alxgmpr/sierra-to-usb/full-adapter/cad/README.md

# Current capture checkpoint — not for fabrication

Open `full-adapter.kicad_pro`. The root hierarchy currently contains the DDR
signal and power pages, processor core power and ground, the CPU regulator,
the nine PMIC LDO outputs, all five PMIC bucks, both supply switches and unused audio,
processor PMU/PLL, IO and USB/combo-PHY supplies, and unused PHY terminations.
The integrated PCB and remaining functional pages
are still being implemented.

U1 is the exact RK3568B2; U2/U3 are H5TQ4G63EFR-RDC, each 4 Gb x16, giving
1 GiB on one 32-bit rank. Both processor DDR supply domains and both DRAM
supplies use 1.5 V. The initial 780 MHz clock target still requires DDR loader
configuration and physical training tests. The RD speed grade is 1866 MT/s,
not the 2133 MT/s sometimes attached to distributor listings.

`../tools/check_ddr.py` exports a fresh KiCad XML netlist and checks every DQ,
DQS, DM, shared command/address and clock connection against the reviewed
manufacturer maps. It separately checks fixed physical-ball anchors, reference
and calibration circuits, all DRAM supplies, all decoupling, and exact part
fields. All 732 processor/memory symbol pins are unique and match the reviewed
names and footprint coordinates.

The core power sheet connects 30 CPU/LOGIC/GPU/NPU supply balls, 21 bypass
capacitors, and all 208 VSS/AVSS ground balls. `../tools/check_core_power.py`
checks their fresh exported nets against fixed package anchors and the source
ground-pin list. Ball M15 is a passive remote sense tap on VDD_CPU_COM, not an
additional external power feed. TVSS at AB24 remains a temperature reference
input; the later processor-clock capture connects it to ground per the tablet reference.

U4 is RK860-0 with L300 SPM5030T-R35M. The CPU page includes four 22 uF input
capacitors, four 22 uF local output capacitors, a 51 kohm / 100 nF hardware
enable delay, a 100 kohm VSEL pull-down and the reference 100 ohm / 1 uF remote
sense network. `check_cpu_regulator.py` checks all 20 balls, native stack
expansion, switching-node isolation, feedback, defaults and exact passives.
The VDD_CPU power flag represents the verified U4 → L300 → CPU supply path;
KiCad does not propagate a power-output type through the passive inductor.

U5 is the exact RK809-5. Its three LDO groups have twelve local 1 uF bypass
capacitors and the startup voltages/sequencing from datasheet Table 4-4.
LDO6 now supplies the CPU regulator enable resistor. LDO5/6 are limited to
200 mA with less than 0.4 V headroom, as specified on datasheet pages 22–23.
`check_pmic_ldo.py` verifies all physical input/output pins and capacitor nets.

BUCK3 now supplies VCC_DDR through L420, with two local input and three local
output capacitors. Its 87.6k / 100k, 0.1% hardware divider selects 1.5008 V
before firmware runs. `check_pmic_ddr.py` verifies switching-node isolation,
the separate FB3 divider, VBUCK3 sense and resistor tolerance arithmetic.
The VCC_DDR flag represents this physical buck/inductor path.

BUCK1/2/4 now supply LOGIC/GPU/NPU. NT430–NT432 are copper net ties to be placed
at the processor supply pads, with dedicated feedback nets and local 100 ohm
resistors following the reference topology. They are excluded from the assembly
BOM. Each buck has two 22 uF input capacitors and three 22 uF plus 100 nF at
its output. The corresponding physical sense routing is still unfinished.

BUCK5 provides VCC1V8_SYS, separate from the 3.3 V inputs/output switches.
SWOUT1 provides VCC3V3_S0; SWOUT2 provides VCC3V3_SD. Their peripheral loads
and complete current/drop budgets remain outstanding. The control page now
terminates unused audio pins exactly as specified, retaining both internal
1.8 V bypass capacitors and a 3.3 V speaker-supply input bypass.

All 69 U5 pins are now present. The control unit has 1.8 V I2C pull-ups,
22 ohm series resistors, separate 3.3 V interrupt/reset pull-ups, mandatory
reset bypass, grounded unused fuel-gauge inputs, and a 32.768 kHz crystal.
The VDC divider/RC is a cold-start timing provision; reliable brownout recovery
still requires integration with the selected upstream supply's power-good/reset
behavior. The processor control page now connects reset, interrupt, sleep and
I2C0 to their physical U1 pins. It adds a 10k pull-up for the 1.8 V storage
voltage strap, the card-detect/JTAG pull-up, the reference zero-ohm TSHUT/reset
link, and a local 100 nF reset capacitor at U1. UART2 has 1.8 V RX/TX and ground
probe pads TP560–TP562, represented as board copper and excluded from assembly BOM;
its external level conversion and connector remain unfinished.

All processor power-input balls are now captured. The PMU/PLL sheet adds
twelve capacitors at seven supply balls; the IO/ADC/OTP page adds twelve at
eleven balls. PMUIO1 uses fixed 3.3 V; PMUIO2 uses 1.8 V with the existing PMIC
I2C pull-ups. VCCIO2 uses 1.8 V with a physical HIGH boot strap.
VCCIO3 uses the independently programmable SD-IO LDO, separate from SD card
3.3 V power. VCCIO1/4/5/6/7 use the switched 3.3 V system rail.

The PHY supply page adds fourteen capacitors and two Murata BLM18PG121SN1D
filters. The 0.9/1.8 V USB2 analog supplies are filtered; the shared USB3/PCIe2
combo-PHY supplies use their reference bypass network. The unused-domain page
grounds fourteen display/camera/PCIe3 supply balls and explicitly disconnects
63 signal balls. These supplies are additional intentional ground connections,
not additional VSS/AVSS pins. Their controller/PHY nodes must be disabled in DTS.

`processor-supply-budget.json` records the documented analog-domain peak sums
and 0.76425 W nominal LDO dissipation before IO loads and other PMIC losses.
This is a partial budget, not thermal closure or a basis for selecting PoE class.

The current ERC result has sixteen **unresolved integration findings**, with no
ERC exclusions: unplaced U1 units, input pins and bidirectional pins;
three undriven rails (GND, VCC5V_SYS and
VCC3V3_SYS), two modem USB2 endpoints and eight Ethernet MDI endpoints.
The upstream supplies, other processor units and MDI magnetics are not yet captured.
These are open work, not manufacturing exceptions.

The schematic PDF was rendered and visually iterated to fix rotated passive
fields, supply-reference overlap, power-label collisions and page-boundary
placement. The checked working render is `../build/processor-control-review.pdf`; it is
not a released schematic or fabrication deliverable.

## Library review

The Hynix map was checked against all 96 cells of manufacturer Rev. 1.2,
September 2016, page 6, with the overbars reviewed visually. Page 33 verifies
7.5 x 13 mm, 0.8 mm pitch and the top/bottom view orientation. The vendored
KiCad footprint's 0.36 mm lands are an engineering choice; the package drawing
does not specify a manufacturer land pattern. Source hashes are retained in
`../research/memory-pins.json`.

The official KiCad Library Tools checker at revision
`475bd27b9a521418c3732ff2ee5efea98525d2c7` reports these project-library exceptions:

- S4.5: 48 absent Hynix grid positions and 148 absent Rockchip grid positions.
  They are physically unpopulated, independently verified against manufacturer
  ball maps and footprint pads. They must not become symbol pins.
- S6.2: Manufacturer, MPN and LCSC are intentional assembly metadata on both ICs.
- The VCC_DDR and four core power symbols are renamed native KiCad 10.99 VDD symbols. The
  checker expects the older hidden/name-bearing power-pin convention and flags
  its native blank visible pin and reference convention (S4.1/S6.1/S7.1).
  KiCad's fresh exported netlist confirms the resulting global VCC_DDR net.

No actual component pin is hidden except the five NC balls on each Hynix
package. All populated balls remain explicit; alternate command functions use
KiCad alternates. Unused processor interfaces remain visible in separate units.

The former unplaced 41-pin supply unit was split into four readable units without
renumbering existing signal, core or ground units. The complete 636-ball source
map remains intact. The new ferrite footprint vendors the native 0603 body,
courtyard and STEP model, using Murata's 0.65 × 0.7 mm rectangular reflow lands
with 0.7 mm gap on 35 um outer copper. Remaining KLC F6.3/F9.3 notices are the
manufacturer's rectangular pads and the intentional project-relative model path.

## Reproduction

Run from the repository root with `full-adapter/.venv/bin/python`:

1. `full-adapter/research/extract_memory_pins.py`
2. `full-adapter/tools/build_core_symbols.py`
3. `full-adapter/tools/build_ddr_schematic.py`
4. `full-adapter/tools/check_ddr.py full-adapter full-adapter/research/ddr-validation.json`
5. `full-adapter/tools/check_core_power.py`
6. `full-adapter/tools/check_cpu_regulator.py`
7. `full-adapter/tools/check_pmic_library.py`
8. `full-adapter/tools/check_pmic_ldo.py`
9. `full-adapter/tools/check_pmic_ddr.py`
10. `full-adapter/tools/check_pmic_core.py`
11. `full-adapter/tools/check_pmic_aux.py`
12. `full-adapter/tools/check_pmic_control.py`
13. `full-adapter/tools/check_processor_pmu.py`
14. `full-adapter/tools/check_processor_io_power.py`
15. `full-adapter/tools/check_processor_phy_power.py`
16. `full-adapter/research/processor-supply-budget.py`
17. `full-adapter/tools/check_processor_control.py`

The pre-commit checks validate the staged snapshot and reject unregistered CAD.
Their DDR checkpoint success does not authorize fabrication or imply that the
full board is electrically complete or routed.

## Storage capture checkpoint

The hierarchy now has 17 child sheets plus the root. emmc-signals and
emmc-power capture all 153 U6 balls, the eight data bits, CMD/CLK/DS/reset,
12 bypass capacitors, ten 10 kΩ pull-ups and isolated service pads.
`full-adapter/.venv/bin/python full-adapter/tools/check_emmc.py` checks the
exported netlist and physical ball/pad mapping. Fresh ERC retains the six
previous integration findings; the full system remains incomplete.
The two pages and root were visually reviewed in build/emmc-review.pdf.
The root now uses an A2 four-column index, with room for additional functional
pages clear of the title block. Its SVG/PDF render was inspected in
`build/root-expansion.pdf`; existing child circuits are unchanged.

## Console capture

`console.kicad_sch` adds U7 TXU0202DCUR and J620 B4B-PH-SM4-TB(LF)(SN).
J620 is 1=GND, 2=board TX, 3=board RX, 4=adapter 3.3V input. Use a PHR-4
mating housing and a 3.3V TTL USB-UART adapter with TX/RX crossed. Pin4 supplies
only the translator's external domain; it does not supply the board. Ground
is shared, so this is power-off isolation, not galvanic isolation.

Four 10k pull-ups keep UART idle high on either side without crossing power
domains. Two 1k series resistors limit DC contention at the connector. Start
at 1.5Mbaud with a short cable and <=50pF total line loading; verify timing
with the actual adapter. `check_console.py` checks all eight translator pins,
both footprint pad maps, connector direction, pull-ups and rail separation.
Fresh ERC retains six integration findings. `build/console-review.pdf` page11
was visually reviewed after correcting field overlap and the lower box boundary.

U7 uses TI DCU0008A's .85x.3mm lands with3.1mm row spacing. The native JST
pattern matches the manufacturer's top-entry drawing. Its local STEP is a
solid nominal header envelope, not a detailed manufacturer model; reserve
mating cable clearance. KLC exceptions are intentional assembly fields and
project-relative STEP paths. Sources and point-in-time stock are recorded in
`research/console-qualification.json`. System PCB, protection review and
physical console validation remain unfinished.

Recovery USB capture is on `recovery-usb` and `recovery-detect`.
It includes a dedicated USB-C service port, power-off-specified data switch,
USB data ESD and a separate VBUS translator. Recovery electrical qualification
and the full PCB remain unfinished.

Physical RECOVERY, RESET and POWER buttons are captured on `buttons`;
manufacturer switch lands, nominal3D geometry and connectivity were reviewed.

## Ethernet controller capture

The current hierarchy has29pages including root. `ethernet-3v3-power` and
`ethernet-core-power` contain U12/U13 TPS6281320QWRWYRQ1 forced-PWM regulators.
`ethernet-local-power`, `ethernet-clock-config` and `ethernet-pcie` capture every
U11 RTL8125BG-CG pin and six U1 PCIe2 data/reference-clock balls. The original
IC symbols are unchanged; VCC3V3_ETH_PLL is an added power symbol.

Fifteen local capacitors bypass the named U11 pins. FB670 supplies only pin15;
pin43 is on 3.3V and pins40/49 are grounded. Y670 is X322525MOB4SI C9006 with
20pF C0G loads and an initial zero-ohm CKXTAL2 damping resistor. GPI, LED1,
LANWAKE and CLKREQ have explicit Ethernet-domain pull-ups. There is no external
EEPROM/flash; EEDI/EESEL select 3-wire 93C46 and EEDO is held low. Provision a
stable unique local MAC before network-UP; see the qualification file for
silicon-default and boot-image verification that remains necessary.

The PCIe lane has one 100nF capacitor per transmit leg, with physical endpoints
checked independently. PERST now has a TPS3808G33 release circuit and host
control isolation; fast-fault timing remains unfinished. Eight MDI labels are explicit open endpoints
for the qualified 2.5G/PoE magnetics; they are not ERC waivers.

`check_ethernet_controller.py` runs in both staged checkpoint hooks alongside
the library and regulator checks. It checks nets, exact new parts, crystal and
bead lands, and capacitor derating estimates. The reviewed 27-page working PDF
is `../build/ethernet-controller-review.pdf` (new pages8/15/27, root1). The crystal
and bead copper/model review uses `../build/ethernet-passives-*`; these small
inspection boards are not the integrated PCB. Footprint KLC exceptions are
the manufacturer's rectangular bead lands and intentional local/shared/scaled
generic models, documented in `../research/ethernet-controller-qualification.json`.

`ethernet-control` and `ethernet-reset` add U1VCCIO5/M1, U14FXMA2102 bidirectional
control isolation, U15TI open-drain host-reset buffering and U16TPS3808G33
startup qualification. Both regulator PG outputs share the host reset-condition
bus. R703100k selects180–420ms delay, R70410k pulls PERST up while R67947k remains
to ground. See `../research/ethernet-control-qualification.json` for actual bounds
and open fast-fault, clock/ASPM, partial-power and boot-image checks.

`check_ethernet_control.py` runs in the staged hooks. It checks19IC pins, three M1
balls, all control nets, independent supply membership and manufacturer lands.
The29-page `../build/ethernet-control-review.pdf` supersedes the previous review;
new pages22/29 and modified PG/control endpoint pages were visually inspected.
The small ignored footprint inspection board has no system circuitry or routing.
