alxgmpr/sierra-to-usb/hardware/review/2026-10-07/footprint-audit/schematic-to-pcb.txt

Info: Processing symbol 'C2021:Capacitor_SMD:C_0603_1608Metric_Pad1.08x0.95mm_HandSolder'.
Info: Processing symbol 'C202:Capacitor_SMD:C_0603_1608Metric_Pad1.08x0.95mm_HandSolder'.
Info: Processing symbol 'C203:Capacitor_SMD:C_1206_3216Metric_Pad1.33x1.80mm_HandSolder'.
Info: Processing symbol 'C204:Capacitor_SMD:C_0603_1608Metric_Pad1.08x0.95mm_HandSolder'.
Info: Processing symbol 'C205:Capacitor_SMD:C_0603_1608Metric_Pad1.08x0.95mm_HandSolder'.
Info: Processing symbol 'C401:Capacitor_SMD:C_1206_3216Metric_Pad1.33x1.80mm_HandSolder'.
Info: Processing symbol 'C402:Capacitor_SMD:C_1210_3225Metric_Pad1.33x2.70mm_HandSolder'.
Info: Processing symbol 'C403:Capacitor_SMD:C_1210_3225Metric_Pad1.33x2.70mm_HandSolder'.
Info: Processing symbol 'C501:Capacitor_SMD:C_1210_3225Metric_Pad1.33x2.70mm_HandSolder'.
Info: Processing symbol 'C502:Capacitor_SMD:C_1210_3225Metric_Pad1.33x2.70mm_HandSolder'.
Info: Processing symbol 'C503:Capacitor_SMD:C_1210_3225Metric_Pad1.33x2.70mm_HandSolder'.
Info: Processing symbol 'C504:Capacitor_SMD:C_1210_3225Metric_Pad1.33x2.70mm_HandSolder'.
Info: Processing symbol 'C505:Capacitor_SMD:C_1210_3225Metric_Pad1.33x2.70mm_HandSolder'.
Info: Processing symbol 'C506:Capacitor_SMD:C_1210_3225Metric_Pad1.33x2.70mm_HandSolder'.
Info: Processing symbol 'C507:Capacitor_SMD:C_1210_3225Metric_Pad1.33x2.70mm_HandSolder'.
Info: Processing symbol 'C508:Capacitor_SMD:C_1210_3225Metric_Pad1.33x2.70mm_HandSolder'.
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
Info: Processing symbol 'D1716:LED_SMD:LED_0603_1608Metric_Pad1.05x0.95mm_HandSolder'.
Info: Processing symbol 'D1717:Diode_SMD:D_SOD-123'.
Info: Processing symbol 'D1718:Appliance:Diodes_PowerDI-5_3Pin_Derived'.
Info: Processing symbol 'D1719:Diode_SMD:D_SOD-123'.
Info: Processing symbol 'D1721:Package_TO_SOT_SMD:SOT-23_Handsoldering'.
Info: Processing symbol 'D1851:Package_SON:USON-10_2.5x1.0mm_P0.5mm'.
Info: Processing symbol 'D1852:Package_SON:USON-10_2.5x1.0mm_P0.5mm'.
Info: Processing symbol 'D2001:Package_SON:USON-10_2.5x1.0mm_P0.5mm'.
Info: Processing symbol 'FB801:Inductor_SMD:L_0603_1608Metric_Pad1.05x0.95mm_HandSolder'.
Info: Processing symbol 'FB802:Inductor_SMD:L_0603_1608Metric_Pad1.05x0.95mm_HandSolder'.
Info: Processing symbol 'FB1301:Inductor_SMD:L_0603_1608Metric_Pad1.05x0.95mm_HandSolder'.
Info: Processing symbol 'FB1302:Inductor_SMD:L_0603_1608Metric_Pad1.05x0.95mm_HandSolder'.
Info: Processing symbol 'FB1303:Inductor_SMD:L_0805_2012Metric_Pad1.05x1.20mm_HandSolder'.
Info: Processing symbol 'FB1304:Inductor_SMD:L_0805_2012Metric_Pad1.05x1.20mm_HandSolder'.
Info: Processing symbol 'FB1401:Inductor_SMD:L_0603_1608Metric_Pad1.05x0.95mm_HandSolder'.
Info: Processing symbol 'FB1402:Inductor_SMD:L_0603_1608Metric_Pad1.05x0.95mm_HandSolder'.
Info: Processing symbol 'FB1403:Inductor_SMD:L_0603_1608Metric_Pad1.05x0.95mm_HandSolder'.
Info: Processing symbol 'FB1404:Inductor_SMD:L_0603_1608Metric_Pad1.05x0.95mm_HandSolder'.
Info: Processing symbol 'J101:Recovery:Wuerth_61300211121_1x02_P2.54mm_Vertical'.
Info: Processing symbol 'J102:Recovery:Wuerth_61301011121_1x10_P2.54mm_Vertical'.
Info: Processing symbol 'J201:Recovery:Wuerth_61300611121_1x06_P2.54mm_Vertical'.
Info: Processing symbol 'J202:Recovery:Wuerth_61300211121_1x02_P2.54mm_Vertical'.
Info: Processing symbol 'J1201:Connector_USB:USB_Micro-B_Amphenol_10103594-0001LF_Horizontal'.
Info: Processing symbol 'J1202:Connector_PinHeader_2.54mm:PinHeader_1x03_P2.54mm_Vertical'.
Info: Processing symbol 'J1701:Appliance:Sierra_RJE491881401_1x08-1MP_P1.02mm'.
Info: Processing symbol 'J1711:PoE:TI_TERM_BLK_ED555-2DS'.
Info: Processing symbol 'J1712:PoE:TI_Molex_87898-0204'.
Info: Processing symbol 'J2001:Appliance:Sierra_MDT420B01411_2x38-1MP_P0.5mm'.
Info: Processing symbol 'J2002:Appliance:SIM-SMD_1042240820'.
Info: Processing symbol 'L401:Inductor_SMD:L_Coilcraft_LPS4018'.
Info: Processing symbol 'L501:Inductor_SMD:L_Coilcraft_XxL4020'.
Info: Processing symbol 'L502:Inductor_SMD:L_Coilcraft_XxL4020'.
Info: Processing symbol 'L504:Inductor_SMD:L_Coilcraft_XxL4020'.
Info: Processing symbol 'L505:Inductor_SMD:L_Coilcraft_XxL4020'.
Info: Processing symbol 'L601:Inductor_SMD:L_Coilcraft_XxL4030'.
Info: Processing symbol 'L701:Inductor_SMD:L_Coilcraft_XAL7070-XXX'.
Info: Processing symbol 'L901:Inductor_SMD:L_Coilcraft_XxL4020'.
Info: Processing symbol 'L902:Inductor_SMD:L_Coilcraft_XxL4020'.
Info: Processing symbol 'L1001:Inductor_SMD:L_Coilcraft_XxL4020'.
Info: Processing symbol 'L1501:Inductor_SMD:L_Coilcraft_XxL4020'.
Info: Processing symbol 'L1701:Inductor_SMD:L_0603_1608Metric_Pad1.05x0.95mm_HandSolder'.
Info: Processing symbol 'L1702:PoE:TI_WE-SL5'.
Info: Processing symbol 'L1703:Inductor_SMD:L_0603_1608Metric_Pad1.05x0.95mm_HandSolder'.
Info: Processing symbol 'L1707:Inductor_SMD:L_Coilcraft_XxL4020'.
Info: Processing symbol 'L1708:Inductor_SMD:L_Coilcraft_XAL5030-XXX'.
Info: Processing symbol 'L1901:Inductor_SMD:L_Coilcraft_XAL7070-XXX'.
Info: Processing symbol 'Q301:Package_TO_SOT_SMD:SOT-23_Handsoldering'.
Info: Processing symbol 'Q302:Package_TO_SOT_SMD:SOT-23_Handsoldering'.
Info: Processing symbol 'Q303:Package_TO_SOT_SMD:SOT-23_Handsoldering'.
Info: Processing symbol 'Q501:Package_TO_SOT_SMD:SOT-23_Handsoldering'.
Info: Processing symbol 'Q801:Package_TO_SOT_SMD:SOT-23_Handsoldering'.
Info: Processing symbol 'Q802:Package_TO_SOT_SMD:SOT-23_Handsoldering'.
Info: Processing symbol 'Q1201:Package_TO_SOT_SMD:SOT-23_Handsoldering'.
Info: Processing symbol 'Q1601:Package_TO_SOT_SMD:SOT-23_Handsoldering'.
Info: Processing symbol 'Q1701:Package_TO_SOT_SMD:SuperSOT-3'.
Info: Processing symbol 'Q1702:Package_TO_SOT_SMD:SuperSOT-3'.
Info: Processing symbol 'Q1703:Package_TO_SOT_SMD:SuperSOT-3'.
Info: Processing symbol 'Q1704:Package_TO_SOT_SMD:SuperSOT-3'.
Info: Processing symbol 'Q1705:PoE:TI_TRANS_Fairchild_PQFN08A'.
Info: Processing symbol 'Q1707:Package_TO_SOT_SMD:SOT-23_Handsoldering'.
Info: Processing symbol 'Q1901:Package_TO_SOT_SMD:SOT-23_Handsoldering'.
Info: Processing symbol 'Q2001:Package_TO_SOT_SMD:SOT-23_Handsoldering'.
Info: Processing symbol 'R201:Resistor_SMD:R_0603_1608Metric_Pad0.98x0.95mm_HandSolder'.
Info: Processing symbol 'R202:Resistor_SMD:R_0603_1608Metric_Pad0.98x0.95mm_HandSolder'.
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
Info: Processing symbol 'R2024:Resistor_SMD:R_0603_1608Metric_Pad0.98x0.95mm_HandSolder'.
Info: Processing symbol 'SW201:Button_Switch_SMD:SW_SPST_TL3342'.
Info: Processing symbol 'SW801:Button_Switch_SMD:SW_SPST_TL3342'.
Info: Processing symbol 'SW802:Button_Switch_SMD:SW_SPST_TL3342'.
Info: Processing symbol 'T1701:Appliance:Sierra_HX4110NL_2x12_P1.27mm'.
Info: Processing symbol 'T1702:PoE:TI_Wurth_EFD25_4476'.
Info: Processing symbol 'TP1101:TestPoint:TestPoint_Pad_D1.0mm'.
Info: Processing symbol 'TP1102:TestPoint:TestPoint_Pad_D1.0mm'.
Info: Processing symbol 'TP1103:TestPoint:TestPoint_Pad_D1.0mm'.
Info: Processing symbol 'TP1719:PoE:TI_Keystone_5019'.
Info: Processing symbol 'TP1720:PoE:TI_Keystone_5019'.
Info: Processing symbol 'TP1721:PoE:TI_Keystone_5019'.
Info: Processing symbol 'TP1722:PoE:TI_Keystone_5019'.
Info: Processing symbol 'TP1723:PoE:TI_Keystone_5019'.
Info: Processing symbol 'TP1724:PoE:TI_Keystone_5019'.
Info: Processing symbol 'TP1725:PoE:TI_Keystone_5019'.
Info: Processing symbol 'TP1726:PoE:TI_Keystone_5019'.
Info: Processing symbol 'TP1727:PoE:TI_Keystone_5019'.
Info: Processing symbol 'U201:Package_QFP:LQFP-48_7x7mm_P0.5mm'.
Info: Processing symbol 'U202:Package_TO_SOT_SMD:SOT-23-5_HandSoldering'.
Info: Processing symbol 'U401:Package_SON:WSON-10-1EP_2x3mm_P0.5mm_EP0.84x2.4mm_ThermalVias'.
Info: Processing symbol 'U501:Package_DFN_QFN:ArtInChip_QFN-68-1EP_7x7mm_P0.35mm_EP5.49x5.49mm_ThermalVias'.
Info: Processing symbol 'U601:Package_TO_SOT_SMD:TSOT-23-8_HandSoldering'.
Info: Processing symbol 'U602:Package_TO_SOT_SMD:SOT-23-5_HandSoldering'.
Info: Processing symbol 'U701:Appliance:Texas_RPA0010A_TPS56837'.
Info: Processing symbol 'U801:Appliance:Sierra_RK3566_BGA565'.
Info: Processing symbol 'U901:Appliance:Sierra_Micron_ZW_TFBGA200'.
Info: Processing symbol 'U902:Package_TO_SOT_SMD:SOT-23-5_HandSoldering'.
Info: Processing symbol 'U1001:Appliance:WLCSP-20_L2.0-W1.6-R5-C4-P0.40-TL'.
Info: Processing symbol 'U1101:Package_BGA:LFBGA-153_11.5x13mm_Layout14x14_P0.5mm'.
Info: Processing symbol 'U1201:Package_TO_SOT_SMD:SOT-353_SC-70-5'.
Info: Processing symbol 'U1202:Package_TO_SOT_SMD:SOT-353_SC-70-5'.
Info: Processing symbol 'U1203:Package_TO_SOT_SMD:SOT-353_SC-70-5'.
Info: Processing symbol 'U1301:Appliance:TQFN-48_L6.0-W6.0-P0.40-BL-EP4.5'.
Info: Processing symbol 'U1302:Package_SO:SOIC-8_3.9x4.9mm_P1.27mm'.
Info: Processing symbol 'U1501:Package_TO_SOT_SMD:SOT-353_SC-70-5'.
Info: Processing symbol 'U1502:Package_SON:Texas_DSG0008A_WSON-8-1EP_2x2mm_P0.5mm_EP0.9x1.6mm'.
Info: Processing symbol 'U1503:Package_TO_SOT_SMD:SOT-23-5_HandSoldering'.
Info: Processing symbol 'U1504:Package_TO_SOT_SMD:SOT-23-6_Handsoldering'.
Info: Processing symbol 'U1505:Package_TO_SOT_SMD:SOT-23-6_Handsoldering'.
Info: Processing symbol 'U1601:Package_TO_SOT_SMD:SOT-353_SC-70-5'.
Info: Processing symbol 'U1602:Package_TO_SOT_SMD:SOT-353_SC-70-5'.
Info: Processing symbol 'U1603:Package_TO_SOT_SMD:SOT-353_SC-70-5'.
Info: Processing symbol 'U1604:Package_DFN_QFN:DHVQFN-20-1EP_2.5x4.5mm_P0.5mm_EP1x3mm'.
Info: Processing symbol 'U1701:Package_DFN_QFN:Texas_RGW0020A_VQFN-20-1EP_5x5mm_P0.65mm_EP3.15x3.15mm'.
Info: Processing symbol 'U1702:Package_SON:WSON-12-1EP_3x2mm_P0.5mm_EP1x2.65'.
Info: Processing symbol 'U1703:PoE:TI_N04C'.
Info: Processing symbol 'U1704:Package_TO_SOT_SMD:SOT-23_Handsoldering'.
Info: Processing symbol 'U1801:Appliance:SOP-4_L4.4-W2.8-P1.27-LS7.0-BR'.
Info: Processing symbol 'U1802:Appliance:SOP-4_L4.4-W2.8-P1.27-LS7.0-BR'.
Info: Processing symbol 'U1803:Appliance:SOP-4_L4.4-W2.8-P1.27-LS7.0-BR'.
Info: Processing symbol 'U1901:Appliance:VQFN-14_L3.5-W3.5-P0.50-TL-EP_TPS54622RHLT'.
Info: Processing symbol 'U1902:Appliance:VQFN-10_L2.0-W2.0-P0.45-TL'.
Info: Processing symbol 'U1903:Package_TO_SOT_SMD:SOT-23-6_Handsoldering'.
Info: Processing symbol 'U1904:Package_TO_SOT_SMD:SOT-353_SC-70-5'.
Info: Processing symbol 'U2001:Package_DFN_QFN:DHVQFN-20-1EP_2.5x4.5mm_P0.5mm_EP1x3mm'.
Info: Processing symbol 'U2002:Appliance:UQFN-10_L2.0-W1.5-P0.50-BL'.
Info: Processing symbol 'U2003:Package_TO_SOT_SMD:SOT-353_SC-70-5'.
Info: Processing symbol 'Y1101:Oscillator:Oscillator_SMD_SiT_PQFN-4Pin_3.2x2.5mm'.
Info: Processing symbol 'Y1301:Crystal:Crystal_SMD_TXC_7M-4Pin_3.2x2.5mm_HandSoldering'.

Info: Total warnings: 0, errors: 0.
