alxgmpr/sierra-to-usb/docs/erc-waivers.md

> Historical evidence from superseded designs. See the [current full adapter](../full-adapter/README.md). Circuit status and artifact paths below refer to the historical checkpoint, not the replacement.

# ERC Waivers

Tracks intentionally-accepted ERC warnings (with justification), sheet by sheet,
as the hierarchy is populated. Task 3 baseline was 0 errors / 0 warnings on an
empty scaffold. Task 4 (power_input, after the EVM-093 transcription fix pass)
is the first sheet with real content; `$KCLI sch erc sierra-to-usb.kicad_sch`
now reports **0 errors / 259 warnings**, all four categories below, all on this
sheet.

Task 5 (power_rails: buck + LDOs + INA226 telemetry + ADC dividers) adds 87
more warnings, all in the same three pre-existing categories (no new
category) — `$KCLI sch erc sierra-to-usb.kicad_sch` now reports
**0 errors / 346 warnings**. Two ERC *errors* surfaced during development and
were fixed by design changes (not waived): `pin_to_pin` "Power output and
Power output are connected" (a redundant `PWR_FLAG` was placed on `+1V8` and
`+3V3_MCU`, both of which already have a legitimate driver — U5/U17's `VOUT`
pins are `power_out` type on the stock AP2112K base symbol; removed the
redundant flags) and `power_pin_not_driven` on `U17.VIN` (the diode-OR node
`N_OR17` had no driver at all — added a `PWR_FLAG` there, the same fix
pattern as the pre-existing `+12V_BUCK`/`+3V3`/`+3V3_MOD` flags). A third,
`pin_not_driven` on `U13.SCL` (I2C bus not yet mastered by anything, since
the mcu sheet is a future task), was resolved the same way: a `PWR_FLAG` on
`I2C_SCL` satisfies ERC's "Input pin not driven by any Output pins" check
(a `PWR_FLAG` pin is `power_out` type, which the check accepts as a driver
for a plain signal net, not only for power nets) without fabricating a
phantom I2C master.

| Date | Warning | Justification |
| ---- | --- | --- |
| 2026-07-14 | `isolated_pin_label` ×5 — global labels `POE_VA+`, `POE_VA-`, `POE_VB+`, `POE_VB-` (BR1/BR2 AC inputs) and `+3V3` (R4 pull-up) each connect to only one pin | The four PoE center-tap labels are this sheet's *export* of the PoE pairs — the matching consumer (J4 magjack on `sheets/ethernet.kicad_sch`) is wired in Task 10; until then a single-pin global label is correct. `+3V3` is referenced here only as CH224K PG's pull-up rail; it is *deliberately* a plain global label (not a power symbol, no PWR_FLAG) because the rail is produced on the power_rails sheet (later task) and the Task-4 review (MINOR 9) forbids this sheet asserting it driven. Both warnings clear when the producing/consuming sheets land. |
| 2026-07-14 | `footprint_link_issues` ×95 — every placed symbol's `Footprint` field points at a library not yet present in `fp-lib-table` | Footprint/library binding is explicitly a Task 14 activity per the plan. The `Footprint` string on each symbol records the *intended* package (per EVM-093 BOM / datasheets) so Task 14 has the real target; only the fp-lib-table registration is deferred. Count rose from 50 to 95 with the EVM-093 fix pass (sync-rect stage, snubbers, full compensation network, input filter added). |
| 2026-07-14 | `lib_symbol_mismatch` ×1 — `TCMT1107` cached copy in this sheet's `lib_symbols` differs from the stock `Isolator` library on disk | The stock symbol uses KiCad's `extends` inheritance (`TCMT1107`→`TCMT1100`); the generator flattens it into a standalone cache entry so the schematic is self-contained. Electrically identical (same pin numbers/positions/types), differs only structurally — cosmetic. (The Task-4 `SMAJ13A`/`SMAJ58A` flattening waivers are gone: the fix pass replaced them with project-library unidirectional TVS symbols with explicit pin-1-cathode polarity, per review MINOR 8.) |
| 2026-07-14 | `endpoint_off_grid` ×158 — pin/label/power-symbol endpoints not on KiCad's default edit grid | This sheet is script-authored: every label/power-symbol anchor sits at the *exact* absolute coordinate of the pin it connects to, rather than snapped to the editor's visual grid. Electrically correct (verified via `check_nets.py` and a full generator-intent-vs-exported-netlist diff of all 317 pin assignments) but cosmetically off-grid; a GUI re-snap pass would silence this without changing connectivity and is not required for the ERC error gate. |
| 2026-07-14 | (Task 5, power_rails) `endpoint_off_grid` ×59 | Same cause as the power_input row above — this sheet uses the identical script-authored, label-at-exact-pin-coordinate generator idiom (see task-5-report.md). |
| 2026-07-14 | (Task 5, power_rails) `footprint_link_issues` ×26 — every placed symbol's `Footprint` field points at a library not yet present in `fp-lib-table` | Same as the power_input row above: footprint/library binding is Task 14. `Footprint` strings record the intended package per `docs/sourcing.md` (MSOP-10 for INA226AIDGSR, TSOT-23-6 for TPS565201DDCR, SOT-23-5 for both AP2112K LDOs) so Task 14 has the real target. |
| 2026-07-14 | (Task 5, power_rails) `lib_symbol_mismatch` ×2 — `AP2112K-1.8` and `AP2112K-3.3` cached copies differ from the stock `Regulator_Linear` library on disk | Same cause and same resolution as the Task-4 `TCMT1107` row above: both stock symbols use KiCad's `extends` inheritance (`AP2112K-1.8`/`AP2112K-3.3` → `AP2204K-1.5`); the generator flattens each into a standalone cache entry (own Reference/Value/Footprint/Datasheet/Description properties, but the base symbol's graphics and pins) so the schematic is self-contained. Electrically identical (same pin numbers/positions/types — VIN(1)/GND(2)/EN(3)/NC(4)/VOUT(5)), differs only structurally — cosmetic. |

Task 6 (m2: M.2 socket, vendor-safe VCC policy, strap plane) adds 118 more
warnings, all in the same four pre-existing categories (no new category) —
`$KCLI sch erc sierra-to-usb.kicad_sch` now reports **0 errors / 464
warnings**. Breakdown: `endpoint_off_grid` 217→299 (+82), `footprint_link_issues`
121→139 (+18), `isolated_pin_label` 5→23 (+18), `lib_symbol_mismatch` 3→3
(+0 — the flattened `2N7002` did not trigger a new mismatch, unlike Task 5's
`AP2112K` flattening, because kicad-cli's own `extends`-resolution of the
stock `2N7002` happens to produce the identical structure my flattener does).

Seven ERC *errors* surfaced during development and were fixed by design
changes (not waived): `pin_not_driven` on 7 CN1 pins whose stock-symbol pin
*type* is literally "input" (`PCIE_MTX_N/P`, `SS_MOD_RX_N/P`,
`UIM1_RST/CLK/VDD`) with no other schematic component providing an
Output-type pin on those nets — the real driver for all of these is the
pluggable module itself (invisible to ERC's connectivity model, since a
connector symbol has no "the module drives this" pin). Fixed the same way as
Task 5's `I2C_SCL` forward-reference: a `PWR_FLAG` colocated with a matching
`global_label`. **Root cause of an intermediate false "still broken" state,
recorded for future reference:** the fix did not work the first time it was
applied — ERC kept reporting both `pin_not_driven` *and* a new
`label_dangling` on the same 7 nets — because the generator embedded
`power:GND` in this sheet's own `lib_symbols` cache but forgot to do the same
for `power:PWR_FLAG`, silently falling back to the *system* library table's
copy for pin geometry. That fallback copy apparently isn't recognized as
"touching" a coincident label by kicad-cli's ERC the way an embedded-cache
copy is (empirically confirmed: adding the missing cache entry, with no other
change, took both error types to zero). Every symbol used on a sheet needs
its own `lib_symbols` cache entry, not just the ones whose *pins* the
generator programmatically decorates — this project's established idiom
(Tasks 4/5) already did this correctly for `power:GND`; Task 6 initially
missed it for `power:PWR_FLAG` specifically.

| Date | Warning | Justification |
| ---- | --- | --- |
| 2026-07-14 | (Task 6, m2) `isolated_pin_label` ×11 — global labels `PCIE_MRX_P/N`, `UIM1_DET`, `UIM1_IO`, `PCIE_REFCLK_P/N`, `UIM2_DET/IO/CLK/RST/VDD` each connect to only one pin on this sheet | **Row edited by Task 8 per its own housekeeping instruction** (was ×15 as edited by Task 7, listed `USB2_MOD_DP/DM` too — both now removed from this row, count reduced 15→13, since Task 8's `sheets/usb2_debug.kicad_sch` supplies the second touch point: `U8`'s common `D+`/`D-` pins (bidirectional, TS3USB221 pins 8/7) land on `USB2_MOD_DP`/`USB2_MOD_DM`, the same nets `CN1.7`/`CN1.9` already produce here). `WWAN_LED_N`/`LED_RET` were also still listed in this row's text despite being resolved by the Task 6 review fix pass (that section documented the resolution but, per the "no existing text silently rewritten" convention, left this row's enumeration stale at the time) — dropped now too, count 15→13→11 net of both corrections. Remaining 11 are still-open documented forward references: the matching consumer/producer lands on a future sheet (mcu/Task 9, ethernet/Task 10, sim/Task 11) per the plan's own sheet-dependency order. Clears once each producing/consuming sheet lands, same pattern as Task 4/5/7's forward-reference waivers. |
| 2026-07-14 | (Task 6, m2) `footprint_link_issues` ×18 — `CN1` (`Connector_M.2`), `JP1-3` (`Jumper`), `TP1-9` (`TestPoint`), `D19` (`LED_SMD`), bulk caps (`CP_Elec_6.3x7.7`) point at libraries not yet in `fp-lib-table` | Same as the Task 4/5 rows above: footprint/library binding is Task 14. `Footprint` strings record the intended package (`Connector_M.2:M.2_Key-B-SMD` for CN1 per the LOTES APCI0105-P001A datasheet, `docs/sourcing.md` row 20) so Task 14 has the real target. |
| 2026-07-14 | (Task 6, m2) `endpoint_off_grid` ×82 | Same cause as the Task 4/5 rows above — this sheet uses the identical script-authored, label-at-exact-pin-coordinate generator idiom. |

## Task 6 review Fix pass (2026-07-14)

Fixing the 5 findings from the Task 6 (m2) review (VBUS_SENSE P-FET force-path
rebuild, R59/R60 1% tolerance, WWAN LED rewired through the module's status
pin, C44-C57 footprint prefixes, task-6-report.md refdes table correction)
changes `$KCLI sch erc sierra-to-usb.kicad_sch` from **0 errors / 464
warnings** to **0 errors / 452 warnings** (`endpoint_off_grid` 299→302,
`footprint_link_issues` 139→125, `isolated_pin_label` 23→22,
`lib_symbol_mismatch` 3→3 — no new category). Net delta: 16 warnings resolved,
4 new, both fully accounted for below.

**Resolved (16):**
- `footprint_link_issues` ×14 — C44-C57's `Footprint` fields were bare
  names with no library prefix (`CP_Elec_6.3x7.7`, `C_0805_2012Metric`,
  `C_0402_1005Metric` — not even a valid `Library:Footprint` lib_id, unlike
  the rest of this sheet's parts). Fix 4 added the `Capacitor_SMD:` prefix
  to all 14, verified against the real `.kicad_mod` files in KiCad 10's
  stock `Capacitor_SMD.pretty`. `Capacitor_SMD` is a standard footprint
  library already present in this machine's global `fp-lib-table` (unlike
  `Connector_M.2`/`Jumper`/`TestPoint`/`LED_SMD`, which is why CN1/JP1-3/
  TP1-9/D19 still show `footprint_link_issues` below — same as the
  pre-existing Task 6 row, that part is genuinely Task 14 work), so this
  resolves cleanly rather than needing a waiver.
- `isolated_pin_label` ×2 — `WWAN_LED_N` and `LED_RET`. Fix 3 gives
  `WWAN_LED_N` a second same-sheet touch point (D19's cathode, alongside
  the pre-existing CN1.10), so it's no longer isolated on this sheet.
  `LED_RET` is deleted outright (D19's cathode no longer references it) —
  removed, not a forward reference anymore, so the old Task 6 waiver row's
  mention of `LED_RET` is superseded by this section for that one label
  (the row itself is left unedited per the "no existing assertion/waiver
  text is silently rewritten" convention — this section is the correction).

**New (4) — same categories/root causes as the existing Task 6 waiver rows
above, not a new waiver category:**
- `endpoint_off_grid` ×3 — `#PWR91` (new GND on Q5's source), `Q32` pin 1
  (gate), `R68` pin 1. Same cause as the existing Task 6 `endpoint_off_grid`
  row: this sheet places labels/power symbols at the exact absolute pin
  coordinate of the component they connect to rather than snapping to the
  editor grid. Verified electrically correct via `uv run
  tools/check_nets.py` (all Fix 1 pin-function assertions pass) and the
  `kicad-cli sch export netlist` pin-to-net dump.
- `isolated_pin_label` ×1 — global label `LED_PWR` (R67's new supply-side
  pin) connects to only one pin on this sheet. This is a deliberate,
  documented forward reference: Task 9 (mcu) drives `LED_PWR` from `+3V3`
  through the WWAN kill switch, per Fix 3. Same pattern as the pre-existing
  Task 6 forward-reference waivers (`WWAN_LED_N` originally, `VBUS_DATA`,
  etc.) — clears once Task 9 lands.

No new `footprint_link_issues` or `lib_symbol_mismatch` from the new parts:
`Q32` (`sierra-to-usb:DMG3415U`, footprint `Package_TO_SOT_SMD:SOT-23`) and
`R68` (`Device:R_Small`, footprint `Resistor_SMD:R_0603_1608Metric`) both
reuse footprint libraries already used elsewhere on this sheet (Q1-Q5,
R59-R67) that resolve via the global `fp-lib-table` without a project-local
entry. The new `sierra-to-usb:DMG3415U` project-library symbol's cached copy
in `sheets/m2.kicad_sch`'s `lib_symbols` was built to be structurally
identical to the `lib/sierra-to-usb.kicad_sym` master (same property
node shapes, no stray `pin_names` override) specifically to avoid adding a
5th `lib_symbol_mismatch` entry — confirmed 3→3, unchanged.

| Date | Warning | Justification |
| ---- | --- | --- |
| 2026-07-14 | (Fix pass) `endpoint_off_grid` ×3 — `#PWR91` Pin 1, `Q32` Pin 1 `[G]`, `R68` Pin 1 | Same script-authored, label/symbol-at-exact-pin-coordinate idiom as every other `endpoint_off_grid` row on this sheet. Connectivity verified via `check_nets.py` and a `kicad-cli sch export netlist` pin dump, not just ERC. |
| 2026-07-14 | (Fix pass) `isolated_pin_label` ×1 — global label `LED_PWR` (R67 pin 2) connects to only one pin on this sheet | Documented forward reference: Task 9 (mcu) drives `LED_PWR` from `+3V3` through the WWAN kill switch (Fix 3). Same pattern as this sheet's other Task 6 forward-reference waivers; clears when Task 9 lands. |

## Task 7 (usb3_data: J1 + HD3SS3220 mux + AC caps + ESD)

`$KCLI sch erc sierra-to-usb.kicad_sch` goes from Task-6-fix-pass's **0
errors / 452 warnings** to **0 errors / 490 warnings** (+38). Breakdown:
`endpoint_off_grid` 302→337 (+35), `footprint_link_issues` 125→127 (+2),
`isolated_pin_label` 22→19 (−3, see the edited Task 6 row above),
`lib_symbol_mismatch` 3→5 (+2), and one **new category**: `pin_to_pin` (+2).
Two ERC *errors* surfaced during development and were fixed by design (not
waived) — see below.

**Errors found and fixed (not waived):**
1. `label_dangling` ×2 on `U1` (HD3SS3220 mux) pins `VDD5`/`EN` (net
   `VBUS_DATA`) and `VOUT` (net `+3V3_MUX`) — root cause: the sheet's
   `lib_symbols` cache embedded `Regulator_Linear:AP2112K-3.3` via a plain
   rename of the stock symbol text, but the stock `AP2112K-3.3` symbol is
   itself `(extends "AP2204K-1.5")` — renaming without flattening left an
   empty shell with no pins in the cache, so kicad-cli silently fell back to
   resolving the base symbol elsewhere, and that fallback pin geometry
   didn't register as "touching" the coincident global label/local label —
   the **exact same failure mode** already root-caused in the Task 6 section
   above for `power:PWR_FLAG` (there: a missing cache entry causing a
   system-library fallback; here: an unflattened `extends` cache entry
   causing the same kind of fallback). Fixed by flattening `AP2112K-3.3`
   the same way Task 5 already documented doing for `AP2112K-1.8`/`-3.3` on
   `power_rails.kicad_sch` (merge the `AP2204K-1.5` base's graphics/pin
   sub-units, renamed, with `AP2112K-3.3`'s own top-level properties) —
   confirmed by re-running ERC (both errors cleared, no other change).
2. `power_pin_not_driven` ×1 on `U1.VDD5` (`power_in` type, net
   `VBUS_DATA`) — `J1`'s VBUS pins are typed `passive` (matching the stock
   `USB_C_Receptacle_USB2.0_16P` convention used by `J2`), which doesn't
   satisfy ERC's driver requirement for a `power_in` pin the way it does for
   a plain `input` pin. Fixed the same way as this project's pre-existing
   `+12V_BUCK`/`+3V3`/`+3V3_MOD`/`I2C_SCL` forward-reference `PWR_FLAG`s
   (Tasks 4/5/6): added a `power:PWR_FLAG` colocated with `D24`'s cathode
   pin (already on `VBUS_DATA`), asserting "this net is genuinely driven
   from off-board (through J1), trust me" — confirmed by re-running ERC.

| Date | Warning | Justification |
| ---- | --- | --- |
| 2026-07-14 | (Task 7) `footprint_link_issues` ×2 — `D24` (`sierra-to-usb:SMAJ5.0A`, `Diode_SMB:D_SMB`) and `U1` (`sierra-to-usb:HD3SS3220`, `Package_DFN_QFN:HD3SS3220_RNH0030A`) | `D24` matches the pre-existing `SMAJ13A`/`SMAJ58A` pattern exactly (`Diode_SMB` isn't a registered library on this machine — same as `D6`/`D7`). `U1`'s WQFN-30 (RNH) package has no matching stock footprint file; `Package_DFN_QFN` itself is registered but `HD3SS3220_RNH0030A` doesn't exist in it. Both record the intended package per `docs/sourcing.md` (LCSC C165155, WQFN-30-EP 2.5×4.5) for Task 14 to bind. Everything else new on this sheet (J1 → `Connector_USB:USB_C_Receptacle_HRO_TYPE-C-31-M-17`, D20-D23 → `Package_SON:USON-10_2.5x1.0mm_P0.5mm`, U4 → `Package_TO_SOT_SMD:SOT-23-5`, new R/C → `Resistor_SMD:R_0603_1608Metric`/`Capacitor_SMD:C_0603_1608Metric`) resolved cleanly against libraries already registered on this machine — no waiver needed for those. |
| 2026-07-14 | (Task 7) `lib_symbol_mismatch` ×2 — `TPD4E05U06DQA` (`D23`) and a second `AP2112K-3.3` instance (`U4`) cached copies differ from the stock `Power_Protection`/`Regulator_Linear` libraries on disk | Same cause and resolution as every other row in this category: both stock symbols use `extends` (`TPD4E05U06DQA`→`TPD4EUSB30`, `AP2112K-3.3`→`AP2204K-1.5`); the generator flattens each into a standalone cache entry (own properties, base symbol's graphics/pins) so the schematic is self-contained. Electrically identical, differs only structurally — cosmetic. |
| 2026-07-14 | (Task 7) `endpoint_off_grid` ×35 | Same script-authored, label/symbol-at-exact-pin-coordinate idiom as every other row in this category. Connectivity verified via `uv run tools/check_nets.py` (all pass) and a `kicad-cli sch export netlist --format kicadxml` pin-to-net dump (SS-pair mapping table in `task-7-report.md`), not just ERC. |
| 2026-07-14 | (Task 7) `pin_to_pin` ×2 (**new category**) — "Pins of type Bidirectional and Power output are connected": `U1` pins `RXP`/`RXN` (net `SS_MOD_RX_P`/`SS_MOD_RX_N`) tied to `#FLG19`, a `power:PWR_FLAG` on `sheets/m2.kicad_sch` | This `PWR_FLAG` was added in Task 6 specifically because `CN1.29`/`CN1.31` are `input`-typed pins with no visible driver *on the m2 sheet alone* (the module itself is invisible to ERC's connectivity model). Task 7 now supplies a real `bidirectional`-type driver on the same global net (`U1.RXP`/`RXN`, `D22`'s flow-through ESD pins) — the flag is now redundant (same situation Task 5 resolved by *removing* the equivalent redundant `+1V8`/`+3V3_MCU` flags), but removing it means editing `sheets/m2.kicad_sch`, which is outside this task's declared file scope (`sheets/usb3_data.kicad_sch` + `tools/netchecks.txt` only, per the brief). Flagged as a carry-forward cleanup for whichever task next touches `m2.kicad_sch`, not fixed here. Not an error — informational pin-type-mix warning only. |

## Task 8 (usb2_debug: TS3USB221 USB2 mux + J3 debug port)

`$KCLI sch erc sierra-to-usb.kicad_sch` goes from Task-7's **0 errors / 490
warnings** to **0 errors / 512 warnings** (+22). Breakdown: `endpoint_off_grid`
337→359 (+22, this sheet's script-authored label-at-exact-pin-coordinate
idiom, same as every other sheet), `footprint_link_issues` 127→127 (+0 —
`U8`→`Package_SON:Texas_S-PVSON-N10`, `D25`→`Package_SON:USON-10_2.5x1.0mm_P0.5mm`,
`J3`→ empty `Footprint` field matching `J2`'s own stock-symbol convention,
`R72-75`/`C63-64`→`Resistor_SMD`/`Capacitor_SMD`, `TP10`→`TestPoint:TestPoint_Pad_D1.5mm`
all resolve against libraries already registered on this machine, same
`Package_SON`/`Resistor_SMD`/`Capacitor_SMD` set Task 7 used plus `TestPoint`
which m2's TP1-9 already proved resolves cleanly too), `isolated_pin_label`
19→18 (net −1: see below), `lib_symbol_mismatch` 5→6 (+1 — `D25`'s
`TPD4E05U06DQA` cached copy, same `extends`-flattening cosmetic cause as
every other row in this category; reused Task 7's own already-flattened
`D23` cache block verbatim), `pin_to_pin` 2→2 (+0, unrelated carry-forward
from Task 7, untouched).

**`isolated_pin_label` accounting (net −1, verified against a direct ERC
JSON dump, not just the warning count):**
- **Resolved (−3):** `VBUS_DBG` (closes a documentation gap — see below),
  `USB2_MOD_DP`, `USB2_MOD_DM` (m2's row, edited above — `U8`'s common
  `D+`/`D-` pins are a real second touch).
- **New forward references (+2):** `USB2_MCU_DP`, `USB2_MCU_DM` — `U8`'s
  port-B pins (2D+/2D-), consumed by the mcu sheet (Task 9, RP2040's own
  USB2 PHY). Single touch on this sheet only, same documented-forward-
  reference pattern as every other row in this file.
- `MUX_USB2_SEL` and `USB_DBG_DP`/`USB_DBG_DM` are **not** isolated at all —
  each has ≥3 real pins entirely within this sheet (`MUX_USB2_SEL`:
  `U8.S`/`R72.1`/`TP10.1`; `USB_DBG_DP`/`DM`: `D25`+`J3`'s two non-coincident
  D+/D- pin instances each) — no waiver needed for those.

**`VBUS_DBG` — closing an undocumented gap, not removing a numbered row.**
The task context flagged "a stale `VBUS_DBG` waiver row" to remove once J3's
VBUS wiring resolves it. Audited this file plus `task-5-report.md`
end-to-end: `VBUS_DBG` was a real, live `isolated_pin_label` warning since
Task 5 (confirmed via ERC JSON — the live warning's `uuid` matches the
`global_label "VBUS_DBG"` object on `sheets/power_rails.kicad_sch` at
D17's anode exactly), but **no row in this file ever itemized it** — Task
5's own waiver section covered only `endpoint_off_grid`/
`footprint_link_issues`/`lib_symbol_mismatch` for that sheet and never
called out `isolated_pin_label` (the net table in `task-5-report.md` did
note `VBUS_DBG | not yet driven (usb2_debug sheet, future) | D17 anode`,
but that's a report note, not a waiver-table row). This task's J3 VBUS
wiring (4 coincident `VBUS` pins → `D25`'s... no, `J3`'s own `VBUS_DBG`
global label, giving the net 5 total pins: `D17.2` + `J3` A4/A9/B4/B9)
resolves the warning outright — closing the documentation gap here instead
of editing a nonexistent row.

| Date | Warning | Justification |
| ---- | --- | --- |
| 2026-07-14 | (Task 8) `endpoint_off_grid` ×22 | Same script-authored, label/symbol-at-exact-pin-coordinate idiom as every other row in this category. Connectivity verified via `uv run tools/check_nets.py` (all pass) and a direct `kicad-cli sch export netlist --format kicadxml` pin-to-net dump of all 8 USB2 nets plus `MUX_USB2_SEL`/`VBUS_DBG` (table in `task-8-report.md`). |
| 2026-07-14 | (Task 8) `lib_symbol_mismatch` ×1 — `D25`'s `TPD4E05U06DQA` cached copy differs from the stock `Power_Protection` library on disk | Same cause and resolution as the Task 7 `D23` row above (and every other row in this category): the stock symbol uses `extends` (`TPD4E05U06DQA`→`TPD4EUSB30`); flattened into a standalone cache entry. Electrically identical, differs only structurally — cosmetic. |
| 2026-07-14 | (Task 8) `isolated_pin_label` ×2 — global labels `USB2_MCU_DP`/`USB2_MCU_DM` (`U8` pins 3/4, TS3USB221 port B) each connect to only one pin on this sheet | Documented forward reference: Task 9 (mcu sheet) wires the RP2040's own USB2 PHY onto these nets. Same pattern as every other forward-reference row in this file; clears when Task 9 lands. |

## Task 9 (mcu: RP2040 control plane, W25Q128 QSPI flash, 12MHz crystal,
RUN/BOOTSEL, USB debug PHY, SWD, I2C bus + 2x TMP112 + Qwiic, LED-kill
high-side gate + SK6805-EC15 RGB, POE_STATUS divider, fan driver, DIP-4 +
spare header)

`$KCLI sch erc sierra-to-usb.kicad_sch` goes from Task-8's **0 errors / 512
warnings** to **0 errors / 600 warnings** (+88). Breakdown: `endpoint_off_grid`
359→440 (+81, this sheet's script-authored label-at-exact-pin-coordinate
idiom, same as every other sheet), `footprint_link_issues` 127→131 (+4:
`SW2`→`Button_Switch_THT:SW_SPDT_PCM12`, `SW1`→`Button_Switch_THT:SW_DIP_x04`,
`U28`→`LED_SMD:LED_SK6805-EC15_1.5x1.5mm` (custom part, no stock footprint
exists), `J5`→`Connector_JST:JST_SH_SM04B-SRSS-TB_1x04-1MP_P1.00mm` — none
of these four footprint libraries are registered in this machine's
`fp-lib-table`; footprint/library binding is Task 14, same as every other
row in this category), `isolated_pin_label` 18→18 (net 0, see breakdown
below), `lib_symbol_mismatch` 6→6 (+0 — both this sheet's `extends`-based
flattens, `Memory_Flash:W25Q128JVS`←`W25Q32JVSS` and
`Sensor_Temperature:TMP112xxDRL`←`TMP102xxDRL`, happened to produce output
byte-identical to kicad-cli's own `extends`-resolution, the same lucky case
Task 6 documented for `2N7002`), `pin_to_pin` 2→4 (+2, see below), and one
**new category**: `multiple_net_names` (+1, expected/benign — see below).

**Two ERC *errors* surfaced during development and were fixed by design (not
waived), both root-caused to this project's established "missing/mismatched
`lib_symbols` cache entry" bug class (first documented in the Task 6 section
above for `power:PWR_FLAG`, and again in Task 7 for `AP2112K-3.3`):**
1. `label_dangling` ×2 on the new project-authored `sierra-to-usb:SK6805-EC15`
   symbol's `DIN`/`VDD`-adjacent global labels (`RGB_DI`, `LED_PWR`) — the
   generator's `register_verbatim()` helper harvested this part's block
   straight from `lib/sierra-to-usb.kicad_sym` (the *master* symbol library,
   which always stores bare symbol names) without renaming it to the
   fully-qualified `sierra-to-usb:SK6805-EC15` the instance's `lib_id`
   expects, unlike the *other* verbatim-harvested parts on this sheet
   (`2N7002`, `DMG3415U`, `power:GND`, `power:PWR_FLAG`), which were all
   harvested from a *sibling sheet's own cache* (`sheets/m2.kicad_sch` /
   `sheets/usb2_debug.kicad_sch`) and were therefore already correctly
   qualified. Fixed by making `register_verbatim()` always call the same
   `rename_top()` helper `register_stock()` uses (idempotent for the
   already-qualified cases) — confirmed by re-running ERC.
2. `power_pin_not_driven` ×1 on `U28.VDD` (`power_in` type, net `LED_PWR`) —
   `Q33`'s drain is a `passive`-typed FET pin (the `sierra-to-usb:DMG3415U`
   symbol convention, same as every other DMG3415U/2N7002 use in this
   project), which doesn't satisfy ERC's driver requirement for a
   `power_in` pin the way an `output`/`power_out` pin does. Fixed the same
   way as every other genuinely-driven-but-FET-sourced net in this project
   (Tasks 4/5/6/7's `+12V_BUCK`/`+3V3`/`+3V3_MOD`/`I2C_SCL`/`VBUS_DATA`
   rows): added a `power:PWR_FLAG` colocated with `Q33`'s drain pin.

**A third issue was found and fixed during development, not an ERC
violation but a `kicad-cli sch export netlist` "schematic has annotation
errors" warning (the task's own "no annotation warnings" gate) that
appeared *intermittently* (non-deterministically, roughly half of runs)
whenever this sheet had ≥3 script-placed `power:GND`/`power:PWR_FLAG`
symbols:** root cause was the generator's power-symbol reference-string
scheme, `f"#PWR{uuid4_hex[:8]}"` (an 8-character *hex* suffix, so it can
contain letters `a`-`f`). Every pre-existing `#PWR`/`#FLG` reference
project-wide (checked directly: `grep -rhoE '#PWR[0-9]+'` across all
sheets) is a **pure-decimal** suffix, e.g. `#PWR52643990` — apparently
KiCad's annotation-consistency checker expects power-symbol pseudo-refs to
parse as plain integers, and a hex suffix containing a letter silently
corrupts its internal per-sheet reference-allocation bookkeeping once
enough such refs exist on one sheet (empirically: 2 instances never
tripped it, 3+ did, 100% reproducible once ≥3 letter-bearing refs were
present, but genuinely non-deterministic run-to-run for exactly 1-2 —
consistent with a hash-bucket/threshold effect rather than a parse
failure). Fixed by rendering the same 8 hex nibbles as a decimal integer
(`int(hexstr, 16)`) instead of leaving them as hex text — confirmed by
regenerating the whole sheet fresh (new random UUIDs each time) and
re-running `kicad-cli sch export netlist` three times in a row with zero
warnings, then repeating that regenerate+test cycle twice more.

**`isolated_pin_label` accounting (net 0, but real composition changed —
verified directly against the ERC JSON dump's actual `isolated_pin_label`
item list, not just the total count):**
- **Resolved (−3):** `USB2_MCU_DP`, `USB2_MCU_DM` (Task 8's forward
  references — `U24` GPIO2/GPIO3, the RP2040's own native PIO-USB pins, are
  the real second touch) and `LED_PWR` (Task 6's forward reference —
  `Q33`'s drain and `U28`'s VDD are both real second/third touches now).
  `POE_STS_RAW` is **not** in this list either before or after this task
  (it was never isolated to begin with: `R38.2`/`U23.4` on
  `sheets/power_input.kicad_sch` are the coincident point the new global
  label lands on, and `R85.1` on this sheet is a further touch) — see the
  `multiple_net_names` row below for that mechanism.
- **New forward references (+3):** `SIM_SEL`, `RTL_RST_N`, `UIM2_DET_CTL`
  — the exact three the task brief names explicitly as expected forward
  references, cleared when Tasks 10/11 land.
- Net: −3 + 3 = 0, so the total didn't move, but three *specific* labels
  cleared and three different ones took their place.

**`pin_to_pin` (+2) — two more instances of the same informational
"redundant forward-reference `PWR_FLAG`" pattern Task 7 already carried
forward for `usb3_data`'s `U1` RXP/RXN vs `#FLG18`/`#FLG19`:** `U24`
GPIO1 (net `I2C_SCL`) vs `#FLG015` (`sheets/power_rails.kicad_sch`, added
Task 5 specifically because "I2C bus not yet mastered by anything, since
the mcu sheet is a future task" — no longer true) and `U24` GPIO10 (net
`MUX_USB2_SEL`) vs `#FLG024` (`sheets/usb2_debug.kicad_sch`, Task 8's
forward-reference flag for the same reason). Both flags are now redundant
— this sheet supplies a real `bidirectional`-type RP2040 GPIO driver on
each net — but removing them means editing `power_rails.kicad_sch` /
`usb2_debug.kicad_sch`, outside this task's declared file scope. Flagged
as a carry-forward cleanup for whichever task next touches those two
files, not fixed here (identical handling to Task 7's own carry-forward).

**`multiple_net_names` ×1 (**new category**, informational, not an
error) — `POE_STS_RAW` (this task's one-line addition to
`sheets/power_input.kicad_sch`) and the pre-existing local label
`N_BTSTAT` are both attached to the same point (`R38` pin 2 / `U23` pin 4,
the D16/R38/opto-collector junction); kicad-cli reports `POE_STS_RAW` wins
in the netlist.** This is the *intended* mechanism (amendment 2:
"attach a global label `POE_STS_RAW` to the phototransistor-side node") —
a global label deliberately coincident with an existing local label is
this project's standard way to "export" an already-named local net under a
new global name (same technique, without the warning, as every other
sheet's global-label-at-a-pin idiom; the warning only fires here because
there happens to already be a *local* label with different text at the
exact same point). Not waived as a defect — documented as expected.

| Date | Warning | Justification |
| ---- | --- | --- |
| 2026-07-15 | (Task 9) `endpoint_off_grid` ×81 | Same script-authored, label/symbol-at-exact-pin-coordinate idiom as every other row in this category. Connectivity verified via `uv run tools/check_nets.py` (all pass, including the full GPIO map) and a direct `kicad-cli sch export netlist --format kicadxml` pin-to-net dump (tables in `task-9-report.md`). |
| 2026-07-15 | (Task 9) `footprint_link_issues` ×4 — `SW1`/`SW2` (`Button_Switch_THT:*`), `U28` (`LED_SMD:LED_SK6805-EC15_1.5x1.5mm`, custom part with no stock footprint), `J5` (`Connector_JST:*`) | Same as every other row in this category: footprint/library binding is Task 14. `Footprint` strings record the intended package for Task 14 to bind. |
| 2026-07-15 | (Task 9) `isolated_pin_label` ×3 — global labels `SIM_SEL`, `RTL_RST_N`, `UIM2_DET_CTL` (each a single touch on the whole project: the RP2040 GPIO that produces it) | The exact three forward references the task brief itself names as expected until Tasks 10/11 ("isolated forward refs SIM_SEL/UIM2_DET_CTL/RTL_RST_N expected until Tasks 10/11"). `POE_STS_RAW` is NOT in this row — verified directly against the ERC JSON, it never appears in the `isolated_pin_label` item list (it has 3 real pins: the pre-existing `N_BTSTAT` coincident point on `sheets/power_input.kicad_sch` plus this sheet's `R85.1`). Clears once the matching sheet (Task 10 for `RTL_RST_N`, Task 11 for `SIM_SEL`/`UIM2_DET_CTL`) supplies a second touch. |
| 2026-07-15 | (Task 9) `pin_to_pin` ×2 — `U24.GPIO1`/`I2C_SCL` vs `#FLG015` (`power_rails.kicad_sch`) and `U24.GPIO10`/`MUX_USB2_SEL` vs `#FLG024` (`usb2_debug.kicad_sch`), both now-redundant forward-reference `PWR_FLAG`s | Same pattern as Task 7's carried-forward `usb3_data` row: this sheet now supplies a real driver on each net, but removing the redundant flags means editing two files outside this task's declared scope (`sheets/mcu.kicad_sch` + `tools/netchecks.txt`). Flagged as a carry-forward cleanup for whichever task next touches `power_rails.kicad_sch`/`usb2_debug.kicad_sch`. |
| 2026-07-15 | (Task 9) `multiple_net_names` ×1 — `POE_STS_RAW`/`N_BTSTAT` coincident on `sheets/power_input.kicad_sch` | Intended mechanism (amendment 2's global-label-export technique), not a defect — see the accounting section above. |

## Review Fix pass (mcu.kicad_sch, 2026-07-15)

Five fixes applied to `sheets/mcu.kicad_sch` per the review brief (crystal
series-R pin swap, rail-to-rail LED-kill rebuild, RGB series R, decoupling
shortfall, minors) — full per-fix detail in `task-9-report.md`'s "Fix pass"
section. `$KCLI sch erc sierra-to-usb.kicad_sch` baseline before this pass:
**0 errors / 600 warnings** (Task 9's final state above). After the pass:
**0 errors / 611 warnings** — a clean +11, entirely in the pre-existing
`endpoint_off_grid` category (440 → 451); every other category is
byte-for-byte unchanged (`footprint_link_issues` 131, `isolated_pin_label`
18, `lib_symbol_mismatch` 6, `multiple_net_names` 1, `pin_to_pin` 4). No new
category, no error introduced.

| Date | Warning | Justification |
| ---- | --- | --- |
| 2026-07-15 | (Fix pass) `endpoint_off_grid` +11 — new/re-labelled pins and labels from Fix 1 (crystal net rename), Fix 2 (Q35 2N7002 + repurposed R82/R84 + new labels), Fix 3 (R92 + RGB_DIN split), Fix 4 (C78-C82 decoupling caps) | Same script-authored, label/symbol-at-exact-pin-coordinate idiom as every other row in this category project-wide — these coordinates are computed pin-exact (`abs = symbol_at + local_pin_offset`, local-Y negated), not grid-snapped, matching this project's established convention. Connectivity verified via `uv run tools/check_nets.py` (all pass, new + all pre-existing lines, none weakened) and direct `kicad-cli sch export netlist --format kicadxml` pin-to-net dumps for every touched net (tables in `task-9-report.md`'s Fix pass section). A new `same_local_global_label` category (LED_EN_CTL/RGB_DI/RGB_DIN/+3V3_MCU local labels colliding with pre-existing global labels of the same name) surfaced transiently during development and was resolved by construction — converting the 5 offending `label`s to `global_label`s (matching the existing scope of those net names elsewhere on the sheet) rather than waived — confirmed back to 0 instances in the final ERC run above. |

## Task 10 (ethernet: RTL8125BG-CG + Bel 2250504-1 magjack)

`$KCLI sch erc sierra-to-usb.kicad_sch` goes from the mcu review-fix-pass's
**0 errors / 611 warnings** to **0 errors / 674 warnings** (+63 net).
Breakdown: `endpoint_off_grid` 451→522 (+71, same script-authored
label/symbol-at-exact-pin-coordinate idiom as every other sheet),
`footprint_link_issues` 131→131 (+0 — verified by diffing the actual ERC
JSON item list, not just the count: zero items added or removed. Every new
footprint — `Package_DFN_QFN:QFN-48-1EP_6x6mm_P0.4mm_EP4.3x4.3mm` (U9),
`Package_SO:SOIC-8_3.9x4.9mm_P1.27mm` (U11), `Package_TO_SOT_SMD:SOT-23-5`
(U12, Q36-38), `Resistor_SMD`/`Capacitor_SMD` (new R/C), `TestPoint` (TP11),
empty string (J8, matching J2/J3's own stock-symbol convention) — resolves
against libraries already registered on this machine; footprint/library
binding itself is still Task 14), `isolated_pin_label` 18→9 (**net −9**,
see accounting below), `lib_symbol_mismatch` 6→6 (+0 — the 4 new
project-authored symbols are fully self-authored, not `extends`-flattened
from a stock symbol, so they don't trigger this category), `pin_to_pin`
4→4 (+0, unrelated pre-existing carry-forwards, untouched), `multiple_net_names`
1→2 (+1, see below). No new category.

**Two ERC *errors* + one silent design bug surfaced during development and
were fixed (not waived):**
1. Two structural authoring bugs (not ERC findings — `kicad-cli sch erc`
   simply refused to load the file, "Failed to load schematic", no detail)
   root-caused by bisection: (a) the generator's `LibSymbol` helper
   qualified sub-unit symbol names (`sierra-to-usb:RTL8125BG_0_1`) the same
   way as the top-level symbol name, when KiCad requires sub-units to use
   the *bare* name (`RTL8125BG_0_1`) regardless of the top-level symbol's
   qualification — fixed in the generator, confirmed by loading each of the
   4 new symbols individually before and after. (b) `place_gnd()`'s
   coordinate math added a `+2.54` offset on top of an already-offset
   caller-computed coordinate (stock `power:GND`'s own pin is at local
   `(0,0,270)`, i.e. zero offset from the symbol's own placement — unlike
   `R_Small`/`C_Small` whose pins sit ±2.54 from placement) — this
   double-offset left 14 `power:GND` symbols floating away from their
   intended coincidence point, giving `pin_not_connected` errors.
2. A silent (no ERC symptom until traced) coordinate collision: the EESK/
   LED1 pull-up resistor (R96 at the time) was placed at the same point
   (200, 62.54) already used for the EEPROM_SEL-to-GND tie, bridging the
   entire +3V3 plane to the entire GND plane project-wide through the
   sheet's local-label network (confirmed via a direct XML/text coordinate
   audit — the `+3V3` net's pin dump included `U9` pins 40/49 (`GND`) and
   `J8` pin `SH` before the fix). Surfaced as `pin_to_pin`
   (`same_local_global_label` on `POE_VA-`) and `multiple_net_names`
   (`+3V3`/`GND`) ERC *errors* at an intermediate stage; fixed by moving
   R96/R97 to a non-colliding coordinate. A collision-detector was added to
   the generator script itself (checks every emitted label/GND-symbol
   coordinate for accidental same-point different-rail-name collisions)
   and left in place for any future regeneration.
3. `lib_symbol_issues` (`"Symbol 'X' not found in symbol library
   'sierra-to-usb'"`) ×4, transient — the 4 new symbols were only in this
   sheet's own embedded `lib_symbols` cache, not yet in
   `lib/sierra-to-usb.kicad_sym` (the registered project library file).
   Fixed by appending all 4 (bare/unqualified names, matching that file's
   own established convention) — confirmed 0 instances after.
4. `same_local_global_label` on `LED1` ×1, transient — the EESK/LED1
   pull-up's net() call used a local `label` while every other `LED1`
   touch used a `global_label`. Fixed by making all `LED1` touches
   consistent (`global_label`) — confirmed 0 instances after.

**`isolated_pin_label` accounting (net −9, verified against a direct ERC
JSON item-list diff before/after, not just the count):**
- **Resolved (9):** `POE_VA+`, `POE_VA-`, `POE_VB+`, `POE_VB-` (the exact
  four BR1/BR2 forward references power_input.kicad_sch has carried since
  Task 4 — `J8`'s VC12/VC36/VC45/VC78 pins are the real second touch),
  `PCIE_MRX_P`, `PCIE_MRX_N` (m2's Task-6 forward reference — `U9`'s
  HSOP/HSON reach these nets through the new 220nF caps C83/C84),
  `PCIE_REFCLK_P`, `PCIE_REFCLK_N` (m2's Task-6 forward reference — `U9`
  REFCLK_P/N pins), `RTL_RST_N` (mcu's Task-9 forward reference — `U9`
  ISOLATEB pin).
- **New forward references: none.** This sheet introduces no cross-sheet
  net that isn't immediately given a second touch by this same task.
- Remaining 9 (`UIM1_DET`, `UIM1_IO`, `UIM2_DET`, `UIM2_IO`, `UIM2_CLK`,
  `UIM2_RST`, `UIM2_VDD`, `SIM_SEL`, `UIM2_DET_CTL`) are all untouched
  SIM/UIM forward references, explicitly Task 11 territory — none of them
  are this task's responsibility per the brief's declared interface.

**`multiple_net_names` (+1) — informational, not a defect, same mechanism
already established at Task 9 for `POE_STS_RAW`/`N_BTSTAT`:** `U9`'s
`EEPROM_SEL` pin (net `N_EEPROM_SEL`) is deliberately made coincident with
a `GND` point (selects 93C46 3-wire mode per the datasheet: "93C46: Power
On Latch Value Low Voltage") — `GND` wins as the canonical netlist name.
`tools/netchecks.txt`'s `U9.pinfn:EEPROM_SEL = GND` check (not
`N_EEPROM_SEL`) reflects this directly.

| Date | Warning | Justification |
| ---- | --- | --- |
| 2026-07-15 | (Task 10) `endpoint_off_grid` ×71 | Same script-authored, label/symbol-at-exact-pin-coordinate idiom as every other row in this category project-wide. Connectivity verified via `uv run tools/check_nets.py` (all pass, 36 new assertions + every pre-existing line, none weakened) and a direct `kicad-cli sch export netlist --format kicadxml` pin-to-net dump for every net this task touches (tables in `task-10-report.md`). |
| 2026-07-15 | (Task 10) `multiple_net_names` ×1 — `N_EEPROM_SEL`/`GND` coincident at `U9` pin 32 *(row text cleaned by the Task 10 fix pass: the original row carried a mid-sentence self-correction artifact — "`+3V3`/... no —" — left over from drafting; the substance is unchanged)* | Intended mechanism (same coincident-label-as-tie-off technique Task 9 established for `POE_STS_RAW`/`N_BTSTAT`), not a defect — selects 93C46 3-wire EEPROM mode per the RTL8125BG-CG datasheet's own strap table. |

## Task 10 fix pass (ethernet review rework, 2026-07-15)

`$KCLI sch erc sierra-to-usb.kicad_sch` goes from Task 10's
**0 errors / 674 warnings** to **0 errors / 707 warnings** (+33 net).
Breakdown: `endpoint_off_grid` 522→552 (+30 — same script-authored
label-at-exact-pin-coordinate idiom; net of −~20 removed with the external
Bob-Smith network/TP11/LDO and +~50 added with the two buck converters,
LED, bead, and new pull-up/-down/divider resistors), `lib_symbol_mismatch`
6→9 (**+3, new waiver row below** — Q36-38 `Transistor_FET:BSS138`),
`footprint_link_issues` 131→131 (+0 — verified zero items on the Ethernet
sheet in the ERC JSON: every new footprint, incl. `SOT-583-8`,
`LED_SMD:LED_0603_1608Metric`, `Inductor_SMD:L_1210_3225Metric`/`L_0603`,
`C_0805`, resolves against registered libraries; TP11's TestPoint footprint
left with it), `isolated_pin_label` 9→9 (+0 — same 9 SIM/UIM Task-11
forward references; `RTL_RST_N` stays resolved and gains its Fix-3e 10k
pull-down as a third touch), `multiple_net_names` 2→2 (+0 — the
`N_EEPROM_SEL`/`GND` strap tie is kept; the Task-10 `N_J8_SHIELD`-hard-to-
GND coincidence is *gone* — shield is now RC-tied (1M‖1nF) like J1/J2/J3 —
but that coincidence never produced a warning row of its own),
`pin_to_pin` 4→4 (+0, untouched pre-existing carry-forwards). No new
category.

**One ERC *error* surfaced during the fix pass and was fixed (not
waived):** `power_pin_not_driven` on `U9` pin 15 (`AVDD33_PLL`) — the new
ferrite bead (FB1, passive pins) isolates the PLL supply island from
`+3V3_ETH`, so the island needs its own `PWR_FLAG` (same idiom as every
L-C-filtered rail in KiCad). Flag added at the bead output; confirmed 0
errors after.

| Date | Warning | Justification |
| ---- | --- | --- |
| 2026-07-15 | (Task 10 fix pass) `lib_symbol_mismatch` ×3 — `Q36`/`Q37`/`Q38` `Transistor_FET:BSS138` | The embedded BSS138 block is a field-updated clone of the project's harvested stock `Transistor_FET:2N7002` block (same G1/S2/D3 SOT-23 pinout and body; Value/Datasheet/Description updated to the LRC LBSS138LT1G sourcing facts) rather than a verbatim copy of the system-library BSS138, so ERC flags the difference against the system lib. Same benign category as the pre-existing TCMT1107/AP2112K/TPD4E05U06DQA rows (6 of them) — connectivity and pinfunction names (`G`/`S`/`D`) verified by `tools/check_nets.py` (`Q36.pinfn:S = PERST_N`, `Q36.pinfn:G = +1V8`, etc., all pass). |
| 2026-07-15 | (Task 10 fix pass) `endpoint_off_grid` +30 net | Same waived idiom and verification as the Task 10 row above: `uv run tools/check_nets.py` all-pass (45 new fix-pass assertions incl. the eight MDI polarity pin-number locks + eight pinfn locks; zero pre-existing lines weakened) plus full netlist membership diff in `task-10-report.md` "Fix pass". |

---

## Task 11 — sim (dual SIM + eSIM slot-2 override mux)

**0 errors / 707 warnings** to **0 errors / 756 warnings** (+49 net).
Breakdown: `endpoint_off_grid` 552→603 (+51 — same script-authored
label-at-exact-pin-coordinate idiom as every other sheet), `footprint_link_issues`
131→134 (+3 — SIM1/SIM2 [`sierra-to-usb:NanoSIM_JXTCONN_CSIM-H137-7P`] and U30
[`sierra-to-usb:VFDFPN8_MFF2`] reference footprints in a `sierra-to-usb`
footprint library that isn't registered in `fp-lib-table` — genuine "footprint
TBD" flag, matching this project's established Task-14-footprint-lock
deferral for other hand-solder custom parts, not a wiring defect; D27/D28/U29
use real stock footprints (`SOT-23-6`, `TSSOP-24_4.4x7.8mm_P0.65mm`) and
don't trigger this), `lib_symbol_mismatch` 9→9 (+0, untouched pre-existing),
`isolated_pin_label` 9→**0** (**−9, RESOLVED by construction, not waived** —
these were exactly the `UIM1_VDD/RST/CLK/IO/DET`, `UIM2_VDD/RST/CLK/IO/DET`,
`SIM_SEL`, `UIM2_DET_CTL` forward-reference global labels on `m2.kicad_sch`/
`mcu.kicad_sch` with no matching endpoint while `sim.kicad_sch` was an empty
placeholder — Task 10's waiver row for those sheets explicitly called these
"the 9 SIM/UIM Task-11 forward references"; wiring the sim sheet gives every
one of them a real endpoint, closing the loop), `multiple_net_names` 2→2
(+0, untouched pre-existing), `pin_to_pin` 4→8 (+4 — two are pre-existing
`m2.kicad_sch` `PWR_FLAG`s (`#FLG20`/`#FLG21`, already sitting on the
`UIM1_RST`/`UIM1_CLK` forward-reference labels since before this task) that
only *now* show as "Bidirectional connected to Power output" because SIM1's
real device pins are finally on those nets; the other two are this task's
own new `PWR_FLAG`s on `UIM2S_VDD` (near D28) and `UIM2E_VDD` (near U30) —
same benign "PWR_FLAG formally conflicts with a bidirectional device pin on
its own genuinely-driven net" category as every other `pin_to_pin`/
`power_pin_not_driven` row in this document, e.g. the Ethernet `AVDD33_PLL`
row above and the mcu-sheet `LED_PWR` row).

**Two ERC *errors* surfaced during authoring and were fixed (not waived):**
`power_pin_not_driven` on `D28` pin 5 (`VCC`/`UIM2S_VDD`) and `U30` pin 8
(`VCC`/`UIM2E_VDD`) — both nets are driven only by "Bidirectional"-typed pins
(TS3A27518E mux channels) and passive component pins from ERC's point of
view, not a genuine `power_out` pin, exactly the same class TI's TS3USB221/
HD3SS3220 SS nets and the Ethernet `AVDD33_PLL` island hit earlier in this
project. Fixed the same way: one `PWR_FLAG` added on each net (at D28.VCC
and U30.VCC respectively). Confirmed 0 errors after — see the `pin_to_pin`
row above for the resulting (expected, benign) side-effect warnings.

A transient `lib_symbol_issues` ×6 (`SIM1`/`SIM2`/`D27`/`D28`/`U29`/`U30` —
"Symbol not found in symbol library 'sierra-to-usb'") appeared before the
four new custom parts (`TS3A27518E`, `TPD4S009`, `ST4SIM-200M`,
`JXTCONN_CSIM-H137-7P`) were added to `lib/sierra-to-usb.kicad_sym` (the
project's master custom-symbol library, matching where `DMG3415U`,
`WE750313355`, `USB_C_Receptacle_USB3.2_24P`, etc. already live) — resolved
by construction once added, confirmed back to 0 instances in the final ERC
run above, not carried as a waiver row.

| Date | Warning | Justification |
| ---- | --- | --- |
| 2026-07-15 | (Task 11) `endpoint_off_grid` +51 | Same script-authored, label/symbol-at-exact-pin-coordinate idiom as every other row in this category project-wide. Connectivity verified via `uv run tools/check_nets.py` (all pass, 6 Step-1 + 46 supplementary assertions, tables in `task-11-report.md`) and a direct `kicad-cli sch export netlist --format kicadxml` pin-to-net dump for every UIM1_*/UIM2_*/UIM2S_*/UIM2E_*/SIM_SEL/UIM2_DET_CTL net. |
| 2026-07-15 | (Task 11) `footprint_link_issues` +3 — SIM1, SIM2, U30 | Custom hand-solder parts (nano-SIM push-push socket, MFF2 eSIM) with no stock KiCad footprint and no footprint authored yet — `sierra-to-usb:NanoSIM_JXTCONN_CSIM-H137-7P` / `sierra-to-usb:VFDFPN8_MFF2` are placeholder footprint refs, real footprint authoring deferred to Task 14 (matches this project's established footprint-lock timing for every other custom/hand-solder part, e.g. the M.2 socket, USB-C receptacles). |
| 2026-07-15 | (Task 11) `pin_to_pin` +4 — SIM1↔`#FLG20`/`#FLG21` (pre-existing m2 flags), U29↔new D28/U30 `PWR_FLAG`s | Same benign "`PWR_FLAG` (Power output) formally conflicts with a Bidirectional device pin on the same genuinely-driven net" category as every other `power_pin_not_driven`-fix row in this document. Connectivity (not the flag) verified via `uv run tools/check_nets.py`. |

## Task 11 fix pass — sim DET pull-up removal + ch6 hygiene (2026-07-15)

**0 errors / 756 warnings** to **0 errors / 758 warnings** (+2 net). R114/R115/R118
(the 100k DET-to-`+3V3` pull-ups on `UIM1_DET`/`UIM2S_DET`/`UIM2E_DET`) were
deleted per the Sierra PTS: CN1 pins 40/66 are two-state (grounded=absent,
floating/module-internal-pull-up=present) on a likely-1.8V-domain pin, and a
3.3V pull-up was an undocumented third voltage state, not a legitimate
"present" presentation. Breakdown: `endpoint_off_grid` 603→602 (**−1** — three
resistors' worth of pin/label coincidence points removed, one net fewer
off-grid label than component pins removed since `UIM2E_DET`'s two coincident
points collapse to one), `footprint_link_issues` 134→134 (+0, untouched),
`lib_symbol_mismatch` 9→9 (+0, untouched), `multiple_net_names` 2→2 (+0,
untouched), `isolated_pin_label` 0→**1** (**+1, expected, not a regression**
— `UIM2E_DET` is now genuinely a single-pin net (`U29` NO5 only, no
board-side pull-up), exactly the disclosed "floats = present when eSIM
selected" design; this is the one case in this document where the category
is the *intended* electrical state, not a forward-reference artifact —
locked in `tools/netchecks.txt` as `NET UIM2E_DET PINS>=1` rather than
waived away), `pin_to_pin` 8→**10** (**+2** — the two new `power:GND` ties on
`U29` NC6/NO6 (ch6 hygiene, Fix 2 below) each register as "Bidirectional
connected to Power output", same benign category as every other
`pin_to_pin` row in this document).

**Fix 1 (DET pull-up removal):** confirmed by direct `kicad-cli sch export
netlist --format kicadxml` pin-to-net dump: `UIM1_DET` = {`C119.1`,
`CN1.66`, `D27.D2-`, `SIM1.CD2`} (R114 gone), `UIM2S_DET` = {`C124.1`,
`D28.D2-`, `SIM2.CD2`, `U29.NC5`} (R115 gone), `UIM2E_DET` = {`U29.NO5`}
only (R118 gone), `UIM2_DET` = {`CN1.40`, `Q39.D`, `U29.COM5`} unchanged —
Q39's force-absent override still sits on the module-facing (post-mux) side
exactly as before. `tools/netchecks.txt`'s `NET UIM2E_DET PINS>=2` line is
now `NET UIM2E_DET PINS>=1` (the only netcheck line that depended on a
deleted resistor); `UIM1_DET`/`UIM2S_DET`'s existing `PINS>=3` locks still
hold on the post-deletion 4- and 3-pin nets respectively, unweakened.

**Fix 2 (ch6 hygiene):** `U29`'s unused channel 6 (NC6 pin22, NO6 pin16) —
previously bare `no_connect` flags — now ties to `GND` via two new
`power:GND` symbols. COM6 (pin12) stays NC-flagged: no local copy of the
TS3A27518E datasheet's unused-channel note was available to check during
this pass, so the conservative default (ground the switch throws, leave the
common open) was used and is disclosed here rather than assumed silently.

## Task 12 — rf (5x MHF4 -> SMA breakouts, 2026-07-15)

**0 errors / 758 warnings** to **0 errors / 788 warnings** (+30, no new
category). Ten stock `Connector:Conn_Coaxial` instances placed (J9-J18: 5x
MHF4 receptacle + 5x SMA edge jack, pin1=signal net-to-net per pair,
pin2=shield to `GND`). Breakdown: `endpoint_off_grid` 602→622 (**+20** — this
sheet uses the same script-authored, label/power-symbol-at-exact-pin-
coordinate idiom as every other sheet; 4 off-grid endpoints per net row (2
signal labels + 2 GND symbols) x 5 rows), `footprint_link_issues` 134→144
(**+10** — one per placed `J9`-`J18` symbol; `Footprint` field records the
intended package string per docs/sourcing.md (`MHF4_TE_CONMHF4-SMD-G-T` /
`SMA_EdgeMount_BWSMA-KE-Z001`) since no exact-MPN stock footprint exists —
Task 14 sources/authors the real footprints, same deferral pattern as every
earlier sheet), `lib_symbol_mismatch` 9→9 (+0 — `Connector:Conn_Coaxial` is
a plain standalone stock symbol, no `extends` inheritance to flatten, so it
introduces no new mismatch; `power:GND` is likewise copied verbatim),
`isolated_pin_label` 1→1 (+0, untouched), `multiple_net_names` 2→2 (+0,
untouched), `pin_to_pin` 10→10 (+0, untouched).

**Errors found and fixed during development (not waived):** an initial
build placed each shield-pin (`Ext`, pin 2) `power:GND` tie using a naive
"symbol position + pin's raw local (x,y)" formula, mirroring the formula
already proven correct elsewhere in this project for `Device:C_Small`'s
pins. That produced 20 `pin_not_connected` ERC *errors* (all `J9`-`J18` pin
2 plus their intended `GND` ties) — confirmed via `kicad-cli sch export
netlist` showing `unconnected-(J*-Ext-Pad2)` nets instead of merged `GND`
membership. Root-caused with an isolated two-symbol test schematic
(`Connector:Conn_Coaxial` + `power:GND` only, both sign conventions tried):
`Connector:Conn_Coaxial`'s pin 2 (library-declared `(at 0 -5.08 90)`) needs
its **y negated** to reach the real connection point (`symbol_y + 5.08`, not
`symbol_y - 5.08`) — the opposite sign convention from `Device:C_Small`'s
pins, which take their local y directly. The two stock symbols do not share
a consistent library-Y sign convention; the safe practice going forward is
to verify new symbol/pin combinations with an isolated connectivity test
before trusting a transcribed offset, not to assume one part's convention
generalizes to another. Fixed by negating pin 2's y-offset; re-verified via
full netlist re-export (all 10 shield pins land on `GND`) and `kicad-cli sch
erc` (0 errors). Same class of silent-connectivity risk task-11-report.md's
"Bug found during development" section and this document's existing
`endpoint_off_grid` rows both describe, caught here before commit rather
than after.

## Task 13 Fix pass (F1/F2/F3, 2026-07-15)

**0 errors / 788 warnings** to **0 errors / 800 warnings** (+12, no new
category). Six new placed parts (`Q40`/`R122` on m2; `D29`/`R120`/`D30`/`R121`
on power_input) plus a `power:GND` tie for `D29`; `R40`/`R41` values changed
only (no new pins); six `label`→`global_label` promotions on ethernet
(`N_PERST_3V3`/`N_CLKREQ_3V3` x3 each, needed so mcu's retargeted GP18/GP19
can reach them cross-sheet); three mcu `global_label` renames (text only,
same coordinates). Breakdown: `endpoint_off_grid` 622→629 (**+7** — same
script-authored, label/symbol-at-exact-pin-coordinate idiom as every other
row in this category; new coincidence points for Q40/R122's 5 pins plus
D29/R120/D30/R121's 4 net-label points, verified electrically correct via
direct `kicad-cli sch export netlist` pin-to-net dump, not just ERC, table
in task-13-report.md Fix pass), `footprint_link_issues` 144→148 (**+4** —
one per new placed symbol without a resolved footprint yet: `Q40`
(`Package_TO_SOT_SMD:SOT-23`, matches Q36-38's existing waived footprint
string exactly), `D29`/`D30` (`LED_0603`, matches D16's existing waived
footprint string), `R120`/`R121`/`R122` use `R_0603`/
`Resistor_SMD:R_0603_1608Metric` which are already-registered stock
footprints — so only 4 of the 6 new parts land in this category; same Task
14 deferral as every earlier row), `lib_symbol_mismatch` 9→10 (**+1** — the
`Transistor_FET:BSS138` copy newly embedded in m2's `lib_symbols` (for
`Q40`) is a byte-for-byte copy of the one already embedded and waived on the
ethernet sheet (Task 10, `Q36`-`38`); same stock-vs-cached structural diff,
same resolution), `isolated_pin_label` 1→1 (+0, untouched — `UIM2E_DET`
unaffected), `multiple_net_names` 2→2 (+0, untouched), `pin_to_pin` 10→10
(+0, untouched).

**F1 (power_rails):** `R40`/`R41` values only (`1.00M`/`100k` →
`36.5k`/`9.31k`); topology, pin count, and net membership on `BUCK_EN`
unchanged, so this fix contributes zero ERC delta on its own.

**F2 (mcu/ethernet/m2):** confirmed via direct `kicad-cli sch export
netlist --format kicadxml` pin-to-net dump: `N_PERST_3V3` = {`Q36.3`,
`R93.1`, `U24.29`(`GPIO18`), `U9.36`(`PERSTB`)}, `N_CLKREQ_3V3` = {`Q37.3`,
`R94.1`, `U24.30`(`GPIO19`), `U9.48`(`CLKREQB`)}, `WAKE_3V3` = {`Q40.3`,
`R122.1`, `U24.28`(`GPIO17`)} — all three RP2040 GPIOs now land in the
3.3V domain alongside the signals they're reading. `PERST_N`/`CLKREQ_N`/
`WAKE_N` (1.8V side) unchanged: `CN1`/`R6x`/`TPx`/`Q3x`.S membership intact.

**F3 (power_input):** confirmed via the same netlist dump: `D29.2`(`A`) =
`N_D29_A` = `R120.2`, `R120.1` = `LED_PWR`, `D29.1`(`K`) = `GND`;
`D30.2`(`A`) = `N_D30_A` = `R121.2`, `R121.1` = `LED_PWR`, `D30.1`(`K`) =
`CH224K_PG` (now shared with `R4.2`'s existing 10k pull-up to `+3V3` — no
conflict, see task-13-report.md Fix pass for the current-budget check).
`LED_PWR` net grew from 4 to 6 members (`+2`, both new `R120.1`/`R121.1`
taps), still comfortably above the `NET LED_PWR PINS>=4` lock in
`tools/netchecks.txt`.

Zero `pin_not_connected` ERC errors and zero unannotated references
project-wide after this pass (`kicad-cli sch export netlist` ran clean with
no "annotation errors" warning on the final iteration — an earlier iteration
of this fix pass hit that exact warning from a `#PWR` reference collision
introduced while adding `D29`'s ground tie, root-caused and fixed by
picking a refdes not already in use anywhere in the flat hierarchy, not just
on the local sheet; see task-13-report.md Fix pass for the full story).

## Task 14 — footprint_link_issues collapse (footprint + fp-lib-table binding)

Every `footprint_link_issues` row logged above (Tasks 4–13, ~148 accumulated
instances across all 9 sheets per the last full ERC run) was an intentional,
disclosed deferral: symbols carried their *intended* footprint string early
so downstream tasks had the real target, but no `fp-lib-table` existed yet
to resolve them. Task 14 closes all of them in one pass:

1. Added `fp-lib-table` (project root) registering a new project footprint
   library `sierra-to-usb` → `lib/sierra-to-usb.pretty/`, mirroring the
   existing `sym-lib-table` pattern for the project symbol library.
2. Authored 15 real custom footprints in `lib/sierra-to-usb.pretty/` for
   parts with no stock KiCad equivalent (full citations/pad tables in
   `task-14-report.md`): `Bel_2250504-1` (magjack), `MHF4_TE_CONMHF4-SMD-G-T`,
   `SMA_EdgeMount_BWSMA-KE-Z001`, `NanoSIM_JXTCONN_CSIM-H137-7P`,
   `VFDFPN8_MFF2` (eSIM), `M.2_Key-B-SMD_Socket_LOTES_APCI0105-P001A`,
   `D_MBS-4` (bridge rectifier), `L_Wurth_WE-HCI_74435571500`/
   `_744325550` (PoE flyback inductors L1/L2), `TPS23730_RMTR`, `FDMC2523P`,
   `DIP-4_SMD_GullWing_FOD817`, `LED_SK6805-EC15_1.5x1.5mm`,
   `Transformer_SMT_WE750313355`, and `USB_C_Receptacle_HRO_TYPE-C-31-M-04`
   (see CRITICAL finding below — J1's MPN itself was corrected, not just
   its footprint).
3. Rewrote every bare/stale `Footprint` string (115 old-style no-library-prefix
   names + 3 empty + several wrong-library-prefix bugs found along the way,
   e.g. `Diode_SMB:D_SMB`→`Diode_SMD:D_SMB`, `Button_Switch_THT:SW_SPDT_PCM12`
   →`Button_Switch_SMD:SW_SPDT_PCM12`, `PG-TDSON-8`→`TDSON-8-1`) to real,
   filesystem-verified `Library:Name` strings across all 363 BOM symbols.

Result: `kicad-cli sch erc` → **0 errors**, `footprint_link_issues` **148→0**
(fully collapsed, confirmed by re-running ERC after the fix pass — see
`task-14-report.md` for the full before/after breakdown). Remaining warning
categories (`endpoint_off_grid` 629, `pin_to_pin` 10, `lib_symbol_mismatch`
10, `multiple_net_names` 2, `isolated_pin_label` 1) are all pre-existing,
untouched by this task, and already carry their own waiver rows above.

**CRITICAL finding, fixed (MPN-level, not just footprint-level):** while
binding J1's footprint, the stock `Connector_USB:USB_C_Receptacle_HRO_
TYPE-C-31-M-17.kicad_mod` file that Task 7 assumed was J1's exact match
(name-matched the MPN) turned out to expose only **6 real pads**
(`A5/A9/A12/B5/B9/B12`, i.e. CC1/CC2/VBUS/GND) plus shield.
`check_footprints.py` caught this via its pad-count-vs-pin-count assertion.
Investigating further (fetching HRO's own manufacturer datasheet, not just
trusting the KiCad footprint filename) found the mismatch is **not a
footprint-binding bug — the MPN itself is wrong**: HRO TYPE-C-31-M-17
(LCSC C283540) is titled "DETECTOR SWITCHS" in its own datasheet and is
genuinely a 6-pin CC/VBUS/GND-only receptacle with no D+/D-, no SBU, and no
SuperSpeed pairs — it physically cannot carry the USB3 data J1 is wired
for, and never matched the 24-pin `USB_C_Receptacle_USB3.2_24P` symbol.
**Re-pinned J1 to HRO TYPE-C-31-M-04 (LCSC C129018)**, the genuine
24-pin/full-featured part in the same HRO family, whose datasheet pin table
matches the project symbol pin-for-pin. Schematic Value/MPN/LCSC/Datasheet
properties updated; footprint authored as `sierra-to-usb:
USB_C_Receptacle_HRO_TYPE-C-31-M-04` (pad pitch/width from M-04's own
datasheet; row separation/pad length/shield geometry approximated from
generic USB-C 24-pin SMD convention — flagged for confirmation against a
real drawing/physical part before fab). See `task-14-report.md` for the
full pad table and `docs/sourcing.md`'s §2 J1 row for the sourcing-side
correction. Flagged here per the Global Constraints disclosure rule: this
was a real, silent-until-now MPN-selection defect from Task 7, not
introduced by Task 14 — caught only because this task's pin-count
verification forced a genuine datasheet check instead of trusting a
name-matched stock footprint filename.

**2026-07-15 GUI-resave note:** KiCad GUI resave normalized coordinates; ERC warning total now 595 (was 652). Category re-count deferred to next waiver-touching task.
