alxgmpr/sierra-to-usb/handoff/m2-sierra-handoff/HANDOFF-em9293-2026-07-14.md

> Historical evidence from superseded designs. See the [current full adapter](../../full-adapter/README.md). Circuit status and artifact paths below refer to the historical checkpoint, not the replacement.

# EM9293 M.2 Carrier — Session Handoff (2026-07-14)

Background + current state for continuing the **Sierra/Semtech EM9293 5G M.2 carrier board** in a fresh session. Read this first, then the source-of-truth docs listed in §8.

---

## 1. What this project is

A custom **M.2 Key-B carrier board** that runs a **Sierra Wireless EM9293** 5G modem in **forced-USB SuperSpeed** mode, for bench bring-up and throughput testing against the user's existing RM551E setup. Designed originally in **EasyEDA Pro** for **JLCPCB PCBA** (all LCSC parts). **As of 2026-07-14 the project is being migrated to KiCad 10** (schematic already imported; see §7).

The user is not selling this board — "we can go overkill" on robustness.

## 2. Goal & hard constraints

- **Forced-USB bring-up of the EM9293** (it defaults to PCIe). Per the *EM92XX Product Technical Specification Rev 1, Doc# 41114313* (Table 3-1, §3.2–3.10):
  - **Pin 6** `Full_Card_Power_Off_N` pulled **high** (R9 100k → +3V3).
  - **Pin 20** `PCIE_DIS` → **1.8 V**.
  - **Pin 22** `VBUS_SENSE` driven **high** (from the data-port VBUS via R12 33 Ω) — required for USB activation.
- **USB 3.x SuperSpeed** data path to a host PC (board is a **UFP/device** toward the PC).
- **Dual SIM** (UIM1 external 1.8/3 V + UIM2 1.8 V-only).
- All parts **LCSC / JLC-orderable**.

## 3. Architecture (from the 07-14 netlist)

| Ref | Part | Role |
|---|---|---|
| CN1 | M.2 Key-B socket | the EM9293 module |
| USB1 | USB-C receptacle | **data** port (SS + CC + USB2 + VBUS_DATA) |
| USB2 | USB-C receptacle | **power/PD** port (VBUS_PD + CC only) |
| U1 | **HD3SS3220** | Type-C CC logic **+** 2:1 SS orientation mux (standalone UFP: presents Rd, detects orientation, steers mux) |
| U2 | **CH224K** | USB-PD sink on the power port |
| U3 | **TPS565201** | sync buck, VBUS_PD → main rail |
| U4 | LDO | makes the mux's local 3V3 (`$1N75`) from VBUS_DATA (mux alive whenever data cable present) |
| U5 | **AP2112K** | LDO(s) for +1V8 / +3V3 |
| SIM1/SIM2 | dual nano-SIM | UIM1 + UIM2 |
| D1/D4 | TPD4EUSB30 | connector-side SS ESD (flow-through) |
| D6 | TPD4EUSB30 | module-side SS ESD |
| D2 | TPD4E05U06 | CC + USB2 D± ESD (data port) |
| D3/D5 | SMAJ TVS | VBUS_DATA / VBUS_PD clamps |
| C14/C15 | AC caps | USB3 RX coupling — **currently on the WRONG pair, see §5** |
| R15/R16 | 0 Ω 0402 | USB2 D+/D- A↔B crossover jumpers — **currently inert, see §5** |

Two separate USB-C ports by design: **data** (USB1 → HD3SS3220 → module) and **power/PD** (USB2 → CH224K → buck). VBUS_DATA is used only for mux power + the module's VBUS_SENSE; VBUS_PD is the real power input.

## 4. Current status

- **Schematic:** essentially complete (67 components), heavily reviewed and datasheet-verified across prior sessions.
- **PCB layout:** in progress in EasyEDA as of 07-14 — but it's currently **2-layer**, which is the biggest problem (see §5).
- **Migration:** schematic imported into KiCad 10 (`~/Downloads/m2-sierra/`). PCB not yet imported. Chosen approach: **"import as-is, fix while routing."**
- Intended repo home for the KiCad project: `hardware/em9293-carrier/` (created, `.gitignore` in place, project not yet copied in).

## 5. Verified issues to fix (prioritized) — from the 07-14 netlist/DXF review

**🔴 1. AC-coupling caps on the WRONG SuperSpeed pair (electrical bug).**
`C14/C15` sit between the mux RX (U1.6/7) and **M.2 pins 35/37** = the **module-TX / host-RX** link (`USB3_RX` net). The **module-RX / host-TX** link (mux U1.9/10 → **M.2 29/31**, `USB3_TX` net) has **no caps**. Per EM92xx PTS §3.3.1 ("series caps on the host side for the module's RX; none on the module's TX"), it's backwards.
→ **Fix:** move C14/C15 onto the `USB3_TX` pair (M.2 29/31); remove them from `USB3_RX` (let 35/37 run straight through the ESD — the module caps its own TX). **Re-confirm which M.2 pins the PTS calls the module's RX before committing** — the whole fix hinges on that (cross-checked to M.2 Key-B standard: 29/31 = module Rx, 35/37 = module Tx).

**🔴 2. Board is 2-layer — no controlled 90 Ω on the SS pairs.** DXF shows only Top/Bottom copper, bottom is not a solid plane, ~0.20 mm traces. USB3 needs a continuous ground reference.
→ **Fix:** go **4-layer** (Sig / GND / PWR / Sig). The original spec (see specs doc) already called for 4-layer; the layout regressed to 2. This is the #1 thing for reliable 5 Gb/s.

**🟠 3. No impedance / length rules.** `netClass`, `equalLengthNetGroup`, and every net's `TrackPhysics` are empty. Diff pairs are associated (P/N) but have no 90 Ω target, width/gap, or skew match.
→ **Fix:** set a 90 Ω differential net class on the SS pairs **and** the USB2 pair only; CC/everything else stays default.

**🟠 4. USB2 crossover jumpers R15/R16 are inert.** Both pads of R15 are on `USB2_DP`, both of R16 on `USB2_DM`, and A6+B6 are already tied — so the router treats them as redundant shorts and won't force the D± bridge.
→ **Fix:** split nets (A6→`DP_A`, B6→`DP_B`, R15 bridges them; same for R16 on D−), **or** delete R15/R16 and do the crossover with a symmetric via. (See the D+/D− crossover reference in this bundle.)

**🟡 5. PD-port CC has no ESD.** `USB2_CC1/CC2` go straight to the CH224K with no ESD array (the data port has D2). Add a small CC ESD for parity.

**🟡 6. Confirm the 65-pin no-net group is intentional NC** (M.2 reserved pins, SBU A8/B8, SIM CD, mux/CH224K NC pins). Add **No-Connect flags** for clean ERC; verify none are signals that should be routed (esp. mux U1.11/22–27, CH224K U2.2–5).

**🟡 7. Board outline reads 200×100 mm** in the DXF — almost certainly the sheet frame, not the board. Confirm real dimensions.

## 6. What's CONFIRMED CORRECT (don't "re-fix")

- **All connector-side SS pair polarity** (SSTX1/2, SSRX1/2 map per USB-C standard).
- **M.2 SS polarity + TX/RX crossover**: host TX → module RX (pins 29/31); module TX → host RX (pins 35/37). Directions and ± all correct.
- **Polarity preserved** through the mux and the AC caps (no P/N flips).
- **ESD flow-through** on every SS pair (D1/D4 connector-side, D6 module-side; connector-side SS ESD was added to protect the mux's 2.5 V-abs-max SS pins).
- **USB2 D+/D- kept correct polarity** to the module (NOT swapped — USB2 is polarity-sensitive; only SS pairs may be inverted, and they self-correct at link training).
- **CC1/CC2 need no controlled impedance** (single-ended, low-speed: DC + ~300 kHz BMC PD). Route loose; keep off the buck SW node; don't add >~600 pF.

## 7. KiCad migration state

- **KiCad 10.0.4** installed. `kicad-cli` at `/Applications/KiCad/KiCad.app/Contents/MacOS/kicad-cli`.
- A schematic import was done earlier (`~/Downloads/m2-sierra/`) but has since been **deleted** — just re-import from the `.epro` (§9). The import brings the schematic + symbols; it produced **no `.kicad_pcb`**, so plan to re-lay-out the PCB fresh as 4-layer (cleaner than importing the 2-layer board anyway).
- Plan: land the project at `hardware/em9293-carrier/` in the repo (git-tracked, so an agent can read/edit `.kicad_sch` / `.kicad_pcb` S-expressions directly).
- **Why KiCad:** plain-text files → an agent can directly edit nets, set net classes/rules, scaffold placement, and check BOM/CPL via `kicad-cli` — none of which was possible with EasyEDA's web tool.

## 8. Source-of-truth docs (in this bundle)

- `netlist-em9293-carrier.md` — master pin→net-label reference for every connector/IC.
- `specs/2026-07-10-em9293-carrier-design.md` — design spec (cites the EM92XX PTS; calls for 4-layer; has the BOM).
- `audit-2026-07-10-schematic.md` — full audit history (criticals resolved, layout-prep diff-pair polarity plan).
- `plans/2026-07-10-em9293-carrier.md` — implementation plan (task checklist).
- `em9293-bringup.md` — project memory (forced-USB facts; EM9293 won't run in the Quectel 5G2PHY).
- `usbc-dpdm-crossover.html` — diagrammed reference for the USB2 D+/D- A↔B crossover (issue #4).

## 9. Export files (in this bundle)

- `ProPrj_Sierra Wireless M2 Carrier_2026-07-14.epro` — **latest & complete** EasyEDA Pro project (schematic + PCB + libraries all inside this one zip; open in EasyEDA Pro, or re-import to KiCad 10 via *File → Import Non-KiCad Project → EasyEDA (JLCEDA) Pro*). This is the authoritative design file.
- `SCH_Schematic1_2026-07-12.pdf` — readable schematic (07-12; slightly behind the .epro).

> The standalone intermediate exports (`Netlist_PCB1_2026-07-14.enet`, `DXF_PCB1_2026-07-14.dxf`, the schematic `.enet`, the BOM `.csv`) and the earlier `~/Downloads/m2-sierra/` KiCad import were **deleted** and are **not** in this bundle — all are regenerable from the `.epro`. The §5 review findings were captured from the 07-14 netlist before deletion and are recorded above.

## 10. Immediate next steps for the new session

1. Decide **4-layer** (strongly recommended) — if yes, plan a fresh PCB layout rather than importing the 2-layer board.
2. Copy the KiCad project into `hardware/em9293-carrier/` and commit.
3. Apply schematic fixes in `.kicad_sch`: **AC-cap move (#1)** and **R15/R16 crossover split (#4)**.
4. Set up the **90 Ω diff net class (#3)** on SS pairs + USB2 pair.
5. Add **PD-port CC ESD (#5)** and **No-Connect flags (#6)**.
6. Then placement/routing, JLC BOM+CPL via `kicad-cli`.

## 11. Key parts reference

Module **EM9293** · CC+mux **HD3SS3220RNHT** · PD **CH224K** · buck **TPS565201** · LDOs **AP2112K-3.3 / AP2112K-1.8** · inductor **SWPA6045S2R2MT (LCSC C2926400)** · SS ESD **TPD4EUSB30** · CC/USB2 ESD **TPD4E05U06** · SIM ESD **TPD2E009** (candidate upgrade **TPD4S009**) · TVS **SMAJ13A** (VBUS_PD) / **SMAJ5.0A** (VBUS_DATA) · crossover jumpers **0 Ω 0402**.
