alxgmpr/sierra-to-usb/compact/carrier/power-review.md

# Direct-buck power review — conditional prototype design

The captured replacement uses TPS259470L input protection, a 10 mΩ four-terminal VPG shunt, INA190A1 current sensing, a REF3312/TLV333 analog current override, and LTC3310S regulating a nominal 3.33 V rail. Four T530D227M006ATE005 polymer capacitors and local ceramics shunt the live output. There is no two-stage supercapacitor charger in this architecture. The historical LTC3128/TPS62816 candidate remains rejected.

## Low-line capability
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
