alxgmpr/sierra-to-usb/compact/reference/3m-891-p2.png

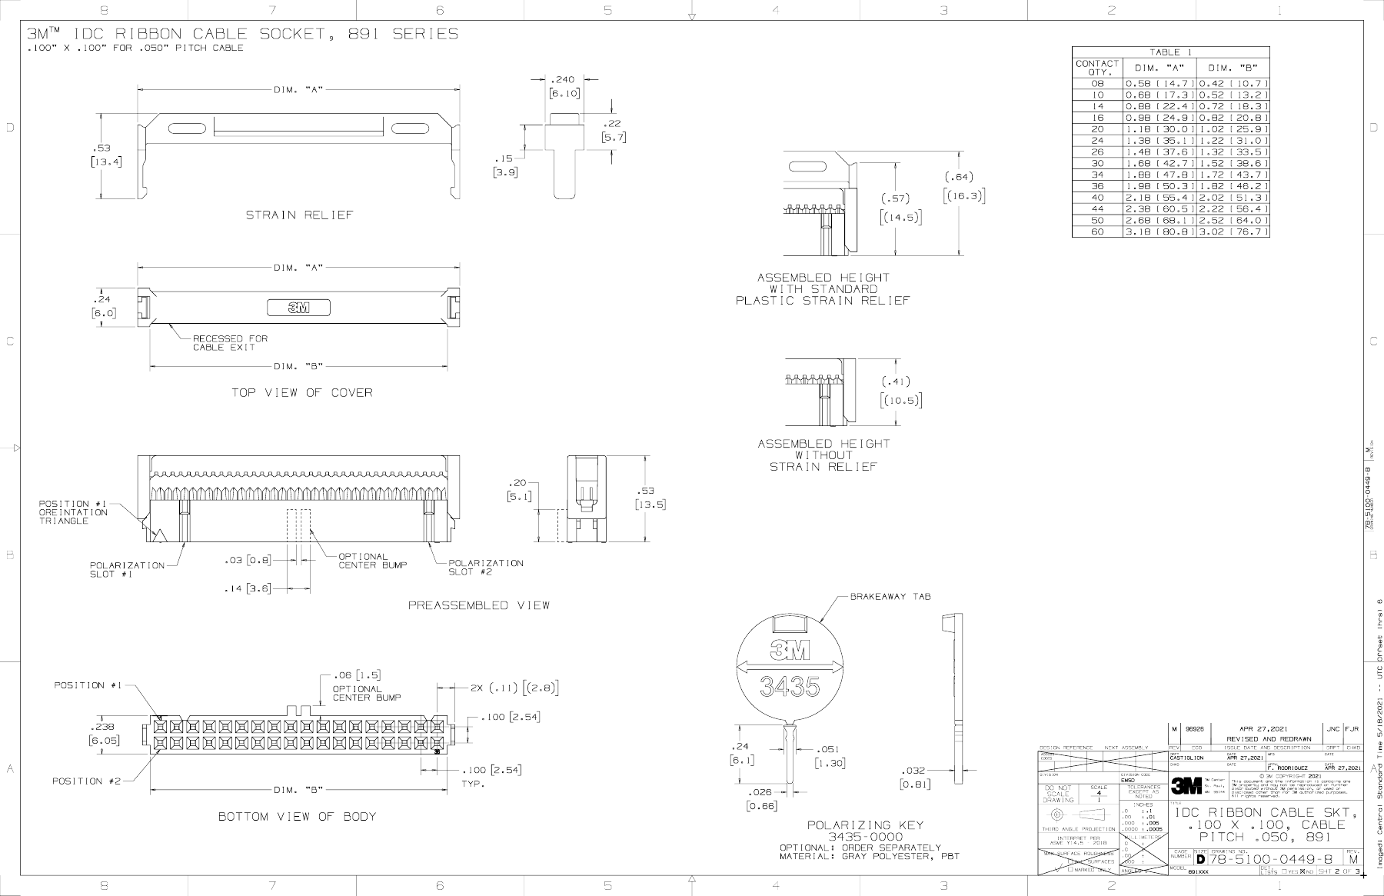
compact/reference/3m-891-p2.png
