alxgmpr/sierra-to-usb/compact/reference/ipex-1.png

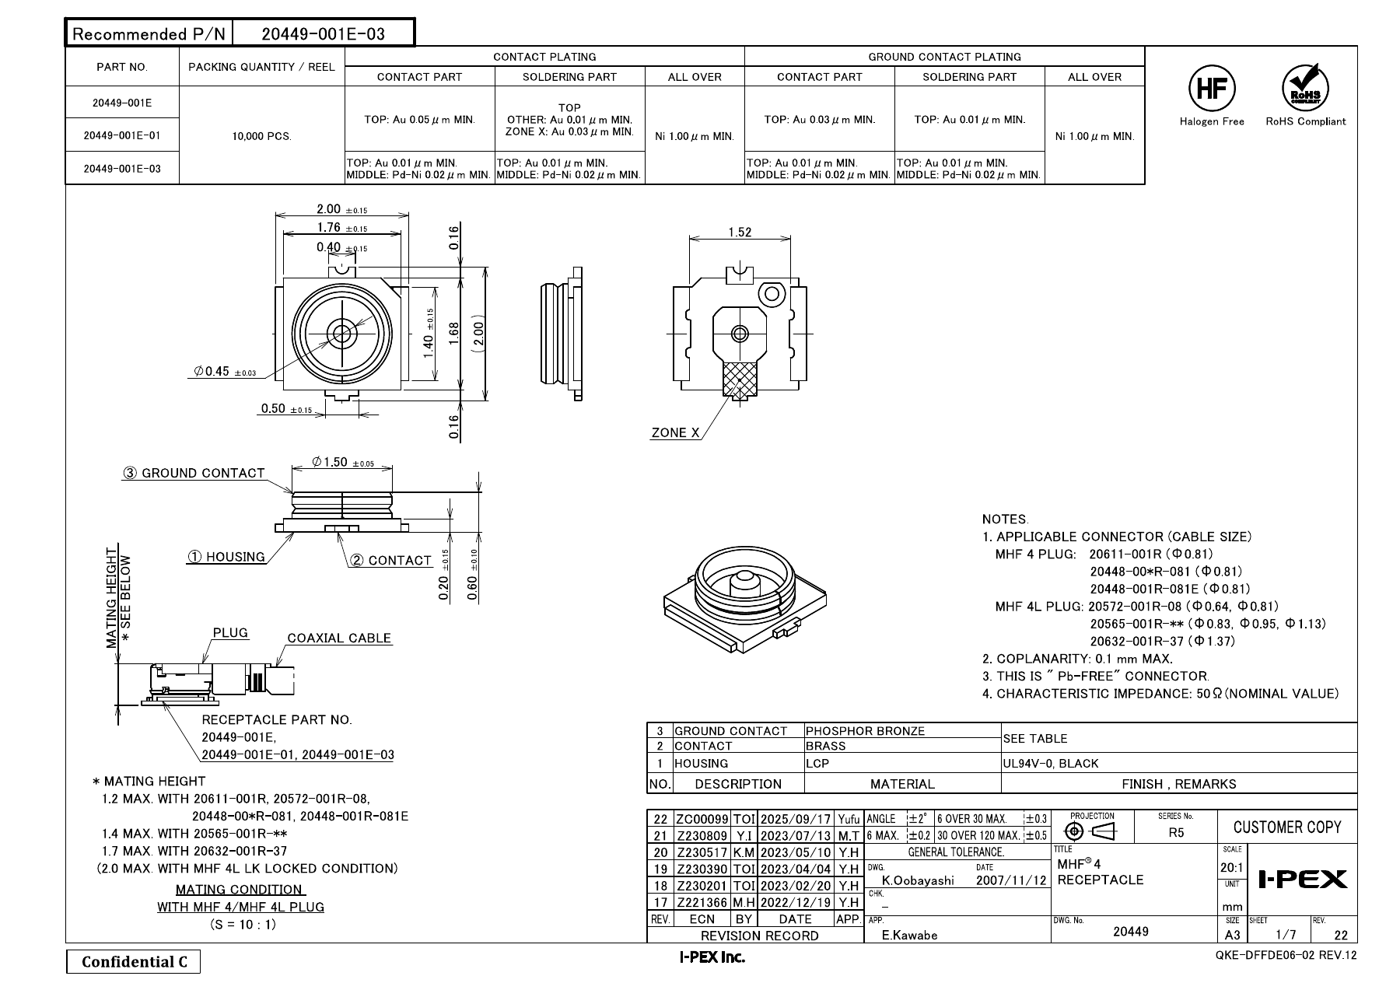
compact/reference/ipex-1.png
