alxgmpr/sierra-to-usb/compact/reference/ipex-3.png

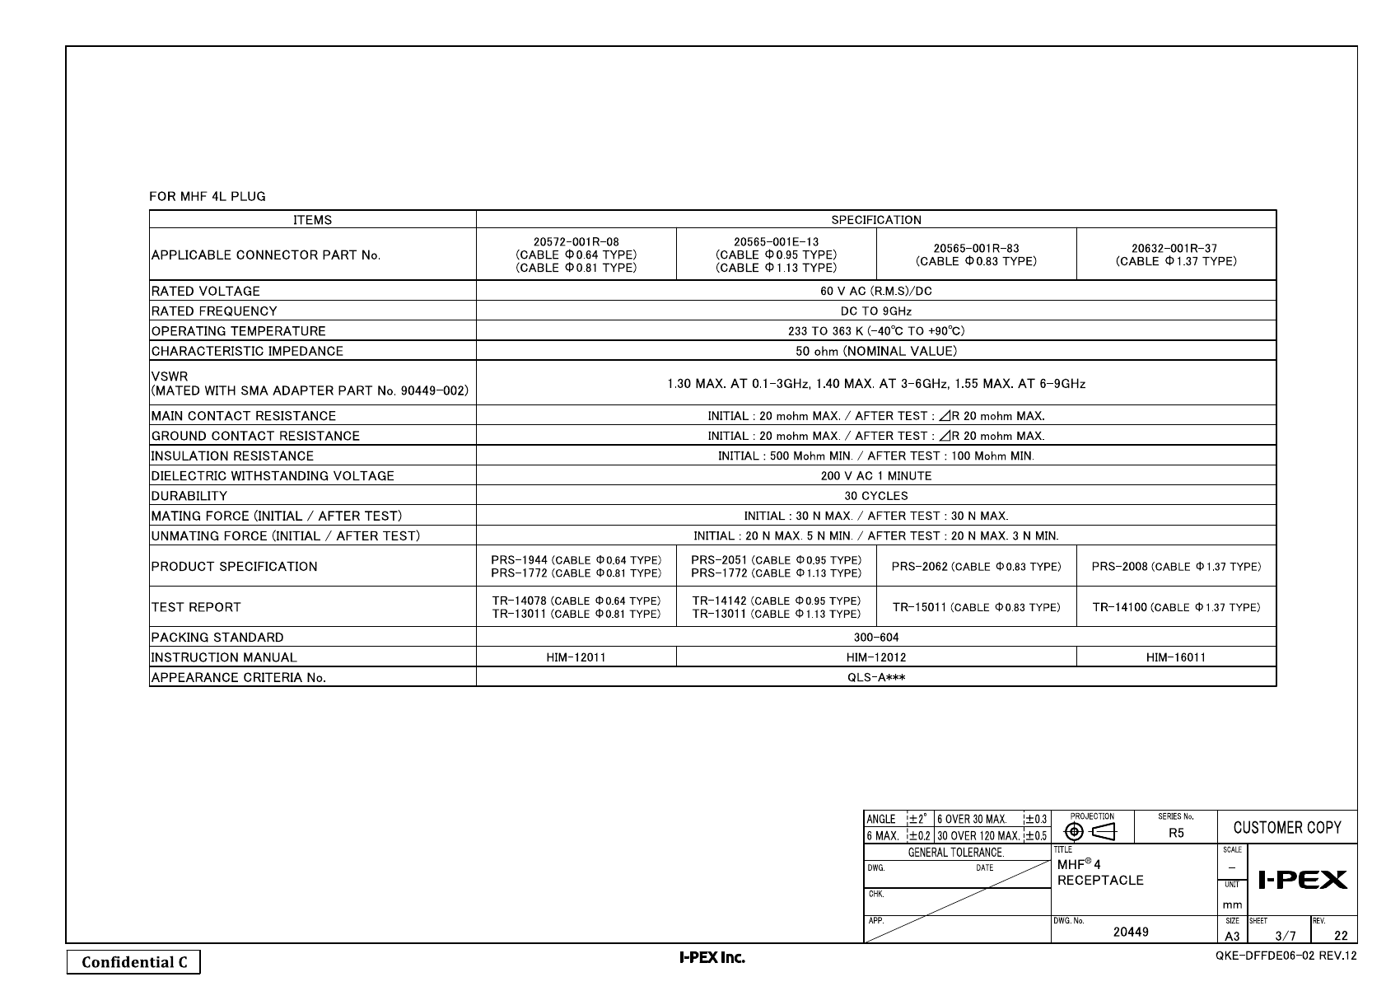
compact/reference/ipex-3.png
