alxgmpr/sierra-to-usb/compact/reference/ipex-5.png

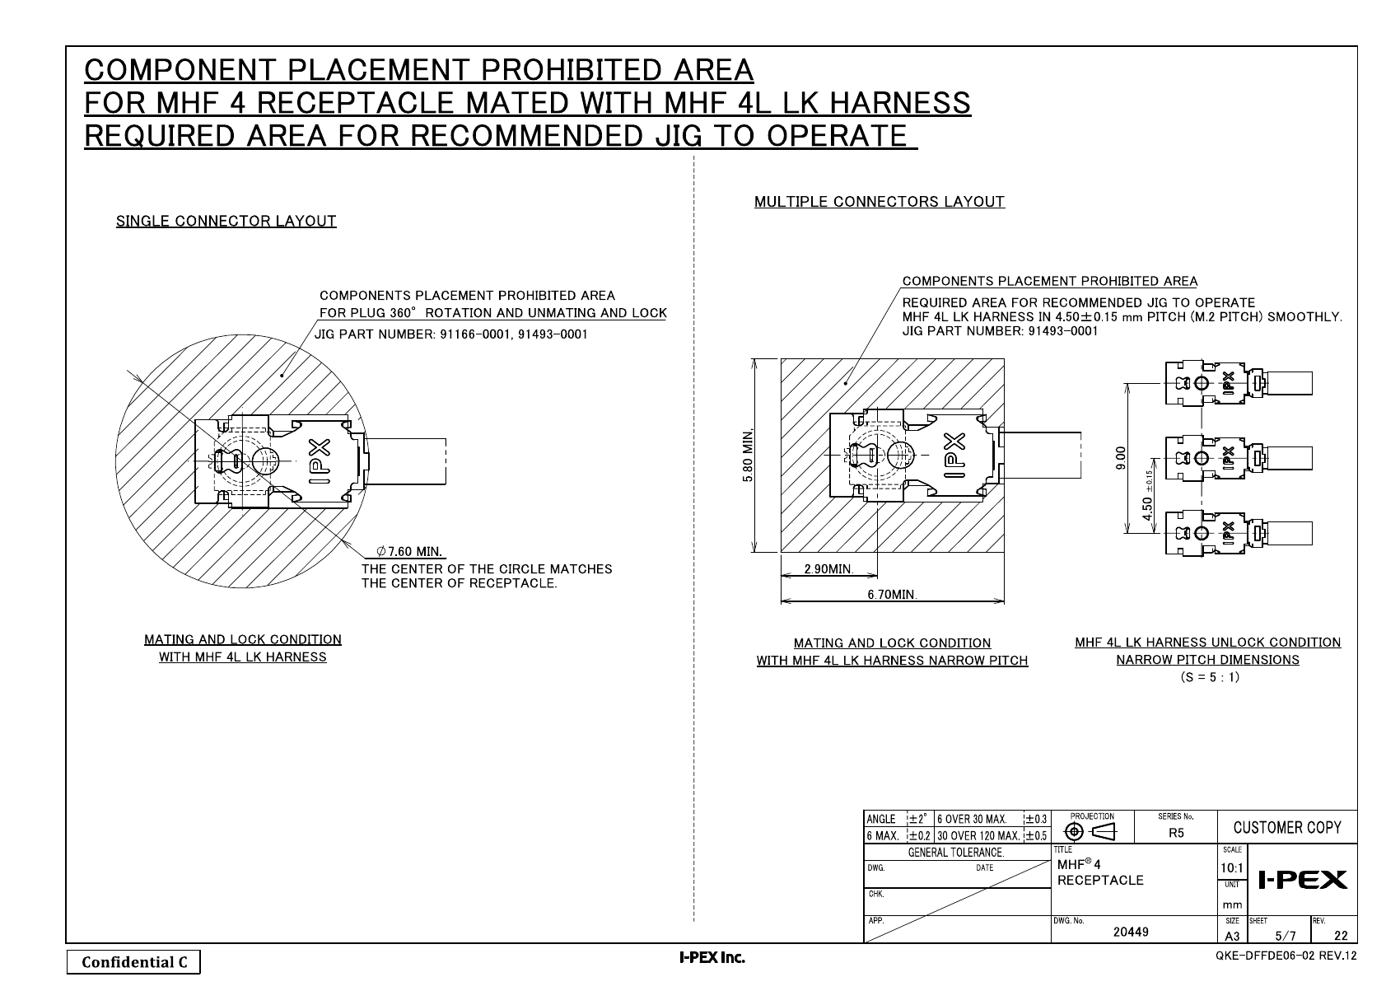
compact/reference/ipex-5.png
