alxgmpr/sierra-to-usb/compact/reference/ipex-land-detail.png

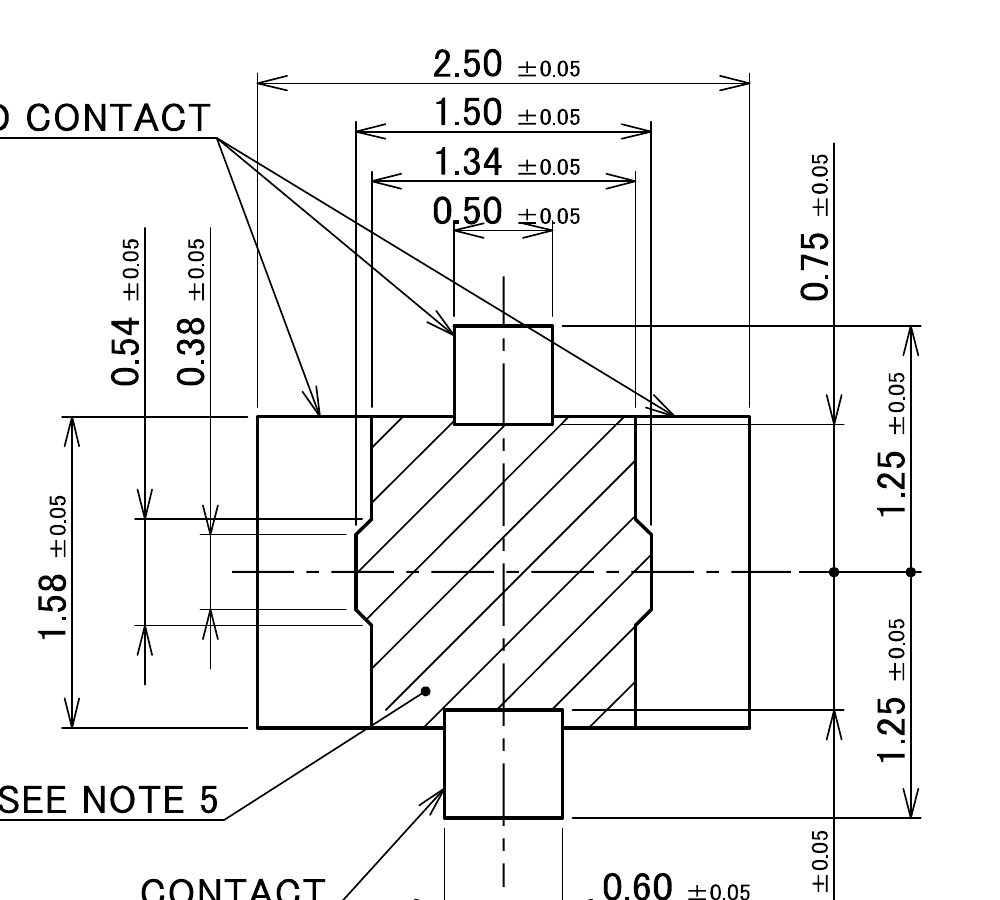
compact/reference/ipex-land-detail.png
