alxgmpr/sierra-to-usb/compact/reference/kemet-land.png

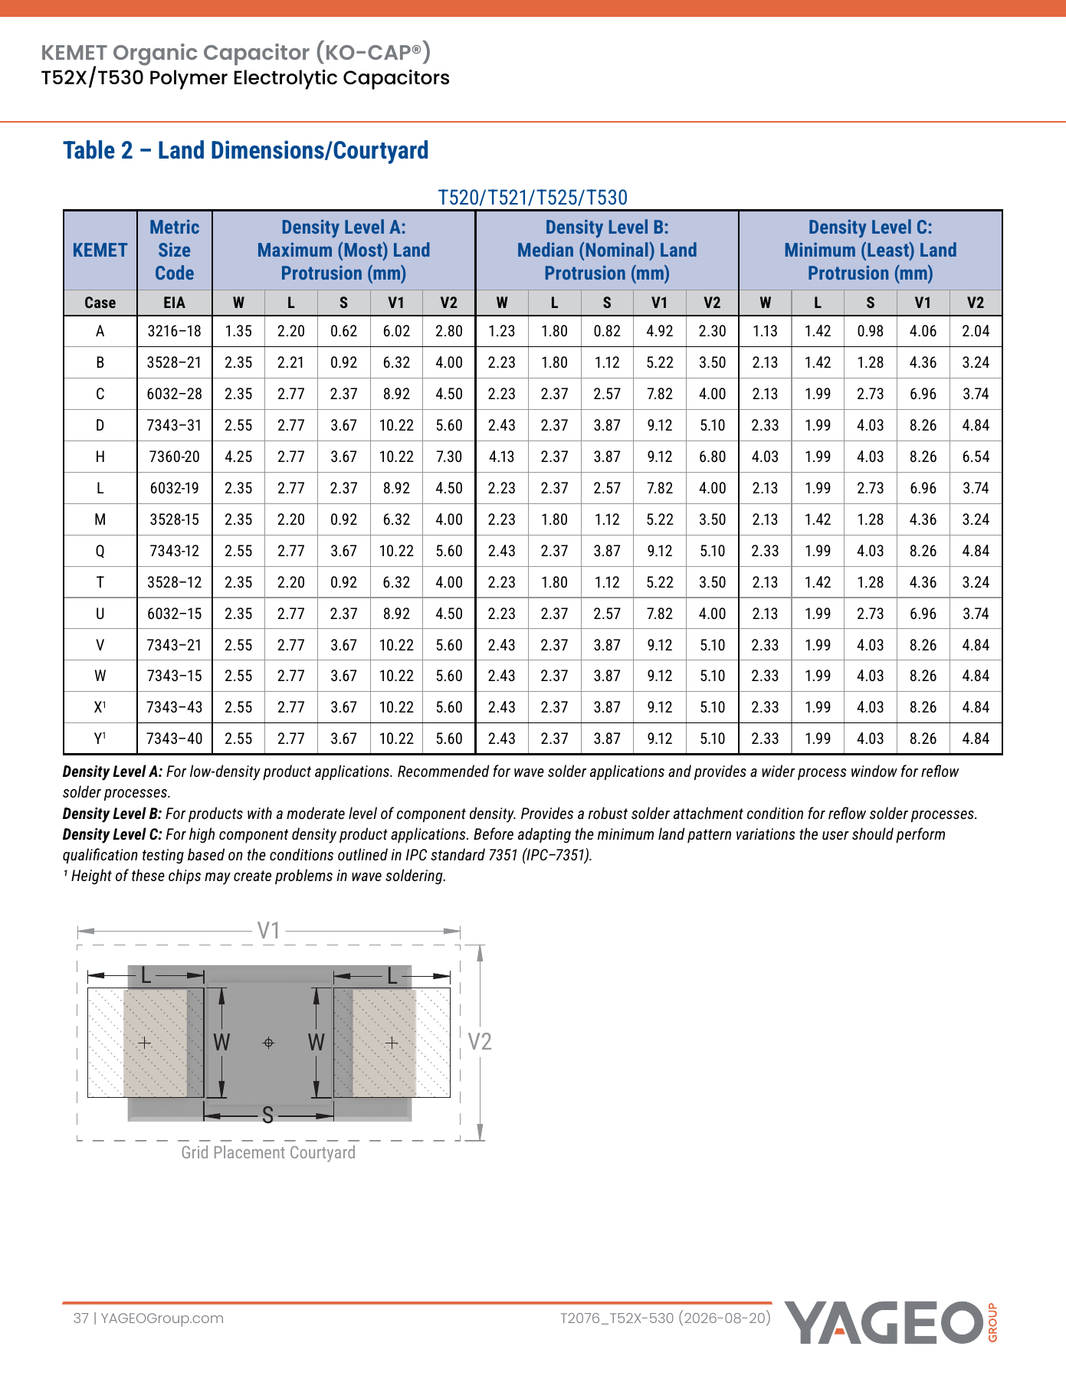
compact/reference/kemet-land.png
