alxgmpr/sierra-to-usb/compact/reference/lotes-1.png

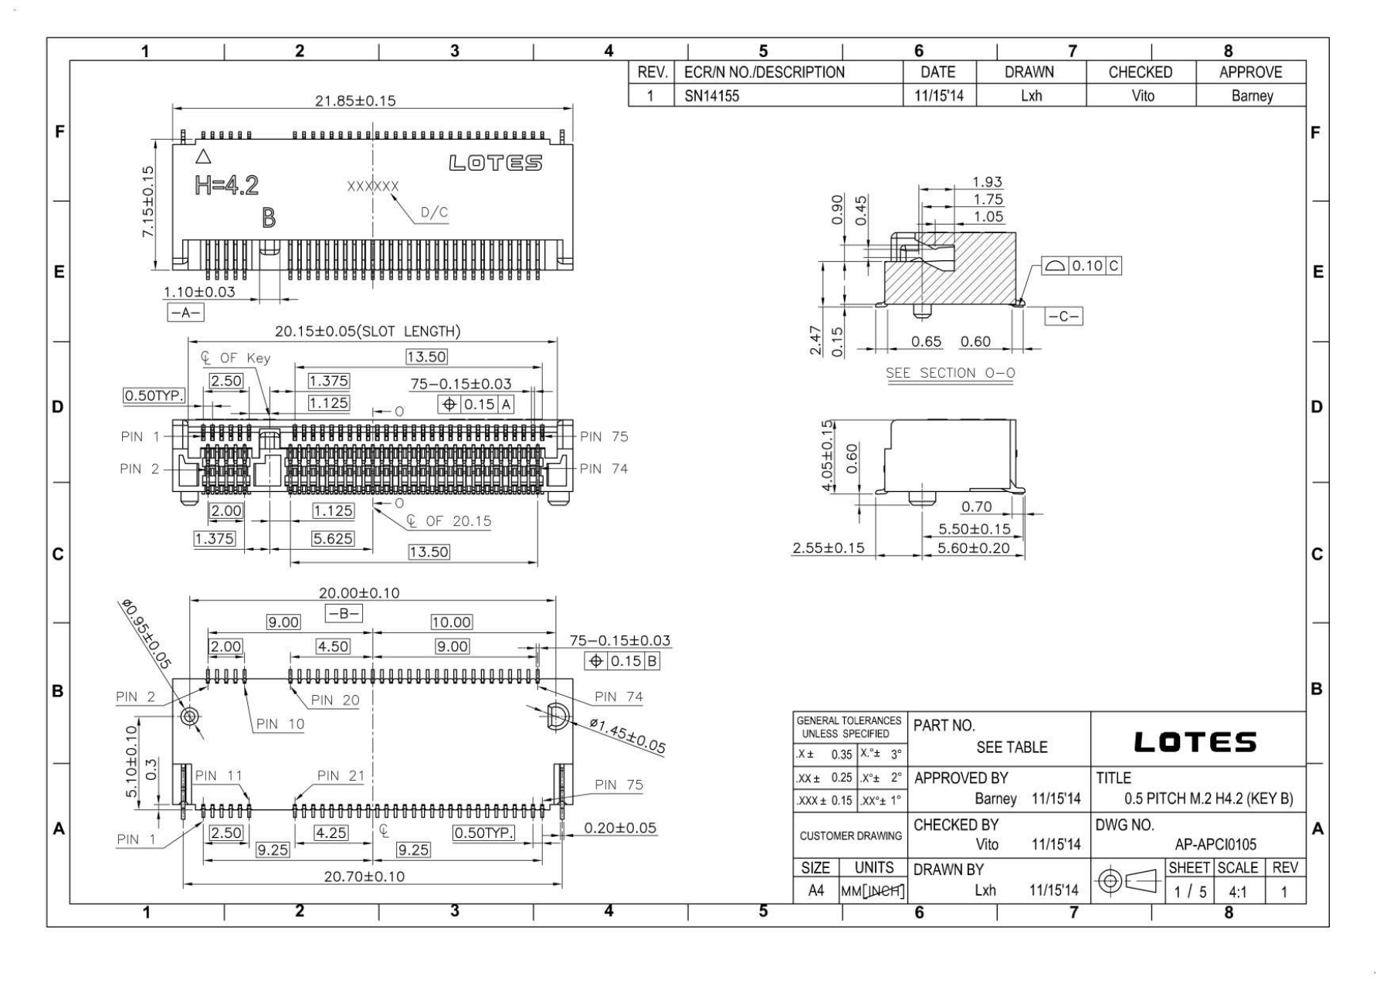
compact/reference/lotes-1.png
