alxgmpr/sierra-to-usb/compact/reference/lotes-3.png

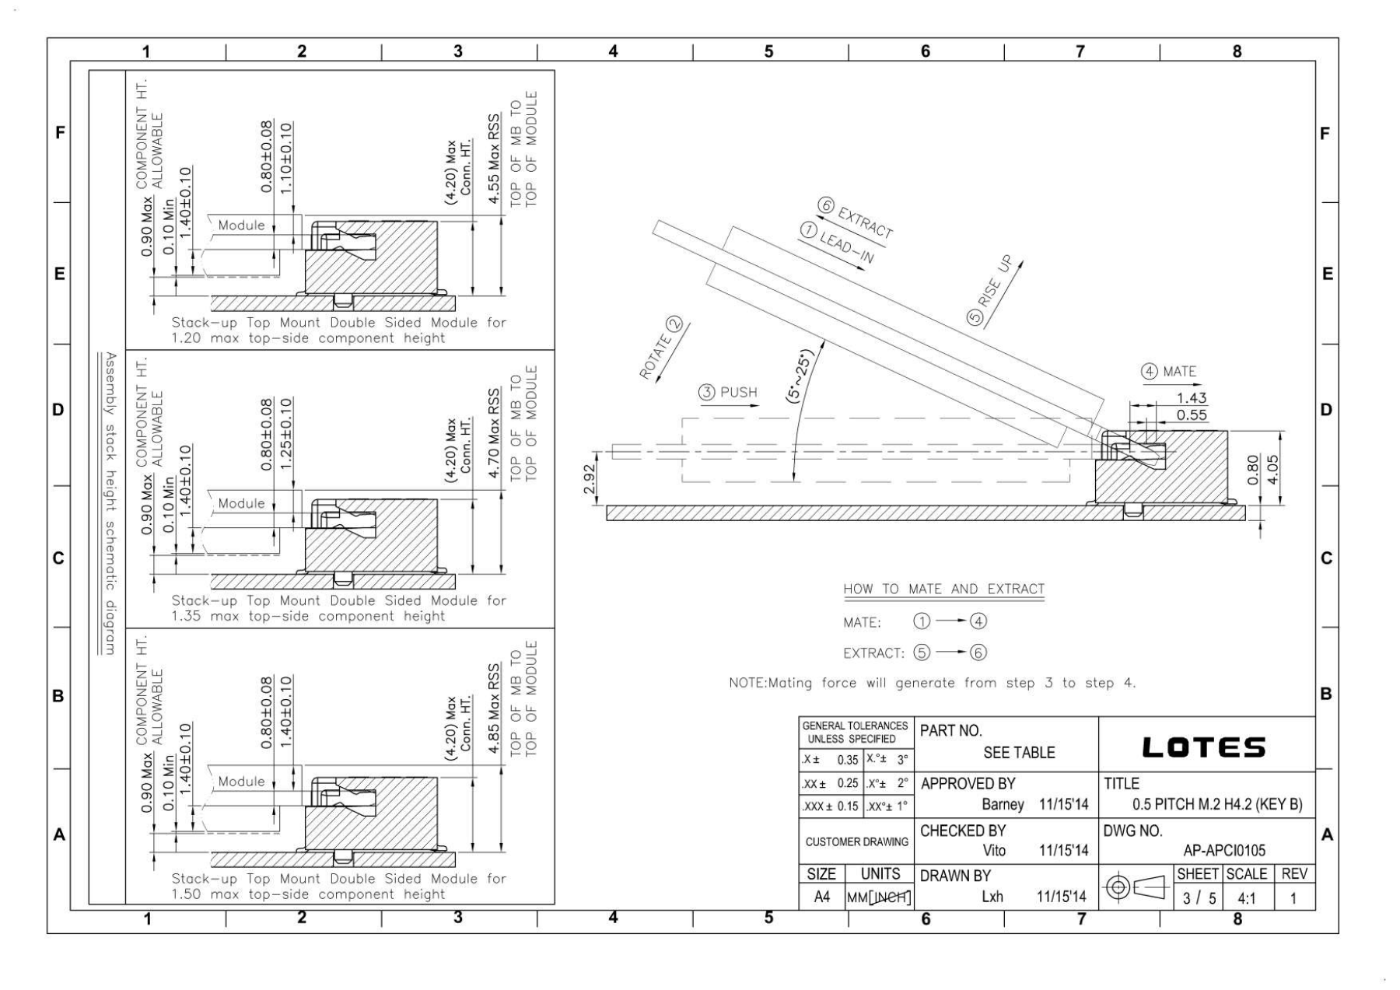
compact/reference/lotes-3.png
