alxgmpr/sierra-to-usb/compact/reference/lotes-4.png

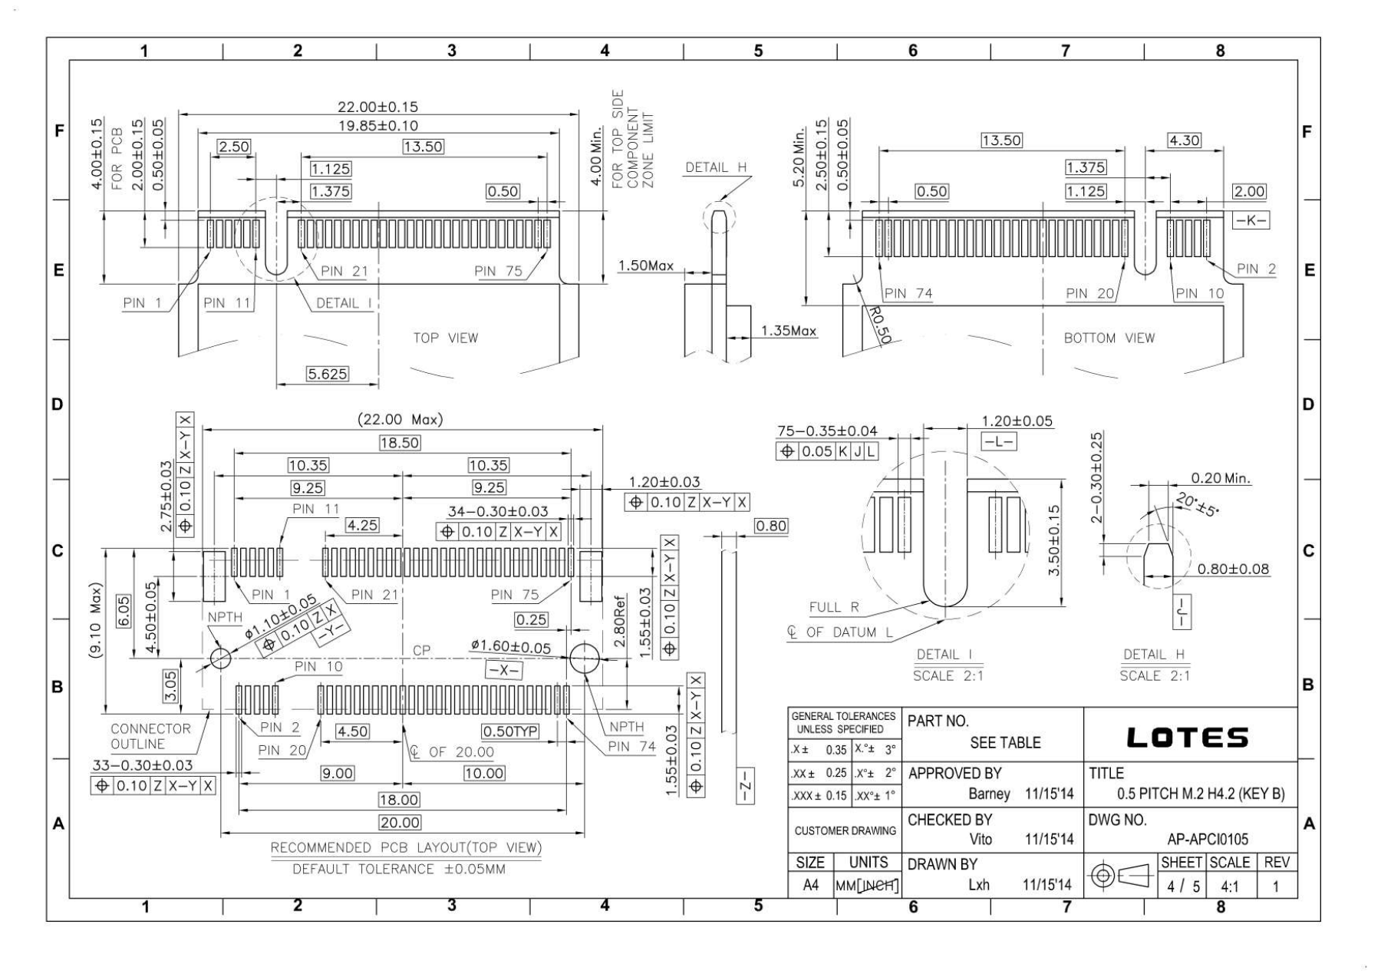
compact/reference/lotes-4.png
