alxgmpr/sierra-to-usb/compact/reference/mdt420-p1.png

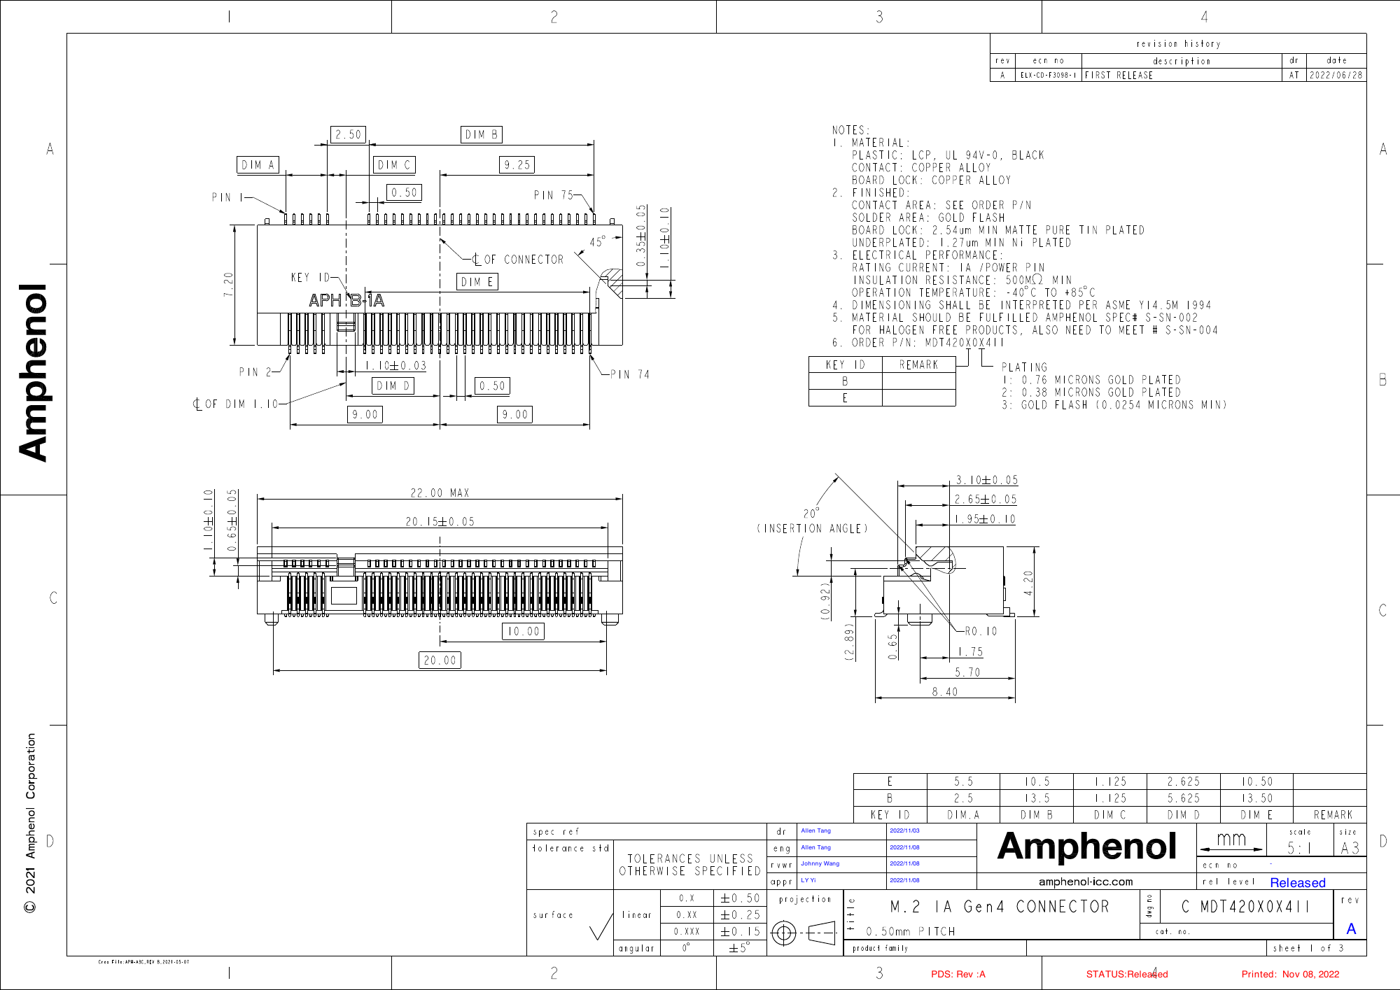
compact/reference/mdt420-p1.png
