alxgmpr/sierra-to-usb/compact/reference/mdt420-section-detail.png

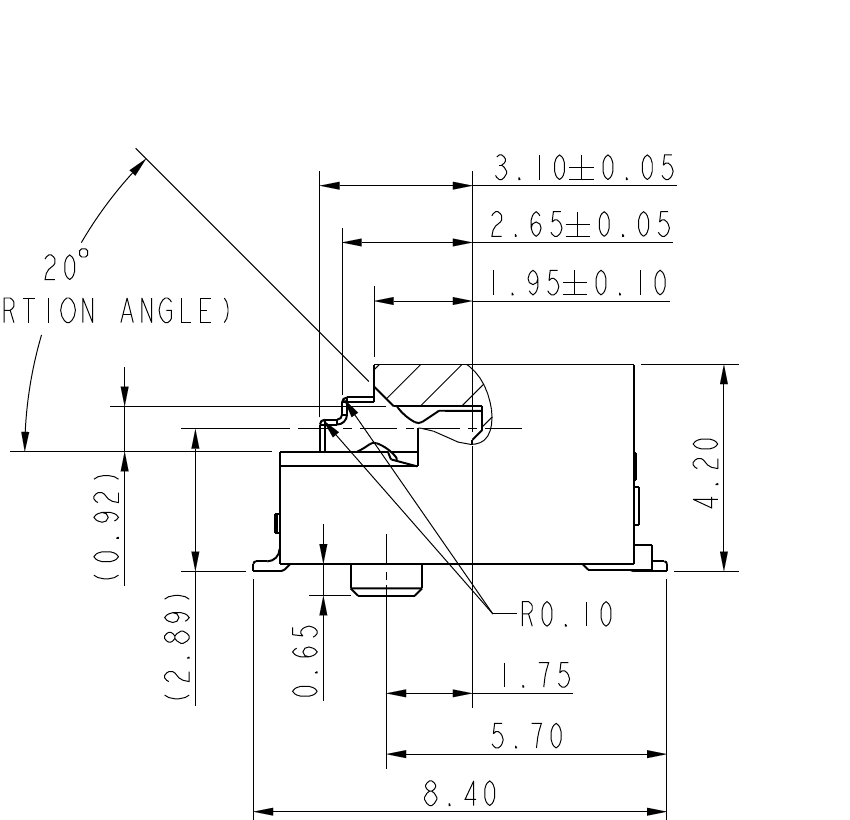
compact/reference/mdt420-section-detail.png
