alxgmpr/sierra-to-usb/compact/reference/mdt-3.png

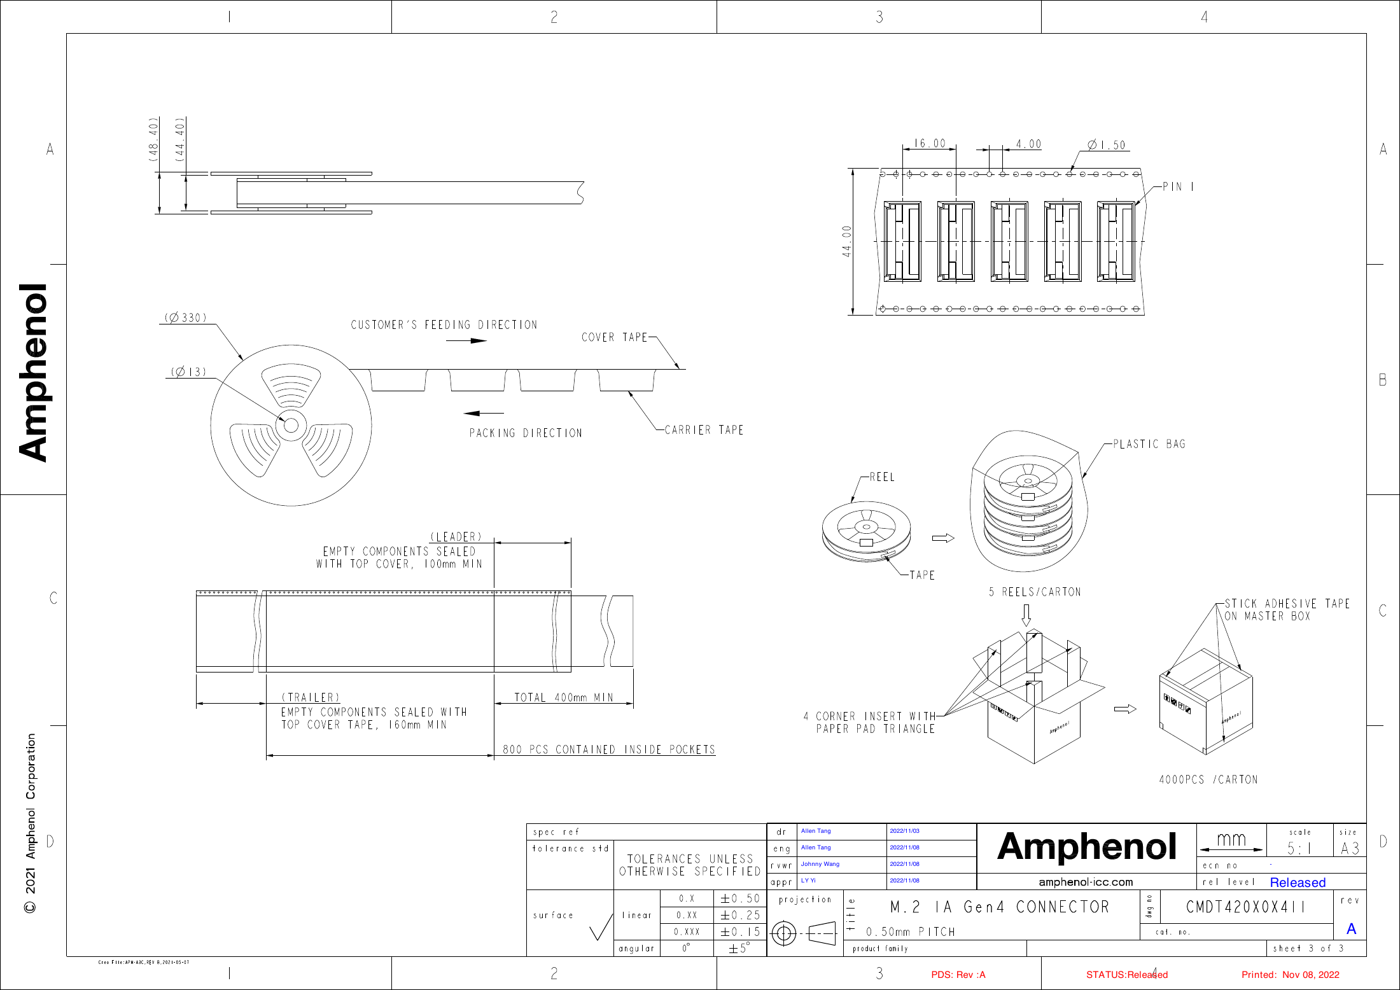
compact/reference/mdt-3.png
