alxgmpr/sierra-to-usb/compact/reference/mdt-land-detail.png

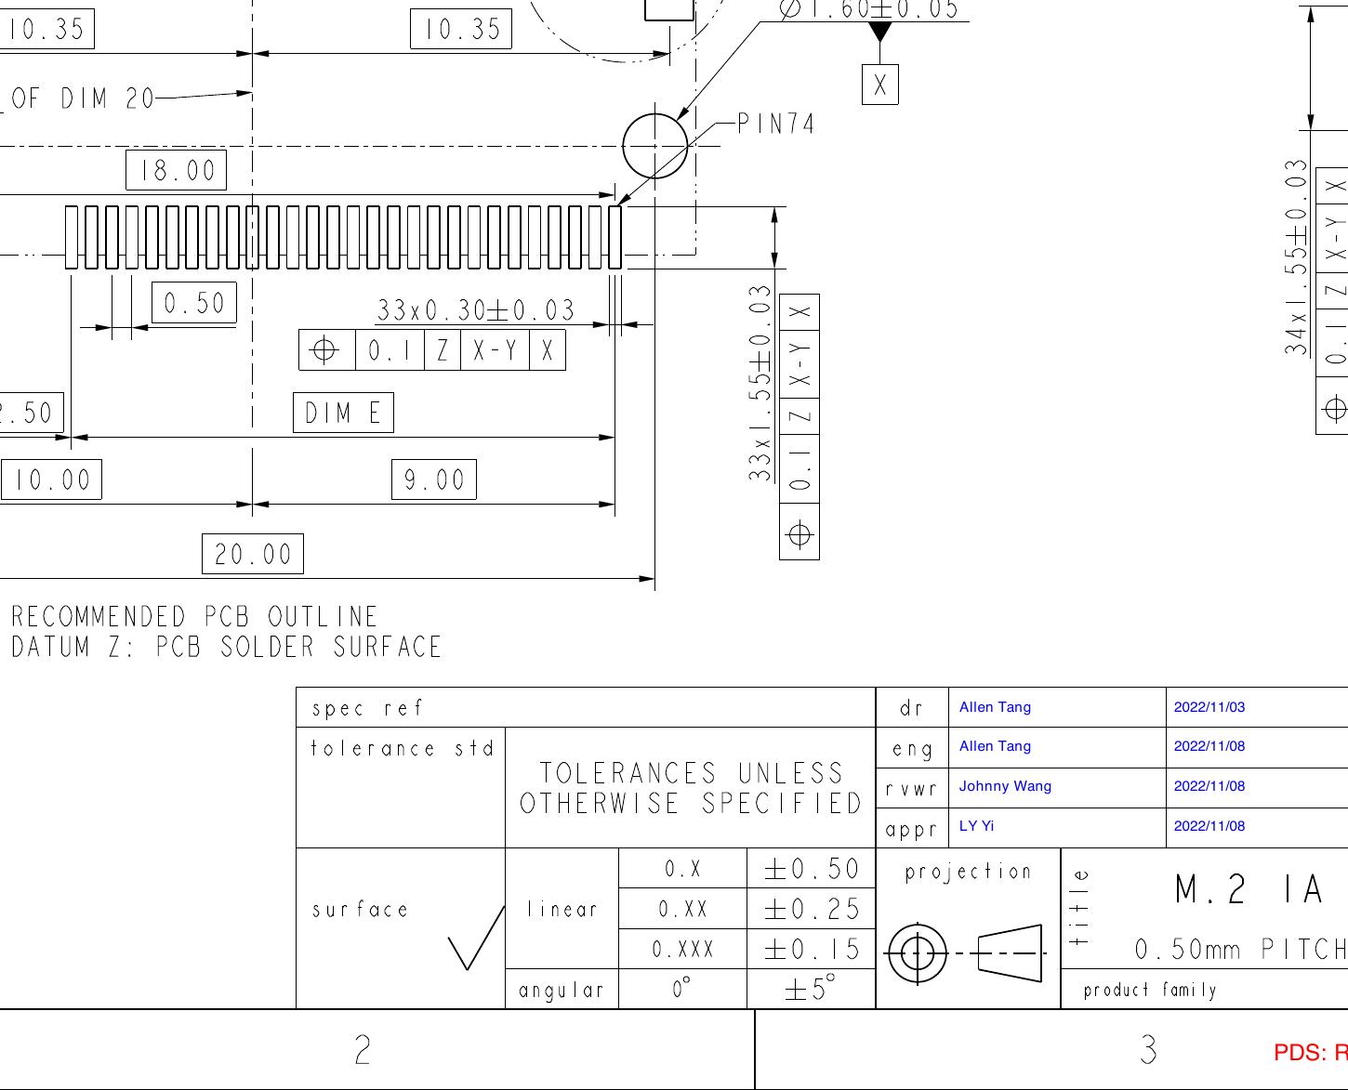
compact/reference/mdt-land-detail.png
