alxgmpr/sierra-to-usb/compact/reference/rm520-outline.png

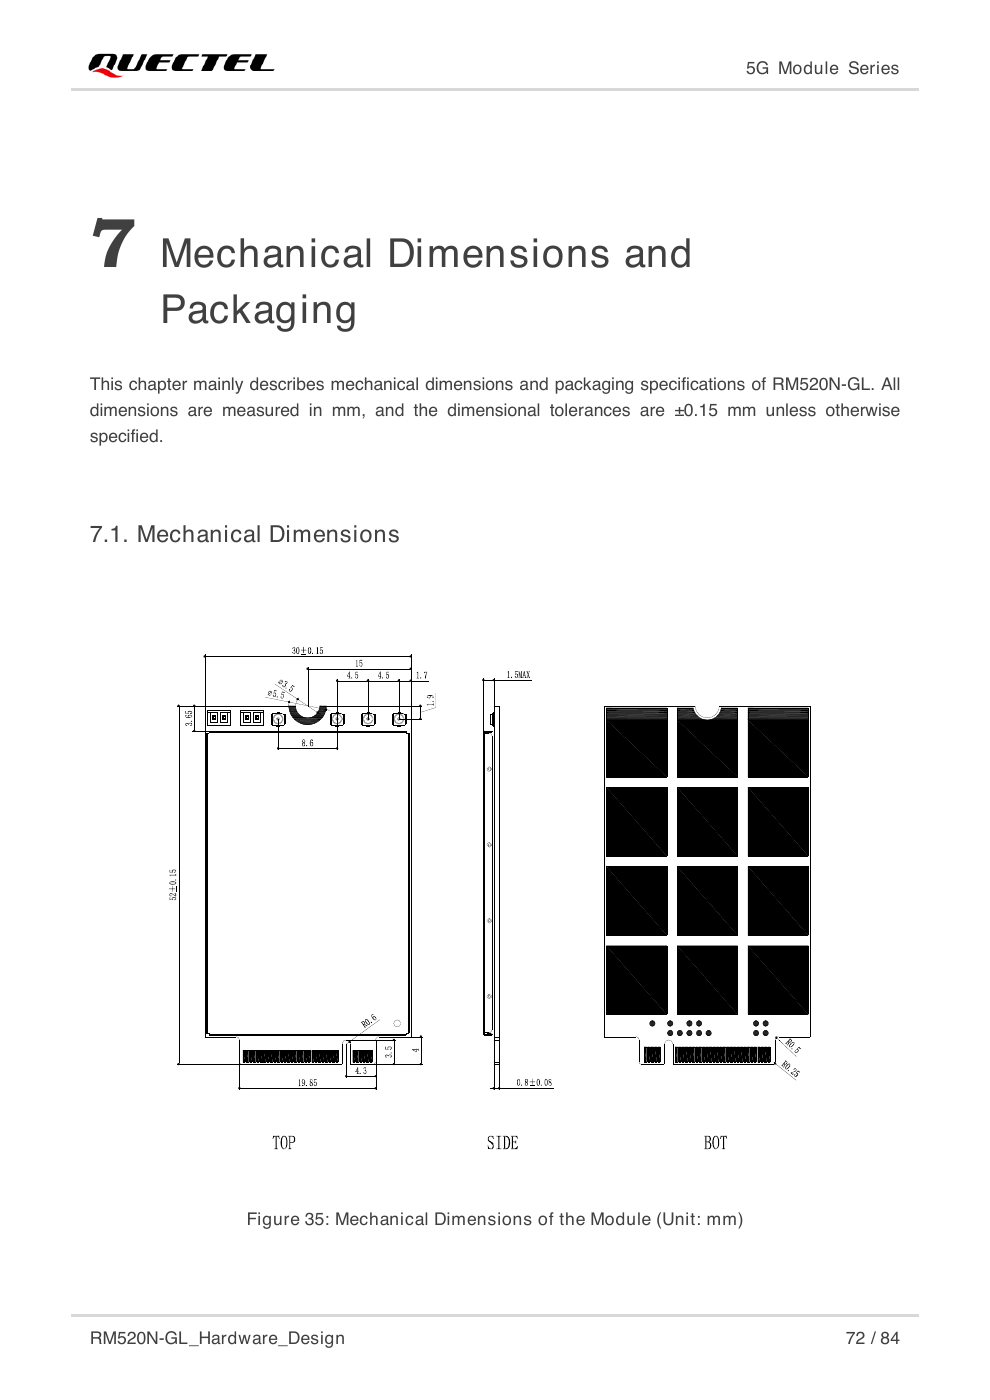
compact/reference/rm520-outline.png
