alxgmpr/sierra-to-usb/compact/reference/wurth-spacer.png

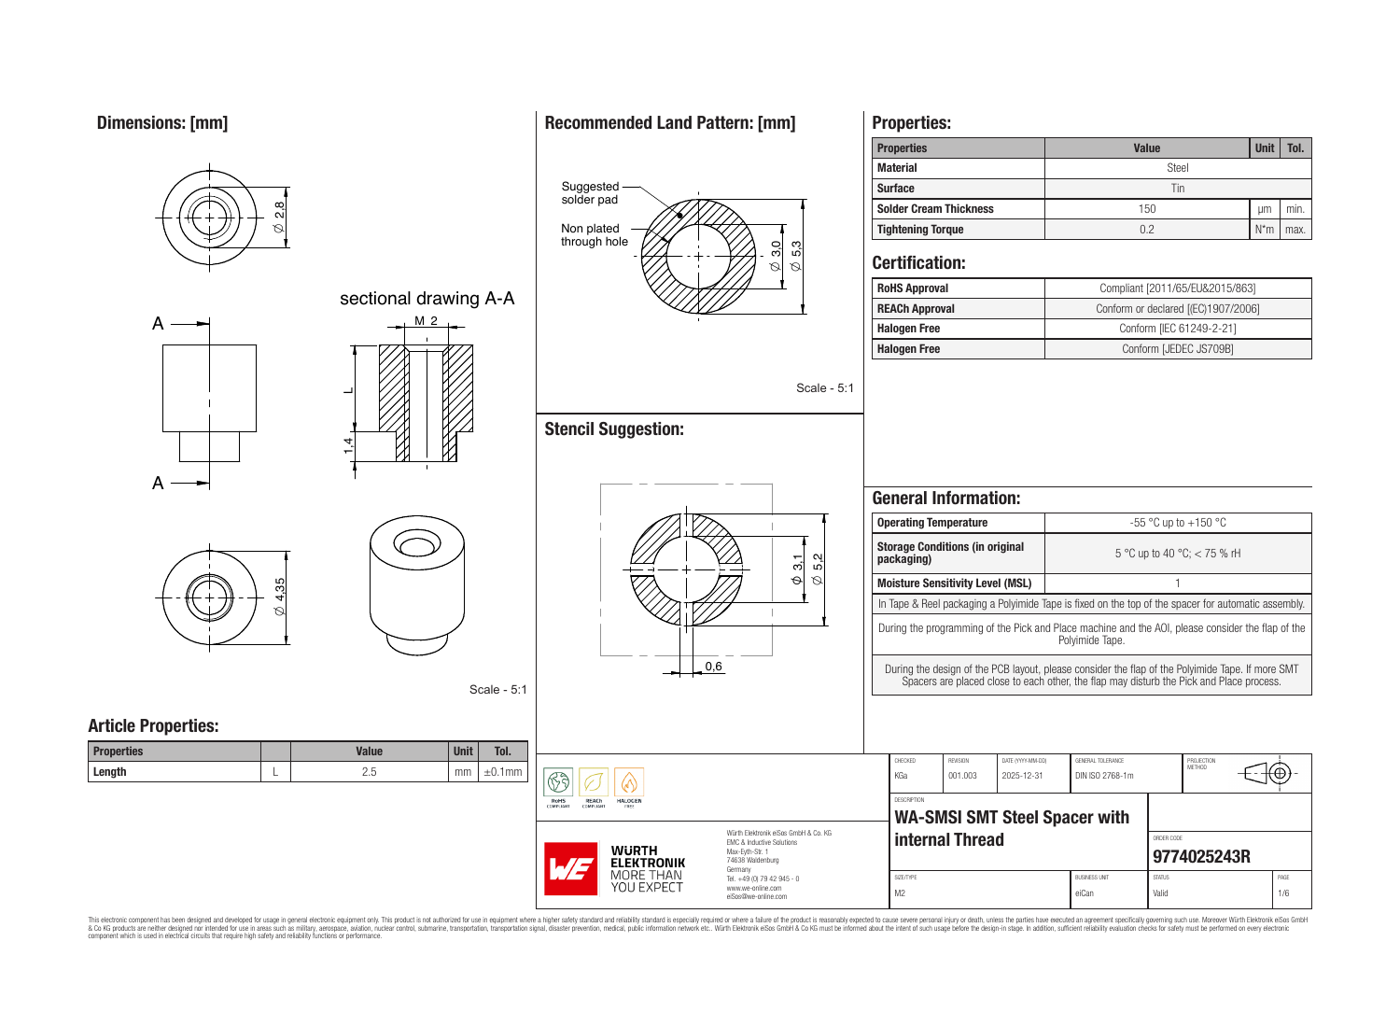
compact/reference/wurth-spacer.png
