alxgmpr/sierra-to-usb/compact/reference/xknano-drawing.png

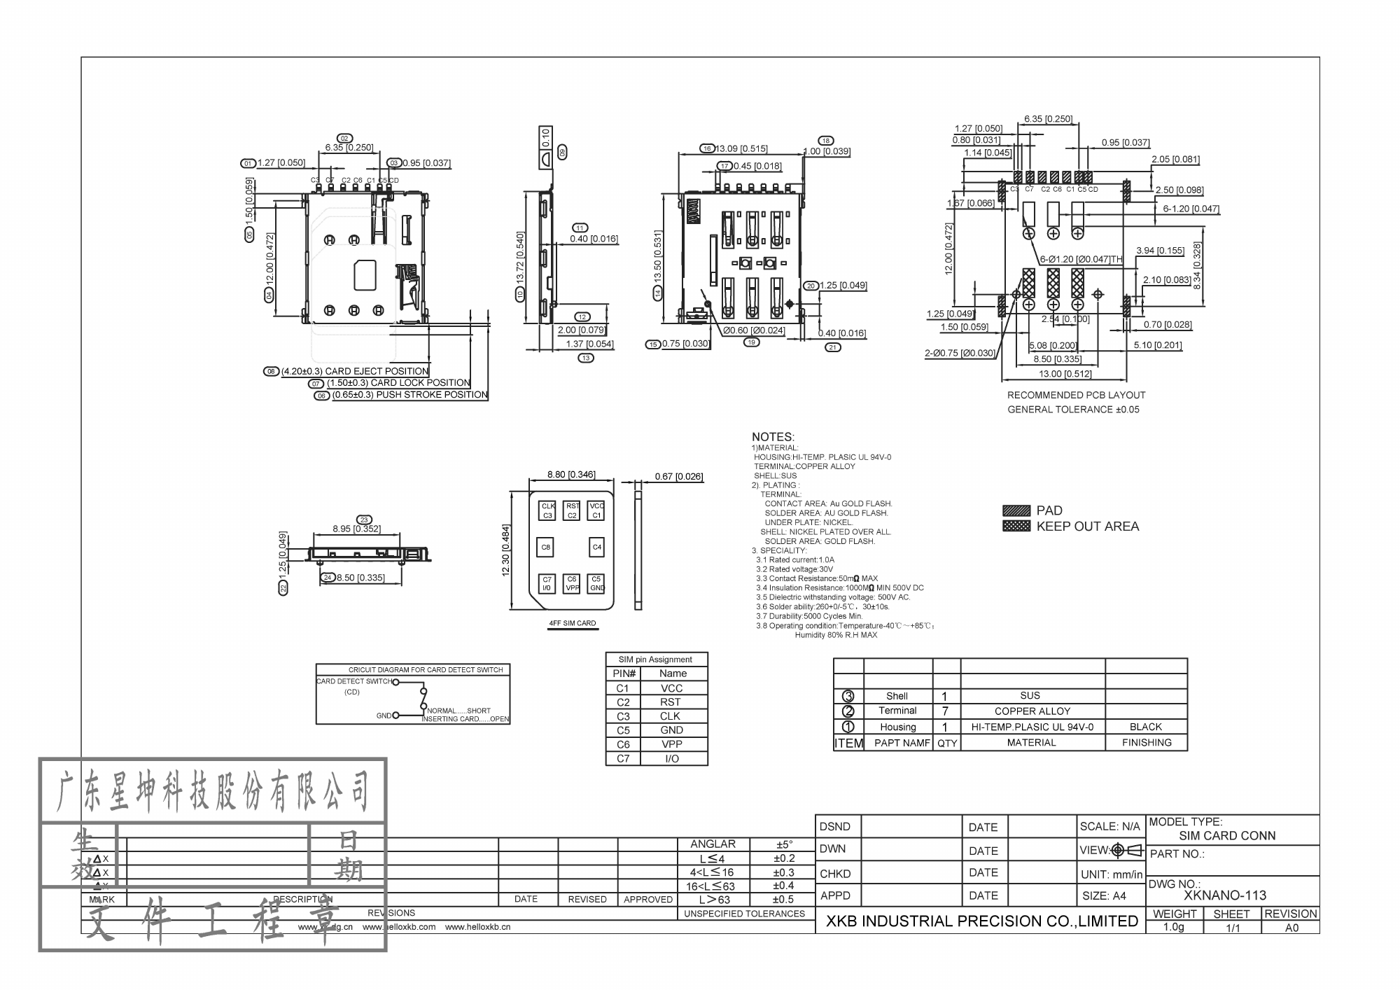
compact/reference/xknano-drawing.png
