alxgmpr/sierra-to-usb/compact/review/sierra-pin-footnote.png

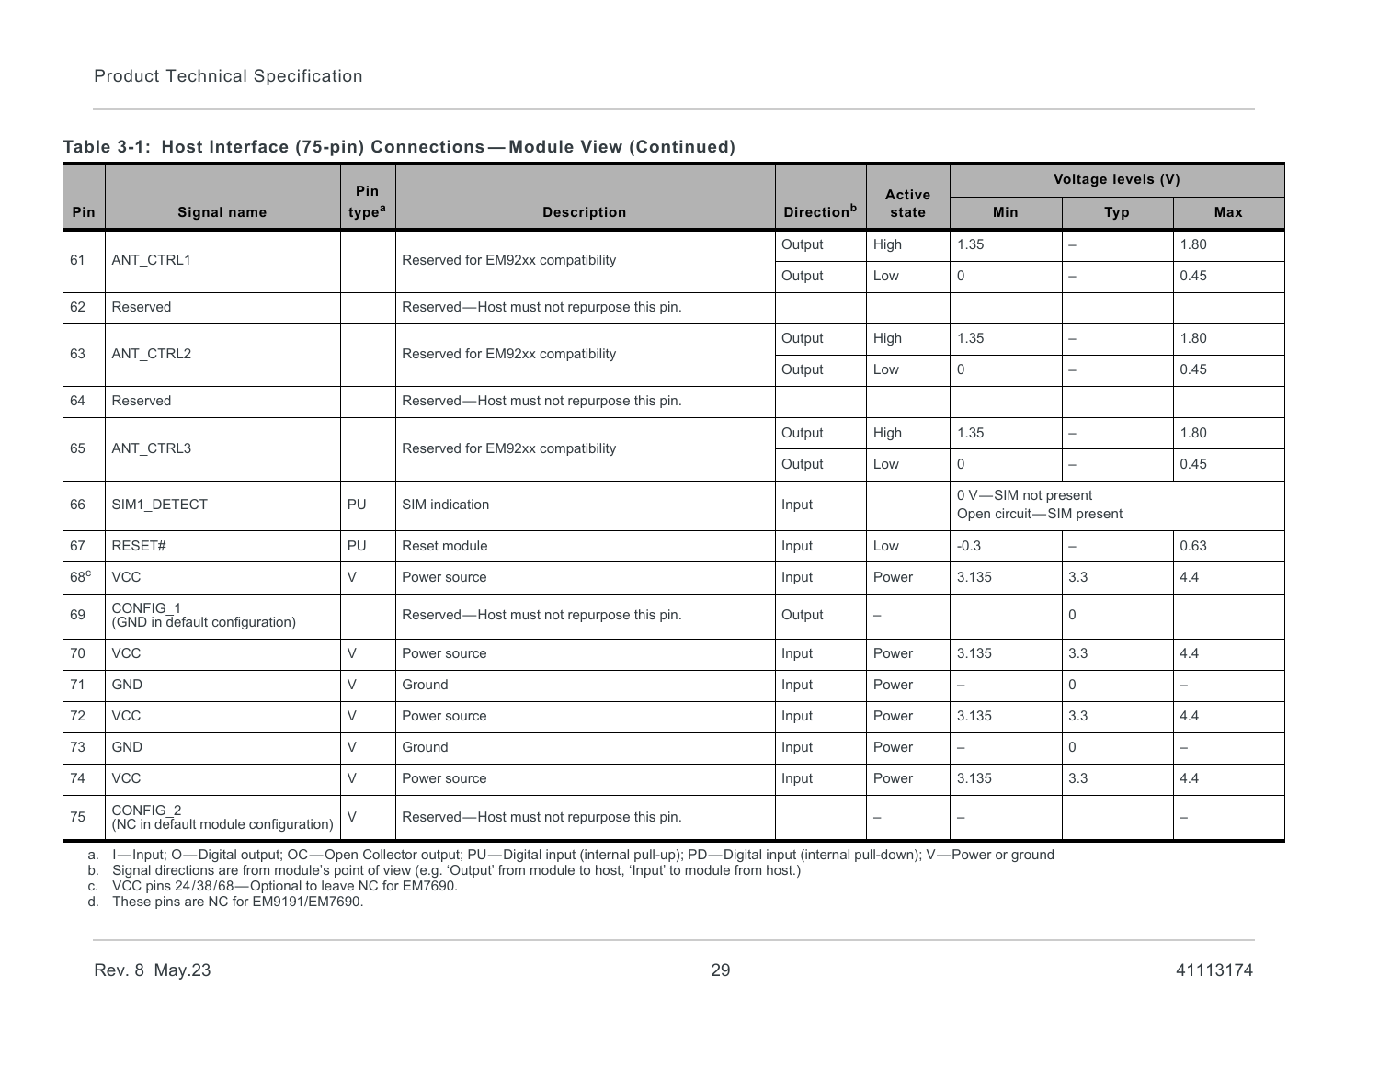
compact/review/sierra-pin-footnote.png
