alxgmpr/sierra-to-usb/docs/pinout-control-differences.png

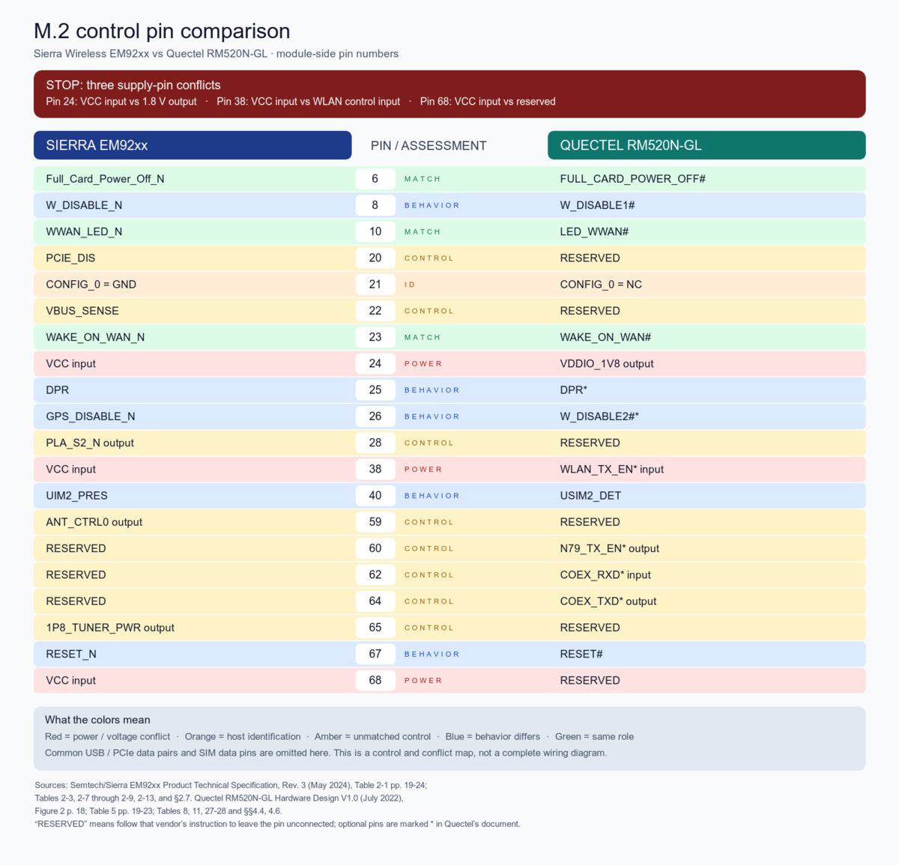
docs/pinout-control-differences.png
