alxgmpr/sierra-to-usb/hardware/reference/xgl4030-dimensions.gif

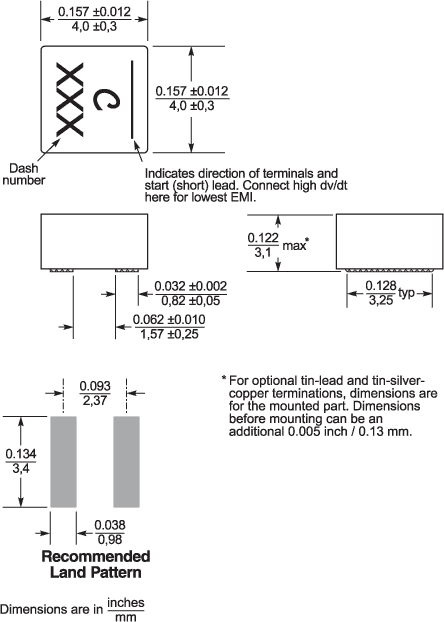
hardware/reference/xgl4030-dimensions.gif
