alxgmpr/sierra-to-usb/hardware/review/2026-10-21/model-envelope-review.png

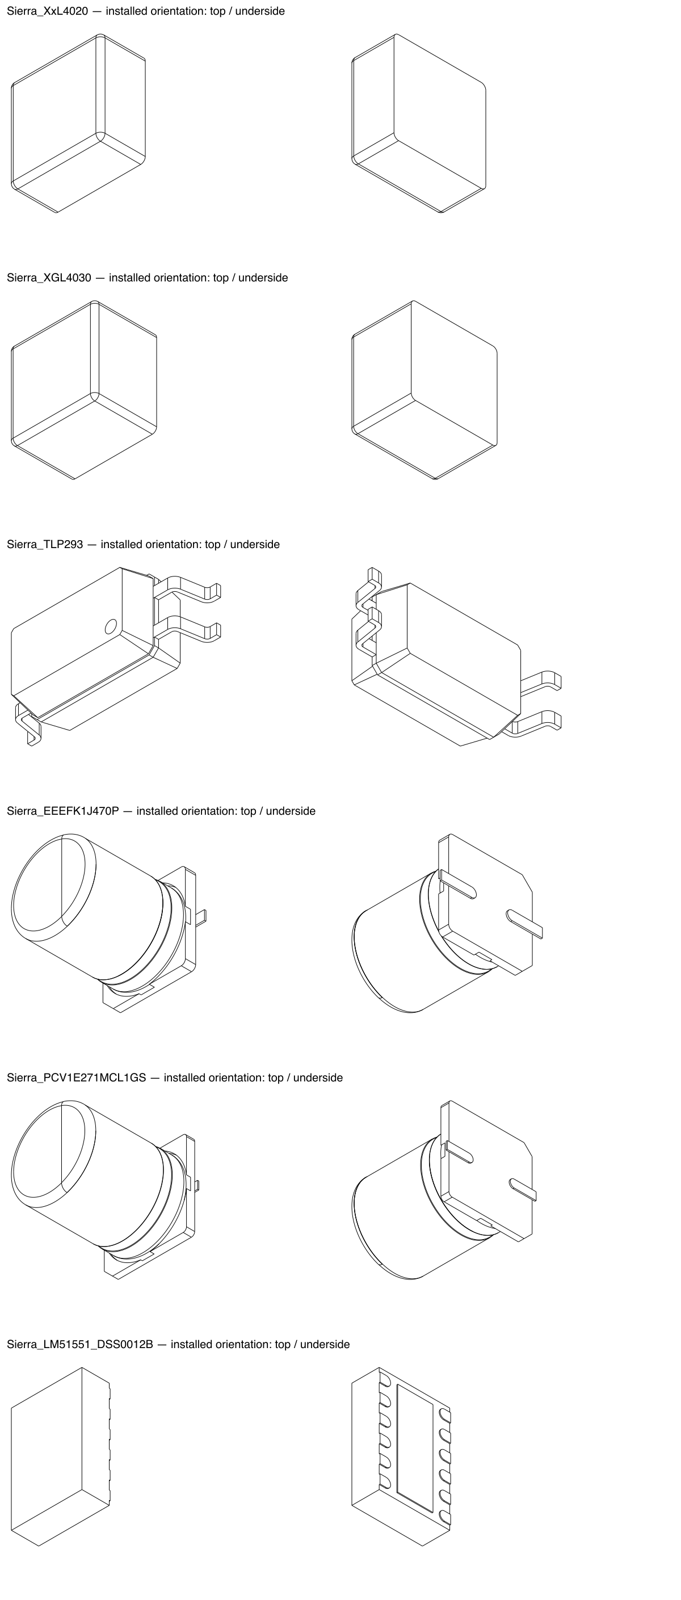
hardware/review/2026-10-21/model-envelope-review.png
