alxgmpr/sierra-to-usb/hardware/review/2026-10-21/Sierra_Micron_ZW_TFBGA200-model.png

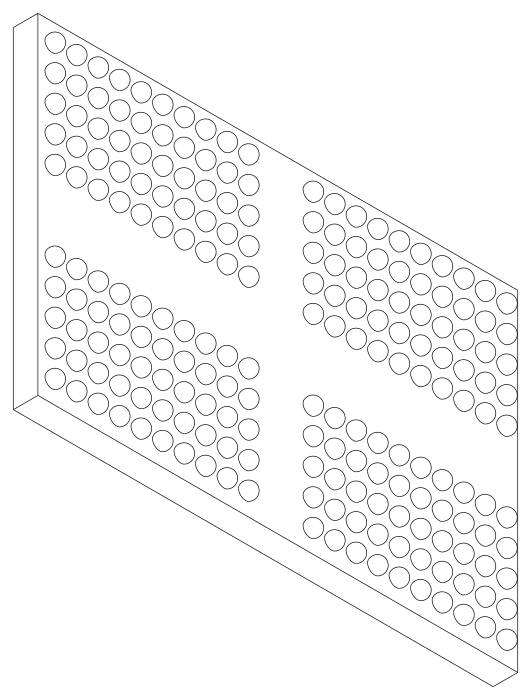
hardware/review/2026-10-21/Sierra_Micron_ZW_TFBGA200-model.png
