alxgmpr/sierra-to-usb/hardware/review/2026-10-21/Sierra_RK3566_BGA565-model.png

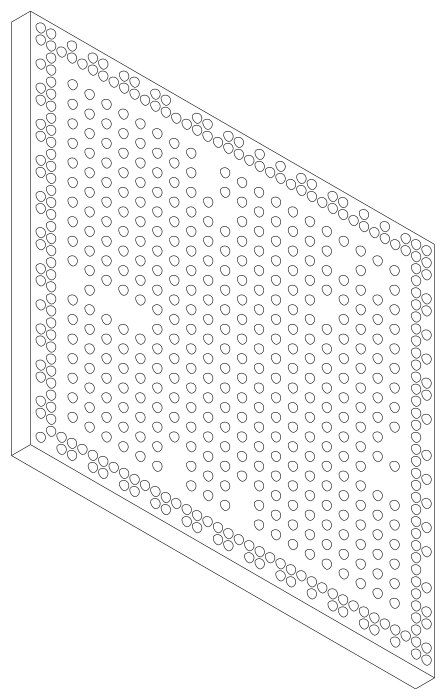
hardware/review/2026-10-21/Sierra_RK3566_BGA565-model.png
