alxgmpr/sierra-to-usb/hardware/review/2026-10-21/TPS56837-paste-only.png

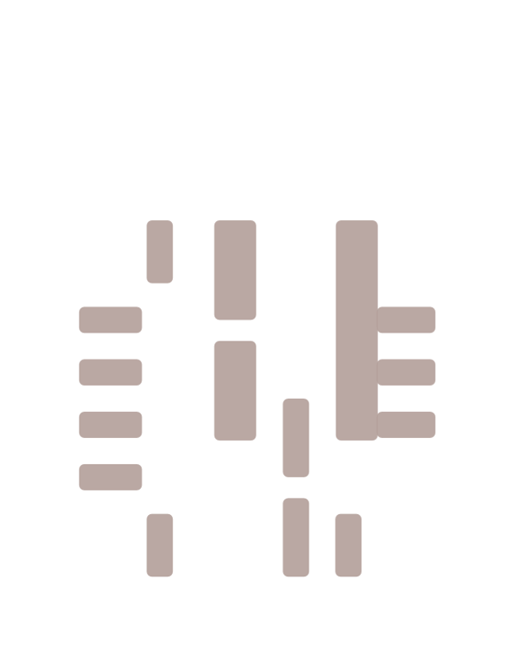
hardware/review/2026-10-21/TPS56837-paste-only.png
