alxgmpr/sierra-to-usb/docs/sourcing.md

> Historical evidence from superseded designs. See the [current full adapter](../full-adapter/README.md). Circuit status and artifact paths below refer to the historical checkpoint, not the replacement.

# Sourcing — pinned gate parts (Task 1)

**Date checked:** 2026-07-14. All stock/price figures are snapshots (LCSC live pages / jlcsearch API mirror / DigiKey product pages fetched that day) — **re-verify at order time**, especially anything flagged low-stock. LCSC "C" numbers below were read from real LCSC listings, not inferred. Price class: `$` <0.50, `$$` 0.50–2, `$$$` 2–10 per unit at qty 1.

**Gate result: NOT blocked.** A 2.5G+PoE magjack is obtainable (Bel 2250504-1, live stock seen at DigiKey — §2 row 1), so the STOP condition in the plan does not trigger.

## 1. JLC-assembled parts (MUST be LCSC)

| Part / function | MPN | Package | Distributor | LCSC # | Price class | Stock note (2026-07-14) |
|---|---|---|---|---|---|---|
| MCU | Raspberry Pi RP2040 | LQFN-56 (7×7) | LCSC | C2040 | $$ ($0.99@1 / $0.76@100) | 12,622 — confirmed live page. Don't confuse with RP2040-Zero *module* (C5350143). |
| QSPI flash | Winbond W25Q128JVSIQ | SOIC-8 208mil | LCSC | C97521 | $$$ ($2.64@1) | 23,976. Flagged as JLC **Basic** part via jlcsearch — reconfirm basic/extended in JLCPCB library at order. Cheaper extended listing C113767 (~$1.18, ~5.1k stock). |
| 2.5GbE NIC | Realtek RTL8125BG-CG | **QFN-48-EP (6×6)** | LCSC | C3013605 | $$$ ($4.44@1 / $2.93@100) | 4,662 (re-verified 2026-07-15: 4,764, $4.4384@1). Confirm KiCad footprint against QFN-48. **Variant decision (2026-07-15 ethernet fix pass): RTL8125BGS-CG (internal 0.95 V SWR, true single-3.3 V part) is NOT obtainable** — zero LCSC listings (jlcsearch + LCSC search), zero DigiKey/authorized-distributor stock (oemstrade aggregate: only gray-market brokers list it). BG variant kept; its required external 0.95 V core rail comes from a TLV62569DBVR buck (row in §2), EN driven by POW_EXT_SWR pin 6 per the Realtek reference V122 page-4 external-core-power module. |
| USB3 SS mux | TI HD3SS3220RNHR | WQFN-30-EP (2.5×4.5) | LCSC | C165155 | $$ ($1.89@1) | 2,387 — moderate stock, recheck at order. |
| USB2 2:1 mux | TI TS3USB221DRCR | VSON-10-EP (3×3) | LCSC | C324071 | $$ ($0.75@1) | 3,622. Alternates on LCSC: TS3USB221ARSER UQFN-10 1.5×2 (C128396, 5,855, $0.26); TS3USB221RSER (C130085, 2,117); TS3USB221ERSER (C129313, 3,292). **Pick DRC (VSON-10) for JLC assembly; RSE 1.5×2 UQFN is tiny but also fine for JLC.** |
| SIM 6-ch 2:1 mux | TI TS3A27518EPWR | **TSSOP-24** (not TSSOP-16 — brief's assumption corrected) | LCSC | C443721 | $$ ($0.90@1) | 6,272. QFN option: TS3A27518ERTWR WQFN-24-EP 4×4 (C2651937, 1,509, ~$0.71). TSSOP-24 → HAND-solder per plan Task 14 rule; QFN → JLC. |
| MFF2 eUICC eSIM | ST4SIM-200M | MFF2 (DFN-8) | **NOT ON LCSC** | — | — | **No LCSC listing exists for ST4SIM-200M** (confirmed by multiple searches). MFF2 alternatives found on LCSC are both **out of stock**: Hologram SIM-ST-MFF2 (C22416518), Truphone SIM-S-IO3-MFF2-2 (C5122390, DFN-8 5×6). ⚠️ **Action:** source ST4SIM-200M via Mouser/DigiKey/ST and hand-solder it (MFF2 = 8-pad DFN, iron-solderable), or use JLC parts consignment. Reclassify this line from JLC-assembled → HAND. Stock unverified — check at order time. |
| MHF4 SMT receptacle ×5 | TE CONMHF4-SMD-G-T | SMD MHF4 jack | LCSC | C18221168 | $$ ($0.89@1) | 1,580 (live page; API mirror disagreed — page taken as authoritative). Only true-MHF4 listing on LCSC. Fallback if it dries up: Hirose U.FL-R-SMT-1(80) (C88374, 293k stock, ~$0.10) — **only** if antenna jumpers are re-specced to U.FL; U.FL ≠ MHF4 mechanically. |
| Qwiic JST-SH-4 | JST BM04B-SRSS-TB(LF)(SN) | SMT top-entry, 1 mm | LCSC | C160390 | $ ($0.21@1) | 23,522. Standard Qwiic/STEMMA-QT connector. |
| M.2 Key-B socket | LOTES APCI0105-P001A | SMD 0.5 mm, M.2 B-key, **67P** | LCSC | C841658 | $$ ($0.70@1) | **127 in stock — thin; recheck/buy early.** Note: every real B-key socket is sold as **67-pin** (75 edge-pad spec minus 8 pads at the B notch) — the plan's "75-pin" wording describes the module edge, not the socket. **4.2 mm mating height not stated in LCSC parametrics — pull the LOTES datasheet before footprint commit.** Backups: UMAX 91302-42-067R2B (C879639, 269), Foxconn AS0BC21-S30BB-7H (C2761344, 60). |
| M.2 standoff + screw | Sinhoo SMTSO2530CTJ | SMT M2.5, 3 mm H | LCSC | C2915631 | $ ($0.0775@5) | 5,260. Generic SMT standoff, not M.2-specific — verify height matches socket stack (H4.2 socket → 4.2 mm nominal card height; 3 mm standoff suits single-sided-bottom cards — check module thickness). |

## 2. Hand-soldered parts (any distributor; LCSC preferred)

| Part / function | MPN | Package | Distributor | LCSC # | Price class | Stock note (2026-07-14) |
|---|---|---|---|---|---|---|
| **2.5G+PoE magjack (GATE)** | **Bel 2250504-1** | RJ45 ICM, 2.5GBASE-T, 100 W 4-pair PoE (≥802.3bt) | **DigiKey** | — | $$$ ($9.88@1) | **57 in stock — live number seen on DigiKey page.** Bel press release confirms single-port 2.5GBASE-T/100 W part. Family siblings 0826-1X1T-HS-F / -KH-F / 2250506-1 were 0-stock. Second source: LINK-PP **LPJTP95282-8CNL** (2.5G, PoE++/bt, tab-up) ~$4.98 on LINK-PP's own store (l-p.com, "15.2K sold") — not found on LCSC or an independent distributor; stock unverified — check at order time. |
| **PoE flyback/forward transformer (GATE)** | **Würth 750313355** (WE-PoE++, SMT, 1500 Vrms) | SMT_XFRMR_29MM08_23MM1 | **DigiKey** | — | $$$ ($7.19@1, $5.23@1.1k) | **1,074 in stock, Active — fetched live from DigiKey.** This is T2 of TI's TPS23730EVM-093 (12 V / 5 A). TI BOM lists alternate: **Linkcom LDT8627-50R**. See Decision (a) for topology note. |
| PD sink controller | WCH CH224K | **ESSOP-10** (not SOP-8 — verify footprint) | LCSC | C970725 | $ ($0.49@1) | 14,053 — live page. |
| 12 V→3.3 V buck | TI TPS565201DDCR | TSOT-23-6 | LCSC | C327676 | $ ($0.13@1) | 8,893. |
| LDO 3.3 V ×2 | Diodes AP2112K-3.3TRG1 | SOT-25 | LCSC | C51118 | $ ($0.13@1) | 41,270. |
| LDO 1.8 V | Diodes AP2112K-1.8TRG1 | SOT-25 | LCSC | C176944 | $ ($0.15@1) | 12,170. |
| Current monitor ×2 | TI INA226AIDGSR | VSSOP-10, DGS package (**no exposed pad** — TI datasheet SBOS547B Fig.4-1/Table 4-1 lists exactly 10 functional pins, JEDEC MO-187 variation BA outline; Task 14's `HVSSOP-10-1EP` binding was wrong — that footprint belongs to a *different*, EP-bearing HVSSOP-10 family (e.g. bq24090) and its spurious pad 11 orphaned on PCB import; corrected at the Task-15 import-mismatch fix to `Package_SO:MSOP-10_3x3mm_P0.5mm`, the real no-EP JEDEC MO-187 10-pin footprint) | LCSC | C49851 | $$ ($0.60@1) | 42,750. |
| Temp sensor ×2 | TI TMP112AIDRLR | SOT-563 | LCSC | C28927 | $ ($0.23@1) | 26,572. |
| RGB LED | OPSCO SK6805-EC15 | 1.5×1.5 SMD-4P | LCSC | C2890035 | $ ($0.09@1) | 80,300 — live page. ⚠️ Datasheet Vdd min is 3.7 V; 3.3 V operation is standard practice (Adafruit ships this chip as 3.3–5 V) but technically below datasheet floor — noted for design docs. |
| USB3 ESD ×3 | TI TPD4EUSB30DQAR | DFN-2510-10 | LCSC | C558427 | $ ($0.05@1) | 11,595. |
| USB2/LV ESD | TI TPD4E05U06DQAR | USON-10 (1×2.5) | LCSC | C138714 | $ ($0.06@1) | 107,192. |
| CC/SIM ESD ×2 | TI TPD4S009DBVR | SOT-23-6 | LCSC | C88032 | $ ($0.08@1) | 4,687. |
| TVS 13 V | SMAJ13A | DO-214AC (SMA) | LCSC | C19077533 | $ ($0.0415@1) | 43,157 (JLC-preferred listing). |
| TVS 58 V | SMAJ58A | DO-214AC (SMA) | LCSC | C19077554 | $ ($0.0556@1) | 11,842 (JLC-preferred listing). |
| TVS 5 V (D24, VBUS_DATA) | STMicroelectronics SMAJ5.0A-TR | DO-214AC (SMA) | LCSC | C98802 | $ | Live LCSC search, Task 7 (not previously pinned — added for J1's VBUS_DATA rail; the task brief's reference to "it's in sourcing as SMAJ5.0A" was ahead of the doc, this row closes that gap). Standoff 5 V, 400 W, matches the SMAJ13A/SMAJ58A unidirectional-TVS symbol pattern (`sierra-to-usb:SMAJ5.0A`, pin 1 = cathode/protected rail). |
| PoE bridge ×2 | MB10S | MBS SMD | LCSC | C2488 | $ ($0.02) | 230,909 — JLC basic, lowest-risk. |
| N-FET ×~8 | 2N7002 | SOT-23 | LCSC | C8545 | $ ($0.01) | 1.84 M — JLC basic. Ethernet level shifters Q36–38 moved OFF this line to BSS138 (next row) at the 2026-07-15 fix pass — 2N7002's Vgs(th) max 2.5 V is not honestly enhanced from a 1.8 V gate rail. Remaining 2N7002 uses (other sheets) unaffected. |
| N-FET low-Vth ×3 (Q36–38, ethernet PERST/CLKREQ/LANWAKE level shift) | LRC **LBSS138LT1G** (BSS138) | SOT-23 | LCSC | C8490 | $ ($0.0227@1) | 98,000 (live 2026-07-15). Vgs(th) 0.5–1.5 V confirmed from the LCSC-hosted LRC datasheet — enhanced from the +1V8 gate rail where 2N7002 (max 2.5 V) is not. Generic clone listings (e.g. C112239 "Shikues", 183k) exist cheaper; LRC pinned as a named-manufacturer second source of the onsemi original. |
| 0.95 V core buck (U12, ethernet — replaces Task 10's AP2112K-1.0 LDO scope-addition, closing its "not stock-checked" flag) | TI **TLV62569DBVR** | SOT-23-5 | LCSC | C141836 | $ ($0.088@1) | 106,900 (live 2026-07-15). 2 A / 1.5 MHz sync buck, 2.5–5.5 V in, internal 900 µs soft start (within the 0.5–5 ms requirement), DCS-Control (seamless PSM — "well-behaved" light-load per the fix brief; the Realtek forced-PWM edict applies to the 3.3 V rail, not the core rail, and the reference's own core-buck example SY8003E is likewise not FCCM). FB 59k/100k → 0.954 V (= the reference's own R31/R32 ratio for 0.95 V), L = 2.2 µH. |
| +3V3_ETH buck (U15, ethernet — dedicated rail, Fix 4) | TI **TPS62933FDRLR** | SOT-583-8 | LCSC | C5219272 | $$ ($1.11@1) | 923–1,235 observed (live 2026-07-15) — **thin-ish, recheck at order**. 3.8–30 V in, 3 A, **FCCM forced-PWM at all loads**, RT=GND → 1.2 MHz (min 1.0 MHz per EC table) — the only live-verified part meeting Realtek's "3.3V from switching regulator must be PWM mode and Freq>=1Mhz" (main-rail TPS565201 is ~580 kHz Eco — non-compliant for the NIC). Honestly rejected from live datasheets: TPS54308 (350 kHz FCCM), SY8120B1/SY8120I/SY8201 (500 kHz), TPS562231 (850 kHz Eco), TPS562242 (1.4 MHz but Eco pulse-skip), LMR33620A/B (400 kHz / auto-PFM, thin stock), MT2494 (no LCSC listing), SCT2330 (400 kHz PSM), RT6253B (forced PWM but 580 kHz). SS 10 nF, BST 100 nF, FB 31.6k/10k → 3.328 V, L 2.2 µH, EN 100k/20k UVLO divider (EN abs max 6 V). |
| Ferrite bead (FB1, AVDD33_PLL pin 15) | Murata **BLM18PG330SN1D** (33 Ω @100 MHz) | 0603 | LCSC | C88984 | $ ($0.0158@1) | 93,600 (live 2026-07-15). Matches the reference's "Bead 33ohm@100MHz" L6 for AVDD33_PLL exactly. |
| P-FET (VBUS_SENSE force path, Task 6 fix pass) | Diodes Inc **DMG3415U-7** | SOT-23 | LCSC | C96616 | $ ($0.12@5) | **1,345–1,450 in stock (LCSC product page, live).** 20 V/4 A, RDS(on) 42.5 mΩ @ 4.5 V, AEC-Q101. Confirmed manufacturer = Diodes Incorporated on the LCSC listing (not a clone re-mark). Added to replace the Q5 source-follower VBUS_SENSE force path (Fix 1): Q5 (existing 2N7002) becomes a low-side inverter, Q32/DMG3415U-7 is the new high-side P-FET. No stock KiCad symbol for this MPN — added as `sierra-to-usb:DMG3415U` in `lib/sierra-to-usb.kicad_sym` (Q_PMOS_GSD pinout: pin1=G/pin2=S/pin3=D, matching the SOT-23 package standard). Cheaper unsuffixed listing C7202986 ($0.034@1, 8,514 stock) also exists on LCSC under bare "DMG3415U" — not used here since the "-7" tape-and-reel suffix is Diodes Inc's standard ordering code and its exact manufacturer match was independently confirmed on the LCSC page; re-verify C7202986's manufacturer before substituting. |
| ~~USB-C receptacle ×2~~ | ~~HRO (Korean Hroparts) TYPE-C-31-M-12~~ | ~~16-pin mid-mount, hybrid SMD/TH tabs~~ | ~~LCSC~~ | ~~C165948~~ | ~~$ ($0.17@1)~~ | **STRUCK Task 14c**: J2 (PD)/J3 (debug) consolidated onto the same TYPE-C-31-M-04 part as J1 — see row below. The 16-pin M-12 part is no longer used anywhere in this design (was only ever a stock-KiCad-footprint-name coincidence, same class of mistake Task 14 already found and fixed for J1's original M-17 pin). |
| USB-C receptacle ×3 (J1 data, J2 PD, J3 debug) | HRO (Korean Hroparts) **TYPE-C-31-M-04** (corrected at Task 14 — see note; consolidated onto J2/J3 at Task 14c) | 24-pin, full-featured (both SS rows + CC/D±/SBU) | LCSC | **C129018** | $ | **Task 14 CORRECTION** (J1 only, then): Task 7 pinned `TYPE-C-31-M-17` (LCSC C283540) on the assumption its filename-matching stock KiCad footprint (`Connector_USB:USB_C_Receptacle_HRO_TYPE-C-31-M-17.kicad_mod`) meant it was the right physical part. Fetching HRO's own manufacturer datasheet at Task 14 footprint-lock found `TYPE-C-31-M-17` is titled "DETECTOR SWITCHS" and is in fact a **6-pin CC/VBUS/GND-only** receptacle (no D+/D-, no SBU, no SuperSpeed pairs) — it cannot carry USB3 SuperSpeed signals at all, and never matched the 24-pin `USB_C_Receptacle_USB3.2_24P` symbol it was wired to. Re-pinned to **TYPE-C-31-M-04** (LCSC C129018, 3,764 in stock at Task-14 check, "USB3.1(TYPE/C) female receptacle" per its own HRO datasheet), whose pin table matches the project's J1 symbol pin-for-pin, name-for-name. Footprint authored as `sierra-to-usb:USB_C_Receptacle_HRO_TYPE-C-31-M-04` (~~approximated from generic convention~~ **RESOLVED Task 14b:** footprint replaced with JLC/EasyEDA-verified geometry (C129018 pull, hybrid SMD + THT B-row), pad-for-pad reviewer-confirmed). Symbol unchanged: `sierra-to-usb:USB_C_Receptacle_USB3.2_24P` in `lib/sierra-to-usb.kicad_sym` (standard USB-C 24-pin pinout — see task-7-report.md for the pin table, task-14-report.md for this correction). **Task 14c (user decision, "same USB-C everywhere"):** J2 and J3 re-picked from the 16-pin M-12 onto this same M-04 part/footprint/symbol so all three USB-C receptacles on the board are one BOM line — qty went from (2× M-12 + 1× M-04) to 3× M-04. Net-by-function preserved exactly on the swap: VBUS/GND/CC1/CC2 landed on their pre-existing nets (all 4 VBUS and all 4 GND pads per connector, since the 16P and 24P HRO parts share identical USB-C-spec pin numbering for every pin the 16P part has — no renumbering actually occurred for those pins); J3's D+/D- landed on their existing USB_DBG_DP/DM nets; J2's D+/D- stayed NC (J2 is PD-only, never had D± wired); SS pairs + SBU on both J2 and J3 are new pins (the 16P part never exposed them) and are NC-flagged, matching J1's own SBU-NC precedent. Full before/after netlist tuple diff (task-14c-report.md): zero membership changes anywhere in the design; the only new tuples are 16 brand-new NC pins (8 SS per connector × 2 connectors) that didn't physically exist on the old part. Board footprints for J2/J3 are now stale pending a KiCad GUI "Update PCB from Schematic" pass — see docs/footprint-verification.md note; the .kicad_pcb was deliberately left untouched by this text-only schematic edit. |
| Nano-SIM push-push ×2 | JXTCONN CSIM-H137-7P | SMD push-push, 1.37 mm H | LCSC | C42420236 | $ ($0.25) | **605 at Task-1 check / 1,490 at Task-14b recheck — fine for qty 2, recheck at order.** Backup: CSIM-113-7P (C42420249, 675). |
| SMA edge jack ×5 | BWSMA-KE-Z001 | TH board-edge SMA | LCSC | C496549 | $ ($0.36@1) | 94,740. |
| DIP-4 switch | DSWB04LHGET | THT 2.54 mm | LCSC | C99418 | $ ($0.17) | 43,189. |
| Slide switch | SK12D07VG4 (THT) / MSK12C02 (SMT) | 8.7×4.4 / 8×2.8 | LCSC | C393937 / C431540 | $ ($0.0249@1) | 49,718 / 98,963. |
| 470 µF 6.3 V polymer ×2 | Panasonic 6TPE470MI | 7343 SP-Cap | LCSC | C402828 | $$ ($1.45@1) | 8,795 — live page; 18 mΩ ESR confirmed. |
| 2.2 µH ≥5.6 A inductor | Sunlord **SWPA8040S2R2MT** (or NT) | 8×8×4 shielded | LCSC | C36415 (MT) / C504645 (NT) | $ ($0.09) | MT 959 / NT 22 in stock. **Datasheet-verified: Isat 7.10 A max-rating / Irms 5.15 A max-rating (5.60 A typ)** — clears the ≥5.6 A Isat requirement with margin (the 6045 size the plan warns about is indeed undersized). Order MT variant; low-ish stock, buy early. |
| Ideal-diode OR ctrl ×2 | TI **LM5050MKX-1/NOPB** | TSOT-23-6 | DigiKey | — | $$$ ($2.21@1) | **16,526 in stock (DigiKey, live).** Note: the plain LM5050MK-1/NOPB SKU showed 0 stock/16-wk lead — order the MKX (tape/reel cut) SKU. |
| OR-path N-FET ×2 | Infineon **IRLR7843TRPBF** (alternates: VBsemi NTD20N03L27-VB C878885 — only 1 pc at LCSC; Diodes DMC3032LSD — 53 mΩ, fails ≤20 mΩ) | DPAK (TO-252) | DigiKey | — | $$$ ($2.04@1) | **16,728 in stock (DigiKey, live), Active.** 30 V, 3.3 mΩ max @ 10 V, ≫3 A — clears ≤20 mΩ with margin. Rejected: genuine onsemi NTD20N03L27 is 27 mΩ max @ 5 V per datasheet (the "7 mΩ" figure is clone marketing); STD30NF03LT and Vishay SUD50N03 are obsolete at DigiKey. |
| PoE PD+DC/DC controller | TI **TPS23730RMTR** | VQFN-45 (7×5) | DigiKey | — | $$$ ($4.95@1) | **3,569 in stock (DigiKey, live).** See Decision (a). (Rejected alt TPS2373-4RGWR also real: 1,729 in stock, $3.40.) |

## 3. Decisions

### (a) PoE controller: **TPS23730** (TPS23730RMTR) — chosen over TPS2373-4 + separate PWM controller

Driven by transformer availability, exactly as the plan requires: the TI-specified 12 V transformer for the TPS23730's own EVM (TPS23730EVM-093, 12 V / 5 A) is Würth **750313355**, a live catalog part with **1,074 units in stock at DigiKey** at check time, and TI's EVM BOM even names a drop-in alternate (Linkcom LDT8627-50R) — so the integrated-controller route has a proven, purchasable magnetics path with a published schematic/BOM to copy at Class-appropriate power. The TPS2373-4 route would need the *same class* of 54 V→12 V isolated transformer plus an additional PWM controller IC and its support parts, i.e. it only adds BOM lines without easing the one genuinely scarce component; it would only win if no TPS23730-matched transformer were stocked, which is not the case. **Topology note for Task 4:** the stocked 12 V TI designs (EVM-093, PMP23253, PMP23365) are **active-clamp forward with opto feedback** (EVM BOM includes TCMT1107 + TL431), not the "no-opto flyback" the spec §4 sketches; TI's true no-opto 12 V flyback (PMP22477, 12 V/3.8 A) uses a transformer that is *not* a catalog part (matching TI E2E "trouble sourcing" threads). Recommendation carried to schematic capture: follow **EVM-093 verbatim** (add the opto + TL431 — 3 cheap parts) rather than chase a custom flyback transformer; this is a deviation from the spec's "no-opto" wording and is flagged per Global Constraints rather than improvised silently.

### (b) Ideal-diode OR: **2× LM5050-1 (LM5050MKX-1/NOPB) + 2× discrete N-FET** — chosen over SM74611-class

LM5050-1 is a purpose-built high-side ideal-diode OR-ing controller: two of them (one per 12 V source, PD and PoE) each driving a cheap 30 V low-Rds N-FET give true diode-emulation OR-ing at 12 V/3 A with millivolt-class drop, and the controller is deeply stocked (16,526 at DigiKey) in a hand-solderable TSOT-23-6, with commodity DPAK/SO-8 FETs that have dozens of substitutes. The alternatives lose on the facts found: **SM74611** is actually a TI (not Diodes Inc) single-channel *photovoltaic bypass* smart diode in TO-263 — it would still take two devices, costs more (~$5.95 each), and its solar-bypass duty profile isn't intended for continuous supply OR-ing; **LM66200** (true dual, integrated FETs) tops out at 5.5 V — rules itself out at 12 V; **TPS2120/TPS2121** power muxes cover 22 V/4.5 A in one chip but are seamless *switchover muxes* rather than diode-ORs and ship in DSBGA (YFP) — not hand-solderable, violating the assembly split; **LTC4227** (genuine dual ideal-diode controller, one package + 2 FETs) is the closest single-IC competitor but live stock was not confirmed during research. If a one-package solution is later preferred, re-check LTC4227 stock; the default remains 2× LM5050-1 + 2× FET.

## 4. Carry-forward flags (consumed by Tasks 2/6/7/11/14)

1. **eSIM (U12):** ST4SIM-200M is not on LCSC → moves from JLC-assembled to hand-soldered (MFF2 pads are iron-friendly) or JLC consignment; source from Mouser/DigiKey/ST, stock unverified.
2. **M.2 socket:** real B-key sockets are 67-pin (spec's "75-pin" counts module edge pads); LOTES C841658 stock is thin (127). ~~Footprint locked as documented approximation~~ **Footprint replaced Task 14b with the LCSC/EasyEDA C841658 JLC-verified land pattern** (see §5 row 6 and docs/footprint-verification.md) — the geometry gate is closed; only the stock-level watch remains.
3. **TS3A27518E** is TSSOP-24 or WQFN-24 — plan's TSSOP-16 note is wrong; choose QFN→JLC or TSSOP→hand at Task 14.
4. **CH224K is ESSOP-10**, not SOP-8 — footprint check at Task 14.
5. ~~**USB-C J1 (data)** needs a 24-pin (full USB3) receptacle — the pinned TYPE-C-31-M-12 is 16-pin and only suits J2/J3.~~ **RESOLVED Task 7, CORRECTED Task 14**: Task 7's pin (HRO TYPE-C-31-M-17, LCSC C283540) turned out to be a 6-pin CC/VBUS/GND-only part, not 24-pin — re-pinned to HRO TYPE-C-31-M-04, LCSC C129018 (§2 table above).
6. **SK6805-EC15 at 3.3 V** is below its 3.7 V datasheet floor (works in practice; note in design docs).
7. Low-stock watch list: Bel magjack (57), Würth 750313355 (1,074), MHF4 (1,580), M.2 socket (127), nano-SIM (605), SWPA8040S2R2MT (959), HD3SS3220 (2,387) — order early or re-verify at BOM lock.
8. LINK-PP LPJTP95282-8CNL (magjack second source) needs verification through an independent distributor before relying on it.

## 5. BOM notes (order-time gates — Task 6 review Fix pass)

1. **R59/R60 (M.2 VBUS_SENSE divider, 33k/18k) MUST be ordered as 1% tolerance parts, not the project's default 5%.** At 4.75 V low-line with 5% parts on both legs, the worst-case divider output falls to ~1.57 V — below the Quectel-EU/Sierra VIH floor of 1.6 V on CN1.22, i.e. a 5% BOM substitution can silently reopen the exact VIH-margin defect Fix 1/Fix 2 close. The schematic's `Value` field for both parts now reads `"33k 1%"` / `"18k 1%"` specifically so this shows up on the BOM export and can't be quietly swapped to a cheaper 5% reel at order time. When sourcing, pin an explicit 1%-tolerance LCSC/DigiKey listing for both values (0603, standard E96 33.0k / 18.0k) before BOM lock — no MPN pinned yet, flagging for Task 14.
2. **R61 changed from 1k to 330R** (VBUS_SENSE force-path rebuild, Fix 1) — standard 5% 0603 is fine here, this is not a tolerance-sensitive leg (it just sets the forced-node current into the sense pin's input impedance, not a ratio).
3. ~~**VERIFY CSIM-H137-7P (nano-SIM socket) CD switch polarity (normally-closed assumed) against manufacturer drawing before layout lock — detect sense inverts if NO.**~~ **RESOLVED Task 14c:** SIM sockets re-picked to XKB XKNANO-113 (LCSC C381071) with full EasyEDA CAD; its CD switch is documented normally-closed, matching the sim-sheet assumption — gate closed with citation (see task-14c notes / footprint-verification.md).
4. ~~**Bel 2250504-1 magjack footprint (`Bel_2250504-1.kicad_mod`, J8) — APPROXIMATION**~~ **RESOLVED Task 14b:** footprint rebuilt by vector-extracting the SUGGESTED PCB FOOTPRINT view of TRP/Bel drawing C=2250504 Rev1 (8 printed dimensions cross-checked exactly). The old best-fit Y-offsets were indeed wrong: VC pins were 2.5mm off in X and the peg row 3.78mm off in Y, and the pin 1–6 row was mis-gapped. See docs/footprint-verification.md.
5. ~~**TE CONMHF4-SMD-G-T footprint (`MHF4_TE_CONMHF4-SMD-G-T.kicad_mod`, J9/J11/J13/J15/J17) — APPROXIMATION**~~ **RESOLVED Task 14b:** replaced with the LCSC/EasyEDA C18221168 JLC-verified land pattern (old approximation agreed within 0.08mm; the derived top-tab width was confirmed correct).
6. ~~**LOTES APCI0105-P001A M.2 socket footprint (`M.2_Key-B-SMD_Socket_LOTES_APCI0105-P001A.kicad_mod`, CN1) — APPROXIMATION**~~ **RESOLVED Task 14b:** replaced with the LCSC/EasyEDA C841658 JLC-verified land pattern. The approximation was materially wrong (both rows on one side 0.8mm apart with overlapping mask instead of ±3.77mm front/back rows; 0.25×1.1 pads vs real 0.30×1.55; X-mirrored order; mechanical tabs/pegs missing) — this was the solder-mask defect user-reported at layout start. See docs/footprint-verification.md.
7. ~~**Würth 750313355 PoE transformer footprint (`Transformer_SMT_WE750313355.kicad_mod`, T1) — APPROXIMATION**~~ **RESOLVED Task 14b:** rebuilt from Würth's own datasheet Recommended Land Pattern (3.05×1.27 pads, 3.00mm pitch, 26.52mm column spacing, pins 1–6 left / 12–7 right). The approximation had the pins on the wrong edges at 5.06mm pitch / 19.0mm span and would not have fit the part.
