alxgmpr/sierra-to-usb/hardware/reference/ram-local-bypass-plan.csv

reference | rail | value | source_reference | source_sheet
C905 | VCC_1V8 | 10uF | C3848 | 7
C906 | VCC_1V8 | 100nF | C3849 | 7
C907 | VCC_1V8 | 100nF | C3850 | 7
C908 | VCC_1V8 | 100nF | C3851 | 7
C909 | VCC_1V8 | 10uF | C3823 | 7
C910 | VCC_1V8 | 100nF | C3824 | 7
C911 | VCC_1V8 | 100nF | C3825 | 7
C912 | VCC_1V8 | 100nF | C3826 | 7
C913 | VDD_DDR_1V1 | 22uF | C3801 | 7
C914 | VDD_DDR_1V1 | 10uF | C3802 | 7
C915 | VDD_DDR_1V1 | 10uF | C3803 | 7
C916 | VDD_DDR_1V1 | 10uF | C3804 | 7
C917 | VDD_DDR_1V1 | 100nF | C3805 | 7
C918 | VDD_DDR_1V1 | 100nF | C3806 | 7
C919 | VDD_DDR_1V1 | 100nF | C3807 | 7
C920 | VDD_DDR_1V1 | 100nF | C3808 | 7
C921 | VDD_DDR_1V1 | 100nF | C3809 | 7
C922 | VDD_DDR_1V1 | 100nF | C3810 | 7
C923 | VDD_DDR_1V1 | 100nF | C3811 | 7
C924 | VDD_DDR_1V1 | 100nF | C3812 | 7
C925 | VDD_DDR_1V1 | 100nF | C3813 | 7
C926 | VDD_DDR_1V1 | 100nF | C3814 | 7
C927 | VDD_DDR_1V1 | 100nF | C3815 | 7
C928 | VDD_DDR_1V1 | 100nF | C3816 | 7
C929 | VDD_DDR_1V1 | 100nF | C3817 | 7
C930 | VDD_DDR_1V1 | 100nF | C3818 | 7
C931 | VDD_DDR_1V1 | 100nF | C3819 | 7
C932 | VDD_DDR_1V1 | 100nF | C3820 | 7
C933 | VDD_DDR_0V6 | 22uF | C3828 | 7
C934 | VDD_DDR_0V6 | 10uF | C3829 | 7
C935 | VDD_DDR_0V6 | 10uF | C3830 | 7
C936 | VDD_DDR_0V6 | 10uF | C3831 | 7
C937 | VDD_DDR_0V6 | 100nF | C3832 | 7
C938 | VDD_DDR_0V6 | 100nF | C3833 | 7
C939 | VDD_DDR_0V6 | 100nF | C3834 | 7
C940 | VDD_DDR_0V6 | 100nF | C3835 | 7
C941 | VDD_DDR_0V6 | 100nF | C3836 | 7
C942 | VDD_DDR_0V6 | 100nF | C3837 | 7
C943 | VDD_DDR_0V6 | 100nF | C3838 | 7
C944 | VDD_DDR_0V6 | 100nF | C3839 | 7
C945 | VDD_DDR_0V6 | 100nF | C3840 | 7
C946 | VDD_DDR_0V6 | 100nF | C3841 | 7
C947 | VDD_DDR_0V6 | 100nF | C3842 | 7
C948 | VDD_DDR_0V6 | 100nF | C3843 | 7
C949 | VDD_DDR_0V6 | 100nF | C3844 | 7
C950 | VDD_DDR_0V6 | 100nF | C3845 | 7
C951 | VDD_DDR_0V6 | 100nF | C3846 | 7
C952 | VDD_DDR_0V6 | 100nF | C3854 | 7
C953 | VDD_DDR_0V6 | 100nF | C3821 | 7
C954 | VDD_DDR_0V6 | 100nF | C3822 | 7
