alxgmpr/sierra-to-usb/compact/carrier/models/SMF_envelope.step

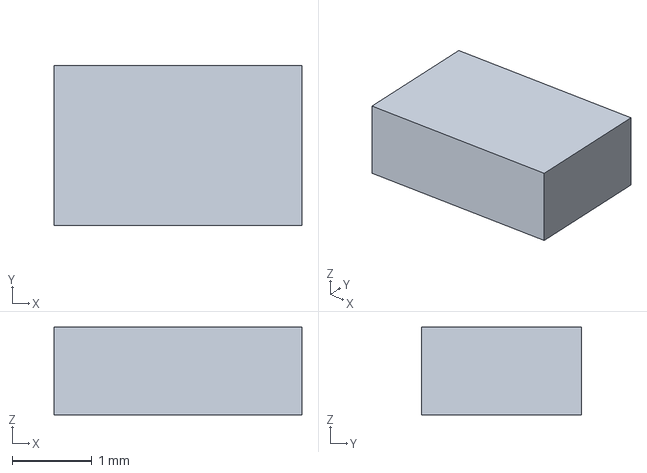
[picture p24: CAD file, 2026-09-09]
compact/carrier/models/SMF_envelope.step
3.10 x 2.00 x 1.10 mm
