alxgmpr/sierra-to-usb/compact/carrier/models/TI_RPW0010A.step

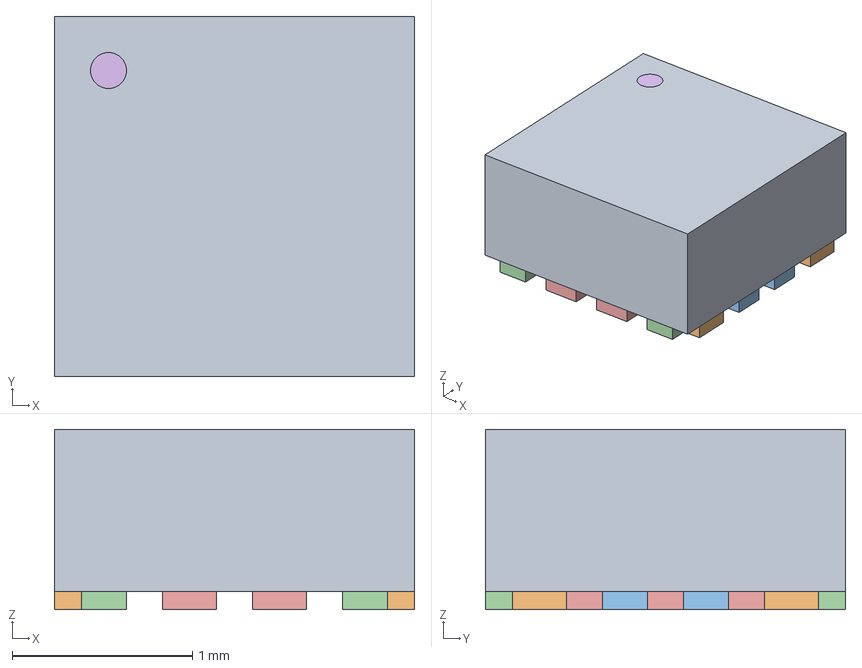
[picture p25: CAD file, 2026-09-09]
compact/carrier/models/TI_RPW0010A.step
2.00 x 2.00 x 1.00 mm
