alxgmpr/sierra-to-usb/compact/carrier/models/Heatsink_envelope.step

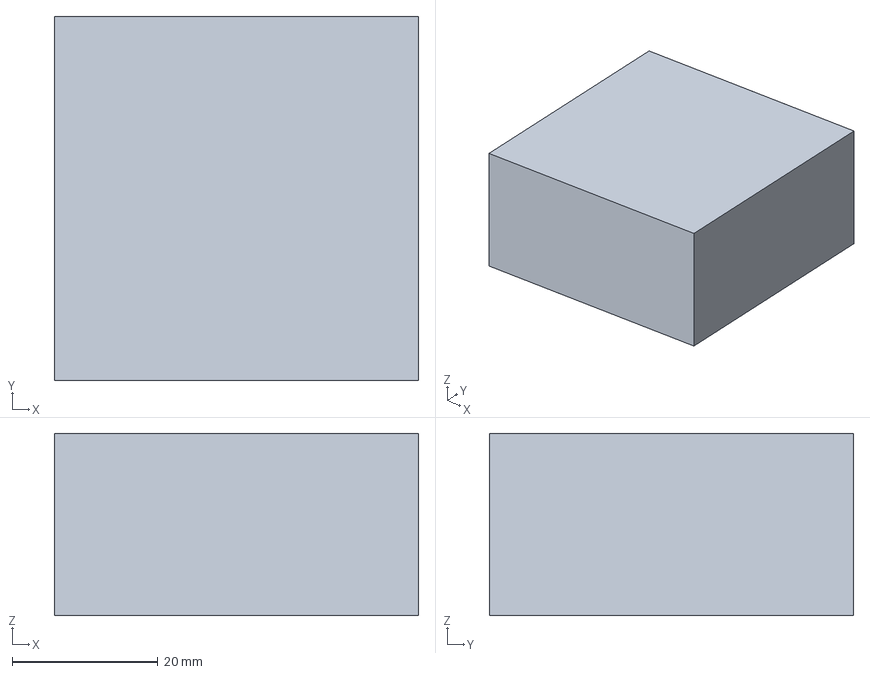
[picture p26: CAD file, 2026-09-09]
compact/carrier/models/Heatsink_envelope.step
50.0 x 50.0 x 25.0 mm
