alxgmpr/sierra-to-usb/compact/carrier/models/RM520N_GL_Detailed.step

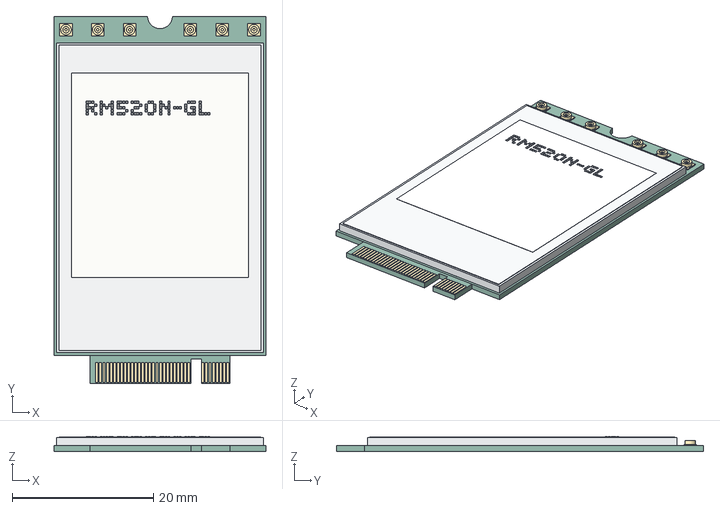
[picture p27: CAD file, 2026-09-09]
compact/carrier/models/RM520N_GL_Detailed.step
30.0 x 52.0 x 2.06 mm
