alxgmpr/sierra-to-usb/compact/carrier/models/Module_EM9190_max_envelope.step

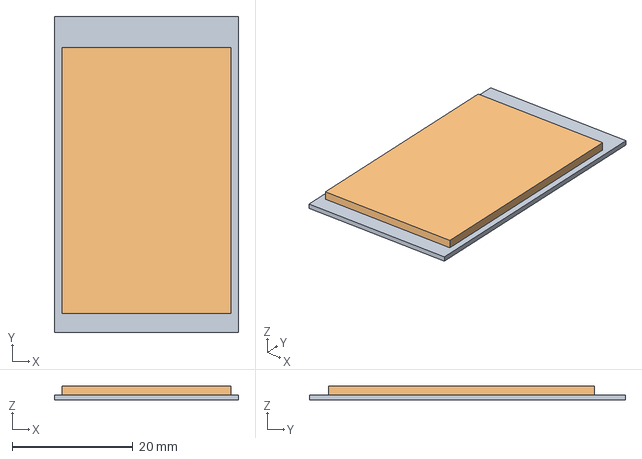
[picture p28: CAD file, 2026-09-09]
compact/carrier/models/Module_EM9190_max_envelope.step
30.4 x 52.3 x 2.38 mm
