alxgmpr/sierra-to-usb/compact/carrier/models/T530_D_envelope.step

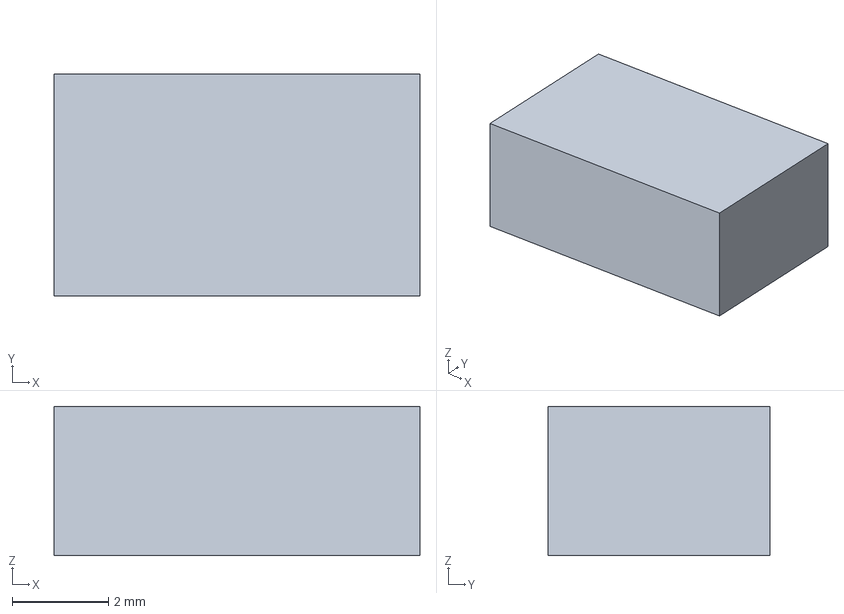
[picture p29: CAD file, 2026-09-09]
compact/carrier/models/T530_D_envelope.step
7.60 x 4.60 x 3.10 mm
