alxgmpr/sierra-to-usb/compact/carrier/models/IDC_3M_N2520_Detailed.step

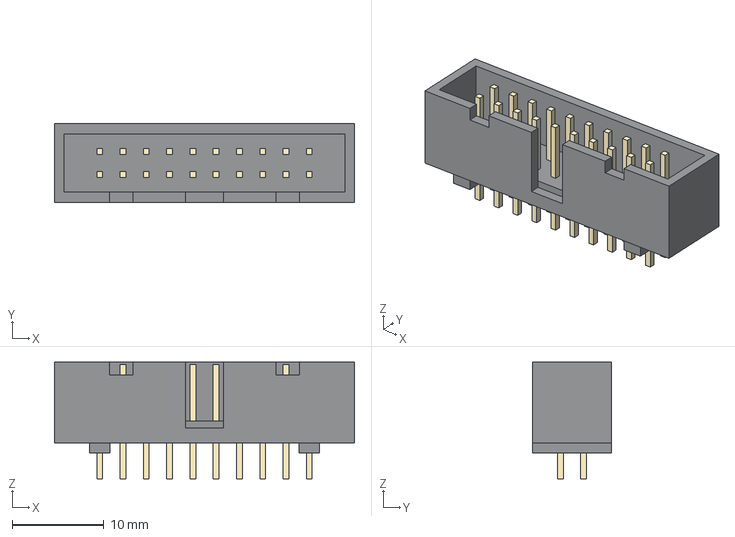
[picture p30: CAD file, 2026-09-09]
compact/carrier/models/IDC_3M_N2520_Detailed.step
32.7 x 8.59 x 12.8 mm
