alxgmpr/sierra-to-usb/compact/carrier/models/N2520_envelope.step

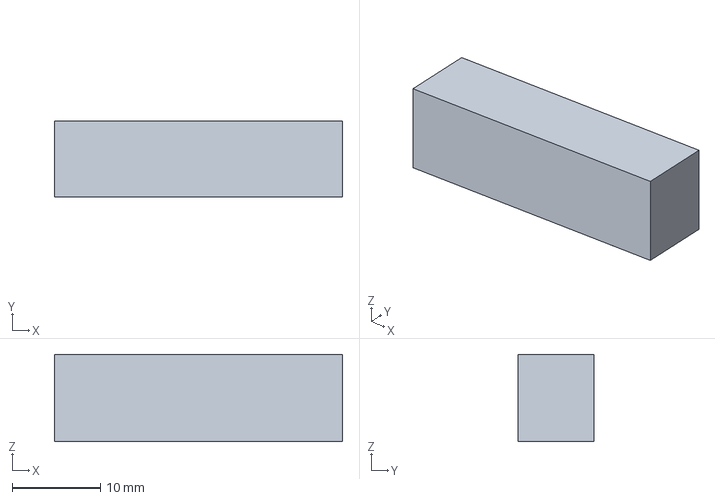
[picture p31: CAD file, 2026-09-09]
compact/carrier/models/N2520_envelope.step
32.7 x 8.59 x 9.91 mm
