alxgmpr/sierra-to-usb/compact/carrier/models/SMA132289_clearance_envelope.step

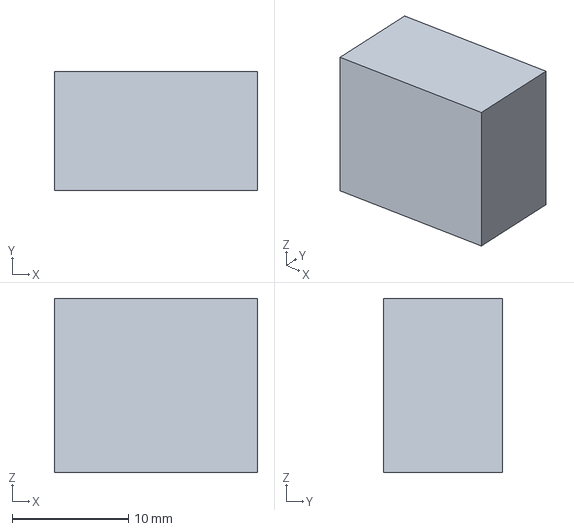
[picture p32: CAD file, 2026-09-09]
compact/carrier/models/SMA132289_clearance_envelope.step
17.4 x 10.2 x 15.0 mm
