alxgmpr/sierra-to-usb/docs/legacy/compact/carrier/models/M2_support_assembly.step

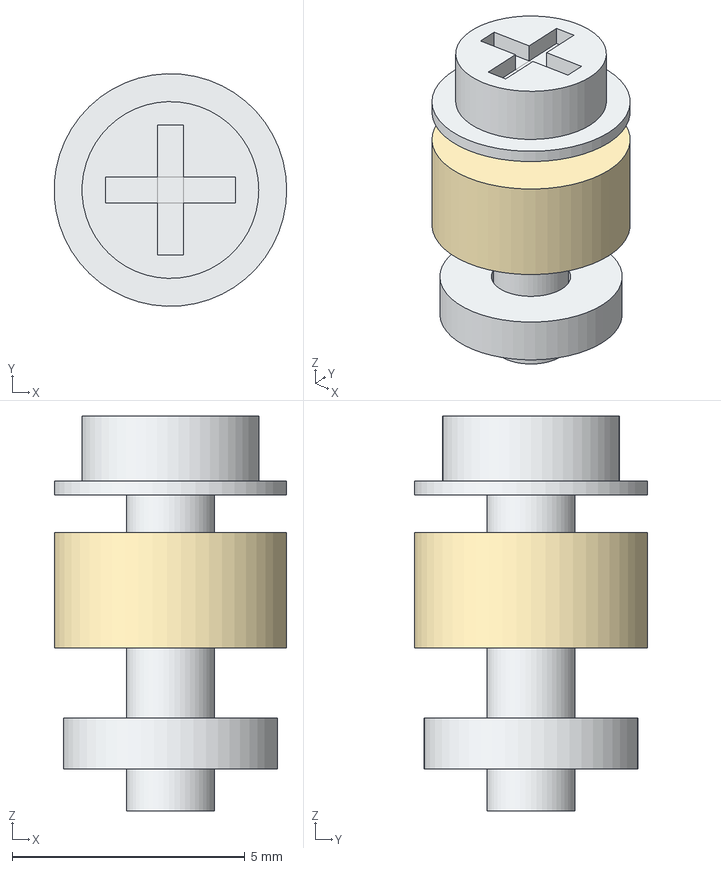
[picture p33: CAD file, 2026-09-09, an earlier design]
docs/legacy/compact/carrier/models/M2_support_assembly.step
5.00 x 5.00 x 8.49 mm
