alxgmpr/sierra-to-usb/docs/legacy/compact/carrier/models/M2_MDT420_Detailed.step

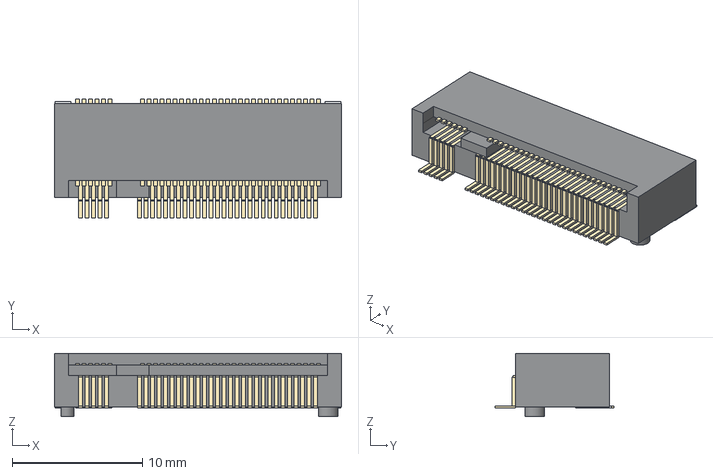
[picture p34: CAD file, 2026-09-09, an earlier design]
docs/legacy/compact/carrier/models/M2_MDT420_Detailed.step
22.0 x 9.10 x 4.85 mm
