alxgmpr/sierra-to-usb/docs/legacy/compact/carrier/models/Retention_frame.step

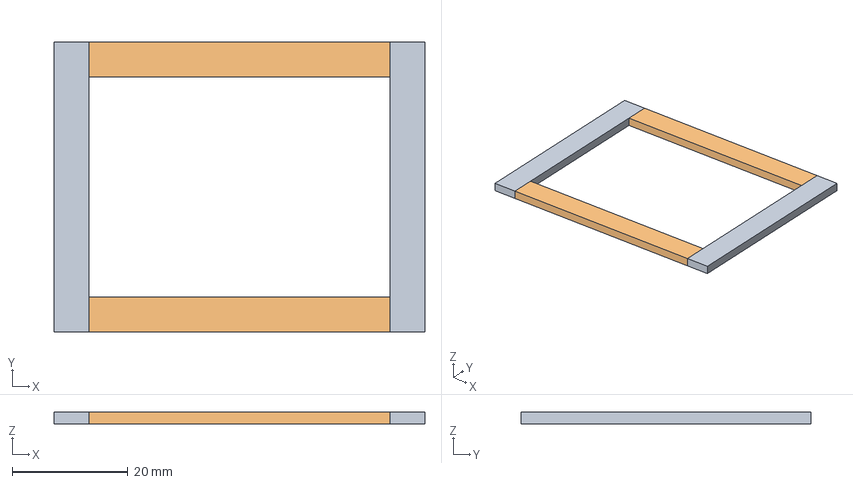
[picture p35: CAD file, 2026-09-09, an earlier design]
docs/legacy/compact/carrier/models/Retention_frame.step
64.0 x 50.0 x 2.00 mm
