alxgmpr/sierra-to-usb/docs/legacy/compact/carrier/models/LTC3310S_envelope.step

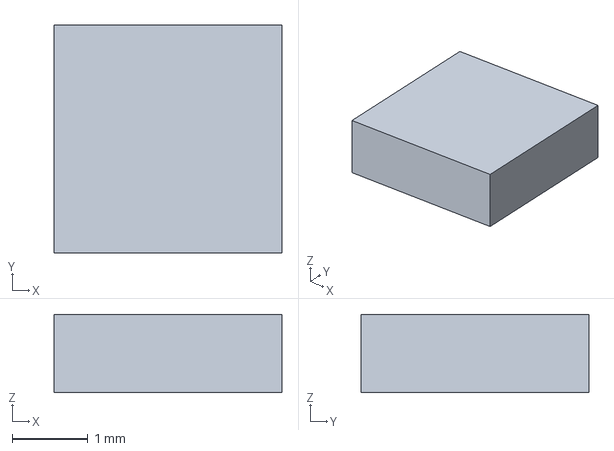
[picture p36: CAD file, 2026-09-09, an earlier design]
docs/legacy/compact/carrier/models/LTC3310S_envelope.step
3.00 x 3.00 x 1.03 mm
