alxgmpr/sierra-to-usb/docs/legacy/compact/carrier/models/Module_support.step

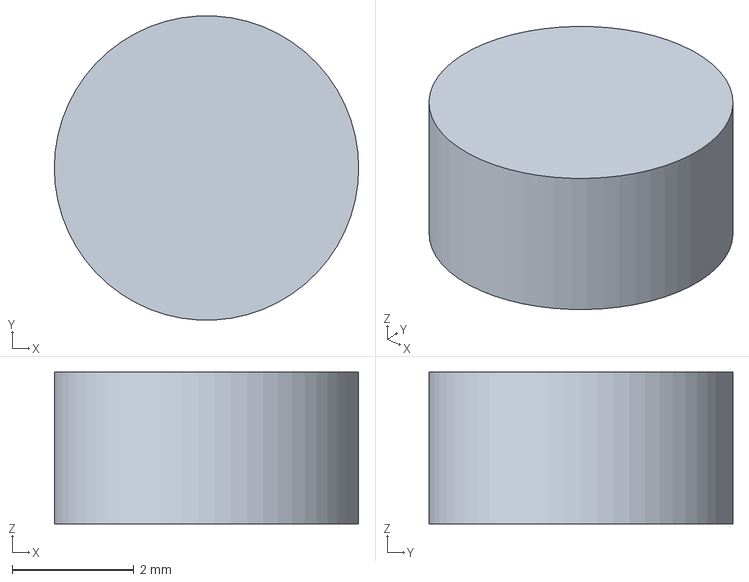
[picture p37: CAD file, 2026-09-09, an earlier design]
docs/legacy/compact/carrier/models/Module_support.step
5.00 x 4.99 x 2.49 mm
