alxgmpr/sierra-to-usb/docs/legacy/compact/carrier/models/Retention_post.step

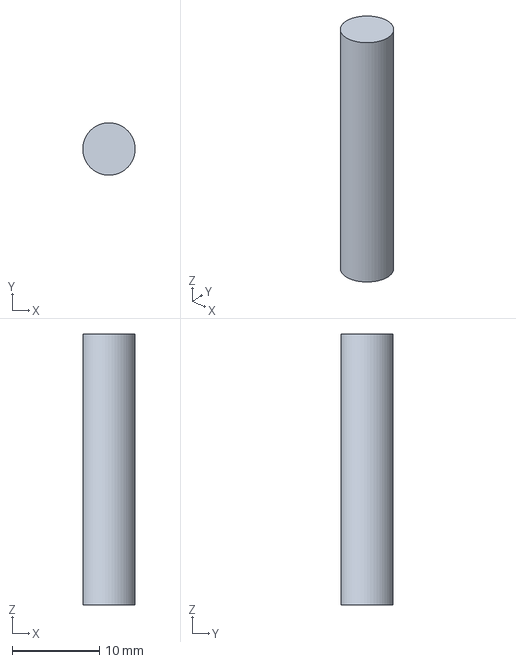
[picture p38: CAD file, 2026-09-09, an earlier design]
docs/legacy/compact/carrier/models/Retention_post.step
5.99 x 6.00 x 31.0 mm
