alxgmpr/sierra-to-usb/docs/legacy/compact/carrier/models/SOT523_envelope.step

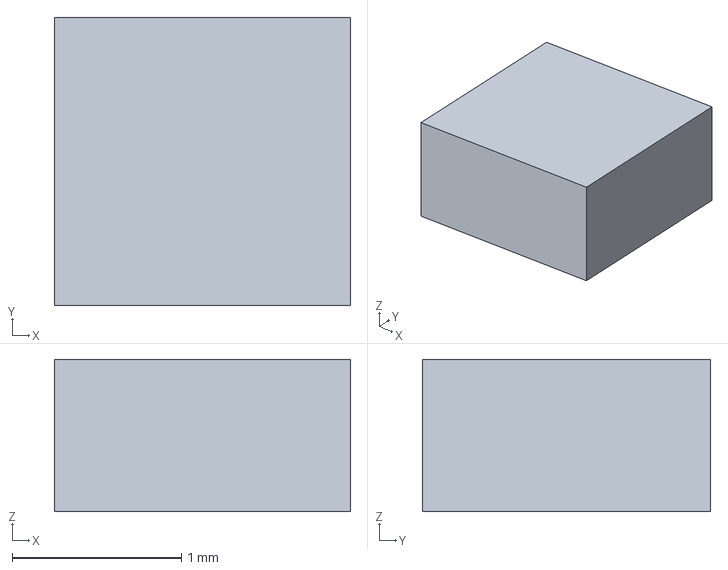
[picture p39: CAD file, 2026-09-09, an earlier design]
docs/legacy/compact/carrier/models/SOT523_envelope.step
1.75 x 1.70 x 0.9 mm
