alxgmpr/sierra-to-usb/docs/legacy/compact/carrier/models/MHF4_envelope.step

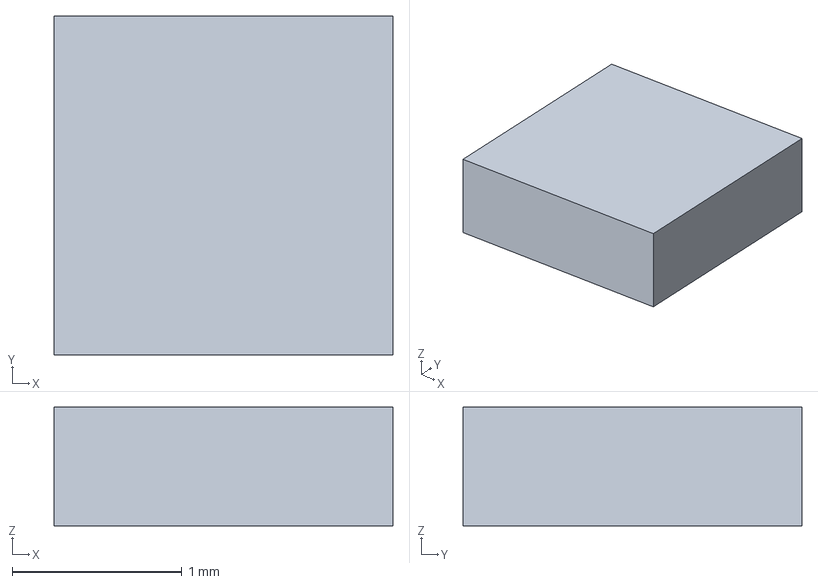
[picture p40: CAD file, 2026-09-09, an earlier design]
docs/legacy/compact/carrier/models/MHF4_envelope.step
2.00 x 2.00 x 0.7 mm
