alxgmpr/sierra-to-usb/docs/legacy/compact/carrier/models/MDT420_envelope.step

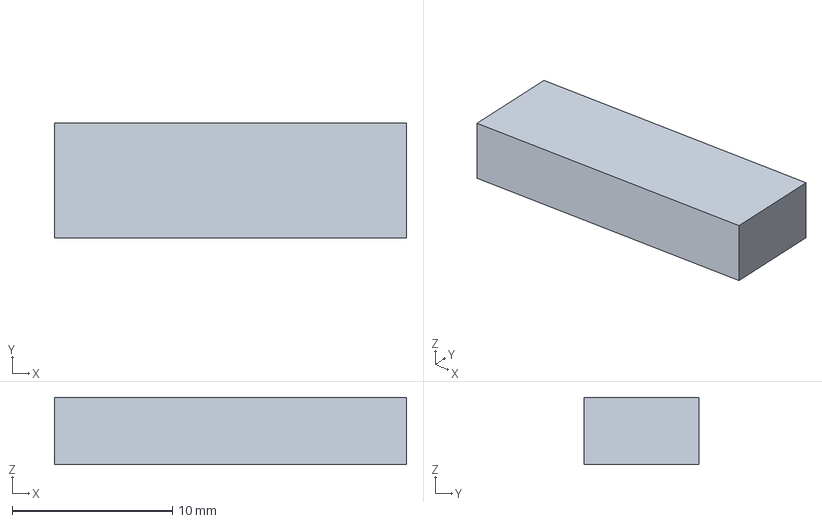
[picture p41: CAD file, 2026-09-09, an earlier design]
docs/legacy/compact/carrier/models/MDT420_envelope.step
22.0 x 7.20 x 4.20 mm
