alxgmpr/sierra-to-usb/(list of files, cad)

Other CAD files:
docs/legacy/compact/carrier/models/CSM2512_envelope.step
docs/legacy/compact/carrier/models/JS102011SAQN_envelope.step
docs/legacy/compact/carrier/models/Profile_service_envelope.step
docs/legacy/compact/carrier/models/RSE10_envelope.step
docs/legacy/compact/carrier/models/TIM_8810.step
docs/legacy/compact/carrier/models/XEL4030_envelope.step
