alxgmpr/sierra-to-usb/handoff/m2-sierra-handoff/exports/SCH_Schematic1_2026-07-12.pdf

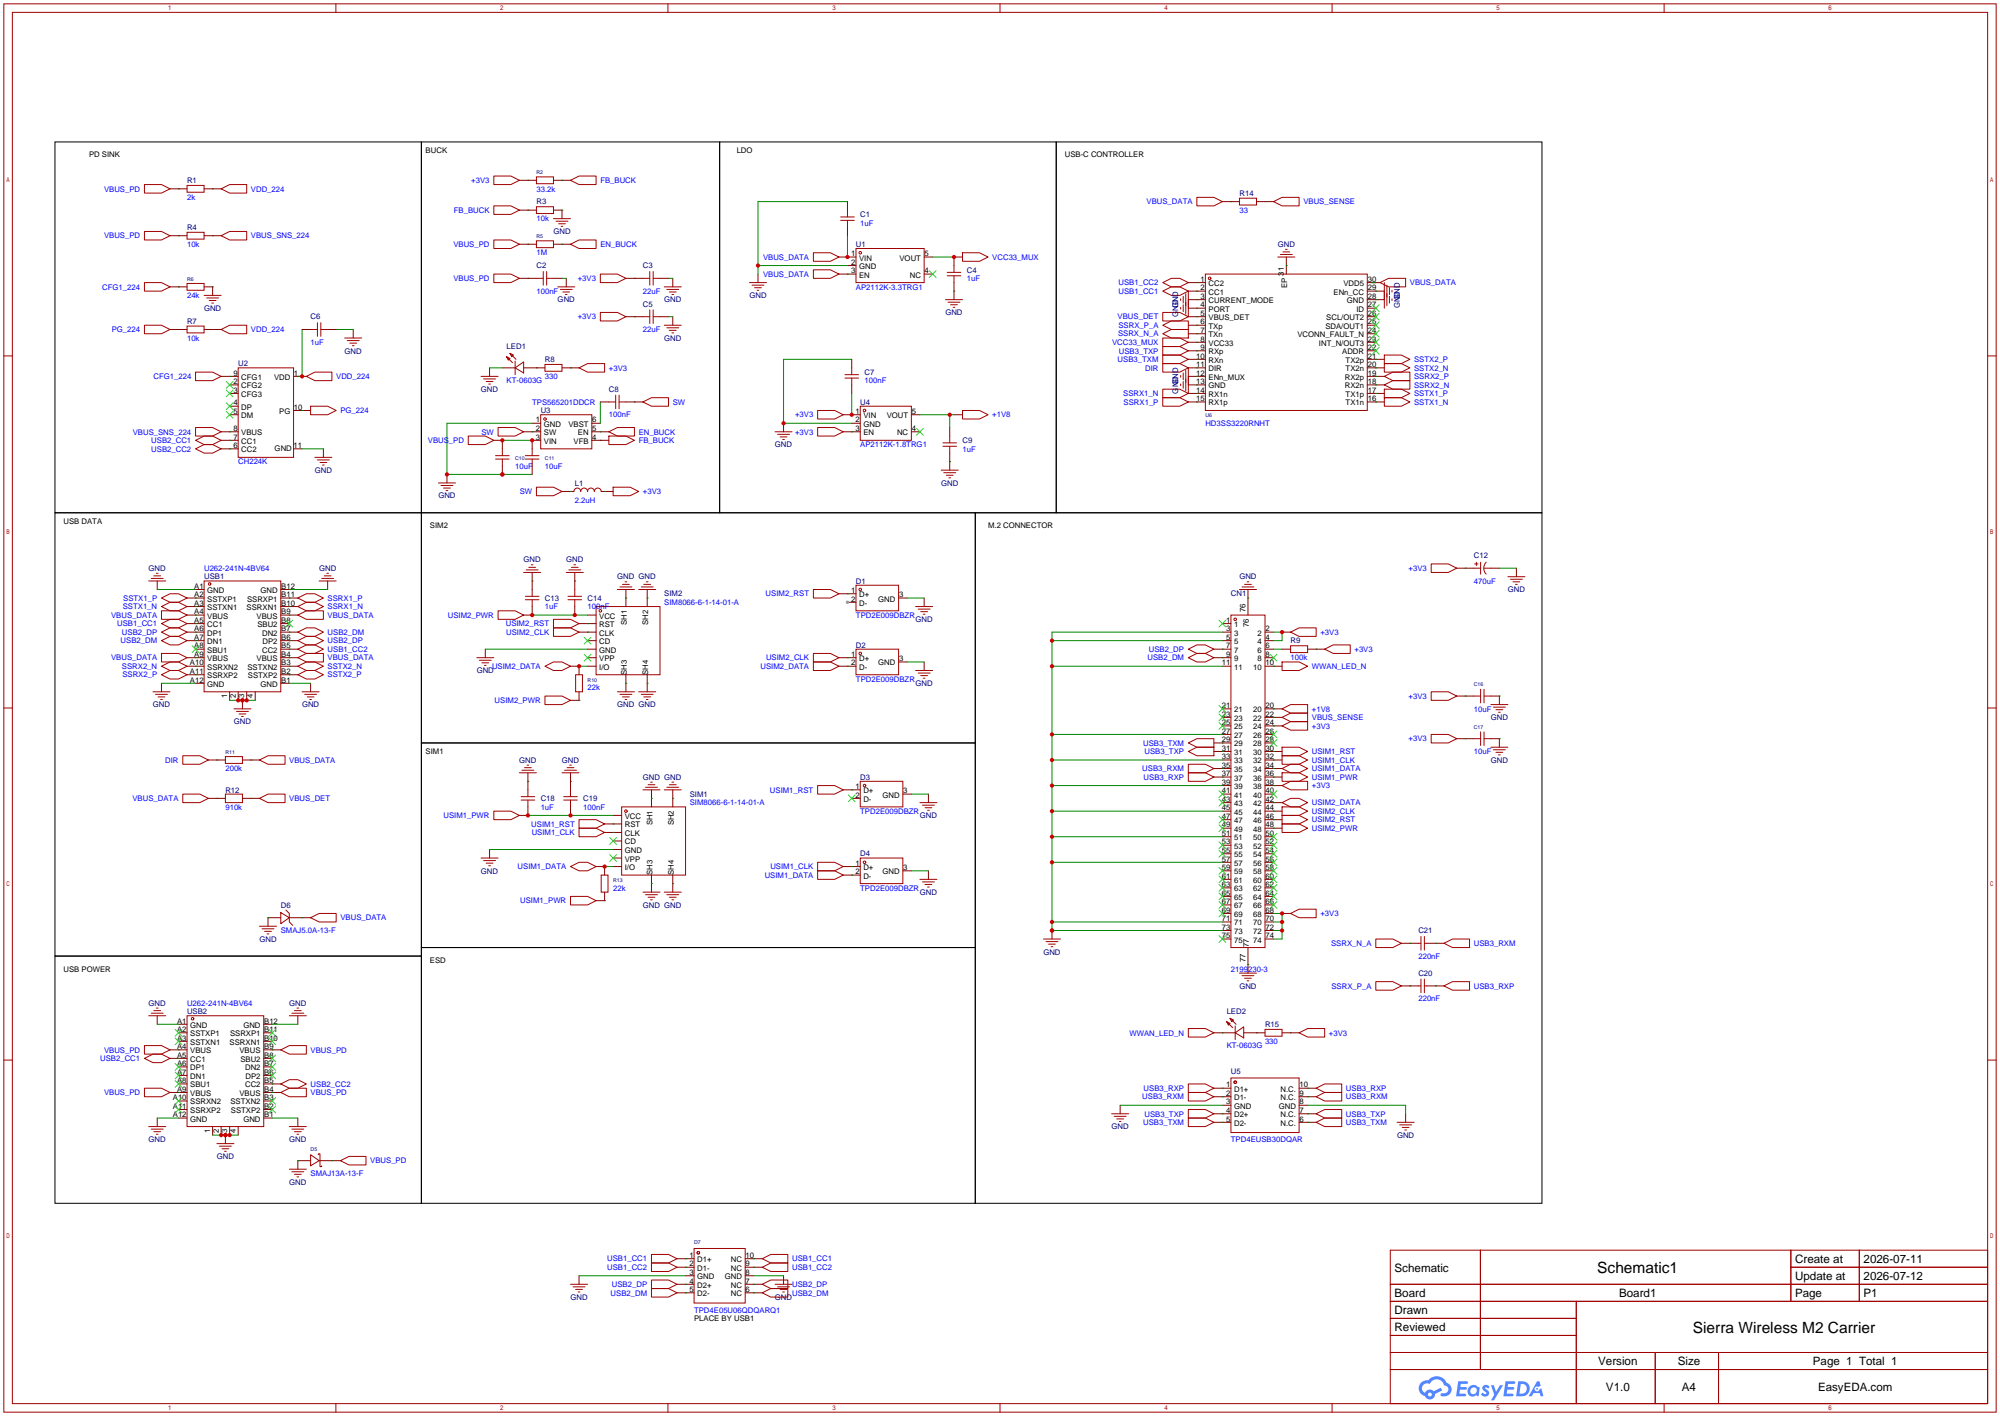
[picture p42: page 1]

GND GND

Schematic | Schematic1 | Create at | 2026-07-11

Update at | 2026-07-12

Board | Board1 | Page | P1
Drawn | | Sierra Wireless M2 Carrier
Reviewed

Version | Size | Page 1 Total 1
V1.0 | A4 | EasyEDA.com
