alxgmpr/sierra-to-usb/(list of files, drawings)

Other design files:
docs/legacy/compact/carrier/historical-build-evidence/schematic-checks.json
handoff/m2-sierra-handoff/exports/ProPrj_Sierra Wireless M2 Carrier_2026-07-14.epro
