alxgmpr/sierra-to-usb/hardware/appliance.kicad_pcb

## KiCad design hardware/appliance.kicad_pcb (2026-10-21)

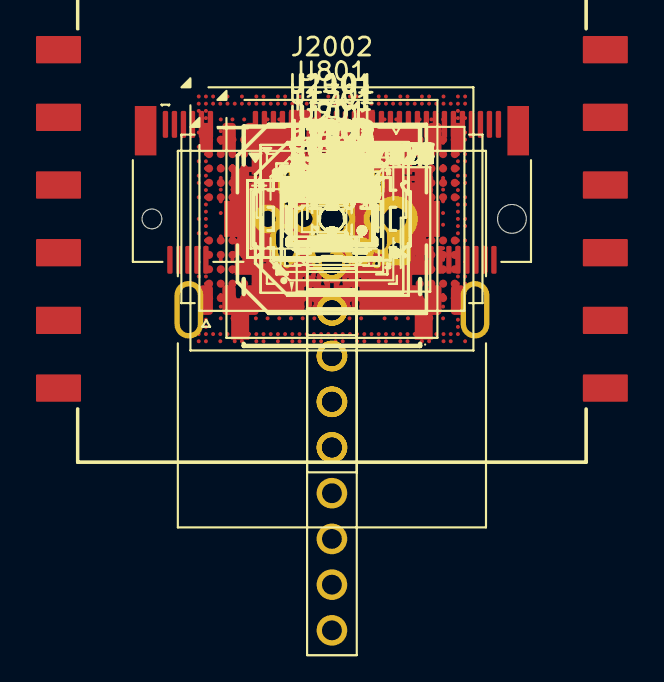
[picture p43: board appliance.kicad_pcb from above]

Board: 2 copper layers, 663 parts (0 on the bottom side), 378 nets, no tracks yet.

Parts:
C201, C202, C204, C205, C802, C804, C806, C808, C810, C811, C812, C815, C816, C817, C818, C819, C821, C825, C832, C837, C838, C839, C842, C843, C844, C906, C907, C908, C910, C911, C912, C917, C918, C919, C920, C921, C922, C923, C924, C925, C926, C927, C928, C929, C930, C931, C932, C937, C938, C939, C940, C941, C942, C943, C944, C945, C946, C947, C948, C949, C950, C951, C952, C953, C954, C960, C1002, C1103, C1105, C1201, C1202, C1203, C1204, C1205, C1206, C1207, C1208, C1209, C1210, C1211, C1212, C1301, C1402, C1405, C1408, C1411, C1420, C1421, C1422, C1423, C1424, C1425, C1426, C1427, C1428, C1429, C1430, C1431, C1432, C1433, C1434, C1501, C1504, C1508, C1509, C1605, C1606, C1607, C1608, C1620, C1621, C1622, C1623, C1624, C1625, C1626, C1627, C1628, C1629, C1630, C1631, C1632, C1633, C1718, C1851, C1852, C1853, C1854, C1901, C1907, C1909, C1912, C1913, C1914, C2001, C2002, C2003, C2004, C2005, C2024, C2031, C2032, C2033, C2034, C2035, C2036, C2037, C2038: 100nF; C_0603_1608Metric_Pad1.08x0.95mm_HandSolder
C203, C543, C544, C823, C830, C835, C841, C902, C903, C905, C909, C914, C915, C916, C934, C935, C936, C955, C958, C1001, C1101, C1503, C1505, C1507, C1905, C1906: 10uF; C_1206_3216Metric_Pad1.33x1.80mm_HandSolder
C401: 4.7uF / 50V; C_1206_3216Metric_Pad1.33x1.80mm_HandSolder
C402, C403, C501, C502, C503, C504, C505, C506, C507, C508, C509, C510, C511, C512, C516, C519, C524, C533, C541, C601, C602, C603, C706, C707: 22uF / 25V; C_1210_3225Metric_Pad1.33x2.70mm_HandSolder
C513, C531, C532, C604, C701, C705: 100nF / 25V; C_0603_1608Metric_Pad1.08x0.95mm_HandSolder
C514, C515, C517, C518, C520, C521, C522, C523, C525, C526, C527, C528, C529, C530, C535, C536, C538, C813, C814: 1uF / 25V; C_0603_1608Metric_Pad1.08x0.95mm_HandSolder
C537, C703, C704: 10uF / 50V; C_1206_3216Metric_Pad1.33x1.80mm_HandSolder
C542: 10uF / 25V; C_1206_3216Metric_Pad1.33x1.80mm_HandSolder
C545, C546, C547, C801, C803, C805, C807, C809, C1102, C1401, C1403, C1404, C1406, C1407, C1409, C1410, C1412, C1441, C1442, C1443, C1444: 1uF; C_0603_1608Metric_Pad1.08x0.95mm_HandSolder
C702: 47nF / 50V; C_0603_1608Metric_Pad1.08x0.95mm_HandSolder
C820, C1502, C1910: 1nF; C_0603_1608Metric_Pad1.08x0.95mm_HandSolder
C822, C824, C829, C831, C834, C836, C901, C913, C933, C956, C957, C1003, C1004, C1007, C1008, C1009, C1506, C1902, C1903, C1904: 22uF; C_1210_3225Metric_Pad1.33x2.70mm_HandSolder
C826, C827, C828, C833, C840, C845, C846, C1005, C1006, C1104, C1640, C1641, C1642, C1643, C1644: 4.7uF; C_0603_1608Metric_Pad1.08x0.95mm_HandSolder
C959, C1735, C1744: 100pF; C_0603_1608Metric_Pad1.08x0.95mm_HandSolder
C1302, C1303: 27pF; C_0603_1608Metric_Pad1.08x0.95mm_HandSolder
C1601, C1602, C1603, C1604: 100nF; C_0201_0603Metric_Pad0.64x0.40mm_HandSolder
C1707, C1708: 1000pF; C_0603_1608Metric_Pad1.08x0.95mm_HandSolder
C1709, C1710, C1711, C1712: 330pF; C_0603_1608Metric_Pad1.08x0.95mm_HandSolder
C1716, C1801, C1802, C1803, C1911: 10nF; C_0603_1608Metric_Pad1.08x0.95mm_HandSolder
C1717: 47uF / 63V; TI_SM_RADIAL_F
C1719: 100nF; C_0805_2012Metric_Pad1.18x1.45mm_HandSolder
C1720, C1736: 4700pF; C_1812_4532Metric_Pad1.57x3.40mm_HandSolder
C1721, C1726: 0.1uF; C_0805_2012Metric_Pad1.18x1.45mm_HandSolder
C1722, C1723, C1724, C1725: 2.2uF; C_1210_3225Metric_Pad1.33x2.70mm_HandSolder
C1727: 270uF; TI_PCV_1000x1270
C1728, C1729, C1730: 10uF; C_1210_3225Metric_Pad1.33x2.70mm_HandSolder
C1731, C1740, C1746: 1uF; C_0805_2012Metric_Pad1.18x1.45mm_HandSolder
C1732: 100pF; C_0805_2012Metric_Pad1.18x1.45mm_HandSolder
C1733, C2041: 220pF; C_0603_1608Metric_Pad1.08x0.95mm_HandSolder
C1734: 0.022uF; C_0603_1608Metric_Pad1.08x0.95mm_HandSolder
C1737: 3300pF; C_0603_1608Metric_Pad1.08x0.95mm_HandSolder
C1738: 3900pF; C_0603_1608Metric_Pad1.08x0.95mm_HandSolder
C1739: 0.1uF; C_0603_1608Metric_Pad1.08x0.95mm_HandSolder
C1741: 2.2uF; C_0603_1608Metric_Pad1.08x0.95mm_HandSolder
C1743, C1745: 0.047uF; C_0603_1608Metric_Pad1.08x0.95mm_HandSolder
C1861, C1862, C1863, C1864: 10nF / 100V; C_0603_1608Metric_Pad1.08x0.95mm_HandSolder
C1865: 1nF / 2kV; C_1808_4520Metric_Pad1.72x2.30mm_HandSolder
C1908: 47nF; C_0603_1608Metric_Pad1.08x0.95mm_HandSolder
C2021, C2022, C2023: 10pF; C_0603_1608Metric_Pad1.08x0.95mm_HandSolder
C2030: 220uF / 6.3V; CP_Elec_6.3x5.9
C2042: 68pF; C_0603_1608Metric_Pad1.08x0.95mm_HandSolder
C2043: 15pF; C_0603_1608Metric_Pad1.08x0.95mm_HandSolder
C2044: 9.1pF; C_0603_1608Metric_Pad1.08x0.95mm_HandSolder
C2045: 4.7pF; C_0603_1608Metric_Pad1.08x0.95mm_HandSolder
D1201: TPD2EUSB30DRTR; Texas_DRT-3
D1701, D1702, D1703, D1704, D1706, D1707, D1708, D1709: 100V; D_SMB_Handsoldering
D1705: 58V; D_SMB_Handsoldering
D1714: 200V; D_SMA_Handsoldering
D1715, D1717: 100V; D_SOD-123
D1716: Yellow; LED_0603_1608Metric_Pad1.05x0.95mm_HandSolder
D1718: 60V; Diodes_PowerDI-5_3Pin_Derived
D1719: 5.1V; D_SOD-123
D1721: 30V; SOT-23_Handsoldering
D1851, D1852, D2001: TPD4E02B04DQAR; USON-10_2.5x1.0mm_P0.5mm
FB801, FB802, FB1301, FB1302, FB1401, FB1402, FB1403, FB1404: 120R @ 100MHz; L_0603_1608Metric_Pad1.05x0.95mm_HandSolder
FB1303, FB1304: 30R @ 100MHz; L_0805_2012Metric_Pad1.05x1.20mm_HandSolder
J101: 3.3V RAIL TEST; Wuerth_61300211121_1x02_P2.54mm_Vertical
J102: CONTROL BOUNDARY; Wuerth_61301011121_1x10_P2.54mm_Vertical
J201: SWD / recovery; Wuerth_61300611121_1x06_P2.54mm_Vertical
J202: WDT RUN jumper; Wuerth_61300211121_1x02_P2.54mm_Vertical
J1201: RECOVERY USB; USB_Micro-B_Amphenol_10103594-0001LF_Horizontal
J1202: 3.3V DEBUG UART; PinHeader_1x03_P2.54mm_Vertical
J1701: 2.5GbE + PoE; Sierra_RJE491881401_1x08-1MP_P1.02mm
J1711: ED555/2DS; TI_TERM_BLK_ED555-2DS
J1712: 87898-0204; TI_Molex_87898-0204
J2001: MDT420B01411; Sierra_MDT420B01411_2x38-1MP_P0.5mm
J2002: 1042240820; SIM-SMD_1042240820
L401: 10uH; L_Coilcraft_LPS4018
L501, L502, L504, L505, L901, L1001: 0.47uH; L_Coilcraft_XxL4020
L601: 1uH; L_Coilcraft_XxL4030
L701, L1901: 3.3uH; L_Coilcraft_XAL7070-XXX
L902, L1501: 2.2uH; L_Coilcraft_XxL4020
L1701, L1703: 300 ohm; L_0603_1608Metric_Pad1.05x0.95mm_HandSolder
L1702: 250uH; TI_WE-SL5
L1707: 3.3uH; L_Coilcraft_XxL4020
L1708: 160nH; L_Coilcraft_XAL5030-XXX
Q301, Q302, Q303, Q501, Q801, Q802, Q1201, Q1601, Q2001: MMBT3904,215; SOT-23_Handsoldering
Q1701, Q1702, Q1703, Q1704: 100V; SuperSOT-3
Q1705: 150V; TI_TRANS_Fairchild_PQFN08A
Q1707: 20 V; SOT-23_Handsoldering
Q1901: AO3400A; SOT-23_Handsoldering
R201, R202, R203, R301, R303, R305, R501, R504, R505, R508, R510, R511, R604, R605, R703, R705, R706, R801, R802, R804, R1101, R1102, R1105, R1201, R1202, R1205, R1210, R1301, R1306, R1509, R1510, R1604, R1606, R1902, R1904, R1906, R1911, R1918, R1923, R2001, R2003, R2014, R2015: 10kR; R_0603_1608Metric_Pad0.98x0.95mm_HandSolder
R302, R304, R306, R307, R308, R401, R506, R507, R509, R606, R803, R805, R906, R1001, R1104, R1207, R1208, R1209, R1211, R1501, R1502, R1503, R1505, R1507, R1508, R1605, R1903, R1905, R1912, R1914, R1916, R1925, R1926, R2002, R2018: 100kR; R_0603_1608Metric_Pad0.98x0.95mm_HandSolder
R502, R503: 2.2kR; R_0603_1608Metric_Pad0.98x0.95mm_HandSolder
R512, R1401, R1402, R1403: 100R; R_0603_1608Metric_Pad0.98x0.95mm_HandSolder
R601: 200kR; R_0603_1608Metric_Pad0.98x0.95mm_HandSolder
R602: 44.2kR; R_0603_1608Metric_Pad0.98x0.95mm_HandSolder
R603, R907: 20kR; R_0603_1608Metric_Pad0.98x0.95mm_HandSolder
R701: 30.1kR; R_0603_1608Metric_Pad0.98x0.95mm_HandSolder
R702: 73.2kR; R_0603_1608Metric_Pad0.98x0.95mm_HandSolder
R704, R1302, R1907: 1kR; R_0603_1608Metric_Pad0.98x0.95mm_HandSolder
R901, R1922: 47kR; R_0603_1608Metric_Pad0.98x0.95mm_HandSolder
R902: 120kR; R_0603_1608Metric_Pad0.98x0.95mm_HandSolder
R903: 240R; R_0603_1608Metric_Pad0.98x0.95mm_HandSolder
R904: 120R; R_0603_1608Metric_Pad0.98x0.95mm_HandSolder
R905: 2kR; R_0603_1608Metric_Pad0.98x0.95mm_HandSolder
R908: 1MR; R_0603_1608Metric_Pad0.98x0.95mm_HandSolder
R1103, R1106, R2021, R2022, R2023: 22R; R_0603_1608Metric_Pad0.98x0.95mm_HandSolder
R1203, R1204: 2.2R; R_0603_1608Metric_Pad0.98x0.95mm_HandSolder
R1206: 16.5kR; R_0603_1608Metric_Pad0.98x0.95mm_HandSolder
R1303, R1304, R1305, R1602, R1603: 4.7kR; R_0603_1608Metric_Pad0.98x0.95mm_HandSolder
R1307: 2.49kR; R_0603_1608Metric_Pad0.98x0.95mm_HandSolder
R1411, R1412, R1413, R1414: 0R; R_0603_1608Metric_Pad0.98x0.95mm_HandSolder
R1504: 59kR; R_0603_1608Metric_Pad0.98x0.95mm_HandSolder
R1506: 115kR; R_0603_1608Metric_Pad0.98x0.95mm_HandSolder
R1709, R1710, R1711, R1712: 1.00Meg; R_0603_1608Metric_Pad0.98x0.95mm_HandSolder
R1713, R1714, R1715, R1716: 232k; R_0603_1608Metric_Pad0.98x0.95mm_HandSolder
R1723: 24.9kR; R_0603_1608Metric_Pad0.98x0.95mm_HandSolder
R1724: 63.4R; R_0603_1608Metric_Pad0.98x0.95mm_HandSolder
R1727: 249R; R_0603_1608Metric_Pad0.98x0.95mm_HandSolder
R1730: 1kR; R_2010_5025Metric_Pad1.40x2.65mm_HandSolder
R1732: 49.9kR; R_0603_1608Metric_Pad0.98x0.95mm_HandSolder
R1733: 39k; R_1206_3216Metric_Pad1.30x1.75mm_HandSolder
R1734: 133k; R_0603_1608Metric_Pad0.98x0.95mm_HandSolder
R1735: 10; R_0603_1608Metric_Pad0.98x0.95mm_HandSolder
R1736: 75; R_2010_5025Metric_Pad1.40x2.65mm_HandSolder
R1737, R1756: 4.99k; R_0603_1608Metric_Pad0.98x0.95mm_HandSolder
R1738: 0.02; R_2010_5025Metric_Pad1.40x2.65mm_HandSolder
R1739: 5.23; R_0805_2012Metric_Pad1.20x1.40mm_HandSolder
R1740: 100k; R_0603_1608Metric_Pad0.98x0.95mm_HandSolder
R1741, R1763: 0; R_0603_1608Metric_Pad0.98x0.95mm_HandSolder
R1742: 499; R_0603_1608Metric_Pad0.98x0.95mm_HandSolder
R1743: 71.5k; R_0603_1608Metric_Pad0.98x0.95mm_HandSolder
R1744: 4.42k; R_0603_1608Metric_Pad0.98x0.95mm_HandSolder
R1745, R1761: 2.61k; R_0603_1608Metric_Pad0.98x0.95mm_HandSolder
R1746: 2.32k; R_0603_1608Metric_Pad0.98x0.95mm_HandSolder
R1747, R1748: 15; R_2512_6332Metric_Pad1.40x3.35mm_HandSolder
R1753: 50; R_0603_1608Metric_Pad0.98x0.95mm_HandSolder
R1754: 2.10k; R_0603_1608Metric_Pad0.98x0.95mm_HandSolder
R1755, R1759: 10.0k; R_0603_1608Metric_Pad0.98x0.95mm_HandSolder
R1757: 887; R_0603_1608Metric_Pad0.98x0.95mm_HandSolder
R1760: 14.7k; R_0603_1608Metric_Pad0.98x0.95mm_HandSolder
R1762: 10.2k; R_0603_1608Metric_Pad0.98x0.95mm_HandSolder
R1801, R1802, R1803: 6.8kR; R_0603_1608Metric_Pad0.98x0.95mm_HandSolder
R1811, R1812, R1813: 12kR; R_0603_1608Metric_Pad0.98x0.95mm_HandSolder
R1861, R1862, R1863, R1864: 75R; R_0603_1608Metric_Pad0.98x0.95mm_HandSolder
R1901: 36.3kR; R_0603_1608Metric_Pad0.98x0.95mm_HandSolder
R1913: 237kR; R_0603_1608Metric_Pad0.98x0.95mm_HandSolder
R1915: 165kR; R_0603_1608Metric_Pad0.98x0.95mm_HandSolder
R1917: 562R; R_0603_1608Metric_Pad0.98x0.95mm_HandSolder
R1921: 330kR; R_0603_1608Metric_Pad0.98x0.95mm_HandSolder
R1924: 100R / 0.25W; R_1206_3216Metric_Pad1.30x1.75mm_HandSolder
R2011, R2012, R2013, R2016, R2017: 0R SIERRA ONLY / DNP; R_0603_1608Metric_Pad0.98x0.95mm_HandSolder
R2024: 15kR; R_0603_1608Metric_Pad0.98x0.95mm_HandSolder
SW201: RESET; SW_SPST_TL3342
SW801: PROCESSOR RECOVERY; SW_SPST_TL3342
SW802: PROCESSOR / PMIC RESET; SW_SPST_TL3342
T1701: HX4110NLT; Sierra_HX4110NL_2x12_P1.27mm
T1702: 30uH; TI_Wurth_EFD25_4476
TP1101: EMMC_CLK; TestPoint_Pad_D1.0mm
TP1102: EMMC_D0; TestPoint_Pad_D1.0mm
TP1103: GND; TestPoint_Pad_D1.0mm
TP1719, TP1720, TP1721, TP1722, TP1723, TP1724, TP1725, TP1726, TP1727: 5019; TI_Keystone_5019
U201: STM32G0B1CCT6; LQFP-48_7x7mm_P0.5mm
U202: TPS3828-33DBVR; SOT-23-5_HandSoldering
U401: TPS62177DQCR; WSON-10-1EP_2x3mm_P0.5mm_EP0.84x2.4mm_ThermalVias
U501: RK809-5; ArtInChip_QFN-68-1EP_7x7mm_P0.35mm_EP5.49x5.49mm_ThermalVias
U601: MP2143DJ-LF-Z; TSOT-23-8_HandSoldering
U602: SN74LVC1G17DBVR; SOT-23-5_HandSoldering
U701: TPS56837RPAR; Texas_RPA0010A_TPS56837
U801: RK3566; Sierra_RK3566_BGA565
U901: MT53E512M32D1ZW-046 WT:B; Sierra_Micron_ZW_TFBGA200
U902, U1503: SY8089AAAC; SOT-23-5_HandSoldering
U1001: TCS4525_WT; WLCSP-20_L2.0-W1.6-R5-C4-P0.40-TL
U1101: IS21TF16G-JCLI; LFBGA-153_11.5x13mm_Layout14x14_P0.5mm
U1201, U1202, U1203, U1501: SN74LVC1G125DCKR; SOT-353_SC-70-5
U1301: RTL8125BG-CG; TQFN-48_L6.0-W6.0-P0.40-BL-EP4.5
U1302: 93LC46BT-I/SN; SOIC-8_3.9x4.9mm_P1.27mm
U1502: TPS22965DSGR; Texas_DSG0008A_WSON-8-1EP_2x2mm_P0.5mm_EP0.9x1.6mm
U1504: TPS3808G33DBVR; SOT-23-6_Handsoldering
U1505, U1903: TPS3808G01DBVR; SOT-23-6_Handsoldering
U1601, U1602, U1603: SN74LVC1G07DCKR; SOT-353_SC-70-5
U1604, U2001: TMUXHS4212IRKSR; DHVQFN-20-1EP_2.5x4.5mm_P0.5mm_EP1x3mm
U1701: TPS2373-3RGWR; Texas_RGW0020A_VQFN-20-1EP_5x5mm_P0.65mm_EP3.15x3.15mm
U1702: LM51551QDSSRQ1; WSON-12-1EP_3x2mm_P0.5mm_EP1x2.65
U1703: FOD817AS; TI_N04C
U1704: TL431LIAIDBZR; SOT-23_Handsoldering
U1801, U1802, U1803: TLP293(GB-TPL,E); SOP-4_L4.4-W2.8-P1.27-LS7.0-BR
U1901: TPS54620RHLR; VQFN-14_L3.5-W3.5-P0.50-TL-EP_TPS54622RHLT
U1902: TPS259474LRPWR; VQFN-10_L2.0-W2.0-P0.45-TL
U1904: SN74LVC1G04DCKR; SOT-353_SC-70-5
U2002: TS3USB221ARSER; UQFN-10_L2.0-W1.5-P0.50-BL
U2003: SN74LVC1G08DCKR; SOT-353_SC-70-5
Y1101: SiT8008BI-21-18E-24.000000; Oscillator_SMD_SiT_PQFN-4Pin_3.2x2.5mm
Y1301: 25MHz, 18pF; Crystal_SMD_TXC_7M-4Pin_3.2x2.5mm_HandSoldering

Connections:
3V3_MAIN: C519.1, C524.1, C538.1, C602.1, C603.1, C817.1, C955.1, C1101.1, C1201.1, C1209.1, C1434.1, C1501.1, L601.2, R601.1, U501.4 (VCC7), U501.22 (VCC5), U501.57 (VCC8), U601.5 (OUT), U801.1D13 (VCCIO1), U801.1H18 (USB_AVDD1_3V3), U801.1J2 (USB_AVDD2_3V3), U801.1N8 (VCCIO7), U902.4 (IN), U1101.E6 (VCC), U1101.F5 (VCC), U1101.J10 (VCC), U1101.K9 (VCC), U1501.5 (VCC), U1502.1 (VIN), U1502.2 (VIN)
5V_MAIN: C504.1, C508.1, C512.1, C514.1, C516.1, C533.1, C537.1, C601.1, C706.1, C707.1, C903.1, C1001.1, C1002.1, C1504.1, L701.2, R506.1, R603.1, R605.1, R702.1, U501.10 (VCC2), U501.11 (VCC1), U501.24 (VCC3), U501.30 (VCC6), U501.33 (VCC_SPK_HP), U501.45 (VCC_RTC), U501.54 (VCC9), U501.66 (VCC4), U601.2 (VIN), U1001.D1 (AVIN), U1001.D2 (PVIN), U1001.E1 (PVIN), U1001.E2 (PVIN), U1502.4 (VBIAS)
+3V3: C201.1, C202.1, C203.1, C204.1, C402.1, C403.1, C604.1, C1210.1, C1913.1, C1914.1, C2003.1, C2004.1, C2005.1, J101.1, J201.1, L401.2, R201.1, R203.1, R401.1, R706.1, R1811.1, R1812.1, R1813.1, R1906.1, R1918.1, R1923.1, R1926.1, R2003.1, U201.4 (VBAT), U201.5 (VREF+), U201.6 (VDD), U202.5 (V_{DD}), U401.8 (~SLEEP), U401.10 (VOS), U602.5 (VCC), U1201.5 (VCC), U1903.3 (MR), U1903.6 (VDD), U1904.5 (VCC), U2001.1 (RSVD1), U2001.6 (VCC), U2001.10 (RSVD2), U2002.10 (VCC), U2003.5 (VCC)
/Main 3.3V/MAIN3V3_EN: R603.2, R604.1, U601.8 (EN)
/Main 3.3V/MAIN3V3_FB: R601.2, R602.1, U601.7 (FB)
/Main 3.3V/MAIN3V3_PG_5V: R605.2, R606.1, U601.1 (PG), U602.2
/Main 5V control/MAIN5V_FB: R702.2, R703.1, U701.2 (FB)
/Main 5V control/MAIN5V_MODE: R701.1, U701.10 (MODE)
/Main 5V control/MAIN5V_SW: C701.2, L701.1, U701.6 (SW)
/Processor PMIC/PMIC_INTERNAL_1V8A: C535.1, U501.44 (VCC_1P8A)
/Processor PMIC/PMIC_INTERNAL_1V8D: C536.1, U501.48 (VCC_1P8D)
/Processor PMIC/PMIC_PWRON_N: C532.1, Q501.3 (C), U501.52 (PWRON)
/Processor PMIC/PMIC_SW1: L501.1, U501.12 (SW1)
/Processor PMIC/PMIC_SW2: L502.1, U501.9 (SW2)
/Processor PMIC/PMIC_SW4: L504.1, U501.65 (SW4)
/Processor PMIC/PMIC_SW5: L505.1, U501.53 (SW5)
/Processor PMIC/PMIC_VDC: C531.1, R506.2, R507.1, U501.61 (VDC)
/Processor PMIC/UNUSED_CODEC_BCLK: R511.1, U501.15 (BCLK)
/Processor PMIC/UNUSED_CODEC_LRCLK: R510.1, U501.14 (LRCLK)
/Processor PMIC/UNUSED_LDO1: C545.1, U501.23 (LDO1)
/Processor PMIC/UNUSED_LDO4: C546.1, U501.28 (LDO4)
/Processor PMIC/UNUSED_LDO9: C547.1, U501.6 (LDO9)
/Processor PMIC/UNUSED_SWITCH1: C543.1, U501.55 (SWOUT1)
/Processor PMIC/UNUSED_SWITCH2: C544.1, U501.58 (SWOUT2)
/Recovery and always-on supply/ETH_RESET_ASSERT: R305.1, U201.17 (PA6)
/Recovery and always-on supply/MODEM_OFF_ASSERT: R303.1, U201.16 (PA5)
/Recovery and always-on supply/MODEM_RESET_ASSERT: R301.1, U201.15 (PA4)
/Recovery and always-on supply/POWER_FAULT_N: J102.9, R401.2, U201.20 (PB1), U401.7 (PG)
/Recovery and always-on supply/SERVICE_RX: J102.7, U201.14 (PA3)
/Recovery and always-on supply/SERVICE_TX: J102.6, U201.13 (PA2)
/Recovery and always-on supply/Supervisor/MANUAL_RESET_N: R203.2, SW201.1, U202.3 (~MR)
/Recovery and always-on supply/Supervisor/MCU_NRST_N: C205.1, J201.5, R201.2, U201.10 (PF2), U202.1 (~RESET)
/Recovery and always-on supply/Supervisor/SWCLK: J201.4, U201.36 (PA14)
/Recovery and always-on supply/Supervisor/SWDIO: J201.2, U201.35 (PA13)
/Recovery and always-on supply/Supervisor/WDT_INPUT: J202.2, U202.4 (WDI)
/Recovery and always-on supply/Supervisor/WDT_KICK: J202.1, R202.1, U201.19 (PB0)
BOB_SMITH_COMMON: C1865.1, R1861.2, R1862.2, R1863.2, R1864.2
BS_PAIR0: C1861.2, R1861.1
BS_PAIR1: C1862.2, R1862.1
BS_PAIR2: C1863.2, R1863.1
BS_PAIR3: C1864.2, R1864.1
CABLE_MDI0_N: J1701.2, T1701.22 (MX1-)
CABLE_MDI0_P: J1701.1, T1701.23 (MX1+)
CABLE_MDI1_N: J1701.6, T1701.19 (MX2-)
CABLE_MDI1_P: J1701.3, T1701.20 (MX2+)
CABLE_MDI2_N: J1701.5, T1701.16 (MX3-)
CABLE_MDI2_P: J1701.4, T1701.17 (MX3+)
CABLE_MDI3_N: J1701.8, T1701.13 (MX4-)
CABLE_MDI3_P: J1701.7, T1701.14 (MX4+)
CHASSIS: C1865.2, J1701.SH
CLK24_IN: R1106.2, U801.AD37 (XIN24M)
CPU_FB: C1441.2, R1401.2, R1411.2, U1001.A4 (FB)
CPU_SW: L1001.1, U1001.D3 (SW), U1001.D4 (SW), U1001.E3 (SW), U1001.E4 (SW)
DDR_A_CLKN: U801.B5 (AC24), U901.J9 (CK_c_A)
DDR_A_CLKP: U801.A5 (AC23), U901.J8 (CK_t_A)
DDR_A_DQS0N: U801.H1 (DDR_DQS0N_A), U901.E3 (DQS0_c_A)
DDR_A_DQS0P: U801.H2 (DDR_DQS0P_A), U901.D3 (DQS0_t_A)
DDR_A_DQS1N: U801.N2 (DDR_DQS1N_A), U901.E10 (DQS1_c_A)
DDR_A_DQS1P: U801.N1 (DDR_DQS1P_A), U901.D10 (DQS1_t_A)
DDR_B_CLKN: U801.B7 (AC9), U901.P9 (CK_c_B)
DDR_B_CLKP: U801.A7 (AC0), U901.P8 (CK_t_B)
DDR_B_DQS0N: U801.A12 (DDR_DQS0N_B), U901.V3 (DQS0_c_B)
DDR_B_DQS0P: U801.A13 (DDR_DQS0P_B), U901.W3 (DQS0_t_B)
DDR_B_DQS1N: U801.B17 (DDR_DQS1N_B), U901.V10 (DQS1_c_B)
DDR_B_DQS1P: U801.A17 (DDR_DQS1P_B), U901.W10 (DQS1_t_B)
DDR_FB: R901.2, R902.1, U501.27 (FB3)
DDR_SOC_RZQ: R904.1, U801.1F3 (DDR_RZQ)
DDR_VDDQ_EN: C960.1, R907.2, R908.1, U902.1 (EN)
DDR_VDDQ_FB: C959.2, R905.2, R906.1, U902.5 (FB)
DDR_VDDQ_SW: L902.1, U902.3 (LX)
DEBUG_UART_RX: U801.1V19 (GPIO0_D0_u), U1203.4
DEBUG_UART_TX: U801.1U18 (GPIO0_D1_u), U1202.2
EMMC_CLK: R1103.2, TP1101.1 (1_1), U1101.M6 (CLK)
EMMC_CLK_SOC: R1103.1, U801.A29 (GPIO1_C5_d)
EMMC_CMD: R1101.2, U801.A27 (GPIO1_C4_u), U1101.M5 (CMD)
EMMC_D0: R1102.2, TP1102.1 (1_1), U801.A32 (GPIO1_B4_u), U1101.A3 (DAT0)
EMMC_D1: U801.B27 (GPIO1_B5_u), U1101.A4 (DAT1)
EMMC_D2: U801.B32 (GPIO1_B6_u), U1101.A5 (DAT2)
EMMC_D3: U801.B29 (GPIO1_B7_u), U1101.B2 (DAT3)
EMMC_D4: U801.B33 (GPIO1_C0_u), U1101.B3 (DAT4)
EMMC_D5: U801.A30 (GPIO1_C1_u), U1101.B4 (DAT5)
EMMC_D6: U801.B30 (GPIO1_C2_u), U1101.B5 (DAT6)
EMMC_D7: U801.A33 (GPIO1_C3_u), U1101.B6 (DAT7)
EMMC_RESET_N: U801.1B16 (GPIO1_C7_d), U1101.K5 (RST_n)
EMMC_STROBE: R1104.1, U801.1A16 (GPIO1_C6_d), U1101.H5 (DS)
EMMC_VDDI: C1104.1, U1101.C2 (VDDI)
ETH_0V95: C1506.1, C1507.1, C1620.1, C1621.1, C1622.1, C1640.1, FB1303.1, FB1304.1, L1501.2, R1504.1, R1506.1, U1301.8 (DVDD09), U1301.28 (DVDD09), U1301.47 (DVDD09)
ETH_3V3: C1301.1, C1503.1, C1505.1, C1508.1, C1509.1, C1605.1, C1623.1, C1624.1, C1625.1, C1641.1, FB1301.1, FB1302.1, R1301.1, R1302.1, R1303.1, R1304.1, R1508.1, R1509.1, R1510.1, U1301.29 (DVDD33), U1301.43 (EVDD33), U1301.46 (DVDD33), U1302.8 (VCC), U1502.7 (VOUT), U1502.8 (VOUT), U1503.4 (IN), U1504.3 (MR), U1504.5 (SENSE), U1504.6 (VDD), U1505.3 (MR), U1505.6 (VDD), U1601.5 (VCC)
ETH_3V3_GOOD: R1510.2, R1604.1, U1504.1 (RESET)
ETH_ANALOG_0V95: C1626.1, C1627.1, C1628.1, C1642.1, FB1303.2, U1301.11 (AVDD09), U1301.16 (AVDD09), U1301.22 (AVDD09)
ETH_ANALOG_3V3: C1629.1, C1630.1, C1631.1, C1643.1, FB1301.2, U1301.15 (AVDD33), U1301.19 (AVDD33), U1301.33 (AVDD33)
ETH_CLKREQ_N: R1303.2, U1301.48 (CLKREQB), U1602.2 (A)
ETH_CLOCK_BASE: Q1601.1 (B), R1604.2, R1605.1
ETH_CLOCK_OE_N: Q1601.3 (C), R1606.2, U1604.2 (OEn)
ETH_CORE_EN: R1503.1, U1301.6 (POW_EXT_SWR), U1503.1 (EN)
ETH_CORE_FB: R1504.2, R1505.1, U1503.5 (FB)
ETH_CORE_SENSE: R1506.2, R1507.1, U1505.5 (SENSE)
ETH_CORE_SW: L1501.1, U1503.3 (LX)
ETH_CT0: C1851.1, T1701.1 (TCT1)
ETH_CT1: C1852.1, T1701.4 (TCT2)
ETH_CT2: C1853.1, T1701.7 (TCT3)
ETH_CT3: C1854.1, T1701.10 (TCT4)
ETH_EE_CLK: R1304.2, U1301.27 (LED1/EESK/SPISC), U1302.2 (CLK)
ETH_EE_CS: U1301.31 (EECS/SCL), U1302.1 (CS)
ETH_EE_DI: R1305.1, U1301.30 (LED0/EEDI/SPISI/SDA), U1302.3 (DI)
ETH_EE_DO: U1301.25 (LED2/EEDO/SPIS0), U1302.4 (DO)
ETH_EE_SEL: R1306.1, U1301.32 (EEPROM_SEL/PPS_PIN)
ETH_ISOLATE_N: R1301.2, U1301.1 (ISOLATEB)
ETH_MDI0_N: D1851.2 (IO2), T1701.3 (TD1-), U1301.14 (MDIN0)
ETH_MDI0_P: D1851.1 (IO1), T1701.2 (TD1+), U1301.13 (MDIP0)
ETH_MDI1_N: D1851.5 (IO4), T1701.6 (TD2-), U1301.18 (MDIN1)
ETH_MDI1_P: D1851.4 (IO3), T1701.5 (TD2+), U1301.17 (MDIP1)
ETH_MDI2_N: D1852.2 (IO2), T1701.9 (TD3-), U1301.21 (MDIN2)
ETH_MDI2_P: D1852.1 (IO1), T1701.8 (TD3+), U1301.20 (MDIP2)
ETH_MDI3_N: D1852.5 (IO4), T1701.12 (TD4-), U1301.24 (MDIN3)
ETH_MDI3_P: D1852.4 (IO3), T1701.11 (TD4+), U1301.23 (MDIP3)
ETH_PCIE_0V95: C1633.1, C1644.1, FB1304.2, U1301.37 (EVDD09)
ETH_PCIE_RXN: C1602.2, U1301.42 (HSIN)
ETH_PCIE_RXP: C1601.2, U1301.41 (HSIP)
ETH_PCIE_TXN: C1604.1, U1301.39 (HSON)
ETH_PCIE_TXP: C1603.1, U1301.38 (HSOP)
ETH_PERST_N: J102.5, Q303.3 (C), R1509.2, U1301.36 (PERSTB), U1505.1 (RESET), U1601.4 (Y)
ETH_REFCLK_N: U1301.45 (REFCLK_N), U1604.18 (B0N)
ETH_REFCLK_P: U1301.44 (REFCLK_P), U1604.19 (B0P)
ETH_RESET_CT: R1508.2, U1505.4 (CT)
ETH_RSET: R1307.1, U1301.12 (RSET)
ETH_SWITCH_CT: C1502.1, U1502.6 (CT)
ETH_SWITCH_EN: R1502.1, U1501.4, U1502.3 (ON)
ETH_WAKE_N: R1302.2, U1301.2 (LANWAKEB), U1603.2 (A)
ETH_XTAL_3V3: C1632.1, FB1302.2, U1301.34 (AVDD33_XTAL)
ETH_XTAL_IN: C1302.1, U1301.10 (CKXTAL1), Y1301.1
ETH_XTAL_OUT: C1303.1, U1301.9 (CKXTAL2), Y1301.3
FLASH_VOL_SEL: R1201.2, U801.AF38 (GPIO0_A7_u)
GND: C201.2, C202.2, C203.2, C204.2, C205.2, C401.2, C402.2, C403.2, C501.2, C502.2, C503.2, C504.2, C505.2, C506.2, C507.2, C508.2, C509.2, C510.2, C511.2, C512.2, C513.2, C514.2, C515.2, C516.2, C517.2, C518.2, C519.2, C520.2, C521.2, C522.2, C523.2, C524.2, C525.2, C526.2, C527.2, C528.2, C529.2, C530.2, C531.2, C532.2, C533.2, C535.2, C536.2, C537.2, C538.2, C541.2, C542.2, C543.2, C544.2, C545.2, C546.2, C547.2, C601.2, C602.2, C603.2, C604.2, C702.2, C703.2, C704.2, C705.2, C706.2, C707.2, C801.2, C802.2, C803.2, C804.2, C805.2, C806.2, C807.2, C808.2, C809.2, C810.2, C811.2, C812.2, C813.2, C814.2, C815.2, C816.2, C817.2, C818.2, C819.2, C820.2, C821.2, C822.2, C823.2, C824.2, C825.2, C826.2, C827.2, C828.2, C829.2, C830.2, C831.2, C832.2, C833.2, C834.2, C835.2, C836.2, C837.2, C838.2, C839.2, C840.2, C841.2, C842.2, C843.2, C844.2, C845.2, C846.2, C901.2, C902.2, C903.2, C905.2, C906.2, C907.2, C908.2, C909.2, C910.2, C911.2, C912.2, C913.2, C914.2, C915.2, C916.2, C917.2, C918.2, C919.2, C920.2, C921.2, C922.2, C923.2, C924.2, C925.2, C926.2, C927.2, C928.2, C929.2, C930.2, C931.2, C932.2, C933.2, C934.2, C935.2, C936.2, C937.2, C938.2, C939.2, C940.2, C941.2, C942.2, C943.2, C944.2, C945.2, C946.2, C947.2, C948.2, C949.2, C950.2, C951.2, C952.2, C953.2, C954.2, C955.2, C956.2, C957.2, C958.2, C960.2, C1001.2, C1002.2, C1003.2, C1004.2, C1005.2, C1006.2, C1007.2, C1008.2, C1009.2, C1101.2, C1102.2, C1103.2, C1104.2, C1105.2, C1201.2, C1202.2, C1203.2, C1204.2, C1205.2, C1206.2, C1207.2, C1208.2, C1209.2, C1210.2, C1211.2, C1212.2, C1301.2, C1302.2, C1303.2, C1401.2, C1402.2, C1403.2, C1404.2, C1405.2, C1406.2, C1407.2, C1408.2, C1409.2, C1410.2, C1411.2, C1412.2, C1420.2, C1421.2, C1422.2, C1423.2, C1424.2, C1425.2, C1426.2, C1427.2, C1428.2, C1429.2, C1430.2, C1431.2, C1432.2, C1433.2, C1434.2, C1501.2, C1502.2, C1503.2, C1504.2, C1505.2, C1506.2, C1507.2, C1508.2, C1509.2, C1605.2, C1606.2, C1607.2, C1608.2, C1620.2, C1621.2, C1622.2, C1623.2, C1624.2, C1625.2, C1626.2, C1627.2, C1628.2, C1629.2, C1630.2, C1631.2, C1632.2, C1633.2, C1640.2, C1641.2, C1642.2, C1643.2, C1644.2, C1720.1, C1727.2 (-), C1728.2, C1729.2, C1730.2, C1731.2, C1736.1, C1746.2, C1801.2, C1802.2, C1803.2, C1851.2, C1852.2, C1853.2, C1854.2, C1902.2, C1903.2, C1904.2, C1905.2, C1906.2, C1907.2, C1908.2, C1909.2, C1910.2, C1911.2, C1912.2, C1913.2, C1914.2, C2003.2, C2004.2, C2005.2, C2021.2, C2022.2, C2023.2, C2024.2, C2030.2, C2031.2, C2032.2, C2033.2, C2034.2, C2035.2, C2036.2, C2037.2, C2038.2, C2041.2, C2042.2, C2043.2, C2044.2, C2045.2, D1201.3 (GND), D1718.1 (A), D1718.2 (A), D1851.3 (GND), D1851.8 (GND), D1852.3 (GND), D1852.8 (GND), D2001.3 (GND), D2001.8 (GND), J101.2, J102.10, J201.3, J201.6, J1201.5 (GND), J1201.6 (Front_shell), J1201.SH (Retention_shell), J1202.3, J1711.2, J2001.3 (GND), J2001.5 (GND), J2001.11 (GND), J2001.27 (GND), J2001.33 (GND), J2001.39 (GND), J2001.45 (GND), J2001.51 (GND), J2001.57 (GND), J2001.71 (GND), J2001.73 (GND), J2002.4 (GND), J2002.9 (SHELL), J2002.10 (SHELL), J2002.11 (SHELL), J2002.12 (SHELL), Q301.2 (E), Q302.2 (E), Q303.2 (E), Q501.2 (E), Q801.2 (E), Q802.2 (E), Q1201.2 (E), Q1601.2 (E), Q1901.2 (S), Q2001.2 (E), R202.2, R302.2, R304.2, R306.2, R307.2, R308.2, R505.2, R507.2, R509.2, R510.2, R511.2, R602.2, R604.2, R606.2, R701.2, R703.2, R705.2, R803.2, R805.2, R902.2, R906.2, R908.2, R1001.2, R1104.2, R1206.2, R1207.2, R1208.2, R1209.2, R1211.2, R1305.2, R1306.2, R1307.2, R1501.2, R1502.2, R1503.2, R1505.2, R1507.2, R1605.2, R1744.1, R1747.1, R1748.1, R1761.1, R1902.2, R1903.2, R1905.2, R1912.2, R1914.2, R1916.2, R1917.2, R1922.2, R1925.2, R2002.2, R2015.2, SW201.2, SW801.2, SW802.2, TP1103.1 (1_1), TP1722.1, U201.7 (VSS), U202.2 (GND), U401.1 (PGND), U401.4 (NC), U401.5 (FB), U401.6 (AGND), U401.11 (PAD), U501.16 (MCLK), U501.17 (SDI), U501.40 (HP_SNS), U501.47 (GNDREF), U501.56 (BATDIV), U501.62 (SNSP), U501.63 (SNSN), U501.69 (EPAD), U601.4 (PGND), U601.6 (AGND), U602.3 (GND), U701.3 (AGND), U701.9 (PGND), U801.1A19 (SARADC_VIN3), U801.1B10 (VSS_30), U801.1B11 (VSS_31), U801.1B15 (VSS_32), U801.1B18 (SARADC_VIN2), U801.1B19 (VSS_33), U801.1C4 (VSS_34), U801.1C5 (VSS_35), U801.1C6 (VSS_36), U801.1C8 (VSS_37), U801.1C9 (VSS_38), U801.1C14 (VSS_39), U801.1C16 (VSS_40), U801.1C17 (SARADC_VIN1), U801.1C18 (VSS_41), U801.1D1 (VSS_42), U801.1D3 (VSS_43), U801.1D4 (DDR_AVSS), U801.1D10 (VSS_44), U801.1D14 (VSS_45), U801.1E3 (VSS_46), U801.1E8 (VSS_47), U801.1E10 (VSS_48), U801.1E14 (VSS_49), U801.1E15 (VSS_50), U801.1E17 (VSS_51), U801.1F6 (VSS_52), U801.1F7 (VSS_53), U801.1F8 (VSS_54), U801.1F9 (VSS_55), U801.1F10 (VSS_56), U801.1F15 (VSS_57), U801.1F16 (VSS_58), U801.1F20 (AVSS1_6), U801.1G3 (VSS_59), U801.1G6 (VSS_60), U801.1G7 (VSS_61), U801.1G8 (VSS_62), U801.1G9 (VSS_63), U801.1G10 (VSS_64), U801.1G11 (VSS_65), U801.1G12 (VSS_66), U801.1G14 (VSS_67), U801.1G16 (AVSS1_7), U801.1G18 (AVSS1_8), U801.1G19 (AVSS1_9), U801.1G20 (AVSS1_10), U801.1H1 (VSS_68), U801.1H2 (VSS_69), U801.1H6 (VSS_70), U801.1H11 (VSS_71), U801.1H12 (VSS_72), U801.1H13 (VSS_73), U801.1J1 (VSS_74), U801.1J5 (SYSPLL_AVSS), U801.1J6 (VSS_75), U801.1J8 (VSS_76), U801.1J9 (VSS_77), U801.1J11 (VSS_78), U801.1J12 (VSS_79), U801.1J13 (VSS_80), U801.1J16 (AVSS1_11), U801.1J18 (AVSS1_12), U801.1K2 (VSS_81), U801.1K3 (VSS_82), U801.1K4 (VSS_83), U801.1K5 (VSS_84), U801.1K6 (VSS_85), U801.1K8 (VSS_86), U801.1K9 (VSS_87), U801.1K11 (VSS_88), U801.1K12 (VSS_89), U801.1K13 (VSS_90), U801.1K14 (VSS_91), U801.1K15 (VSS_92), U801.1K18 (AVSS1_13), U801.1L3 (VSS_93), U801.1L6 (VSS_94), U801.1L10 (VSS_95), U801.1L11 (VSS_96), U801.1L12 (VSS_97), U801.1L13 (VSS_98), U801.1L14 (VSS_99), U801.1L15 (VSS_100), U801.1L19 (AVSS1_14), U801.1M3 (VSS_101), U801.1M4 (VSS_102), U801.1M5 (VSS_103), U801.1M6 (VSS_104), U801.1M10 (VSS_105), U801.1M11 (VSS_106), U801.1M12 (VSS_107), U801.1M13 (VSS_108), U801.1M14 (VSS_109), U801.1M15 (VSS_110), U801.1M16 (VSS_111), U801.1M17 (VSS_112), U801.1M20 (VSS_113), U801.1N3 (VSS_114), U801.1N4 (VSS_115), U801.1N7 (VSS_116), U801.1N11 (AVSS_9), U801.1N12 (AVSS_10), U801.1N17 (PMUPLL_AVSS), U801.1P1 (VSS_117), U801.1P5 (VSS_118), U801.1P6 (VSS_119), U801.1P7 (VSS_120), U801.1P8 (AVSS_11), U801.1P10 (AVSS_12), U801.1P14 (AVSS_13), U801.1P15 (VSS_121), U801.1R3 (VSS_122), U801.1R4 (VSS_123), U801.1R5 (VSS_124), U801.1R6 (VSS_125), U801.1R7 (VSS_126), U801.1R8 (AVSS_14), U801.1R9 (AVSS_15), U801.1R11 (AVSS_16), U801.1R12 (AVSS_17), U801.1R13 (AVSS_18), U801.1R14 (AVSS_19), U801.1R15 (AVSS_20), U801.1T3 (VSS_127), U801.1T5 (VSS_128), U801.1T7 (AVSS_21), U801.1T8 (AVSS_22), U801.1T9 (AVSS_23), U801.1T10 (AVSS_24), U801.1T11 (AVSS_25), U801.1T12 (AVSS_26), U801.1T13 (AVSS_27), U801.1T14 (AVSS_28), U801.1T15 (AVSS_29), U801.1T16 (AVSS_30), U801.1T17 (AVSS_31), U801.1U2 (VSS_129), U801.1U12 (AVSS_32), U801.1U13 (AVSS_33), U801.1U15 (AVSS_34), U801.1U17 (AVSS_35), U801.1V1 (VSS_130), U801.1V4 (VSS_131), U801.1V7 (AVSS_36), U801.1V12 (AVSS_37), U801.1V13 (AVSS_38), U801.1V18 (AVSS_39), U801.A1 (VSS_1), U801.A2 (VSS_2), U801.A38 (VSS_3), U801.AA2 (VSS_18), U801.AC37 (VSS_24), U801.AD2 (VSS_19), U801.AE37 (VSS_25), U801.AH37 (VSS_26), U801.AL37 (VSS_27), U801.AP2 (VSS_20), U801.AP8 (VSS_22), U801.AP13 (AVSS_1), U801.AP16 (AVSS_2), U801.AP19 (AVSS_3), U801.AP22 (AVSS_4), U801.AP25 (AVSS_5), U801.AP28 (AVSS_6), U801.AP31 (AVSS_7), U801.AP34 (AVSS_8), U801.AP37 (VSS_28), U801.AR1 (VSS_21), U801.AR38 (VSS_29), U801.B1 (VSS_4), U801.B2 (VSS_5), U801.B6 (VSS_6), U801.B11 (VSS_7), U801.B14 (VSS_8), U801.B18 (VSS_9), U801.B21 (VSS_10), U801.B28 (VSS_11), U801.B31 (VSS_12), U801.D2 (VSS_13), U801.E37 (VSS_23), U801.H37 (AVSS1_1), U801.J2 (VSS_14), U801.L2 (VSS_15), U801.L37 (AVSS1_2), U801.P37 (AVSS1_3), U801.U2 (VSS_16), U801.U37 (AVSS1_4), U801.W2 (VSS_17), U801.Y37 (AVSS1_5), U901.A3 (VSS), U901.A10 (VSS), U901.AB3 (VSS), U901.AB5 (VSS), U901.AB8 (VSS), U901.AB10 (VSS), U901.C1 (VSS), U901.C5 (VSS), U901.C8 (VSS), U901.C12 (VSS), U901.D2 (VSS), U901.D4 (VSS), U901.D9 (VSS), U901.D11 (VSS), U901.E1 (VSS), U901.E5 (VSS), U901.E8 (VSS), U901.E12 (VSS), U901.G1 (VSS), U901.G2 (ODT_CA_A), U901.G3 (VSS), U901.G5 (VSS), U901.G8 (VSS), U901.G10 (VSS), U901.G12 (VSS), U901.J1 (VSS), U901.J3 (VSS), U901.J10 (VSS), U901.J12 (VSS), U901.K2 (VSS), U901.K4 (VSS), U901.K9 (VSS), U901.K11 (VSS), U901.N2 (VSS), U901.N4 (VSS), U901.N9 (VSS), U901.N11 (VSS), U901.P1 (VSS), U901.P3 (VSS), U901.P10 (VSS), U901.P12 (VSS), U901.T1 (VSS), U901.T2 (ODT_CA_B), U901.T3 (VSS), U901.T5 (VSS), U901.T8 (VSS), U901.T10 (VSS), U901.T12 (VSS), U901.V1 (VSS), U901.V5 (VSS), U901.V8 (VSS), U901.V12 (VSS), U901.W2 (VSS), U901.W4 (VSS), U901.W9 (VSS), U901.W11 (VSS), U901.Y1 (VSS), U901.Y5 (VSS), U901.Y8 (VSS), U901.Y12 (VSS), U902.2 (GND), U1001.A1 (VSEL), U1001.B2 (PGND), U1001.B3 (PGND/PG), U1001.B4 (AGND), U1001.C1 (PGND), U1001.C2 (PGND), U1001.C3 (PGND), U1001.C4 (PGND), U1101.A6 (VSS), U1101.C4 (VSSQ), U1101.E7 (VSS), U1101.G5 (VSS), U1101.H10 (VSS), U1101.J5 (VSS), U1101.K8 (VSS), U1101.N2 (VSSQ), U1101.N5 (VSSQ), U1101.P4 (VSSQ), U1101.P6 (VSSQ), U1201.1, U1201.3 (GND), U1202.1, U1202.3 (GND), U1203.1, U1203.3 (GND), U1301.40 (GND), U1301.49 (GND), U1302.5 (VSS), U1501.1, U1501.3 (GND), U1502.5 (GND), U1502.9 (EP), U1503.2 (GND), U1504.2 (GND), U1505.2 (GND), U1601.3 (GND), U1602.3 (GND), U1603.3 (GND), U1604.5 (GND), U1604.9 (SEL), U1604.11 (GND), U1604.20 (GND), U1604.21 (EP), U1704.3 (ANODE), U1801.3 (Emitter), U1802.3 (Emitter), U1803.3 (Emitter), U1901.2 (GND), U1901.3 (GND), U1901.15 (EP), U1902.8 (GND), U1903.2 (GND), U1904.3 (GND), U2001.5 (GND), U2001.9 (SEL), U2001.11 (GND), U2001.20 (GND), U2001.21 (EP), U2002.5 (GND), U2002.9 (S), U2003.3 (GND), Y1101.2 (GND), Y1301.2 (G), Y1301.4 (G)
GPU_FB: C1443.2, R1403.2, R1413.2, U501.8 (FB2)
ISO_12V: C401.1, C703.1, C704.1, C705.1, C1727.1 (+), C1731.1, C1905.1, C1906.1, C1907.1, J1711.1, J1712.1, L1708.2, R1753.2, TP1719.1, U401.2 (VIN), U401.3 (EN), U701.8 (VIN), U1901.4 (PVIN), U1901.5 (PVIN), U1901.6 (VIN)
LOGIC_FB: C1442.2, R1402.2, R1412.2, U501.13 (FB1)
LPDDR4_A0_A: U801.C2 (AC11), U901.H2 (CA0_A)
LPDDR4_A0_B: U801.A9 (AC13), U901.R2 (CA0_B)
LPDDR4_A1_A: U801.C1 (AC2), U901.J2 (CA1_A)
LPDDR4_A1_B: U801.B9 (AC6), U901.P2 (CA1_B)
LPDDR4_A2_A: U801.1C1 (AC15), U901.H9 (CA2_A)
LPDDR4_A2_B: U801.1B7 (AC18), U901.R9 (CA2_B)
LPDDR4_A3_A: U801.1B3 (AC12), U901.H10 (CA3_A)
LPDDR4_A3_B: U801.1B6 (AC4), U901.R10 (CA3_B)
LPDDR4_A4_A: U801.1B1 (AC14), U901.H11 (CA4_A)
LPDDR4_A4_B: U801.1A6 (AC19), U901.R11 (CA4_B)
LPDDR4_A5_A: U801.1A1 (AC16), U901.J11 (CA5_A)
LPDDR4_A5_B: U801.B8 (AC5), U901.P11 (CA5_B)
LPDDR4_CKE0_A: U801.B4 (AC22), U901.J4 (CKE0_A)
LPDDR4_CKE0_B: U801.1A3 (AC10), U901.P4 (CKE0_B)
LPDDR4_CS0n_A: U801.B3 (AC25), U901.H4 (CS0_A)
LPDDR4_CS0n_B: U801.1B5 (AC28), U901.R4 (CS0_B)
LPDDR4_DM0_A: U801.1E2 (DDR_DM0_A), U901.C3 (DMI0_A)
LPDDR4_DM0_B: U801.1B8 (DDR_DM0_B), U901.Y3 (DMI0_B)
LPDDR4_DM1_A: U801.1G1 (DDR_DM1_A), U901.C10 (DMI1_A)
LPDDR4_DM1_B: U801.1A11 (DDR_DM1_B), U901.Y10 (DMI1_B)
LPDDR4_DQ0_A: U801.G2 (DDR_DQ0_A), U901.B2 (DQ0_A)
LPDDR4_DQ0_B: U801.B12 (DDR_DQ0_B), U901.AA2 (DQ0_B)
LPDDR4_DQ1_A: U801.F2 (DDR_DQ1_A), U901.C2 (DQ1_A)
LPDDR4_DQ1_B: U801.B10 (DDR_DQ1_B), U901.Y2 (DQ1_B)
LPDDR4_DQ2_A: U801.F1 (DDR_DQ2_A), U901.E2 (DQ2_A)
LPDDR4_DQ2_B: U801.1A8 (DDR_DQ2_B), U901.V2 (DQ2_B)
LPDDR4_DQ3_A: U801.E1 (DDR_DQ3_A), U901.F2 (DQ3_A)
LPDDR4_DQ3_B: U801.1A7 (DDR_DQ3_B), U901.U2 (DQ3_B)
LPDDR4_DQ4_A: U801.M2 (DDR_DQ4_A), U901.F4 (DQ4_A)
LPDDR4_DQ4_B: U801.B13 (DDR_DQ4_B), U901.U4 (DQ4_B)
LPDDR4_DQ5_A: U801.K1 (DDR_DQ5_A), U901.E4 (DQ5_A)
LPDDR4_DQ5_B: U801.1A10 (DDR_DQ5_B), U901.V4 (DQ5_B)
LPDDR4_DQ6_A: U801.K2 (DDR_DQ6_A), U901.C4 (DQ6_A)
LPDDR4_DQ6_B: U801.1B9 (DDR_DQ6_B), U901.Y4 (DQ6_B)
LPDDR4_DQ7_A: U801.1E1 (DDR_DQ7_A), U901.B4 (DQ7_A)
LPDDR4_DQ7_B: U801.1A9 (DDR_DQ7_B), U901.AA4 (DQ7_B)
LPDDR4_DQ8_A: U801.P2 (DDR_DQ8_A), U901.B11 (DQ8_A)
LPDDR4_DQ8_B: U801.B19 (DDR_DQ8_B), U901.AA11 (DQ8_B)
LPDDR4_DQ9_A: U801.R1 (DDR_DQ9_A), U901.C11 (DQ9_A)
LPDDR4_DQ9_B: U801.A19 (DDR_DQ9_B), U901.Y11 (DQ9_B)
LPDDR4_DQ10_A: U801.R2 (DDR_DQ10_A), U901.E11 (DQ10_A)
LPDDR4_DQ10_B: U801.A20 (DDR_DQ10_B), U901.V11 (DQ10_B)
LPDDR4_DQ11_A: U801.T2 (DDR_DQ11_A), U901.F11 (DQ11_A)
LPDDR4_DQ11_B: U801.B20 (DDR_DQ11_B), U901.U11 (DQ11_B)
LPDDR4_DQ12_A: U801.M1 (DDR_DQ12_A), U901.F9 (DQ12_A)
LPDDR4_DQ12_B: U801.A15 (DDR_DQ12_B), U901.U9 (DQ12_B)
LPDDR4_DQ13_A: U801.1F2 (DDR_DQ13_A), U901.E9 (DQ13_A)
LPDDR4_DQ13_B: U801.B15 (DDR_DQ13_B), U901.V9 (DQ13_B)
LPDDR4_DQ14_A: U801.1F1 (DDR_DQ14_A), U901.C9 (DQ14_A)
LPDDR4_DQ14_B: U801.1C10 (DDR_DQ14_B), U901.Y9 (DQ14_B)
LPDDR4_DQ15_A: U801.1G2 (DDR_DQ15_A), U901.B9 (DQ15_A)
LPDDR4_DQ15_B: U801.B16 (DDR_DQ15_B), U901.AA9 (DQ15_B)
LPDDR4_RESETn: U801.1C7 (AC29), U901.T11 (RESET_n)
M2_PIN20: J2001.20 (PCIE_DIS_/_RESERVED), R2016.2
M2_PIN22: J2001.22 (VBUS_SENSE_/_RESERVED), R2017.2
M2_PIN24: C2036.1, J2001.24 (VCC_/_1V8_OUT), R2011.2
M2_PIN38: C2037.1, J2001.38 (VCC_/_WLAN_DISABLE), R2012.2
M2_PIN68: C2038.1, J2001.68 (VCC_/_RESERVED), R2013.2
MAIN3V3_GOOD: U201.44 (PB5), U602.4, U2003.1 (A)
MAIN5V_GOOD: R706.2, U201.46 (PB7), U701.4 (PG)
MCU_ETH_POWER_EN: J102.2, R308.1, R1501.1, U201.12 (PA1), U1501.2
MCU_HEALTH_IN: J102.8, R1208.1, U201.18 (PA7), U1201.4
MCU_MAIN5V_EN: R704.1, U201.45 (PB6)
MCU_MODEM_POWER_EN: J102.1, R307.1, R1904.1, R1911.1, R1925.1, U201.11 (PA0), U1904.2
MCU_PROCESSOR_RECOVERY_ASSERT: R804.1, U201.42 (PB3)
MCU_PROCESSOR_RESET_ASSERT: R802.1, U201.21 (PB2)
MCU_PWRON_KICK: R508.1, U201.43 (PB4)
MODEM_3V7_RAW: C1902.1, C1903.1, C1904.1, C1912.1, L1901.2, R1901.1, R1913.1, U1902.5 (IN)
MODEM_BUCK_BOOT: C1901.1, U1901.13 (BOOT)
MODEM_BUCK_COMP: C1910.1, R1907.1, U1901.8 (COMP)
MODEM_BUCK_EN: R1904.2, R1905.1, U1901.10 (EN)
MODEM_BUCK_FB: R1901.2, R1902.1, U1901.7 (VSENSE)
MODEM_BUCK_GOOD: R1906.2, U201.27 (PB15), U1901.14 (PWRGD)
MODEM_BUCK_RT: R1903.1, U1901.1 (RT/CLK)
MODEM_BUCK_SS: C1908.1, U1901.9 (SS/TR)
MODEM_BUCK_SW: C1901.2, L1901.1, U1901.11 (PH), U1901.12 (PH)
MODEM_COMP_RC: C1909.1, R1907.2
MODEM_DISCHARGE_DRAIN: Q1901.3 (D), R1924.2
MODEM_DISCHARGE_GATE: Q1901.1 (G), U1904.4
MODEM_FUSE_DVDT: C1911.1, U1902.7 (DVDT)
MODEM_FUSE_EN: R1911.2, R1912.1, U1902.1 (EN/UVLO)
MODEM_FUSE_ILM: R1917.1, U1902.9 (ILM)
MODEM_FUSE_OVLO: R1913.2, R1914.1, U1902.2 (OVLO/OVCSEL)
MODEM_FUSE_PGTH: R1915.2, R1916.1, U1902.4 (PGTH/~FLT)
MODEM_MON_CT: R1926.2, U1903.4 (CT)
MODEM_MON_SENSE: R1921.2, R1922.1, U1903.5 (SENSE)
MODEM_OFF_N: J102.4, J2001.6 (FULL_CARD_POWER_OFF_N), Q302.3 (C), R2018.2
MODEM_RAIL_GOOD: R1923.2, U201.25 (PB13), U1903.1 (RESET), U2003.2 (B)
MODEM_RESET_N: J102.3, J2001.67 (RESET_N), Q301.3 (C)
MODEM_RXN_PORT: J2001.35 (USB_RXN), U2001.18 (B0N)
MODEM_RXP_PORT: J2001.37 (USB_RXP), U2001.19 (B0P)
MODEM_SWITCH_GOOD: R1918.2, U201.26 (PB14), U1902.3 (PG/AUXOFF)
MODEM_TXN_AC: C2002.2, U2001.4 (A0n)
MODEM_TXN_PORT: J2001.29 (USB_TXN), U2001.16 (B1N)
MODEM_TXP_AC: C2001.2, U2001.3 (A0p)
MODEM_TXP_PORT: J2001.31 (USB_TXP), U2001.17 (B1P)
MODEM_USB_BASE: Q2001.1 (B), R2001.2, R2002.1
MODEM_USB_DM: U801.1J20 (USB3_HOST1_DM), U2002.7 (D-)
MODEM_USB_DM_PORT: J2001.9 (USB_DM), U2002.2 (1D-)
MODEM_USB_DP: U801.1J19 (USB3_HOST1_DP), U2002.8 (D+)
MODEM_USB_DP_PORT: J2001.7 (USB_DP), U2002.1 (1D+)
MODEM_USB_OE_N: Q2001.3 (C), R2003.2, U2001.2 (OEn), U2002.6 (~OE)
MODEM_USB_RXN: U801.V37 (USB3_HOST1_SSRXN), U2001.8 (A1n)
MODEM_USB_RXP: U801.V38 (USB3_HOST1_SSRXP), U2001.7 (A1p)
MODEM_USB_TXN_SOC: C2002.1, U801.W38 (USB3_HOST1_SSTXN)
MODEM_USB_TXP_SOC: C2001.1, U801.W37 (USB3_HOST1_SSTXP)
MODEM_USB_VALID: R2001.1, U2003.4 (Y)
MODEM_VCC: C2030.1, C2031.1, C2032.1, C2033.1, C2034.1, C2035.1, C2041.1, C2042.1, C2043.1, C2044.1, C2045.1, J2001.2 (VCC), J2001.4 (VCC), J2001.70 (VCC), J2001.72 (VCC), J2001.74 (VCC), R1915.1, R1921.1, R1924.1, R2011.1, R2012.1, R2013.1, R2014.1, R2017.1, R2018.1, U1902.6 (OUT)
MULTI_AVDD_0V9: C1401.1, C1402.1, C1403.1, FB1401.2, U801.1K16 (MULTI_PHY_AVDD_0V9)
MULTI_AVDD_1V8: C1404.1, C1405.1, C1406.1, FB1402.2, U801.1K17 (MULTI_PHY_AVDD_1V8)
NPU_FB: C1444.2, R512.2, R1414.2, U501.64 (FB4)
unnamed: C1720.2, C1723.1, C1724.1, C1725.1, C1726.2, L1707.2, R1733.2, T1702.1, T1702.2
unnamed: C1728.1, C1729.1, C1730.1, L1708.1, T1702.8, T1702.9
unnamed: C1732.2, R1736.2
unnamed: C1735.1, R1741.2, R1742.1
unnamed: C1737.2, R1747.2, R1748.2
unnamed: C1743.1, R1757.1
unnamed: C1745.2, R1760.2
unnamed: C1707.1, D1701.1 (K), D1702.1 (K), D1703.1 (K), D1704.1 (K), L1702.2
unnamed: C1707.2, C1709.2, C1710.2, C1711.2, C1712.2, D1706.2 (A), D1707.2 (A), D1708.2 (A), D1709.2 (A), L1702.3, Q1701.2 (S), Q1702.2 (S), Q1703.2 (S), Q1704.2 (S), R1713.1, R1714.1, R1715.1, R1716.1
unnamed: C1732.1, D1714.2 (A), Q1705.5 (D), Q1705.6 (D), Q1705.7 (D), Q1705.8 (D), T1702.3, T1702.4, TP1720.1
unnamed: C1726.1, D1714.1 (K), R1733.1
unnamed: D1715.2 (A), Q1705.4 (G), R1735.2, TP1721.1
unnamed: D1715.1 (K), R1735.1, U1702.3 (GATE)
unnamed: D1716.2 (A), J1712.2
unnamed: D1716.1 (K), R1744.2
unnamed: D1717.2 (A), R1739.1
unnamed: C1737.1, D1718.3 (K), T1702.11, T1702.12
unnamed: C1741.1, D1719.1 (K), R1745.1, R1746.2
unnamed: C1744.2, D1721.1 (A), R1756.1, R1760.1, U1703.2 (K), U1704.1 (CATHODE)
unnamed: C1746.1, D1721.3 (C), R1755.1
unnamed: D1721.2 (K), R1753.1, R1754.2, R1755.2, R1756.2, R1759.2, TP1727.1
unnamed: L1701.1, L1702.1
unnamed: L1702.4, L1703.1
unnamed: Q301.1 (B), R301.2, R302.1
unnamed: Q302.1 (B), R303.2, R304.1
unnamed: Q303.1 (B), R305.2, R306.1
unnamed: Q501.1 (B), R508.2, R509.1
unnamed: Q801.1 (B), R802.2, R803.1
unnamed: Q802.1 (B), R804.2, R805.1
unnamed: C1709.1, Q1701.1 (G), R1709.1, R1713.2
unnamed: C1710.1, Q1702.1 (G), R1710.1, R1714.2
unnamed: C1711.1, Q1703.1 (G), R1711.1, R1715.2
unnamed: C1712.1, Q1704.1 (G), R1712.1, R1716.2
unnamed: Q1705.1 (S), Q1705.2 (S), Q1705.3 (S), R1738.2, R1742.2
unnamed: C1734.1, Q1707.1 (B), U1702.9 (SS)
unnamed: C1738.1, Q1707.2 (E), R1746.1, R1757.2, R1762.1, TP1724.1, U1702.6 (COMP), U1703.4 (C)
unnamed: R1739.2, T1702.6
unnamed: L401.1, U401.9 (SW)
unnamed: C515.1, U501.46 (VREF)
unnamed: L601.1, U601.3 (SW)
unnamed: C701.1, U701.7 (BOOT)
unnamed: R704.2, R705.1, U701.1 (EN)
unnamed: C702.1, U701.5 (SS)
unnamed: R903.2, U901.A5 (ZQ0)
unnamed: R1741.1, U1702.5 (CS)
unnamed: R1740.2, U1702.11 (PGOOD)
unnamed: R1743.2, U1702.10 (RT)
unnamed: R1754.1, U1703.1 (A)
unnamed: C1744.1, C1745.1, R1759.1, R1761.2, U1704.2 (REF)
OSC24_OUT: R1106.1, Y1101.3 (OUT)
OSC_ENABLE: R1105.2, Y1101.1 (OE)
PCIE_CLKREQ_N: R1602.2, U801.AG37 (GPIO0_A5_d), U1602.4 (Y)
PCIE_PERST_SOC_N: U801.1R16 (GPIO0_B6_u), U1601.2 (A)
PCIE_REFCLK_N: U801.1K20 (PCIE20_REFCLKN), U1604.4 (A0n)
PCIE_REFCLK_P: U801.1K19 (PCIE20_REFCLKP), U1604.3 (A0p)
PCIE_RXN_SOC: C1604.2, U801.AB38 (PCIE20_RXN)
PCIE_RXP_SOC: C1603.2, U801.AB37 (PCIE20_RXP)
PCIE_TXN_SOC: C1602.1, U801.AA38 (PCIE20_TXN)
PCIE_TXP_SOC: C1601.1, U801.AA37 (PCIE20_TXP)
PCIE_WAKE_N: R1603.2, U801.1U20 (GPIO0_B5_u), U1603.4 (Y)
PMIC_CPU_EN: R1001.1, U501.60 (EXT_EN), U1001.A2 (EN)
PMIC_I2C_SCL: R502.2, U501.1 (SCL), U801.AJ37 (GPIO0_B1_u), U1001.A3 (SCL)
PMIC_I2C_SDA: R503.2, U501.2 (SDA), U801.AK38 (GPIO0_B2_u), U1001.B1 (SDA)
PMIC_INT_N: R504.2, U501.7 (INT), U801.1R19 (GPIO0_A3_u)
PMIC_SLEEP: R505.1, U501.49 (SLEEP), U801.1P19 (GPIO0_A2_d)
PMIC_SW3: L901.1, U501.25 (SW3)
POE_AMPS_CTL: R1730.1, U1701.8 (AMPS_CTL)
POE_BT: U1701.19 (BT), U1803.2 (Cathode)
POE_BT_LED_A: R1803.2, U1803.1 (Anode)
POE_BT_N: C1803.1, R1813.2, U201.24 (PB12), U1803.4 (Collector)
POE_CLSA: R1724.1, U1701.3 (CLSA)
POE_CLSB: R1727.1, U1701.6 (CLSB)
POE_DEN: R1723.2, U1701.2 (DEN)
POE_PAIR12: C1861.1, D1701.2 (A), D1706.1 (K), Q1701.3 (D), R1710.2, T1701.24 (MCT4)
POE_PAIR36: C1862.1, D1702.2 (A), D1707.1 (K), Q1702.3 (D), R1709.2, T1701.21 (MCT2)
POE_PAIR45: C1863.1, D1703.2 (A), D1708.1 (K), Q1703.3 (D), R1712.2, T1701.18 (MCT3)
POE_PAIR78: C1864.1, D1704.2 (A), D1709.1 (K), Q1704.3 (D), R1711.2, T1701.15 (MCT4)
POE_PWM_BIAS: R1763.2, U1702.1 (BIAS)
POE_REF: R1732.1, U1701.7 (REF)
POE_RTN: C1716.2, C1717.2, C1718.2, C1721.1, C1722.2, C1723.2, C1724.2, C1725.2, C1733.2, C1734.2, C1735.2, C1736.2, C1738.2, C1739.2, C1740.2, C1741.2, C1743.2, D1719.2 (A), Q1707.3 (C), R1736.1, R1737.1, R1738.1, R1743.1, T1702.5, TP1723.1, U1701.10 (APD), U1701.11 (RTN), U1701.12 (RTN), U1702.4 (PGND), U1702.7 (AGND), U1702.8 (FB), U1702.13 (EP), U1703.3 (E)
POE_TPH: U1701.18 (TPH), U1801.2 (Cathode)
POE_TPH_LED_A: R1801.2, U1801.1 (Anode)
POE_TPH_N: C1801.1, R1811.2, U201.22 (PB10), U1801.4 (Collector)
POE_TPL: U1701.17 (TPL), U1802.2 (Cathode)
POE_TPL_LED_A: R1802.2, U1802.1 (Anode)
POE_TPL_N: C1802.1, R1812.2, U201.23 (PB11), U1802.4 (Collector)
POE_UVLO: C1733.1, R1734.1, R1737.2, U1701.13 (PG), U1702.12 (UVLO/SYNC)
POE_VCIN: C1716.1, C1739.1, D1717.1 (K), TP1725.1, U1701.15 (VC_IN)
POE_VCOUT: C1718.1, C1740.1, R1740.1, R1745.2, R1762.2, R1763.1, R1801.1, R1802.1, R1803.1, TP1726.1, U1701.14 (VC_OUT), U1702.2 (VCC)
POE_VDD: C1708.1, C1717.1, C1719.1, C1721.2, C1722.1, D1705.1 (K), L1701.2, L1707.1, R1723.1, R1734.2, U1701.1 (VDD)
POE_VSS: C1708.2, C1719.2, D1705.2 (A), L1703.2, R1724.2, R1727.2, R1730.2, R1732.2, U1701.4 (VSS), U1701.5 (VSS), U1701.9 (MPS_DUTY), U1701.21 (PAD)
RECOVERY_DM_PORT: D1201.2 (D-), J1201.2 (D-), R1204.1
RECOVERY_DP_PORT: D1201.1 (D+), J1201.3 (D+), R1203.1
RECOVERY_USB_DM: R1204.2, U801.R38 (USB_OTG0_DM)
RECOVERY_USB_DP: R1203.2, U801.R37 (USB_OTG0_DP)
RECOVERY_VBUS: J1201.1 (VBUS), R1205.1
RECOVERY_VBUS_DET: R1205.2, R1206.1, U801.T38 (USB_OTG0_VBUSDET)
RK_RESET_N: C513.1, Q801.3 (C), Q1201.3 (C), R501.2, SW802.1, U501.67 (RESETB), U801.AG38 (nPOR_u)
SARADC_BOOT_KEY: C820.1, Q802.3 (C), R801.2, SW801.1, U801.1D17 (SARADC_VIN0)
SDMMC0_DET: R1202.2, U801.AF37 (GPIO0_A4_u)
SIERRA_USB_SELECT_1V8: R2014.2, R2015.1, R2016.1
SIM1_CLK: C2022.1, D2001.2 (IO2), J2002.3 (CLK), R2022.2
SIM1_CLK_MODEM: J2001.32 (SIM1_CLK), R2022.1
SIM1_DATA: C2023.1, D2001.4 (IO3), J2002.6 (I/O), R2023.2, R2024.2
SIM1_DATA_MODEM: J2001.34 (SIM1_DATA), R2023.1
SIM1_RESET: C2021.1, D2001.1 (IO1), J2002.2 (RST), R2021.2
SIM1_RESET_MODEM: J2001.30 (SIM1_RESET), R2021.1
SIM1_VCC: C2024.1, D2001.5 (IO4), J2001.36 (SIM1_VCC), J2002.1 (VCC), R2024.1
SOC_HEALTH: R1207.1, U801.AN37 (GPIO0_C4_d), U1201.2
THERMAL_RESET_BASE: Q1201.1 (B), R1210.2, R1211.1
TSADC_SHUTDOWN: R1210.1, U801.1R20 (GPIO0_A1_z)
UART_RX_PORT: J1202.2, R1209.1, U1203.2
UART_TX_PORT: J1202.1, U1202.4
USB2_AVDD_0V9: C1407.1, C1408.1, C1409.1, FB1403.2, U801.1J4 (USB_AVDD2_0V9)
USB2_AVDD_1V8: C1410.1, C1411.1, C1412.1, FB1404.2, U801.1J3 (USB_AVDD2_1V8)
USB_AVDD_0V9: C815.1, FB801.2, U801.1J17 (USB_AVDD1_0V9)
USB_AVDD_1V8: C816.1, FB802.2, U801.1H16 (USB_AVDD1_1V8)
VCC3V3_PMU: C517.1, C518.1, C811.1, C812.1, C1211.1, C1212.1, C1606.1, C1607.1, C1608.1, R501.1, R502.1, R503.1, R504.1, R1201.1, R1202.1, R1602.1, R1603.1, R1606.1, U501.31 (LDO6), U801.1N15 (PMUIO2), U801.1P16 (PMUIO1), U1202.5 (VCC), U1203.5 (VCC), U1602.5 (VCC), U1603.5 (VCC), U1604.1 (RSVD1), U1604.6 (VCC), U1604.10 (RSVD2)
VCCA1V8_PMU: C525.1, C526.1, C803.1, C804.1, C1105.1, R1105.1, U501.3 (LDO7), U801.1N18 (PMUPLL_AVDD_1V8), Y1101.4 (Vdd)
VCCA_1V8: C527.1, C528.1, C807.1, C808.1, C814.1, C818.1, C819.1, C1421.1, C1423.1, C1425.1, C1427.1, C1429.1, C1431.1, C1433.1, FB802.1, FB1402.1, FB1404.1, R801.1, U501.5 (LDO8), U801.1D15 (OTP_VCC18), U801.1D16 (SARADC_AVDD_1V8), U801.1G17 (EDP_TX_AVDD_1V8), U801.1H4 (SYSPLL_AVDD_1V8), U801.1P9 (MIPI_CSI_RX_AVDD_1V8), U801.1P12 (MIPI_DSI_TX0_AVDD_1V8), U801.1P13 (HDMI_TX_AVDD_1V8), U801.1R10 (MIPI_DSI_TX1_AVDD_1V8)
VCCIO_SD: C529.1, C530.1, C1203.1, U501.29 (LDO5), U801.1F17 (VCCIO3)
VCC_1V8: C509.1, C510.1, C511.1, C905.1, C906.1, C907.1, C908.1, C909.1, C910.1, C911.1, C912.1, C1102.1, C1103.1, C1202.1, C1204.1, C1205.1, C1206.1, C1207.1, C1208.1, L505.2, R907.1, R1101.1, R1102.1, U501.59 (FB5), U801.1C13 (VCCIO2), U801.1E16 (VCCIO4), U801.1L4 (VCCIO6_1), U801.1L5 (VCCIO6_2), U801.1N5 (VCCIO5_1), U801.1N6 (VCCIO5_2), U901.F1 (VDD1), U901.F12 (VDD1), U901.G4 (VDD1), U901.G9 (VDD1), U901.T4 (VDD1), U901.T9 (VDD1), U901.U1 (VDD1), U901.U12 (VDD1), U1101.C6 (VCCQ), U1101.M4 (VCCQ), U1101.N4 (VCCQ), U1101.P3 (VCCQ), U1101.P5 (VCCQ)
VDDA0V9_PMU: C522.1, C523.1, C801.1, C802.1, C809.1, C810.1, U501.20 (LDO3), U801.1N16 (PMU_VDD_LOGIC_0V9), U801.1P17 (PMUPLL_AVDD_0V9)
VDDA_0V9: C520.1, C521.1, C805.1, C806.1, C813.1, C1420.1, C1422.1, C1424.1, C1426.1, C1428.1, C1430.1, C1432.1, FB801.1, FB1401.1, FB1403.1, U501.21 (LDO2), U801.1H5 (SYSPLL_AVDD_0V9), U801.1H17 (EDP_TX_AVDD_0V9), U801.1N9 (MIPI_CSI_RX_AVDD_0V9), U801.1N10 (MIPI_DSI_TX1_AVDD_0V9), U801.1N13 (HDMI_TX_AVDD_0V9_2), U801.1N14 (HDMI_TX_AVDD_0V9_1), U801.1P11 (MIPI_DSI_TX0_AVDD_0V9)
VDD_CPU: C1003.1, C1004.1, C1005.1, C1006.1, C1007.1, C1008.1, C1009.1, C1441.1, L1001.2, R1401.1, R1411.1, U801.1C12 (VDD_CPU_1), U801.1D11 (VDD_CPU_2), U801.1D12 (VDD_CPU_3), U801.1E11 (VDD_CPU_4), U801.1E12 (VDD_CPU_5), U801.1E13 (VDD_CPU_6), U801.1F11 (VDD_CPU_7), U801.1F12 (VDD_CPU_8), U801.1F13 (VDD_CPU_9), U801.1F14 (VDD_CPU_10), U801.1G13 (VDD_CPU_11)
VDD_DDR_0V6: C842.1, C843.1, C844.1, C845.1, C846.1, C933.1, C934.1, C935.1, C936.1, C937.1, C938.1, C939.1, C940.1, C941.1, C942.1, C943.1, C944.1, C945.1, C946.1, C947.1, C948.1, C949.1, C950.1, C951.1, C952.1, C953.1, C954.1, C956.1, C957.1, C958.1, C959.1, L902.2, R903.1, R905.1, U801.1E6 (DDRPHY_VDDQL_1), U801.1E7 (DDRPHY_VDDQL_2), U801.1E9 (DDRPHY_VDDQL_3), U801.1F5 (DDRPHY_VDDQL_4), U801.1G5 (DDRPHY_VDDQL_5), U901.AA3 (VDDQ), U901.AA5 (VDDQ), U901.AA8 (VDDQ), U901.AA10 (VDDQ), U901.B3 (VDDQ), U901.B5 (VDDQ), U901.B8 (VDDQ), U901.B10 (VDDQ), U901.D1 (VDDQ), U901.D5 (VDDQ), U901.D8 (VDDQ), U901.D12 (VDDQ), U901.F3 (VDDQ), U901.F10 (VDDQ), U901.U3 (VDDQ), U901.U10 (VDDQ), U901.W1 (VDDQ), U901.W5 (VDDQ), U901.W8 (VDDQ), U901.W12 (VDDQ)
VDD_DDR_1V1: C837.1, C838.1, C839.1, C840.1, C841.1, C901.1, C902.1, C913.1, C914.1, C915.1, C916.1, C917.1, C918.1, C919.1, C920.1, C921.1, C922.1, C923.1, C924.1, C925.1, C926.1, C927.1, C928.1, C929.1, C930.1, C931.1, C932.1, L901.2, R901.1, R904.2, U501.26 (VBUCK3), U801.1D5 (DDRPHY_VDDQ_1), U801.1D6 (DDRPHY_VDDQ_2), U801.1D7 (DDRPHY_VDDQ_3), U801.1D8 (DDRPHY_VDDQ_4), U801.1D9 (DDRPHY_VDDQ_5), U801.1E4 (DDRPHY_VDDQ_6), U801.1F4 (DDRPHY_VDDQ_7), U801.1G4 (DDRPHY_VDDQ_8), U901.A4 (VDD2), U901.A9 (VDD2), U901.AB4 (VDD2), U901.AB9 (VDD2), U901.F5 (VDD2), U901.F8 (VDD2), U901.H1 (VDD2), U901.H5 (VDD2), U901.H8 (VDD2), U901.H12 (VDD2), U901.K1 (VDD2), U901.K3 (VDD2), U901.K10 (VDD2), U901.K12 (VDD2), U901.N1 (VDD2), U901.N3 (VDD2), U901.N10 (VDD2), U901.N12 (VDD2), U901.R1 (VDD2), U901.R5 (VDD2), U901.R8 (VDD2), U901.R12 (VDD2), U901.U5 (VDD2), U901.U8 (VDD2)
VDD_GPU: C505.1, C506.1, C507.1, C832.1, C833.1, C834.1, C835.1, C836.1, C1443.1, L502.2, R1403.1, R1413.1, U801.1L8 (VDD_GPU_1), U801.1L9 (VDD_GPU_2), U801.1M7 (VDD_GPU_3), U801.1M8 (VDD_GPU_4), U801.1M9 (VDD_GPU_5)
VDD_LOGIC: C501.1, C502.1, C503.1, C825.1, C826.1, C827.1, C828.1, C829.1, C830.1, C831.1, C1442.1, L501.2, R1402.1, R1412.1, U801.1H7 (VDD_LOGIC_1), U801.1H8 (VDD_LOGIC_2), U801.1H9 (VDD_LOGIC_3), U801.1H10 (VDD_LOGIC_4), U801.1J7 (VDD_LOGIC_5), U801.1J10 (VDD_LOGIC_6), U801.1K7 (VDD_LOGIC_7), U801.1K10 (VDD_LOGIC_8), U801.1L7 (VDD_LOGIC_9)
VDD_NPU: C541.1, C542.1, C821.1, C822.1, C823.1, C824.1, C1444.1, L504.2, R512.1, R1414.1, U801.1G15 (VDD_NPU_1), U801.1H14 (VDD_NPU_2), U801.1H15 (VDD_NPU_3), U801.1J14 (VDD_NPU_4), U801.1J15 (VDD_NPU_5)
