alxgmpr/sierra-to-usb/compact/carrier/carrier.kicad_pcb

## KiCad design compact/carrier/carrier.kicad_pcb (2026-09-09)

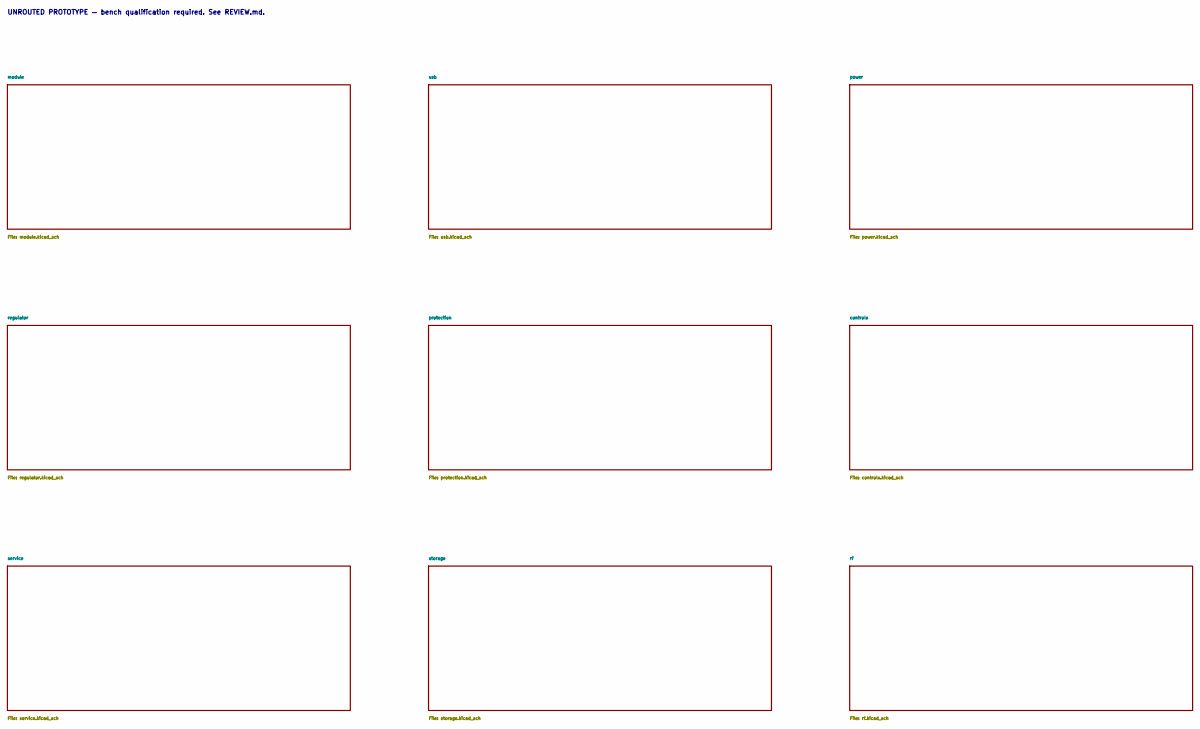
[picture p44: schematic carrier.kicad_sch, Compact USB-C modem carrier — placement review]

Notes on the sheet:
UNROUTED PROTOTYPE — bench qualification required. See REVIEW.md.
