alxgmpr/sierra-to-usb/compact/carrier/carrier.kicad_pcb

## KiCad design compact/carrier/carrier.kicad_pcb (continued)

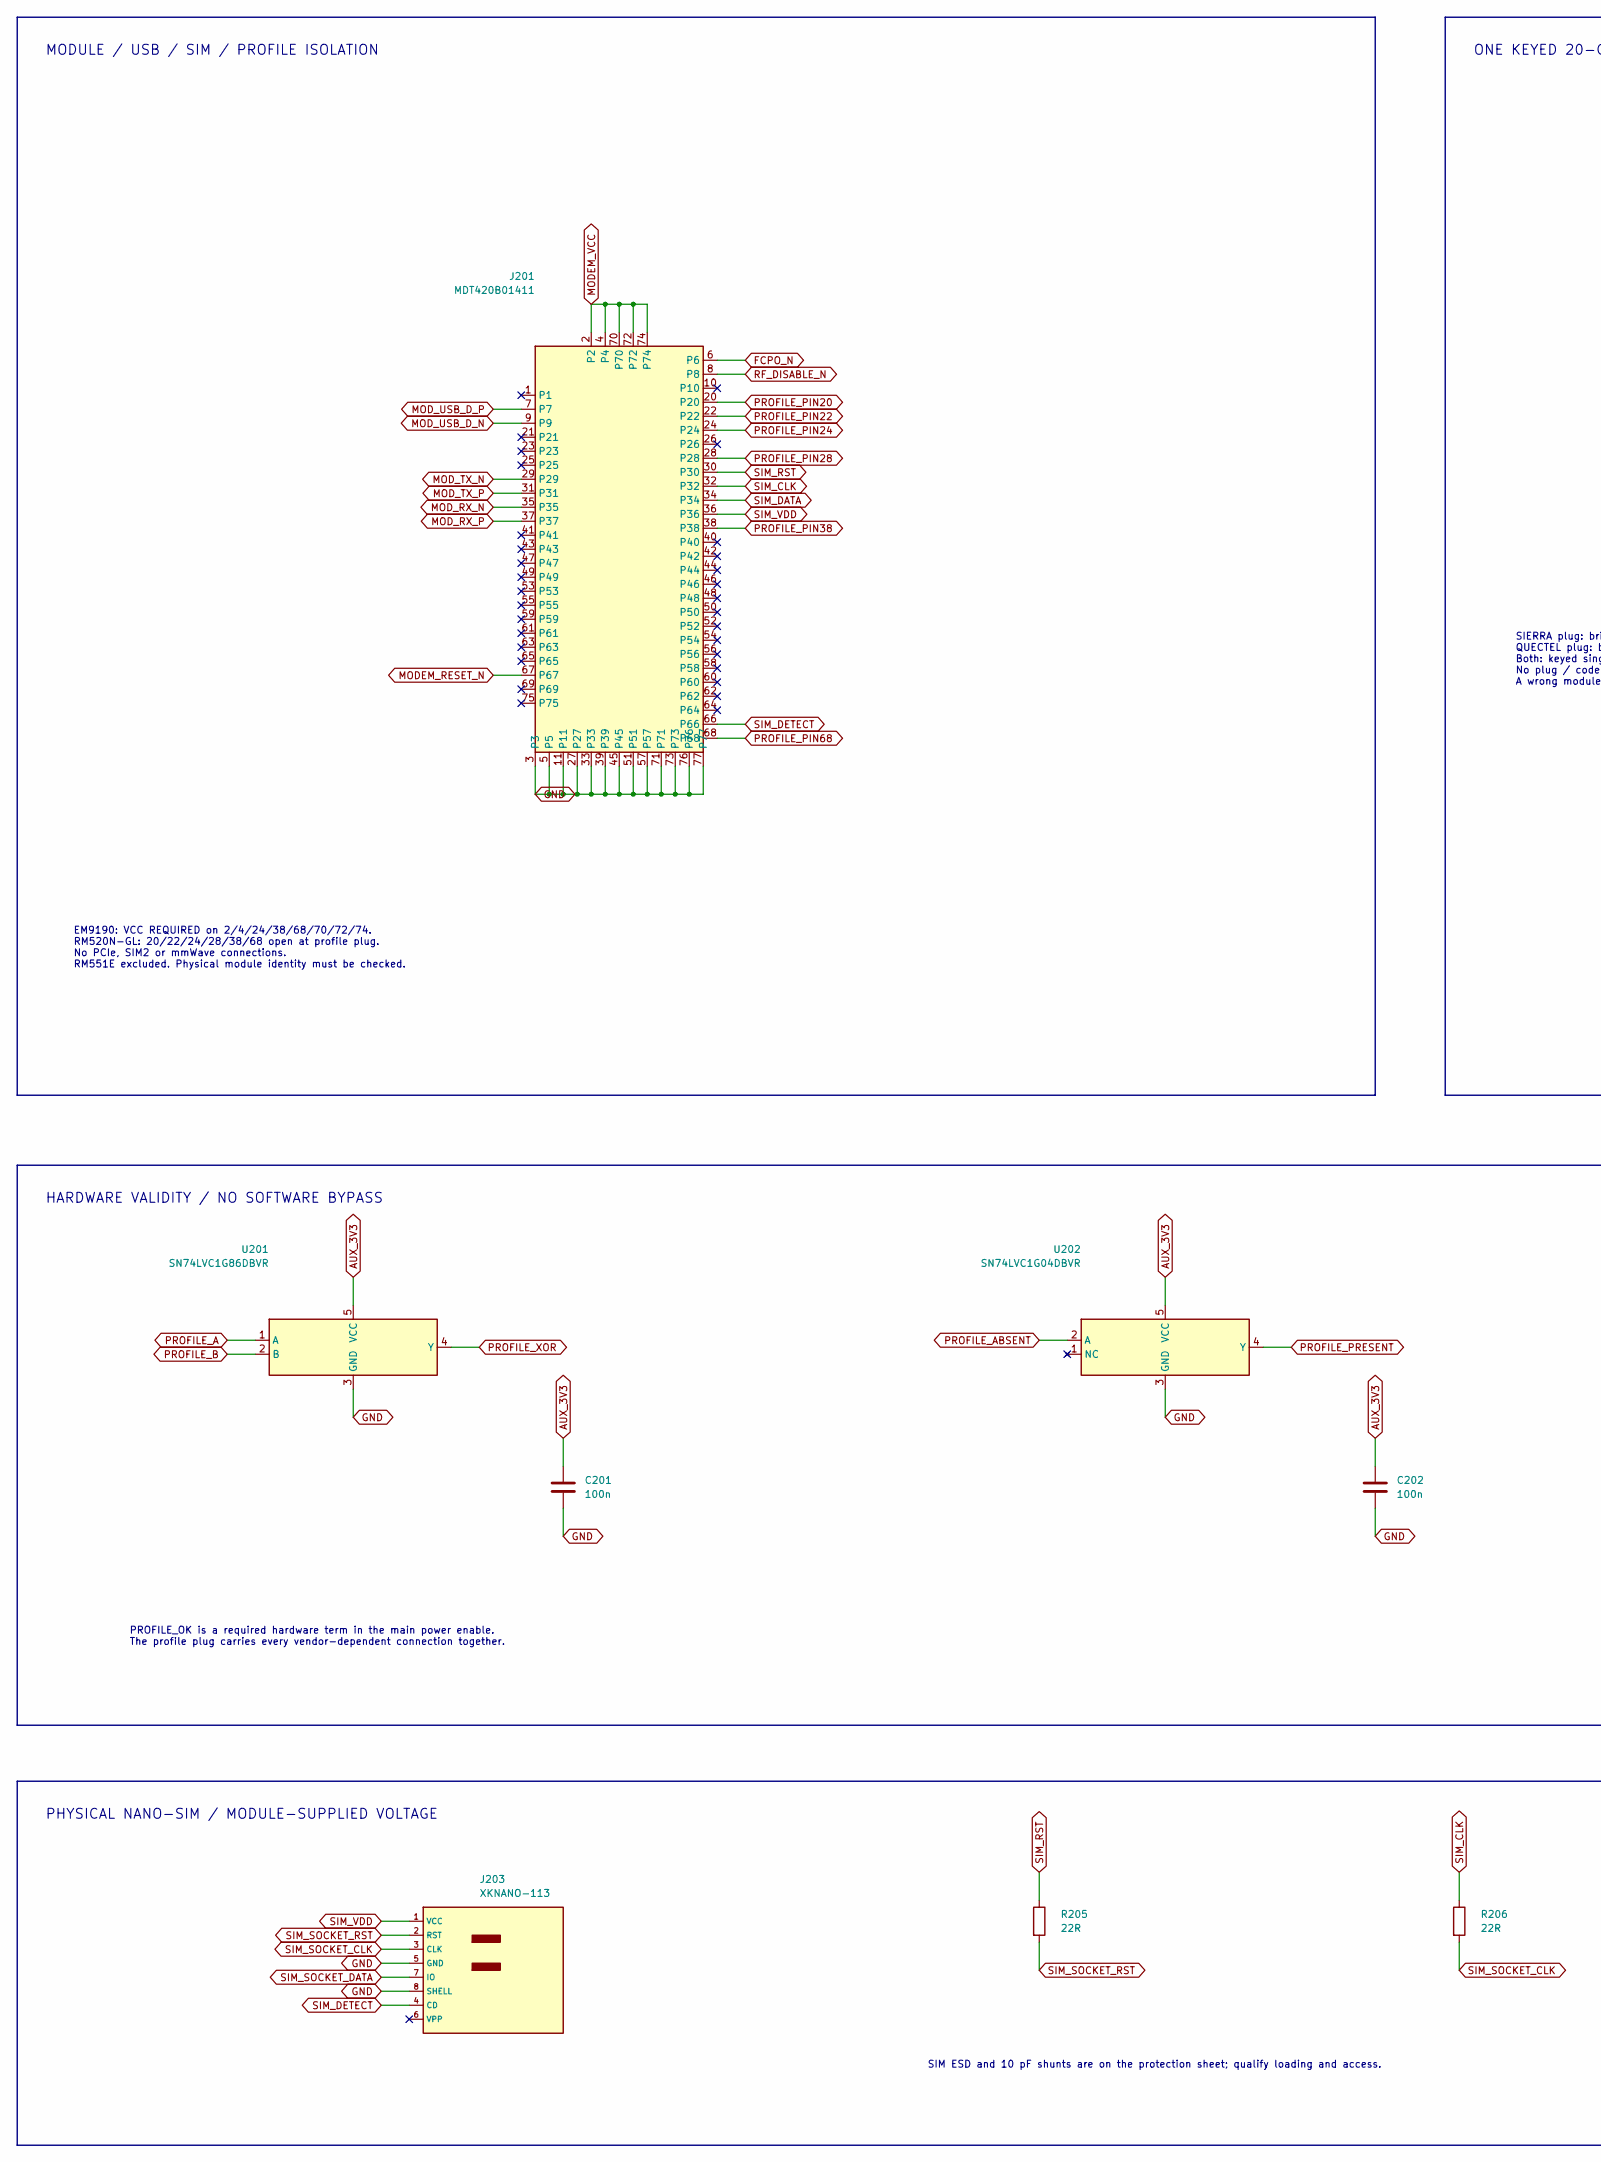
[picture p45: schematic module.kicad_sch, M.2 module, hardware profile and nano-SIM, part in row 1, column 1]

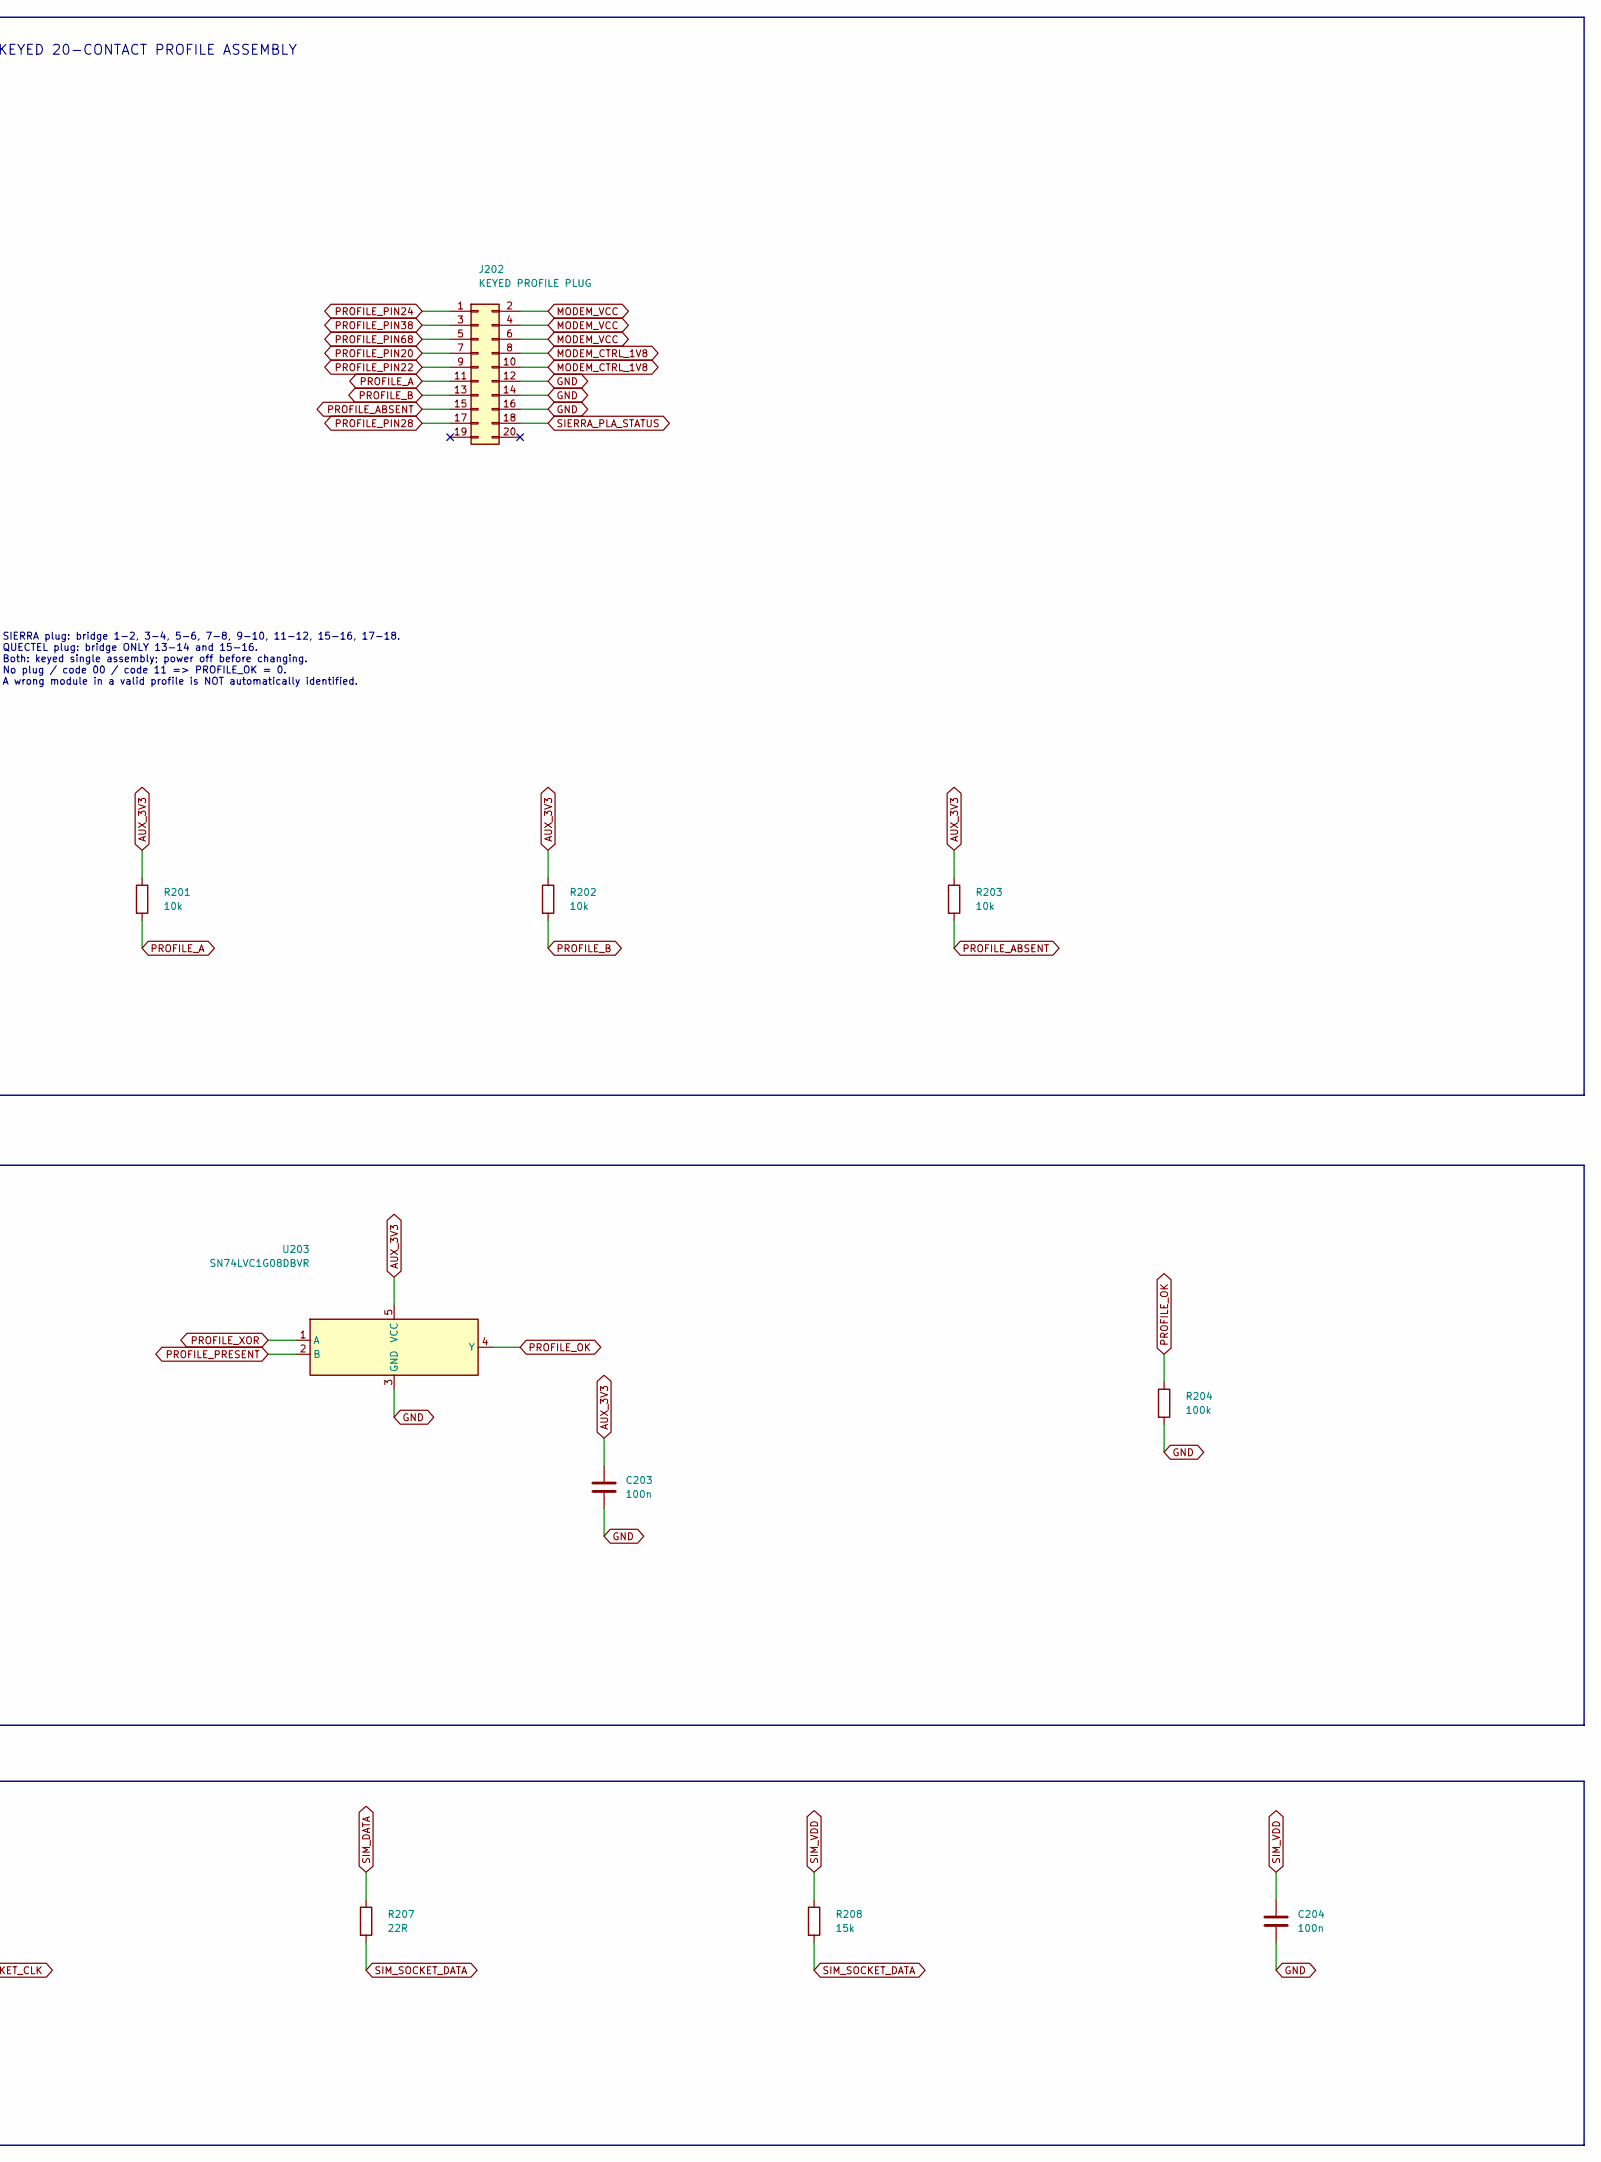
[picture p46: schematic module.kicad_sch, M.2 module, hardware profile and nano-SIM, part in row 1, column 2]

Parts:
C201, C202, C203, C204: 100n; C_0805_2012Metric; MPN C2012X7R1H104K085AA
J201: MDT420B01411; M2_B_Amphenol_MDT420_1A; MPN MDT420B01411
J202: KEYED PROFILE PLUG; IDC_3M_N2520_6002_RB; MPN N2520-6002-RB
J203: XKNANO-113; NanoSIM_XKB_XKNANO-113; MPN XKNANO-113; LCSC C381071
R201, R202, R203: 10k; R_0603_1608Metric; MPN RC0603FR-0710KL
R204: 100k; R_0603_1608Metric; MPN RC0603FR-07100KL
R205, R206, R207: 22R; R_0603_1608Metric; MPN ERJ-3EKF22R0V
R208: 15k; R_0603_1608Metric; MPN RC0603FR-0715KL
U201: SN74LVC1G86DBVR; SOT-23-5; MPN SN74LVC1G86DBVR
U202: SN74LVC1G04DBVR; SOT-23-5; MPN SN74LVC1G04DBVR
U203: SN74LVC1G08DBVR; SOT-23-5; MPN SN74LVC1G08DBVR

Connections:
AUX_3V3: C201.1, C202.1, C203.1, R201.1, R202.1, R203.1, U201.5 (VCC), U202.5 (VCC), U203.5 (VCC); also elsewhere on the board
FCPO_N: J201.6; also elsewhere on the board
GND: C201.2, C202.2, C203.2, C204.2, J201.3, J201.5, J201.11, J201.27, J201.33, J201.39, J201.45, J201.51, J201.57, J201.71, J201.73, J201.76, J201.77, J202.12, J202.14, J202.16, J203.5 (GND), J203.8 (SHELL), R204.2, U201.3 (GND), U202.3 (GND), U203.3 (GND); also elsewhere on the board
MODEM_CTRL_1V8: J202.8, J202.10; also elsewhere on the board
MODEM_RESET_N: J201.67; also elsewhere on the board
MODEM_VCC: J201.2, J201.4, J201.70, J201.72, J201.74, J202.2, J202.4, J202.6; also elsewhere on the board
MOD_RX_N: J201.35; also elsewhere on the board
MOD_RX_P: J201.37; also elsewhere on the board
MOD_TX_N: J201.29; also elsewhere on the board
MOD_TX_P: J201.31; also elsewhere on the board
MOD_USB_D_N: J201.9; also elsewhere on the board
MOD_USB_D_P: J201.7; also elsewhere on the board
PROFILE_A: J202.11, R201.2, U201.1 (A)
PROFILE_ABSENT: J202.15, R203.2, U202.2 (A)
PROFILE_B: J202.13, R202.2, U201.2 (B)
PROFILE_OK: R204.1, U203.4 (Y); also elsewhere on the board
PROFILE_PIN20: J201.20, J202.7
PROFILE_PIN22: J201.22, J202.9
PROFILE_PIN24: J201.24, J202.1
PROFILE_PIN28: J201.28, J202.17
PROFILE_PIN38: J201.38, J202.3
PROFILE_PIN68: J201.68, J202.5
PROFILE_PRESENT: U202.4 (Y), U203.2 (B)
PROFILE_XOR: U201.4 (Y), U203.1 (A)
RF_DISABLE_N: J201.8; also elsewhere on the board
SIERRA_PLA_STATUS: J202.18; also elsewhere on the board
SIM_CLK: J201.32, R206.1
SIM_DATA: J201.34, R207.1
SIM_DETECT: J201.66, J203.4 (CD)
SIM_RST: J201.30, R205.1
SIM_SOCKET_CLK: J203.3 (CLK), R206.2; also elsewhere on the board
SIM_SOCKET_DATA: J203.7 (IO), R207.2, R208.2; also elsewhere on the board
SIM_SOCKET_RST: J203.2 (RST), R205.2; also elsewhere on the board
SIM_VDD: C204.1, J201.36, J203.1 (VCC), R208.1; also elsewhere on the board

Notes on the sheet:
MODULE / USB / SIM / PROFILE ISOLATION
EM9190: VCC REQUIRED on 2/4/24/38/68/70/72/74. RM520N-GL: 20/22/24/28/38/68 open at profile plug. No PCIe, SIM2 or mmWave connections. RM551E excluded. Physical module identity must be checked.
ONE KEYED 20-CONTACT PROFILE ASSEMBLY
SIERRA plug: bridge 1-2, 3-4, 5-6, 7-8, 9-10, 11-12, 15-16, 17-18. QUECTEL plug: bridge ONLY 13-14 and 15-16. Both: keyed single assembly; power off before changing. No plug / code 00 / code 11 => PROFILE_OK = 0. A wrong module in a valid profile is NOT automatically identified.
HARDWARE VALIDITY / NO SOFTWARE BYPASS
PROFILE_OK is a required hardware term in the main power enable. The profile plug carries every vendor-dependent connection together.
PHYSICAL NANO-SIM / MODULE-SUPPLIED VOLTAGE
SIM ESD and 10 pF shunts are on the protection sheet; qualify loading and access.

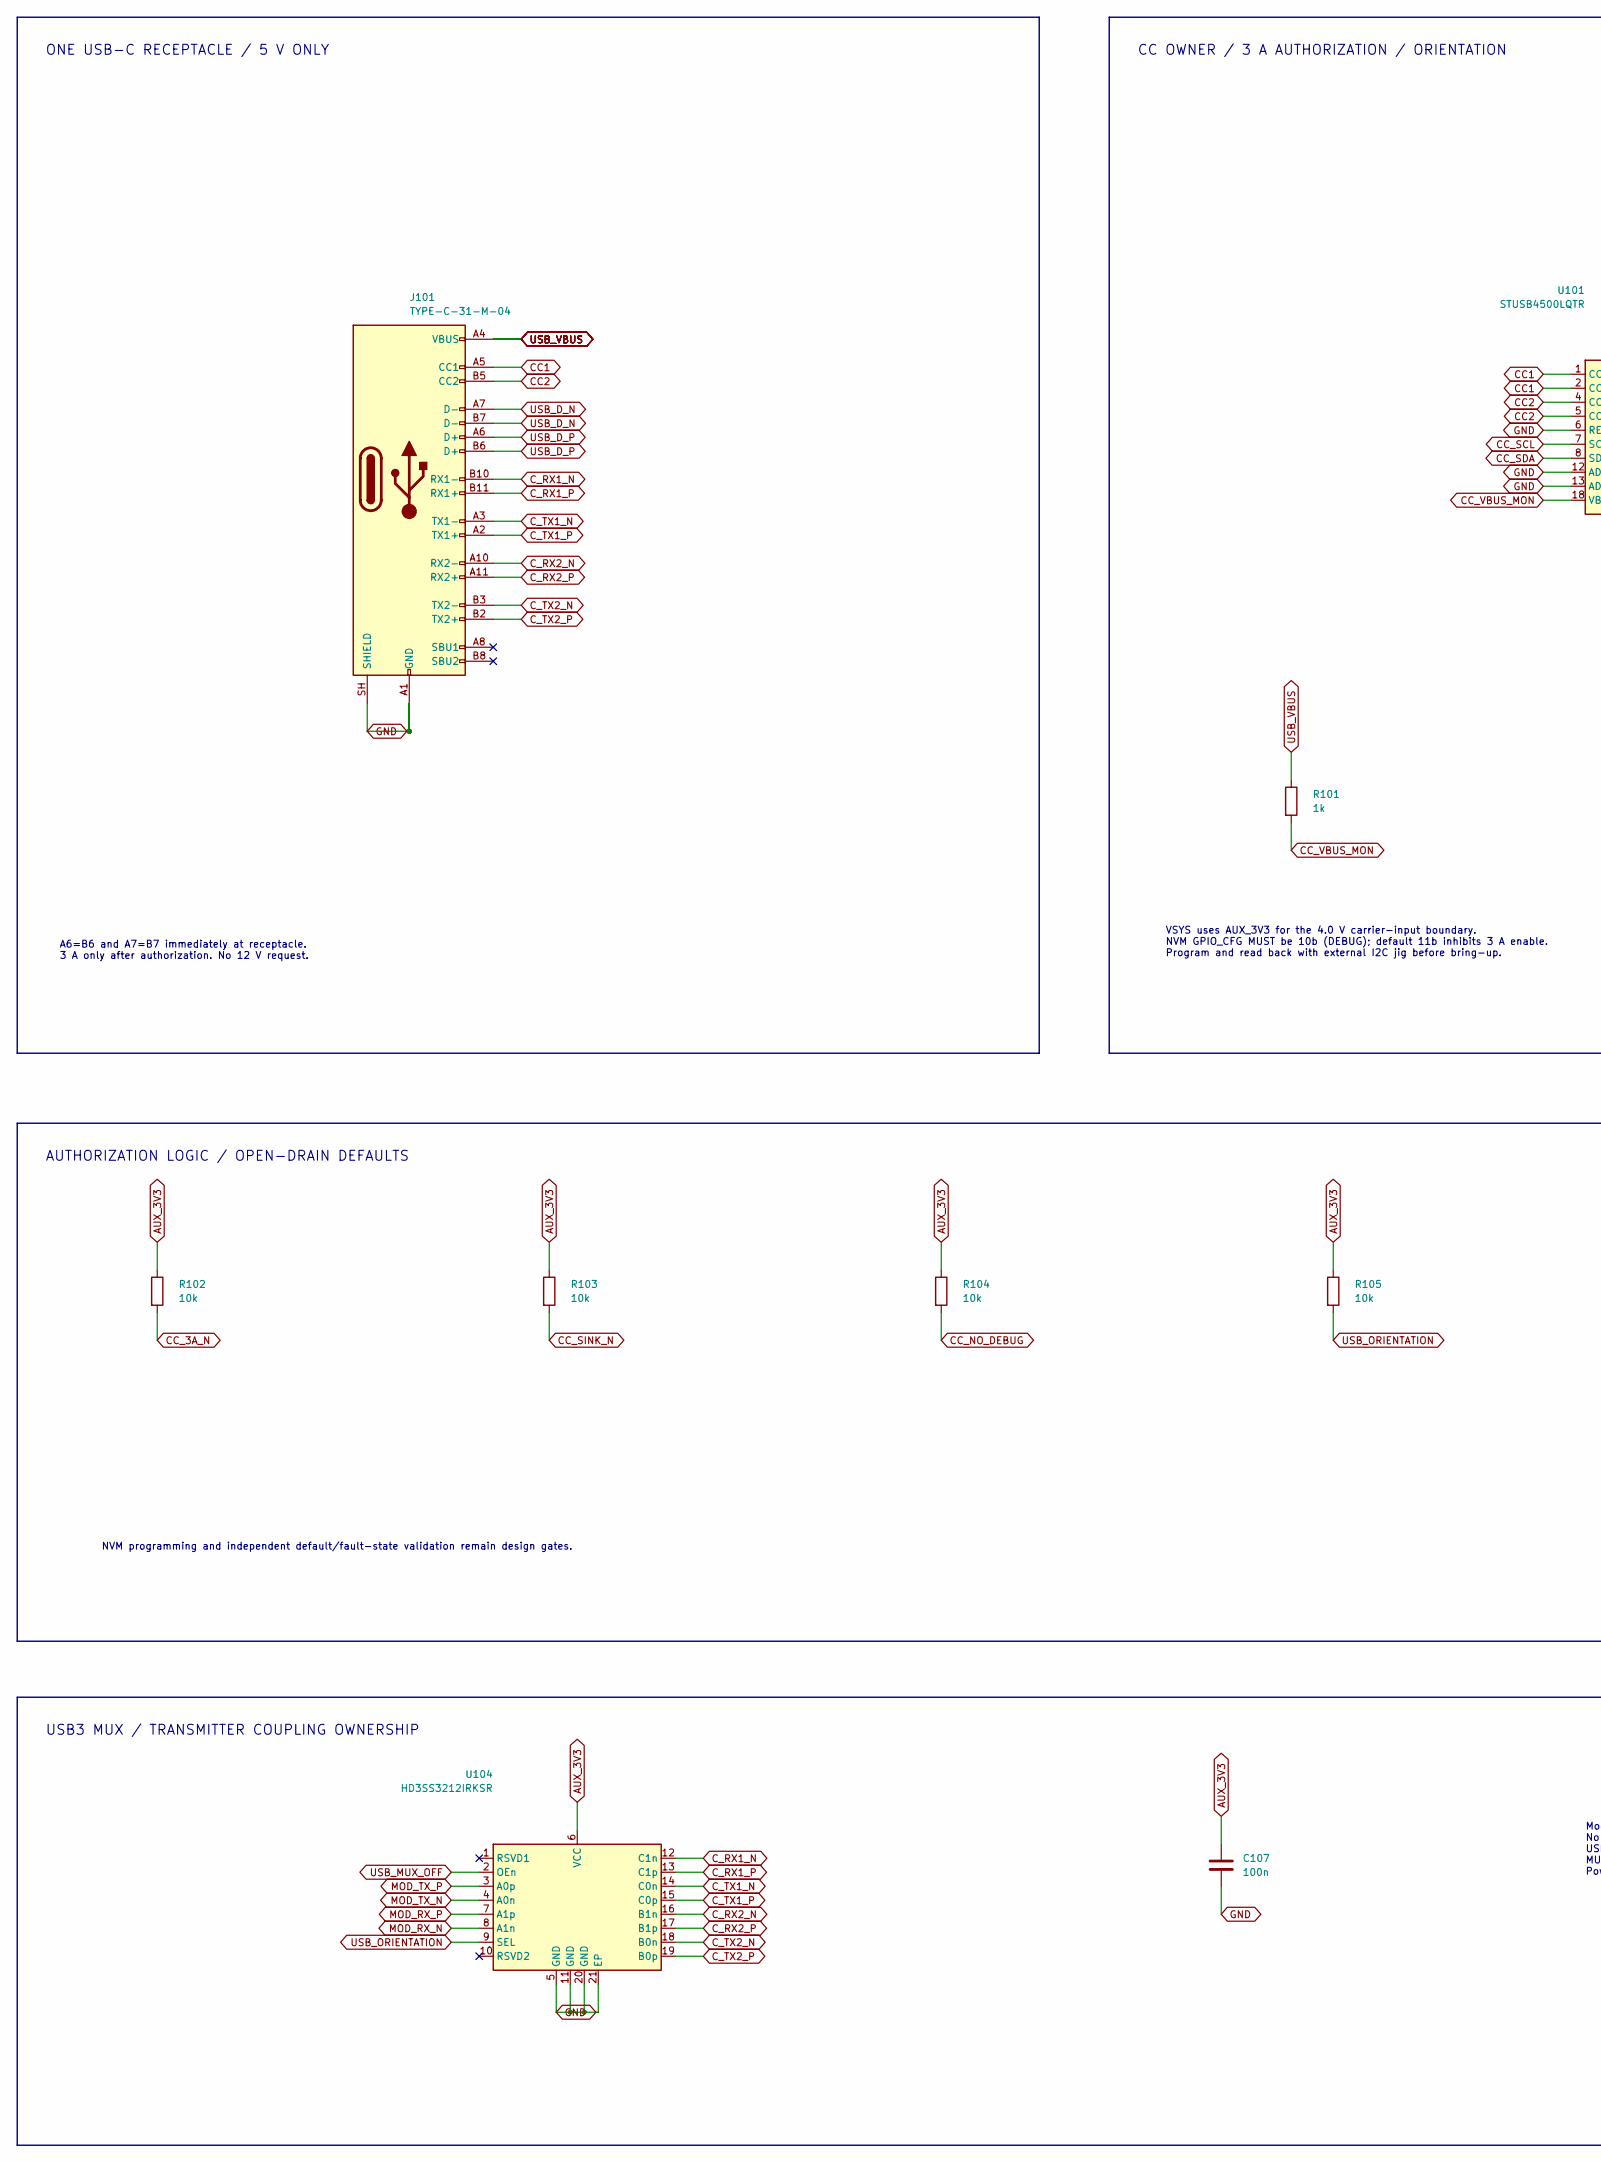
[picture p47: schematic usb.kicad_sch, USB-C authorization and orientation, part in row 1, column 1]

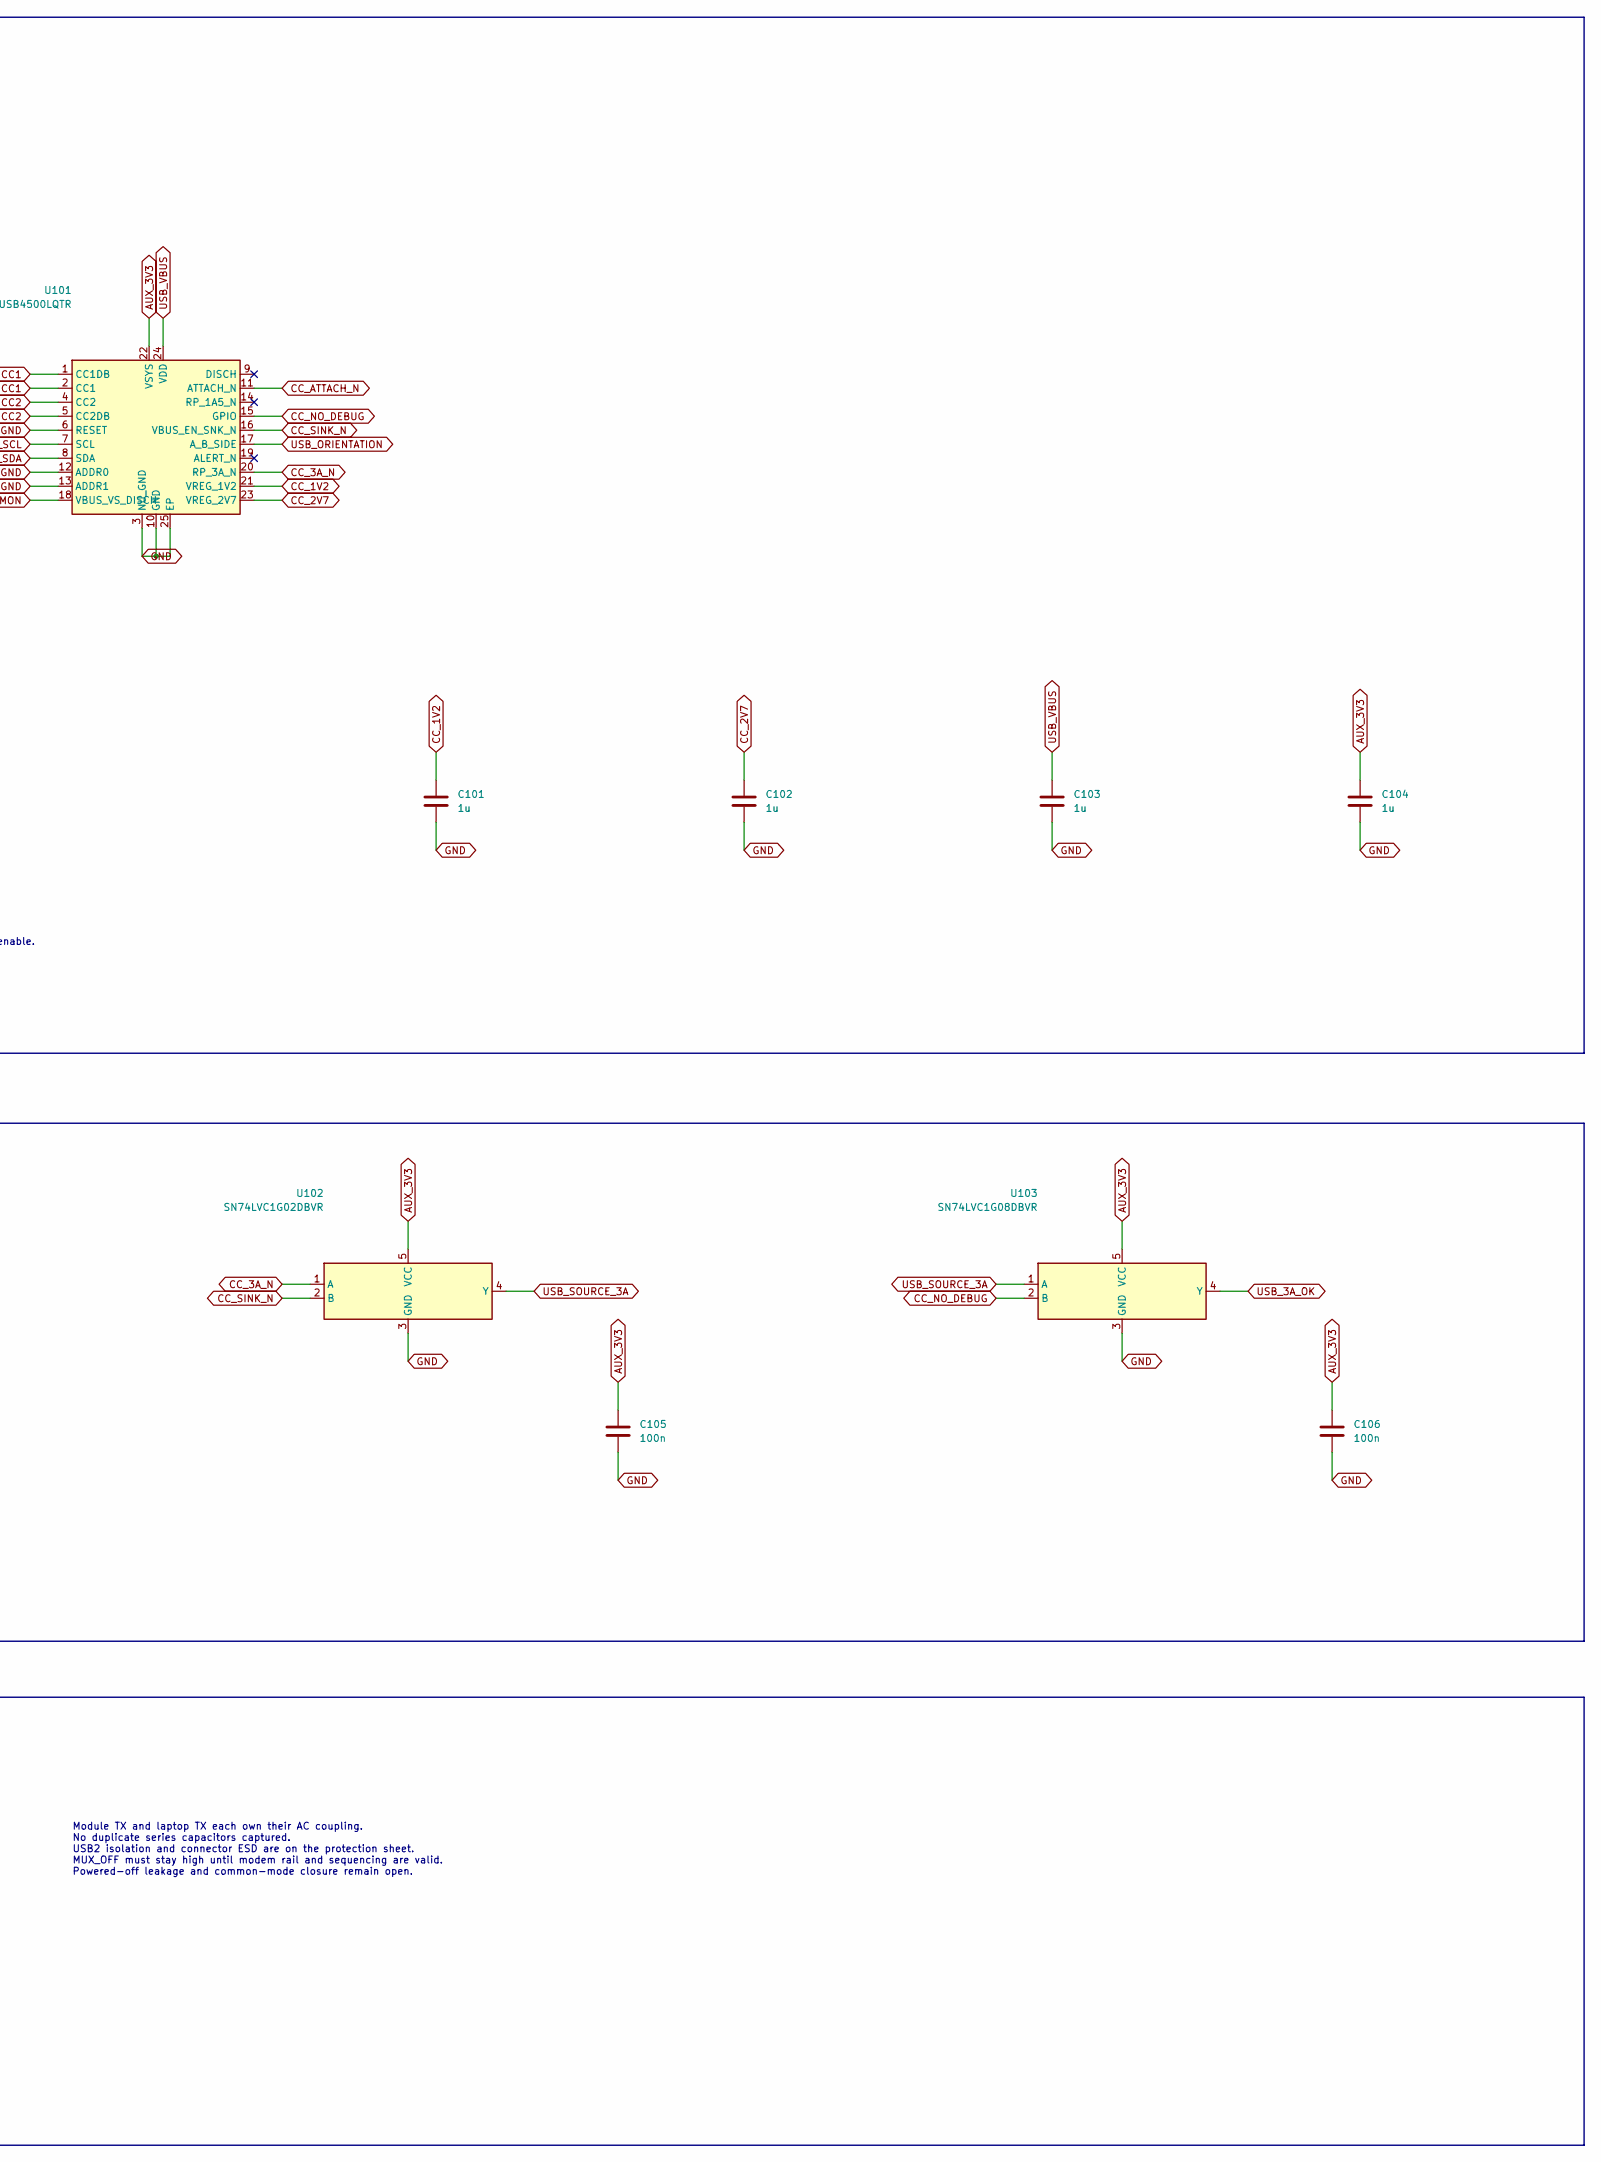
[picture p48: schematic usb.kicad_sch, USB-C authorization and orientation, part in row 1, column 2]

Parts:
C101, C102, C103, C104: 1u; C_1206_3216Metric; MPN C3216X7R1H105K160AB
C105, C106, C107: 100n; C_0805_2012Metric; MPN C2012X7R1H104K085AA
J101: TYPE-C-31-M-04; USB_C_Receptacle_HRO_TYPE-C-31-M-04; MPN TYPE-C-31-M-04; LCSC C129018
R101: 1k; R_0603_1608Metric; MPN RC0603FR-071KL
R102, R103, R104, R105: 10k; R_0603_1608Metric; MPN RC0603FR-0710KL
U101: STUSB4500LQTR; QFN-24-1EP_4x4mm_P0.5mm_EP2.6x2.6mm; MPN STUSB4500LQTR
U102: SN74LVC1G02DBVR; SOT-23-5; MPN SN74LVC1G02DBVR
U103: SN74LVC1G08DBVR; SOT-23-5; MPN SN74LVC1G08DBVR
U104: HD3SS3212IRKSR; WQFN-20-1EP_2.5x4.5mm_P0.5mm_EP1x2.9mm; MPN HD3SS3212IRKSR

Connections:
AUX_3V3: C104.1, C105.1, C106.1, C107.1, R102.1, R103.1, R104.1, R105.1, U101.22 (VSYS), U102.5 (VCC), U103.5 (VCC), U104.6 (VCC); also elsewhere on the board
CC1: J101.A5 (CC1), U101.1 (CC1DB), U101.2 (CC1); also elsewhere on the board
CC2: J101.B5 (CC2), U101.4 (CC2), U101.5 (CC2DB); also elsewhere on the board
CC_1V2: C101.1, U101.21 (VREG_1V2)
CC_2V7: C102.1, U101.23 (VREG_2V7)
CC_3A_N: R102.2, U101.20 (RP_3A_N), U102.1 (A)
CC_ATTACH_N: U101.11 (ATTACH_N); also elsewhere on the board
CC_NO_DEBUG: R104.2, U101.15 (GPIO), U103.2 (B)
CC_SCL: U101.7 (SCL); also elsewhere on the board
CC_SDA: U101.8 (SDA); also elsewhere on the board
CC_SINK_N: R103.2, U101.16 (VBUS_EN_SNK_N), U102.2 (B)
CC_VBUS_MON: R101.2, U101.18 (VBUS_VS_DISCH)
C_RX1_N: J101.B10 (RX1-), U104.12 (C1n); also elsewhere on the board
C_RX1_P: J101.B11 (RX1+), U104.13 (C1p); also elsewhere on the board
C_RX2_N: J101.A10 (RX2-), U104.16 (B1n); also elsewhere on the board
C_RX2_P: J101.A11 (RX2+), U104.17 (B1p); also elsewhere on the board
C_TX1_N: J101.A3 (TX1-), U104.14 (C0n); also elsewhere on the board
C_TX1_P: J101.A2 (TX1+), U104.15 (C0p); also elsewhere on the board
C_TX2_N: J101.B3 (TX2-), U104.18 (B0n); also elsewhere on the board
C_TX2_P: J101.B2 (TX2+), U104.19 (B0p); also elsewhere on the board
GND: C101.2, C102.2, C103.2, C104.2, C105.2, C106.2, C107.2, J101.A1 (GND), J101.A12 (GND), J101.B1 (GND), J101.B12 (GND), J101.SH (SHIELD), U101.3 (NU_GND), U101.6 (RESET), U101.10 (GND), U101.12 (ADDR0), U101.13 (ADDR1), U101.25 (EP), U102.3 (GND), U103.3 (GND), U104.5 (GND), U104.11 (GND), U104.20 (GND), U104.21 (EP); also elsewhere on the board
MOD_RX_N: U104.8 (A1n); also elsewhere on the board
MOD_RX_P: U104.7 (A1p); also elsewhere on the board
MOD_TX_N: U104.4 (A0n); also elsewhere on the board
MOD_TX_P: U104.3 (A0p); also elsewhere on the board
USB_3A_OK: U103.4 (Y); also elsewhere on the board
USB_D_N: J101.A7 (D-), J101.B7 (D-); also elsewhere on the board
USB_D_P: J101.A6 (D+), J101.B6 (D+); also elsewhere on the board
USB_MUX_OFF: U104.2 (OEn); also elsewhere on the board
USB_ORIENTATION: R105.2, U101.17 (A_B_SIDE), U104.9 (SEL)
USB_SOURCE_3A: U102.4 (Y), U103.1 (A)
USB_VBUS: C103.1, J101.A4 (VBUS), J101.A9 (VBUS), J101.B4 (VBUS), J101.B9 (VBUS), R101.1, U101.24 (VDD); also elsewhere on the board

Notes on the sheet:
ONE USB-C RECEPTACLE / 5 V ONLY
A6=B6 and A7=B7 immediately at receptacle. 3 A only after authorization. No 12 V request.
CC OWNER / 3 A AUTHORIZATION / ORIENTATION
VSYS uses AUX_3V3 for the 4.0 V carrier-input boundary. NVM GPIO_CFG MUST be 10b (DEBUG); default 11b inhibits 3 A enable. Program and read back with external I2C jig before bring-up.
AUTHORIZATION LOGIC / OPEN-DRAIN DEFAULTS
NVM programming and independent default/fault-state validation remain design gates.
USB3 MUX / TRANSMITTER COUPLING OWNERSHIP
Module TX and laptop TX each own their AC coupling. No duplicate series capacitors captured. USB2 isolation and connector ESD are on the protection sheet. MUX_OFF must stay high until modem rail and sequencing are valid. Powered-off leakage and common-mode closure remain open.
