alxgmpr/sierra-to-usb/compact/carrier/carrier.kicad_pcb

## KiCad design compact/carrier/carrier.kicad_pcb (continued)

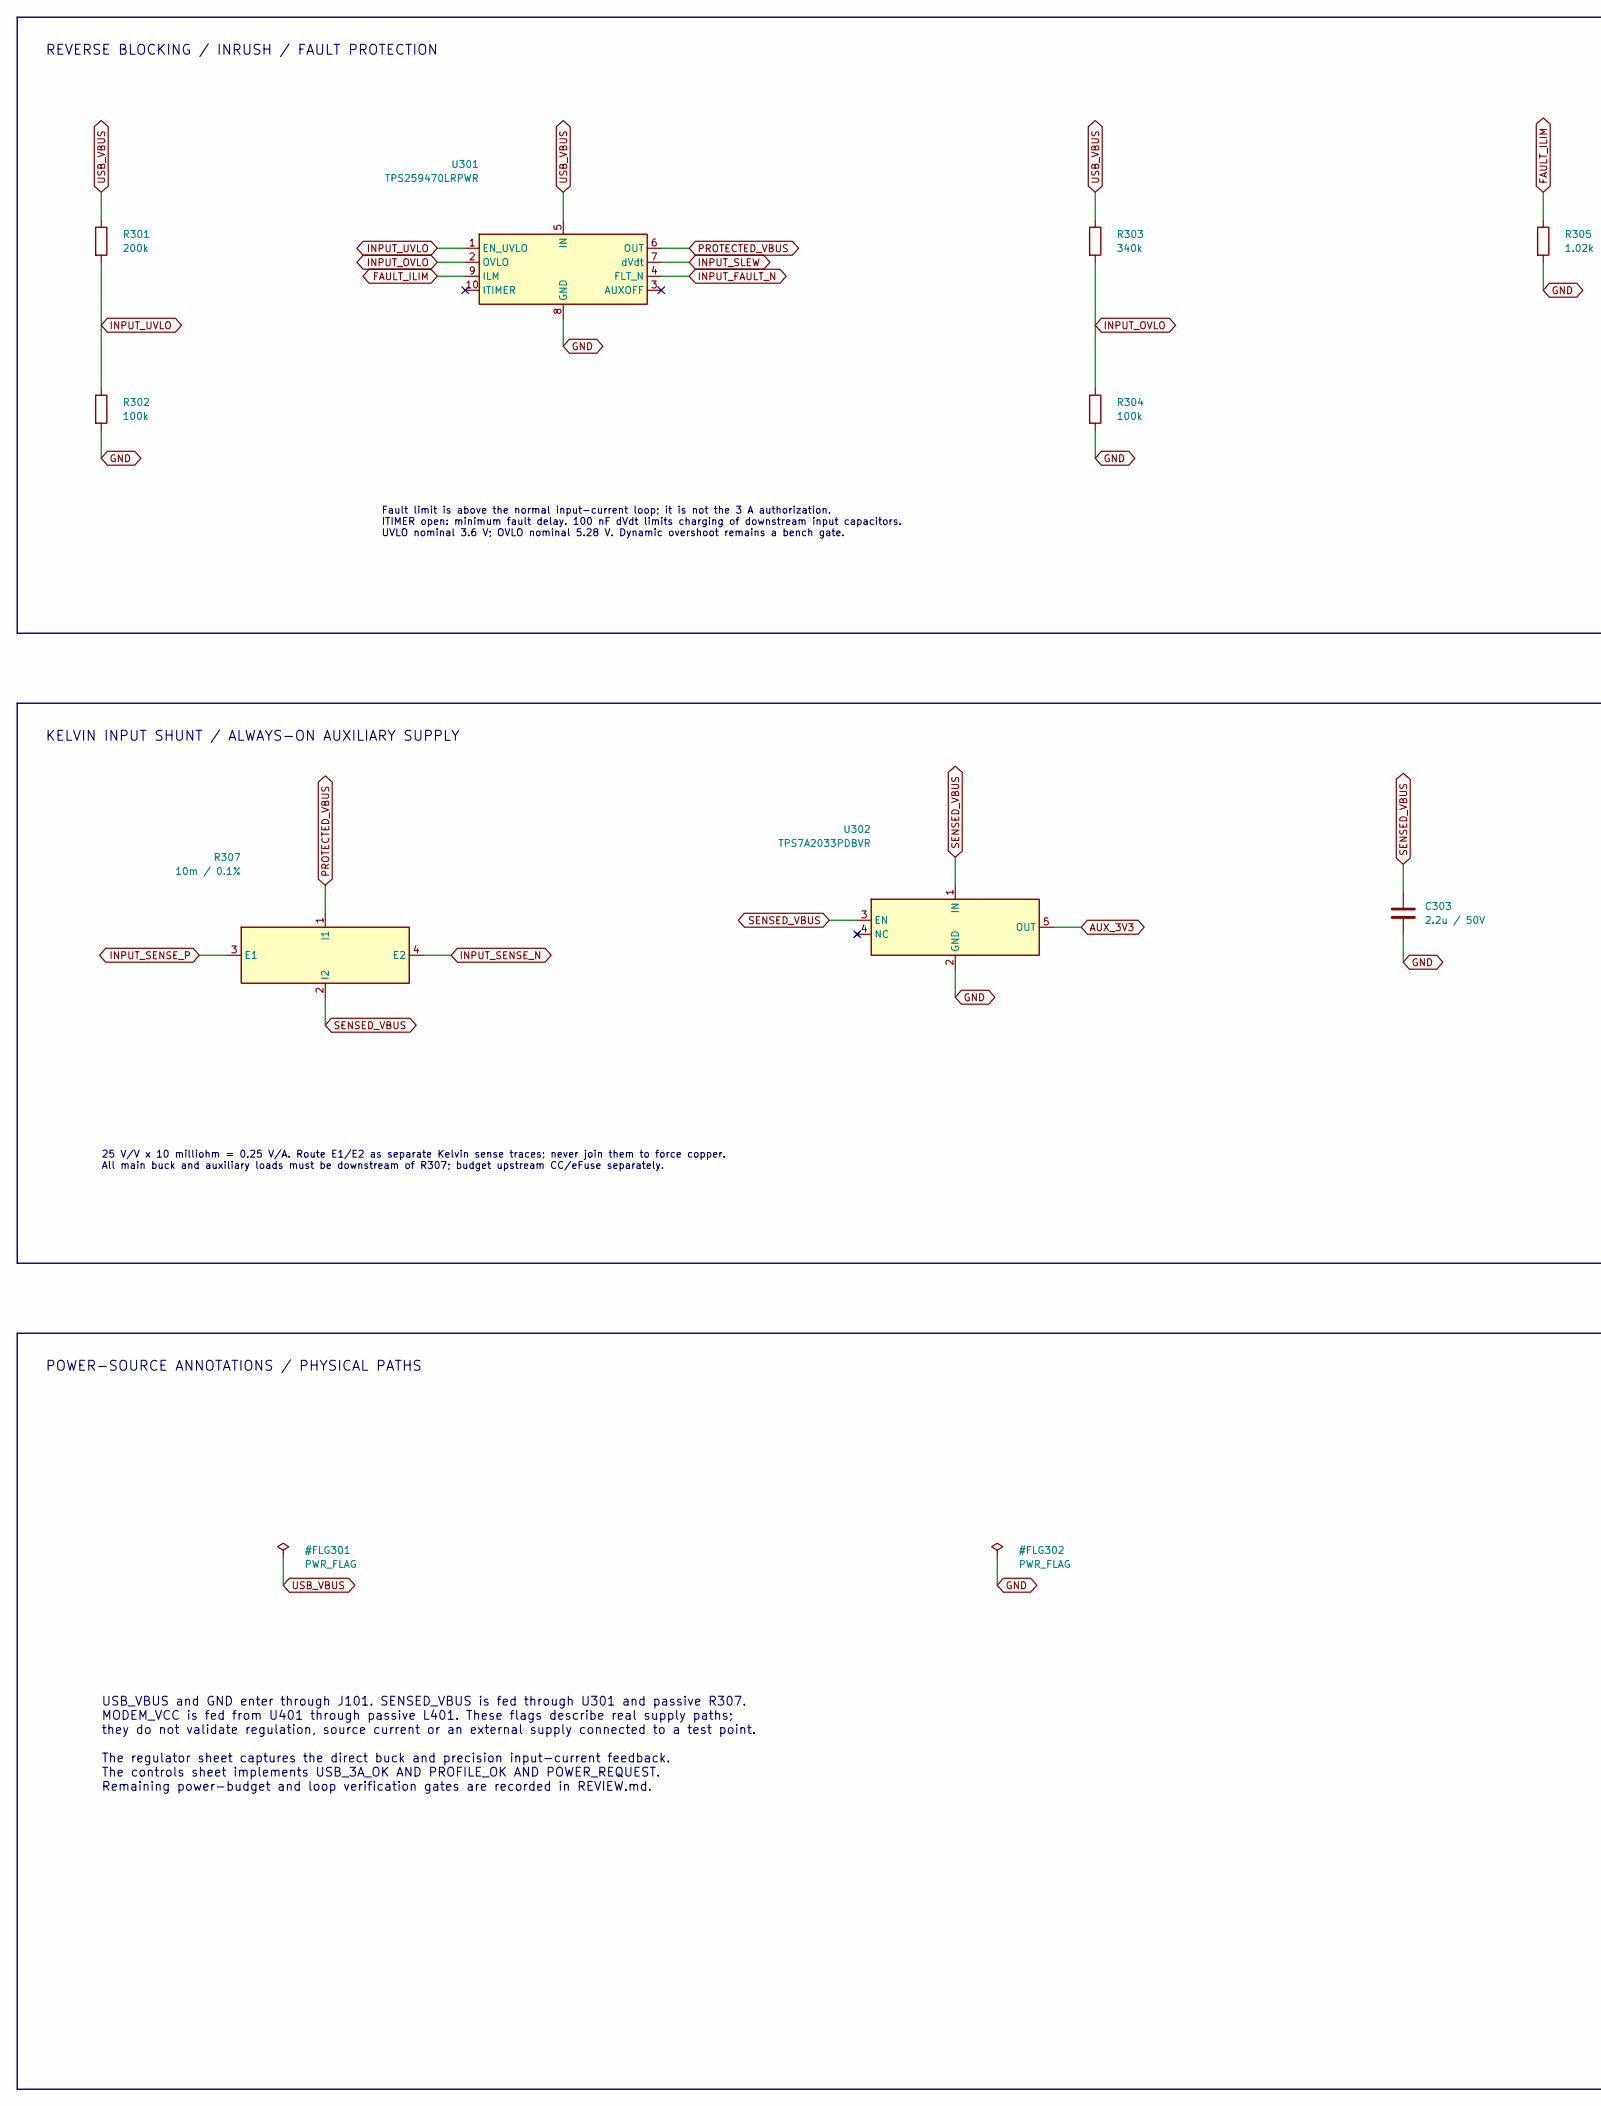
[picture p49: schematic power.kicad_sch, Input protection and current measurement, part in row 1, column 1]

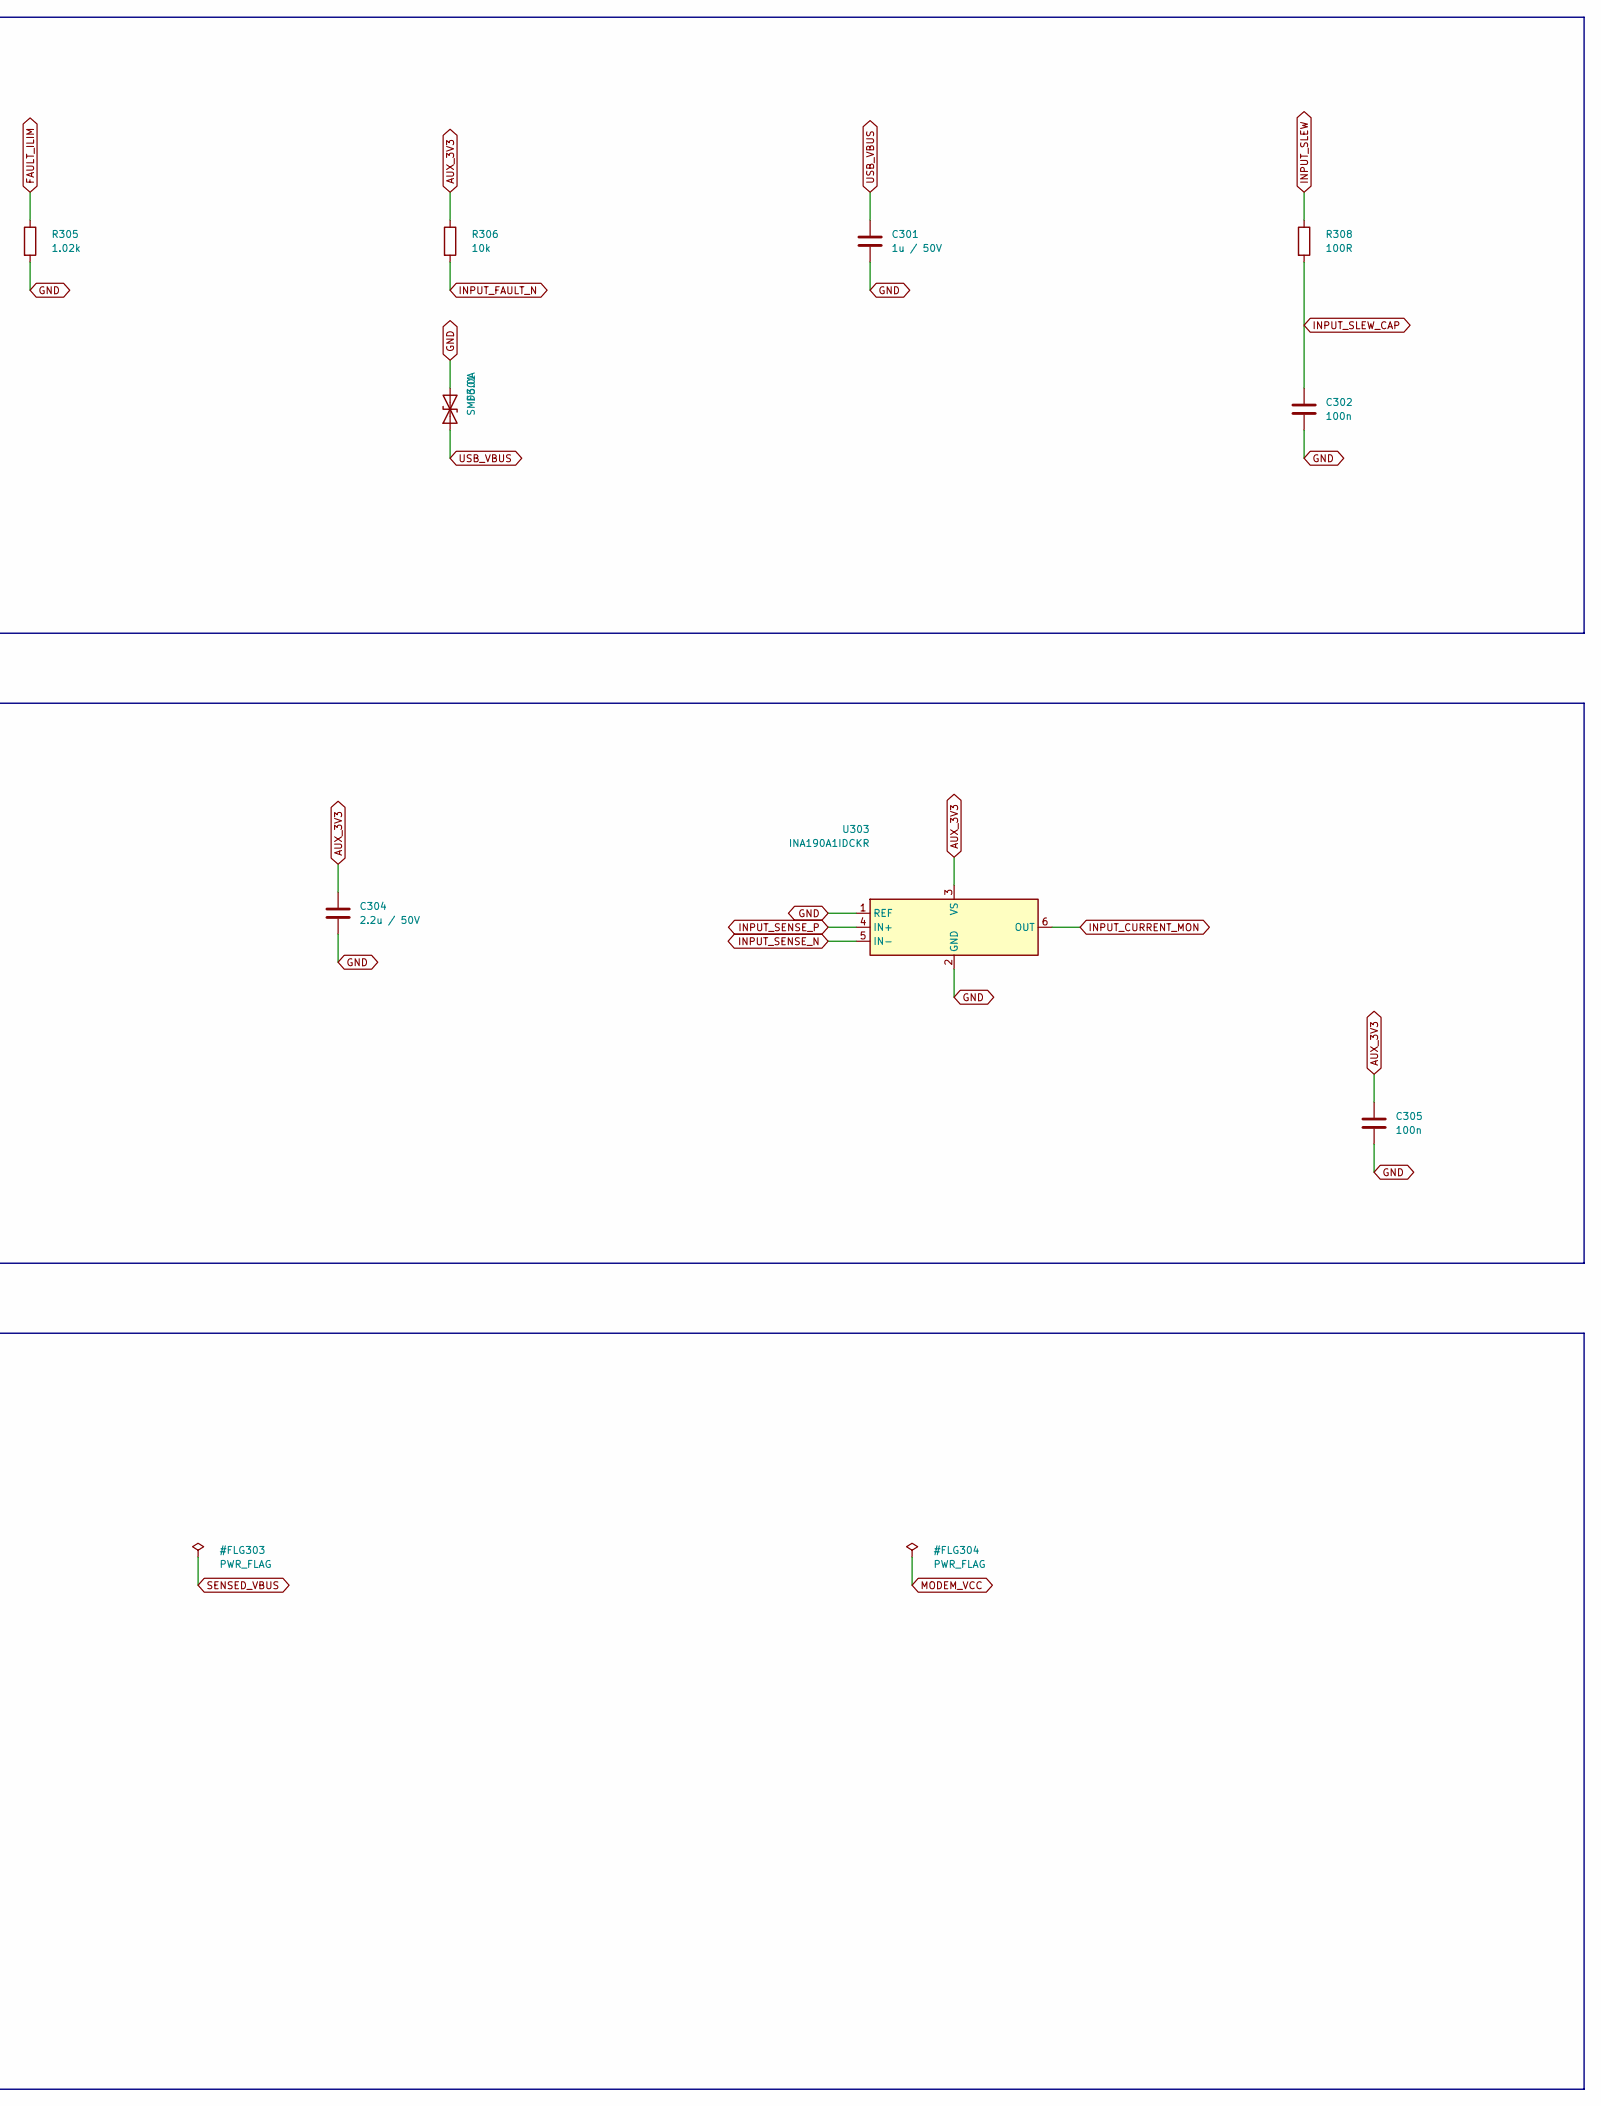
[picture p50: schematic power.kicad_sch, Input protection and current measurement, part in row 1, column 2]

Parts:
C301: 1u / 50V; C_1206_3216Metric; MPN C3216X7R1H105K160AB
C302, C305: 100n; C_0805_2012Metric; MPN C2012X7R1H104K085AA
C303, C304: 2.2u / 50V; C_1206_3216Metric; MPN C3216X7R1H225K160AB
D301: SMF6.0A; Littelfuse_SMF_SOD123FL; MPN SMF6.0A
R301: 200k; R_0603_1608Metric; MPN ERJ-3EKF2003V
R302, R304: 100k; R_0603_1608Metric; MPN RC0603FR-07100KL
R303: 340k; R_0603_1608Metric; MPN RC0603FR-07340KL
R305: 1.02k; R_0603_1608Metric; MPN RC0603FR-071K02L
R306: 10k; R_0603_1608Metric; MPN RC0603FR-0710KL
R307: 10m / 0.1%; VPG_CSM2512_Kelvin; MPN Y14870R01000B9R
R308: 100R; R_0603_1608Metric; MPN RC0603FR-07100RL
U301: TPS259470LRPWR; TI_RPW0010A; MPN TPS259470LRPWR
U302: TPS7A2033PDBVR; SOT-23-5; MPN TPS7A2033PDBVR
U303: INA190A1IDCKR; SOT-363_SC-70-6; MPN INA190A1IDCKR

Connections:
AUX_3V3: C304.1, C305.1, R306.1, U302.5 (OUT), U303.3 (VS); also elsewhere on the board
FAULT_ILIM: R305.1, U301.9 (ILM)
GND: C301.2, C302.2, C303.2, C304.2, C305.2, D301.2 (A2), R302.2, R304.2, R305.2, U301.8 (GND), U302.2 (GND), U303.1 (REF), U303.2 (GND); also elsewhere on the board
INPUT_CURRENT_MON: U303.6 (OUT); also elsewhere on the board
INPUT_FAULT_N: R306.2, U301.4 (FLT_N)
INPUT_OVLO: R303.2, R304.1, U301.2 (OVLO)
INPUT_SENSE_N: R307.4 (E2), U303.5 (IN-)
INPUT_SENSE_P: R307.3 (E1), U303.4 (IN+)
INPUT_SLEW: R308.1, U301.7 (dVdt)
INPUT_SLEW_CAP: C302.1, R308.2
INPUT_UVLO: R301.2, R302.1, U301.1 (EN_UVLO)
PROTECTED_VBUS: R307.1 (I1), U301.6 (OUT)
SENSED_VBUS: C303.1, R307.2 (I2), U302.1 (IN), U302.3 (EN); also elsewhere on the board
USB_VBUS: C301.1, D301.1 (A1), R301.1, R303.1, U301.5 (IN); also elsewhere on the board

Notes on the sheet:
REVERSE BLOCKING / INRUSH / FAULT PROTECTION
Fault limit is above the normal input-current loop; it is not the 3 A authorization. ITIMER open: minimum fault delay. 100 nF dVdt limits charging of downstream input capacitors. UVLO nominal 3.6 V; OVLO nominal 5.28 V. Dynamic overshoot remains a bench gate.
KELVIN INPUT SHUNT / ALWAYS-ON AUXILIARY SUPPLY
25 V/V x 10 milliohm = 0.25 V/A. Route E1/E2 as separate Kelvin sense traces; never join them to force copper. All main buck and auxiliary loads must be downstream of R307; budget upstream CC/eFuse separately.
POWER-SOURCE ANNOTATIONS / PHYSICAL PATHS
USB_VBUS and GND enter through J101. SENSED_VBUS is fed through U301 and passive R307. MODEM_VCC is fed from U401 through passive L401. These flags describe real supply paths; they do not validate regulation, source current or an external supply connected to a test point. The regulator sheet captur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

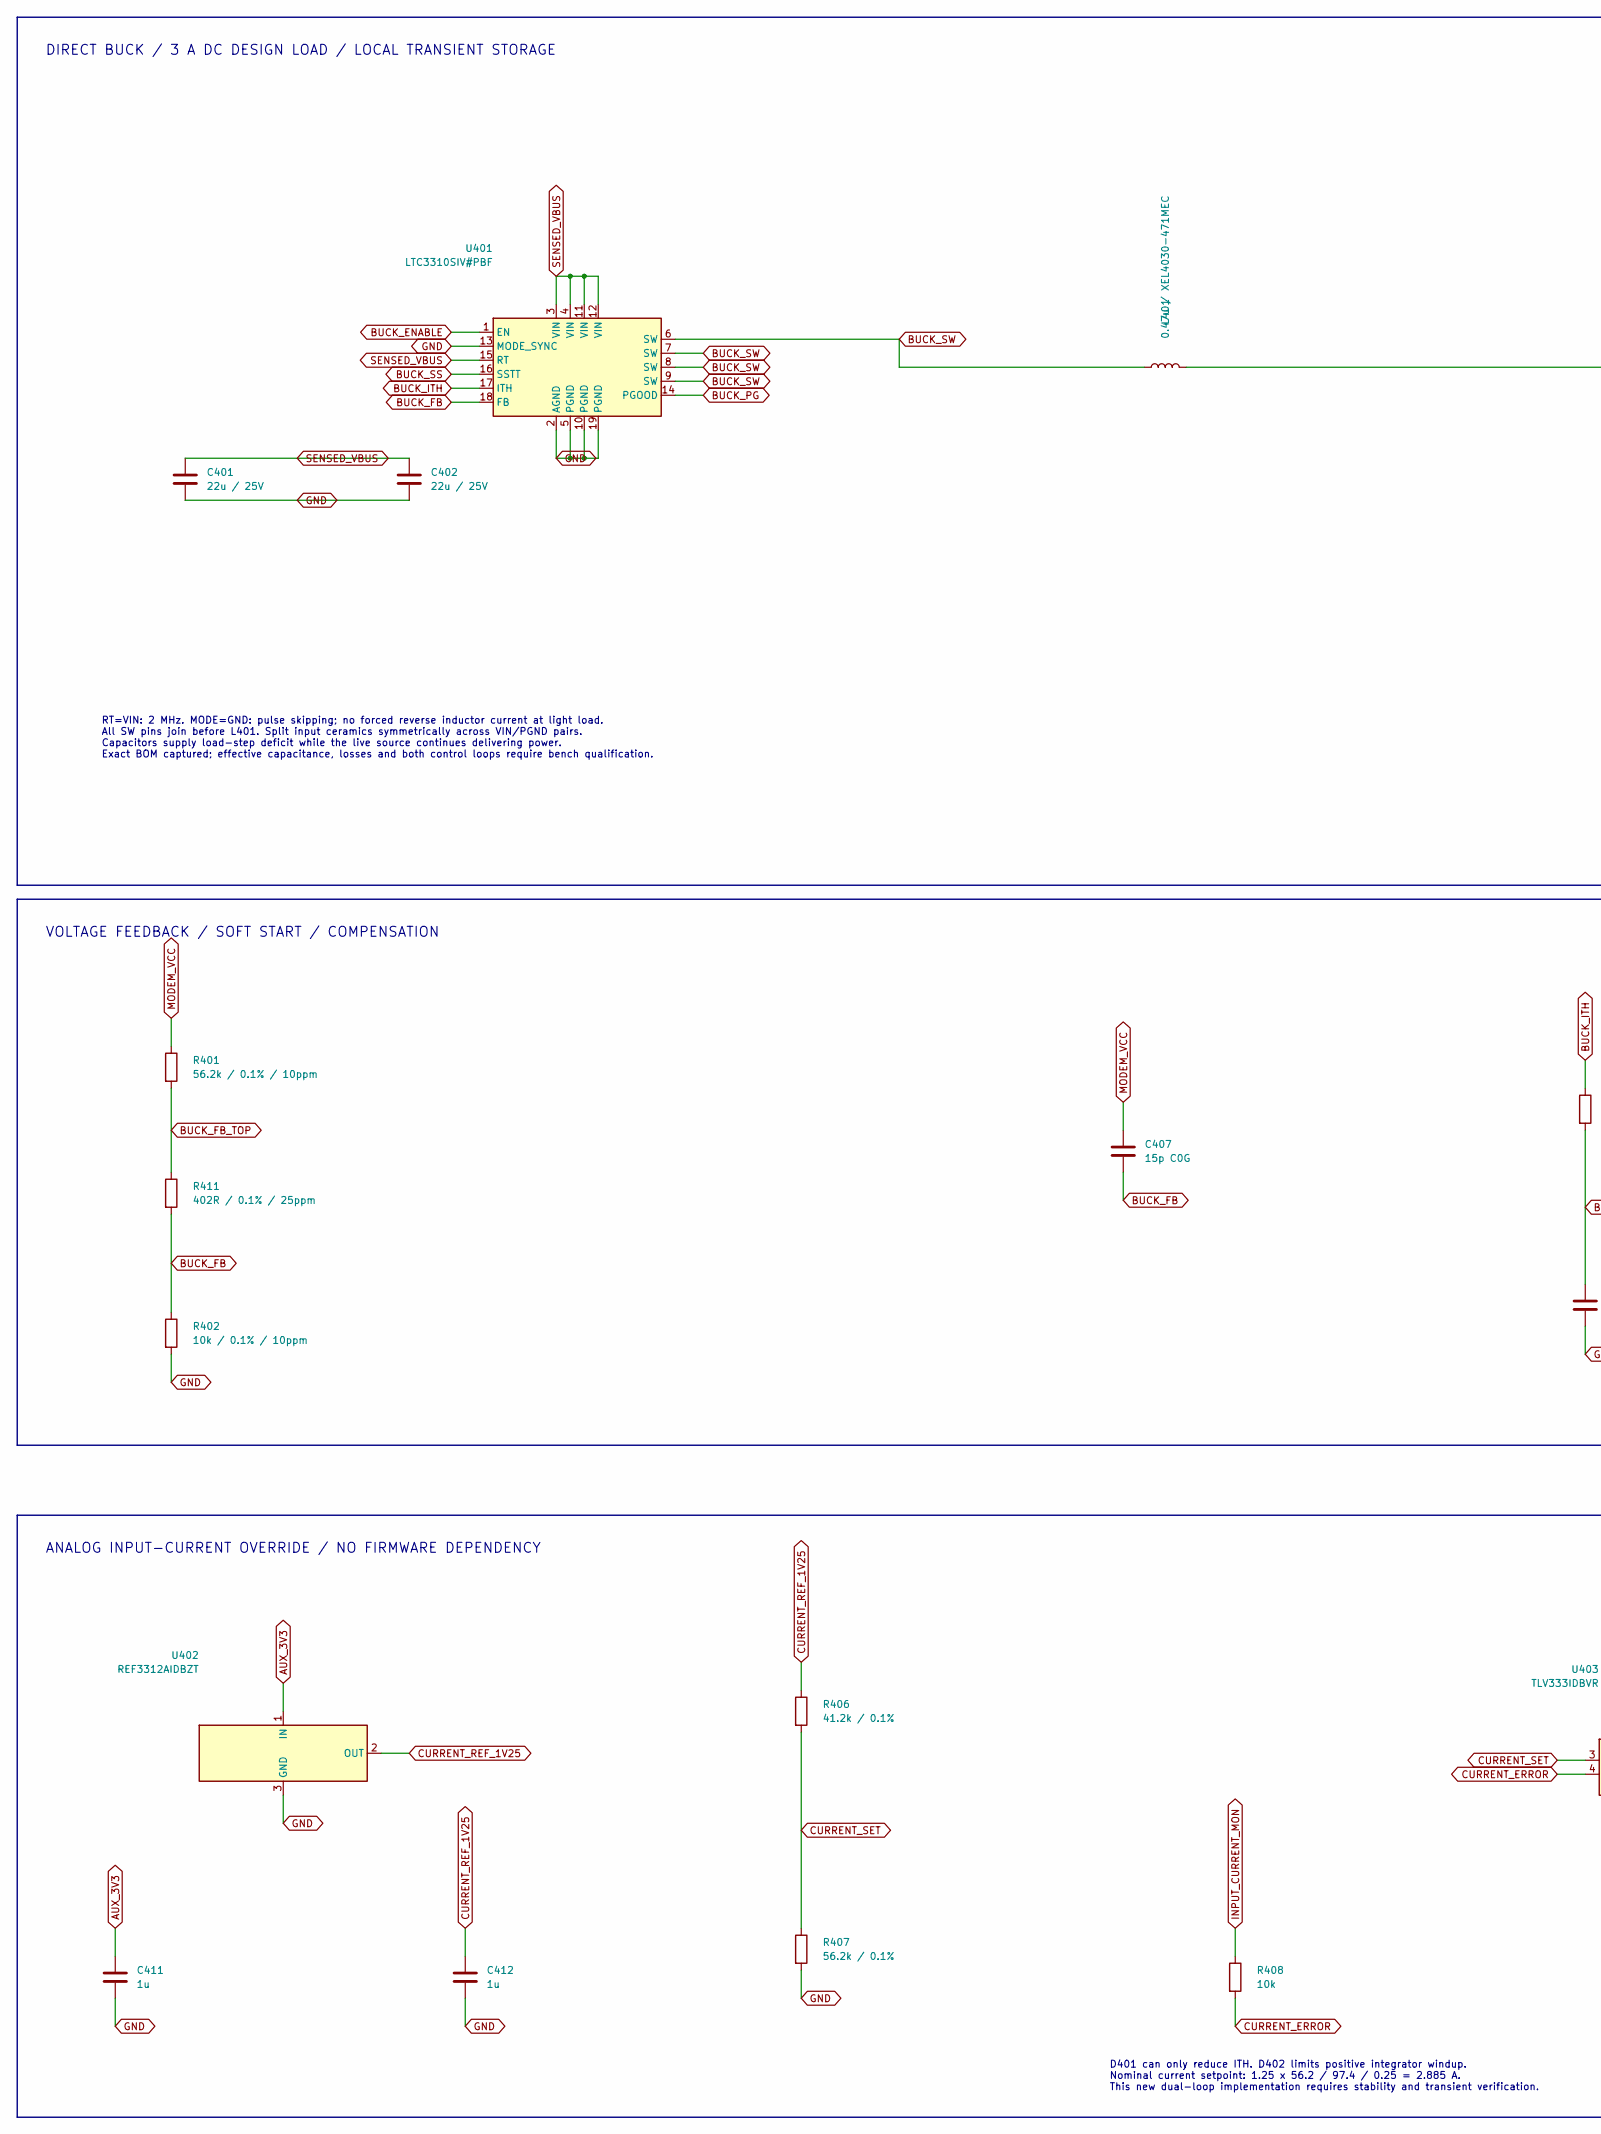
[picture p51: schematic regulator.kicad_sch, 3.33 V regulator and input-current limit, part in row 1, column 1]

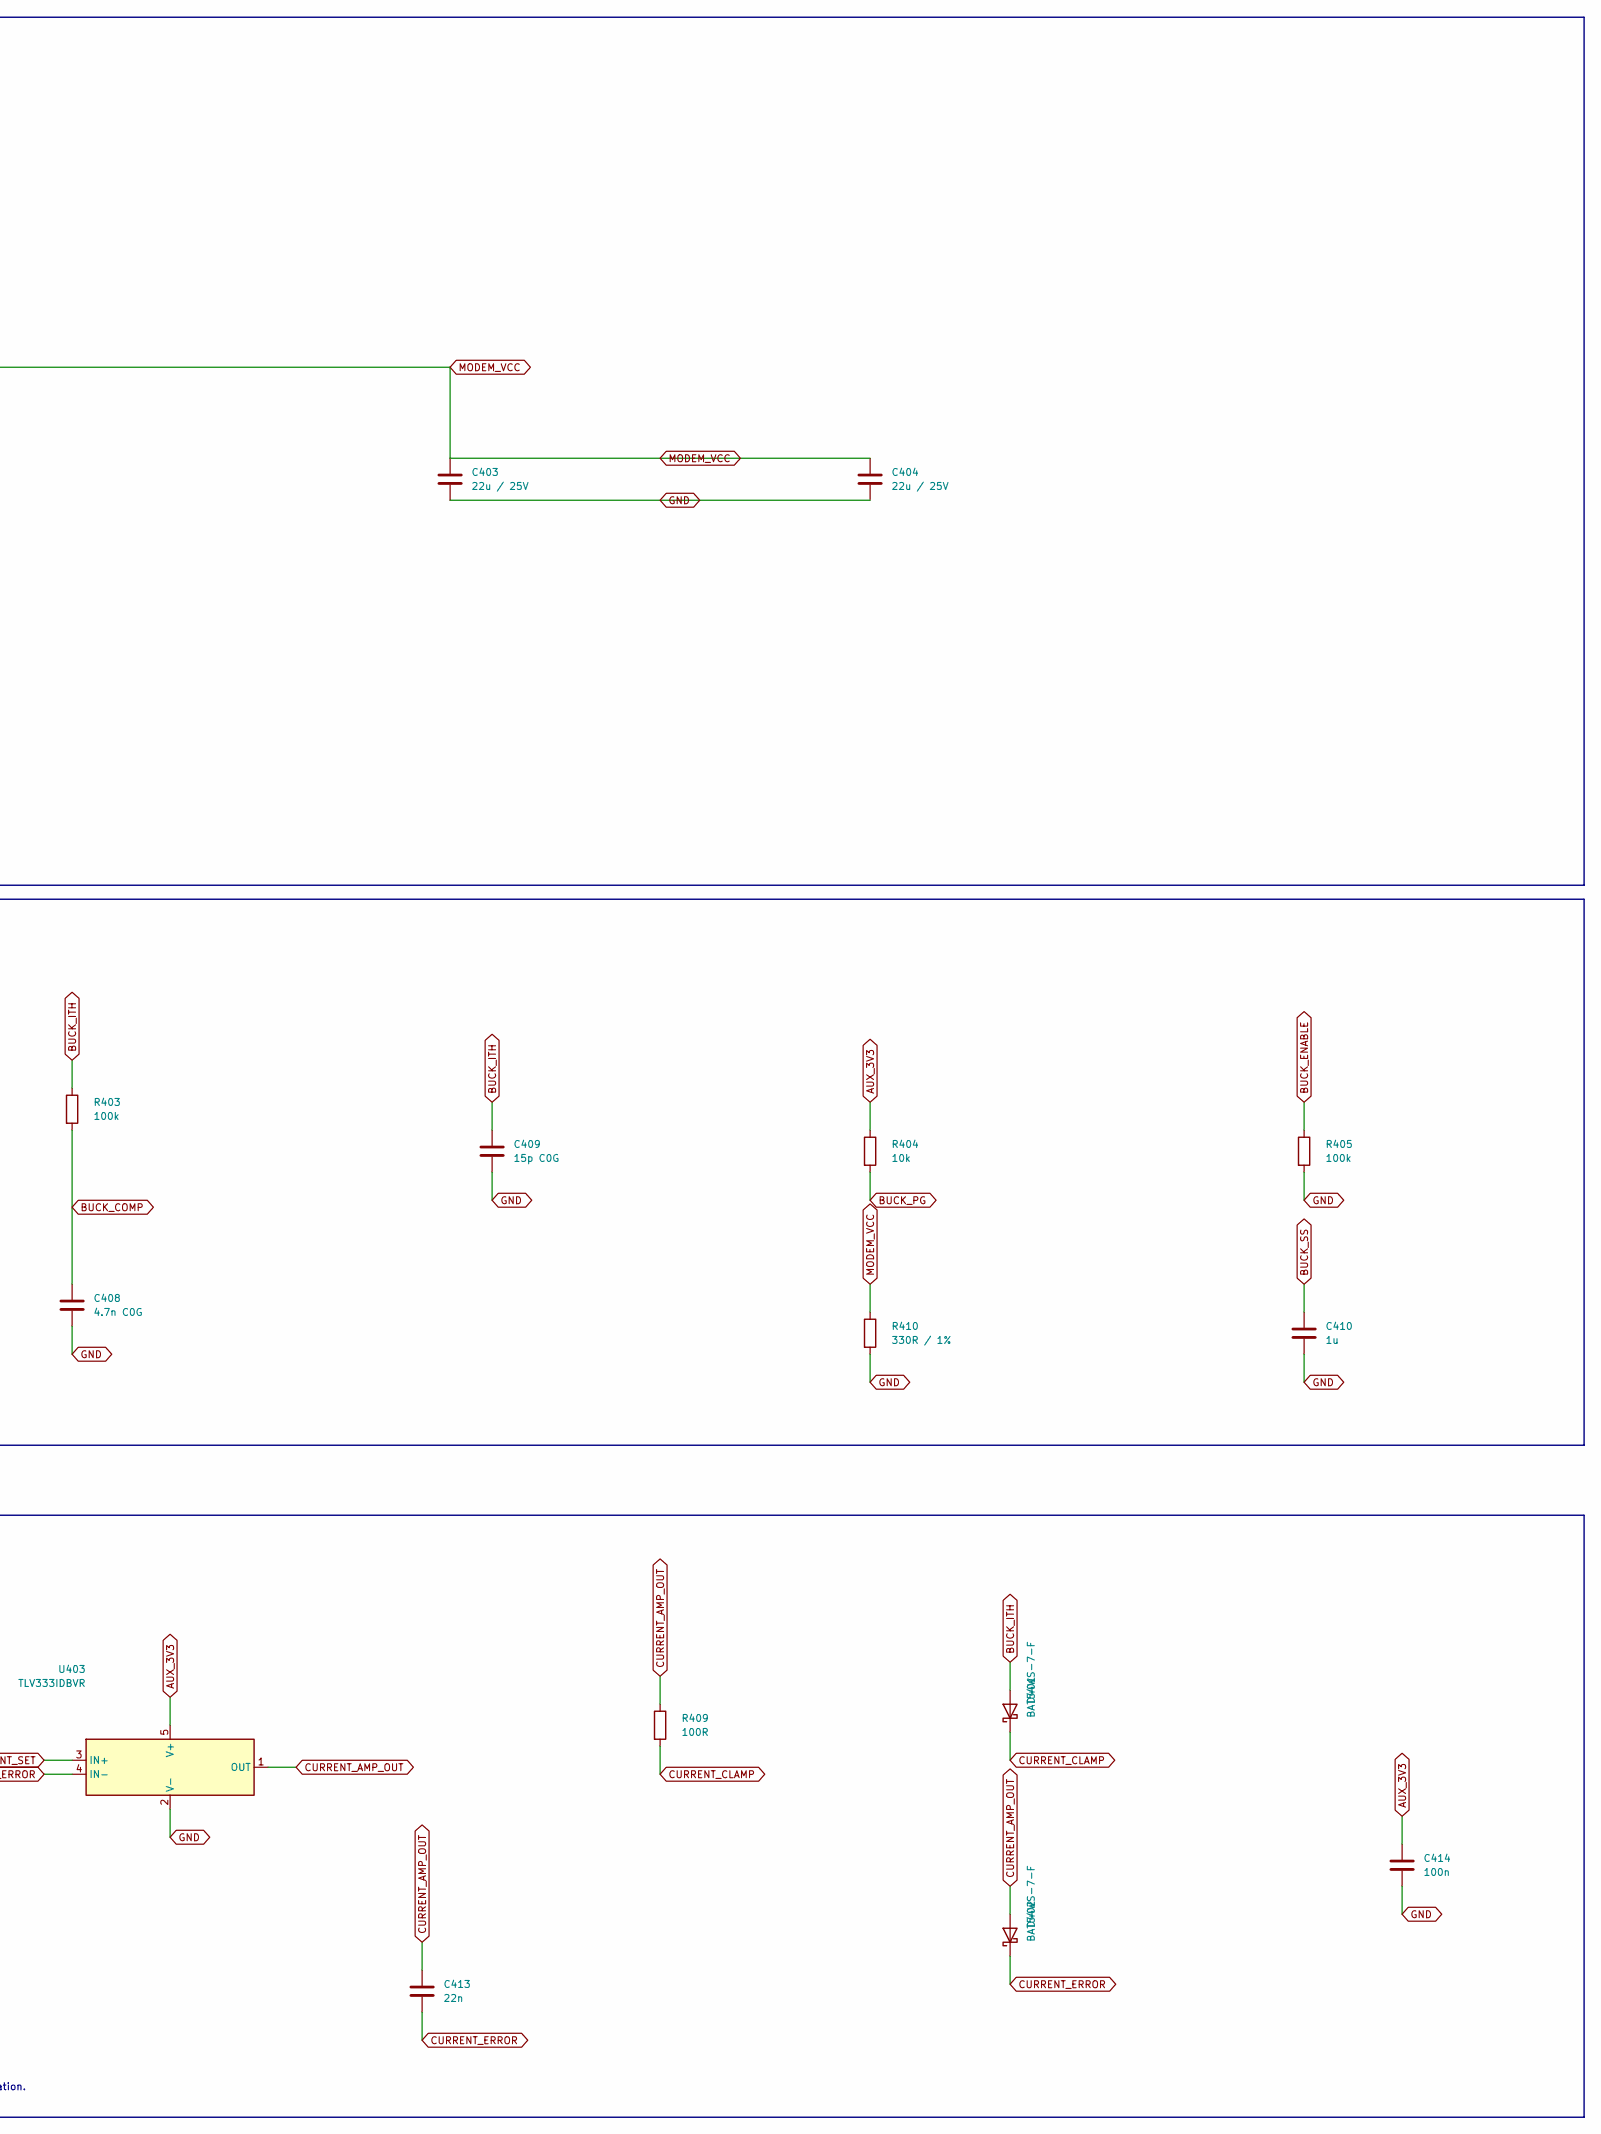
[picture p52: schematic regulator.kicad_sch, 3.33 V regulator and input-current limit, part in row 1, column 2]

Parts:
C401, C402, C403, C404: 22u / 25V; C_1210_3225Metric; MPN C3225X7R1E226M250AB
C407, C409: 15p C0G; C_0805_2012Metric; MPN C0805C150J5GACTU
C408: 4.7n C0G; C_0805_2012Metric; MPN C2012C0G1H472J060AA
C410, C411, C412: 1u; C_1206_3216Metric; MPN C3216X7R1H105K160AB
C413: 22n; C_0805_2012Metric; MPN C0805C223J5GACTU
C414: 100n; C_0805_2012Metric; MPN C2012X7R1H104K085AA
D401, D402: BAT54WS-7-F; D_SOD-323; MPN BAT54WS-7-F
L401: 0.47u / XEL4030-471MEC; L_Coilcraft_XEL4030; MPN XEL4030-471MEC
R401: 56.2k / 0.1% / 10ppm; R_0603_1608Metric; MPN ERA-3ARB5622V
R402: 10k / 0.1% / 10ppm; R_0603_1608Metric; MPN ERA-3ARB103V
R403, R405: 100k; R_0603_1608Metric; MPN RC0603FR-07100KL
R404, R408: 10k; R_0603_1608Metric; MPN RC0603FR-0710KL
R406: 41.2k / 0.1%; R_0603_1608Metric; MPN RT0603BRD0741K2L
R407: 56.2k / 0.1%; R_0603_1608Metric; MPN RT0603BRD0756K2L
R409: 100R; R_0603_1608Metric; MPN RC0603FR-07100RL
R410: 330R / 1%; R_1206_3216Metric; MPN RC1206FR-07330RL
R411: 402R / 0.1% / 25ppm; R_0603_1608Metric; MPN RT0603BRD07402RL
U401: LTC3310SIV#PBF; LTC_LQFN18_3x3_05-08-1548; MPN LTC3310SIV#PBF
U402: REF3312AIDBZT; SOT-23; MPN REF3312AIDBZT
U403: TLV333IDBVR; SOT-23-5; MPN TLV333IDBVR

Connections:
AUX_3V3: C411.1, C414.1, R404.1, U402.1 (IN), U403.5 (V+); also elsewhere on the board
BUCK_COMP: C408.1, R403.2
BUCK_ENABLE: R405.1, U401.1 (EN); also elsewhere on the board
BUCK_FB: C407.2, R402.1, R411.2, U401.18 (FB)
BUCK_FB_TOP: R401.2, R411.1
BUCK_ITH: C409.1, D401.2 (A), R403.1, U401.17 (ITH); also elsewhere on the board
BUCK_PG: R404.2, U401.14 (PGOOD)
BUCK_SS: C410.1, U401.16 (SSTT)
BUCK_SW: L401.1, U401.6 (SW), U401.7 (SW), U401.8 (SW), U401.9 (SW)
CURRENT_AMP_OUT: C413.1, D402.2 (A), R409.1, U403.1 (OUT)
CURRENT_CLAMP: D401.1 (K), R409.2
CURRENT_ERROR: C413.2, D402.1 (K), R408.2, U403.4 (IN-)
CURRENT_REF_1V25: C412.1, R406.1, U402.2 (OUT)
CURRENT_SET: R406.2, R407.1, U403.3 (IN+)
GND: C401.2, C402.2, C403.2, C404.2, C408.2, C409.2, C410.2, C411.2, C412.2, C414.2, R402.2, R405.2, R407.2, R410.2, U401.2 (AGND), U401.5 (PGND), U401.10 (PGND), U401.13 (MODE_SYNC), U401.19 (PGND), U402.3 (GND), U403.2 (V-); also elsewhere on the board
INPUT_CURRENT_MON: R408.1; also elsewhere on the board
MODEM_VCC: C403.1, C404.1, C407.1, L401.2, R401.1, R410.1; also elsewhere on the board
SENSED_VBUS: C401.1, C402.1, U401.3 (VIN), U401.4 (VIN), U401.11 (VIN), U401.12 (VIN), U401.15 (RT); also elsewhere on the board

Notes on the sheet:
DIRECT BUCK / 3 A DC DESIGN LOAD / LOCAL TRANSIENT STORAGE
RT=VIN: 2 MHz. MODE=GND: pulse skipping; no forced reverse inductor current at light load. All SW pins join before L401. Split input ceramics symmetrically across VIN/PGND pairs. Capacitors supply load-step deficit while the live source continues delivering power. Exact BOM captured; effective capa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
VOLTAGE FEEDBACK / SOFT START / COMPENSATION
ANALOG INPUT-CURRENT OVERRIDE / NO FIRMWARE DEPENDENCY
D401 can only reduce ITH. D402 limits positive integrator windup. Nominal current setpoint: 1.25 x 56.2 / 97.4 / 0.25 = 2.885 A. This new dual-loop implementation requires stability and transient verification.
