alxgmpr/sierra-to-usb/compact/carrier/carrier.kicad_pcb

## KiCad design compact/carrier/carrier.kicad_pcb (continued)

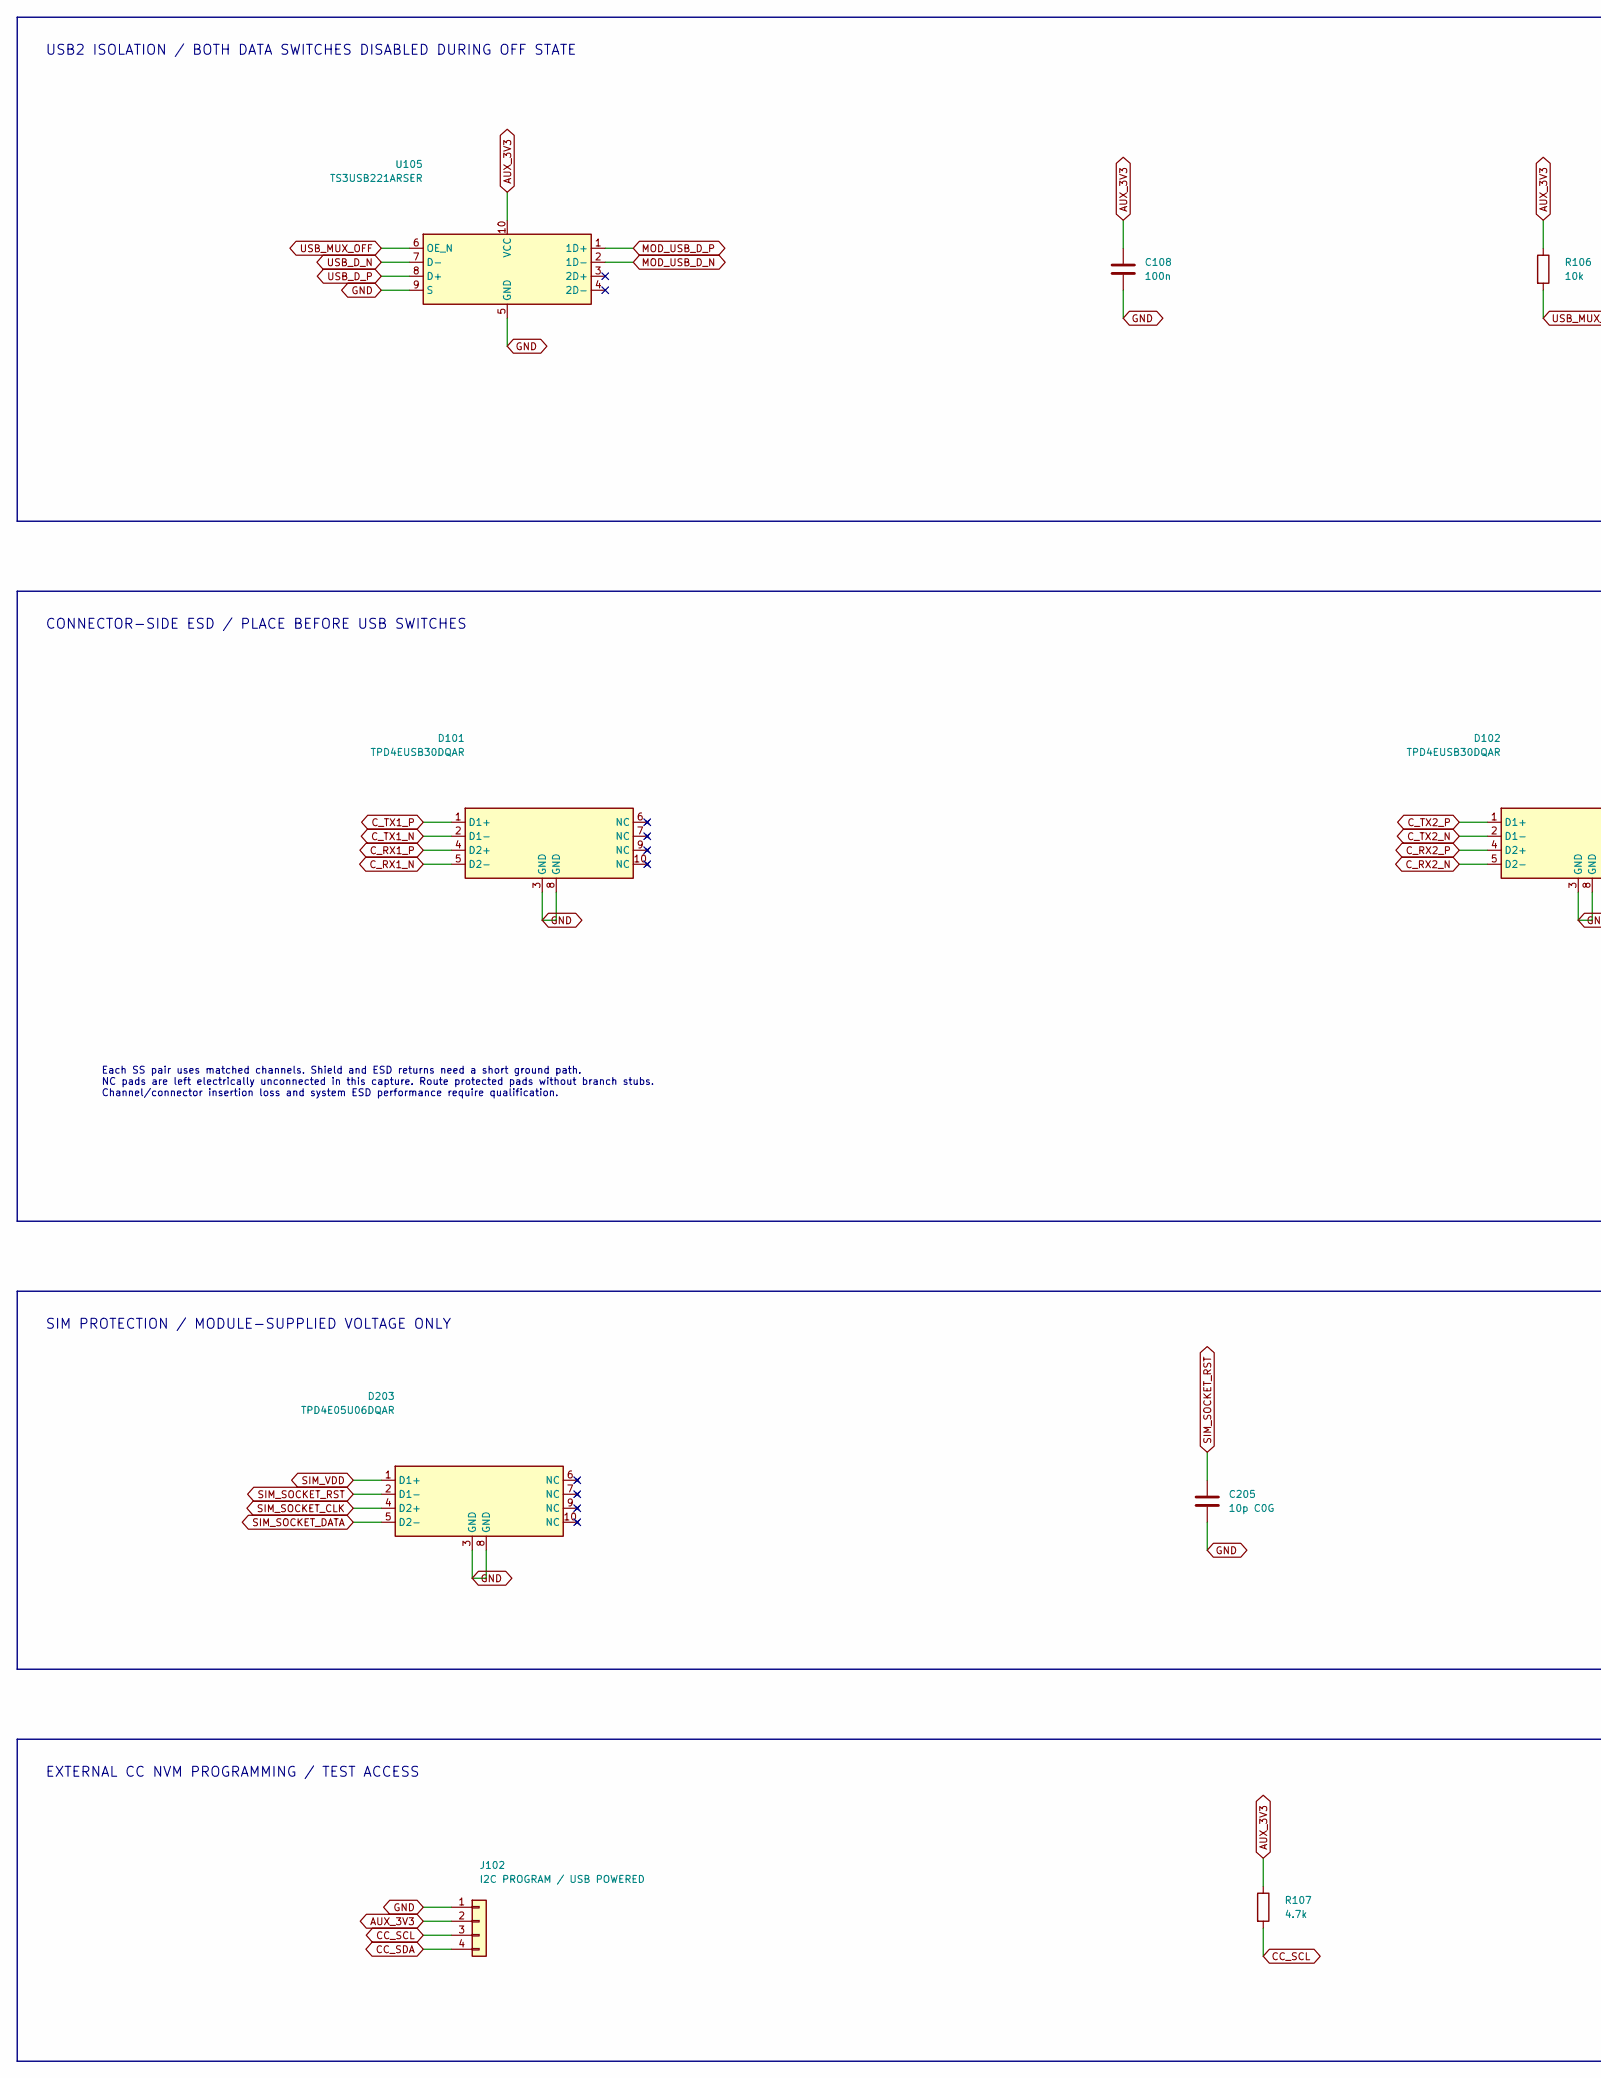
[picture p53: schematic protection.kicad_sch, USB and SIM protection, USB2 isolation and CC programming, part in row 1, column 1]

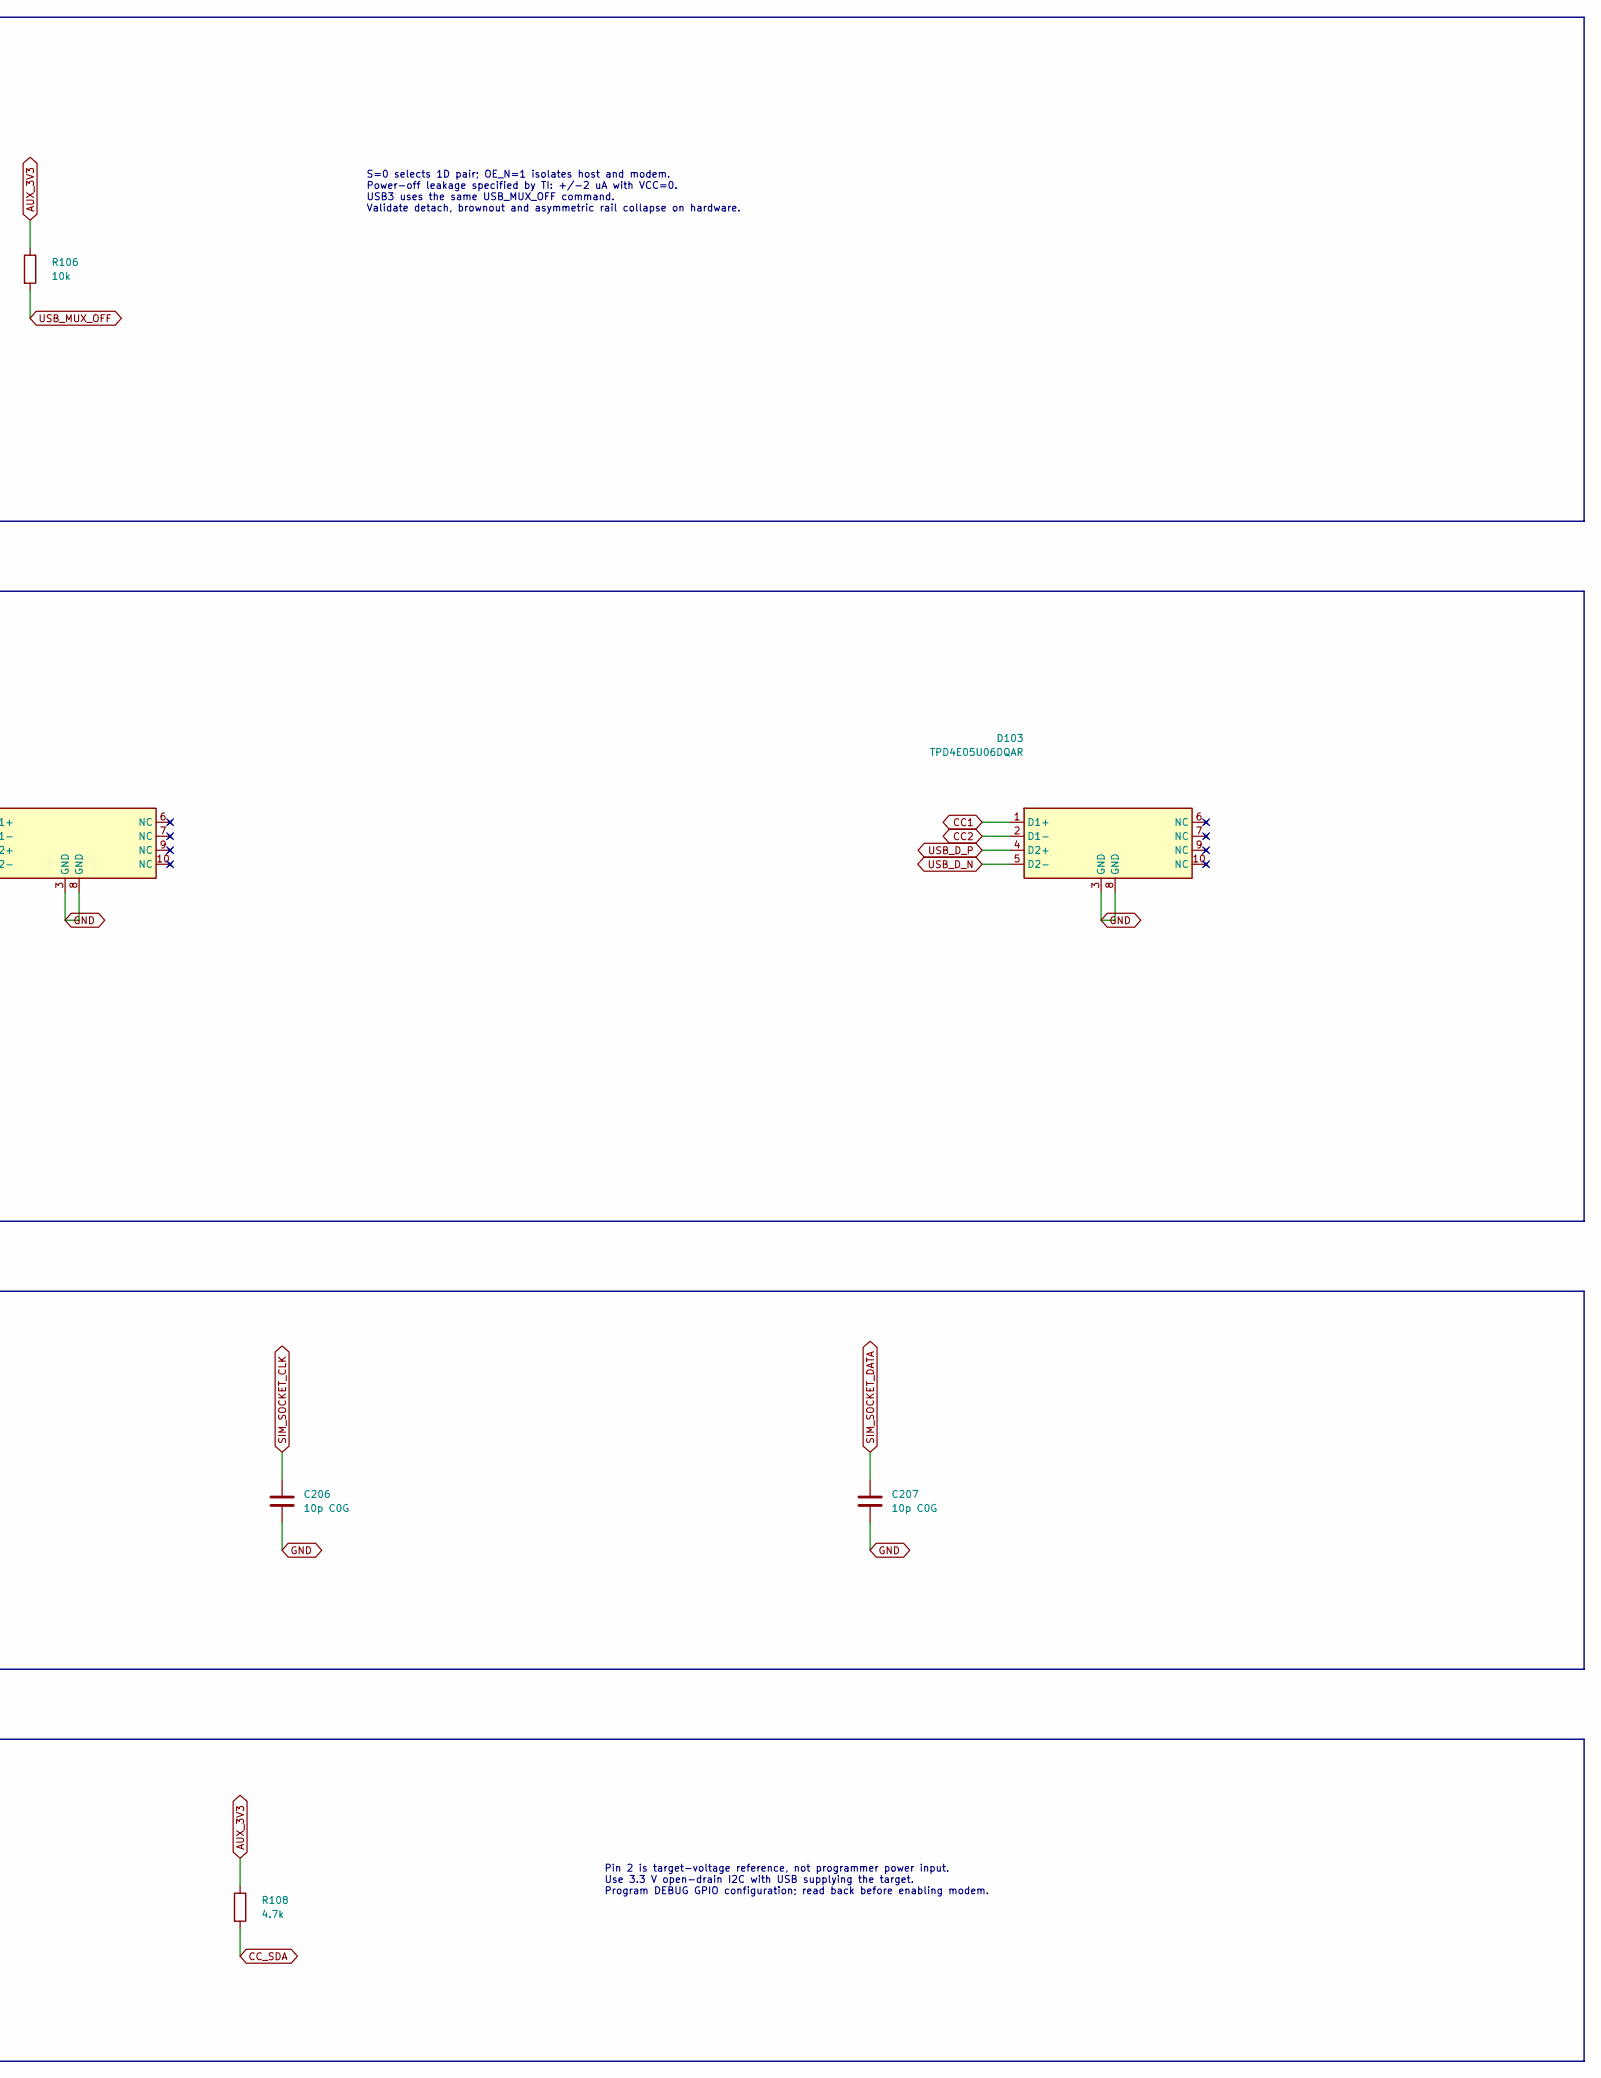
[picture p54: schematic protection.kicad_sch, USB and SIM protection, USB2 isolation and CC programming, part in row 1, column 2]

Parts:
C108: 100n; C_0805_2012Metric; MPN C2012X7R1H104K085AA
C205, C206, C207: 10p C0G; C_0805_2012Metric; MPN C0805C100J5GACTU
D101, D102: TPD4EUSB30DQAR; USON-10_2.5x1.0mm_P0.5mm; MPN TPD4EUSB30DQAR
D103, D203: TPD4E05U06DQAR; USON-10_2.5x1.0mm_P0.5mm; MPN TPD4E05U06DQAR
J102: I2C PROGRAM / USB POWERED; PinHeader_1x04_P2.54mm_Vertical; MPN TSW-104-07-G-S
R106: 10k; R_0603_1608Metric; MPN RC0603FR-0710KL
R107, R108: 4.7k; R_0603_1608Metric; MPN RC0603FR-074K7L
U105: TS3USB221ARSER; Texas_UQFN-10_1.5x2mm_P0.5mm; MPN TS3USB221ARSER

Connections:
AUX_3V3: C108.1, J102.2, R106.1, R107.1, R108.1, U105.10 (VCC); also elsewhere on the board
CC1: D103.1 (D1+); also elsewhere on the board
CC2: D103.2 (D1-); also elsewhere on the board
CC_SCL: J102.3, R107.2; also elsewhere on the board
CC_SDA: J102.4, R108.2; also elsewhere on the board
C_RX1_N: D101.5 (D2-); also elsewhere on the board
C_RX1_P: D101.4 (D2+); also elsewhere on the board
C_RX2_N: D102.5 (D2-); also elsewhere on the board
C_RX2_P: D102.4 (D2+); also elsewhere on the board
C_TX1_N: D101.2 (D1-); also elsewhere on the board
C_TX1_P: D101.1 (D1+); also elsewhere on the board
C_TX2_N: D102.2 (D1-); also elsewhere on the board
C_TX2_P: D102.1 (D1+); also elsewhere on the board
GND: C108.2, C205.2, C206.2, C207.2, D101.3 (GND), D101.8 (GND), D102.3 (GND), D102.8 (GND), D103.3 (GND), D103.8 (GND), D203.3 (GND), D203.8 (GND), J102.1, U105.5 (GND), U105.9 (S); also elsewhere on the board
MOD_USB_D_N: U105.2 (1D-); also elsewhere on the board
MOD_USB_D_P: U105.1 (1D+); also elsewhere on the board
SIM_SOCKET_CLK: C206.1, D203.4 (D2+); also elsewhere on the board
SIM_SOCKET_DATA: C207.1, D203.5 (D2-); also elsewhere on the board
SIM_SOCKET_RST: C205.1, D203.2 (D1-); also elsewhere on the board
SIM_VDD: D203.1 (D1+); also elsewhere on the board
USB_D_N: D103.5 (D2-), U105.7 (D-); also elsewhere on the board
USB_D_P: D103.4 (D2+), U105.8 (D+); also elsewhere on the board
USB_MUX_OFF: R106.2, U105.6 (OE_N); also elsewhere on the board

Notes on the sheet:
USB2 ISOLATION / BOTH DATA SWITCHES DISABLED DURING OFF STATE
S=0 selects 1D pair; OE_N=1 isolates host and modem. Power-off leakage specified by TI: +/-2 uA with VCC=0. USB3 uses the same USB_MUX_OFF command. Validate detach, brownout and asymmetric rail collapse on hardware.
CONNECTOR-SIDE ESD / PLACE BEFORE USB SWITCHES
Each SS pair uses matched channels. Shield and ESD returns need a short ground path. NC pads are left electrically unconnected in this capture. Route protected pads without branch stubs. Channel/connector insertion loss and system ESD performance require qualification.
SIM PROTECTION / MODULE-SUPPLIED VOLTAGE ONLY
EXTERNAL CC NVM PROGRAMMING / TEST ACCESS
Pin 2 is target-voltage reference, not programmer power input. Use 3.3 V open-drain I2C with USB supplying the target. Program DEBUG GPIO configuration; read back before enabling modem.

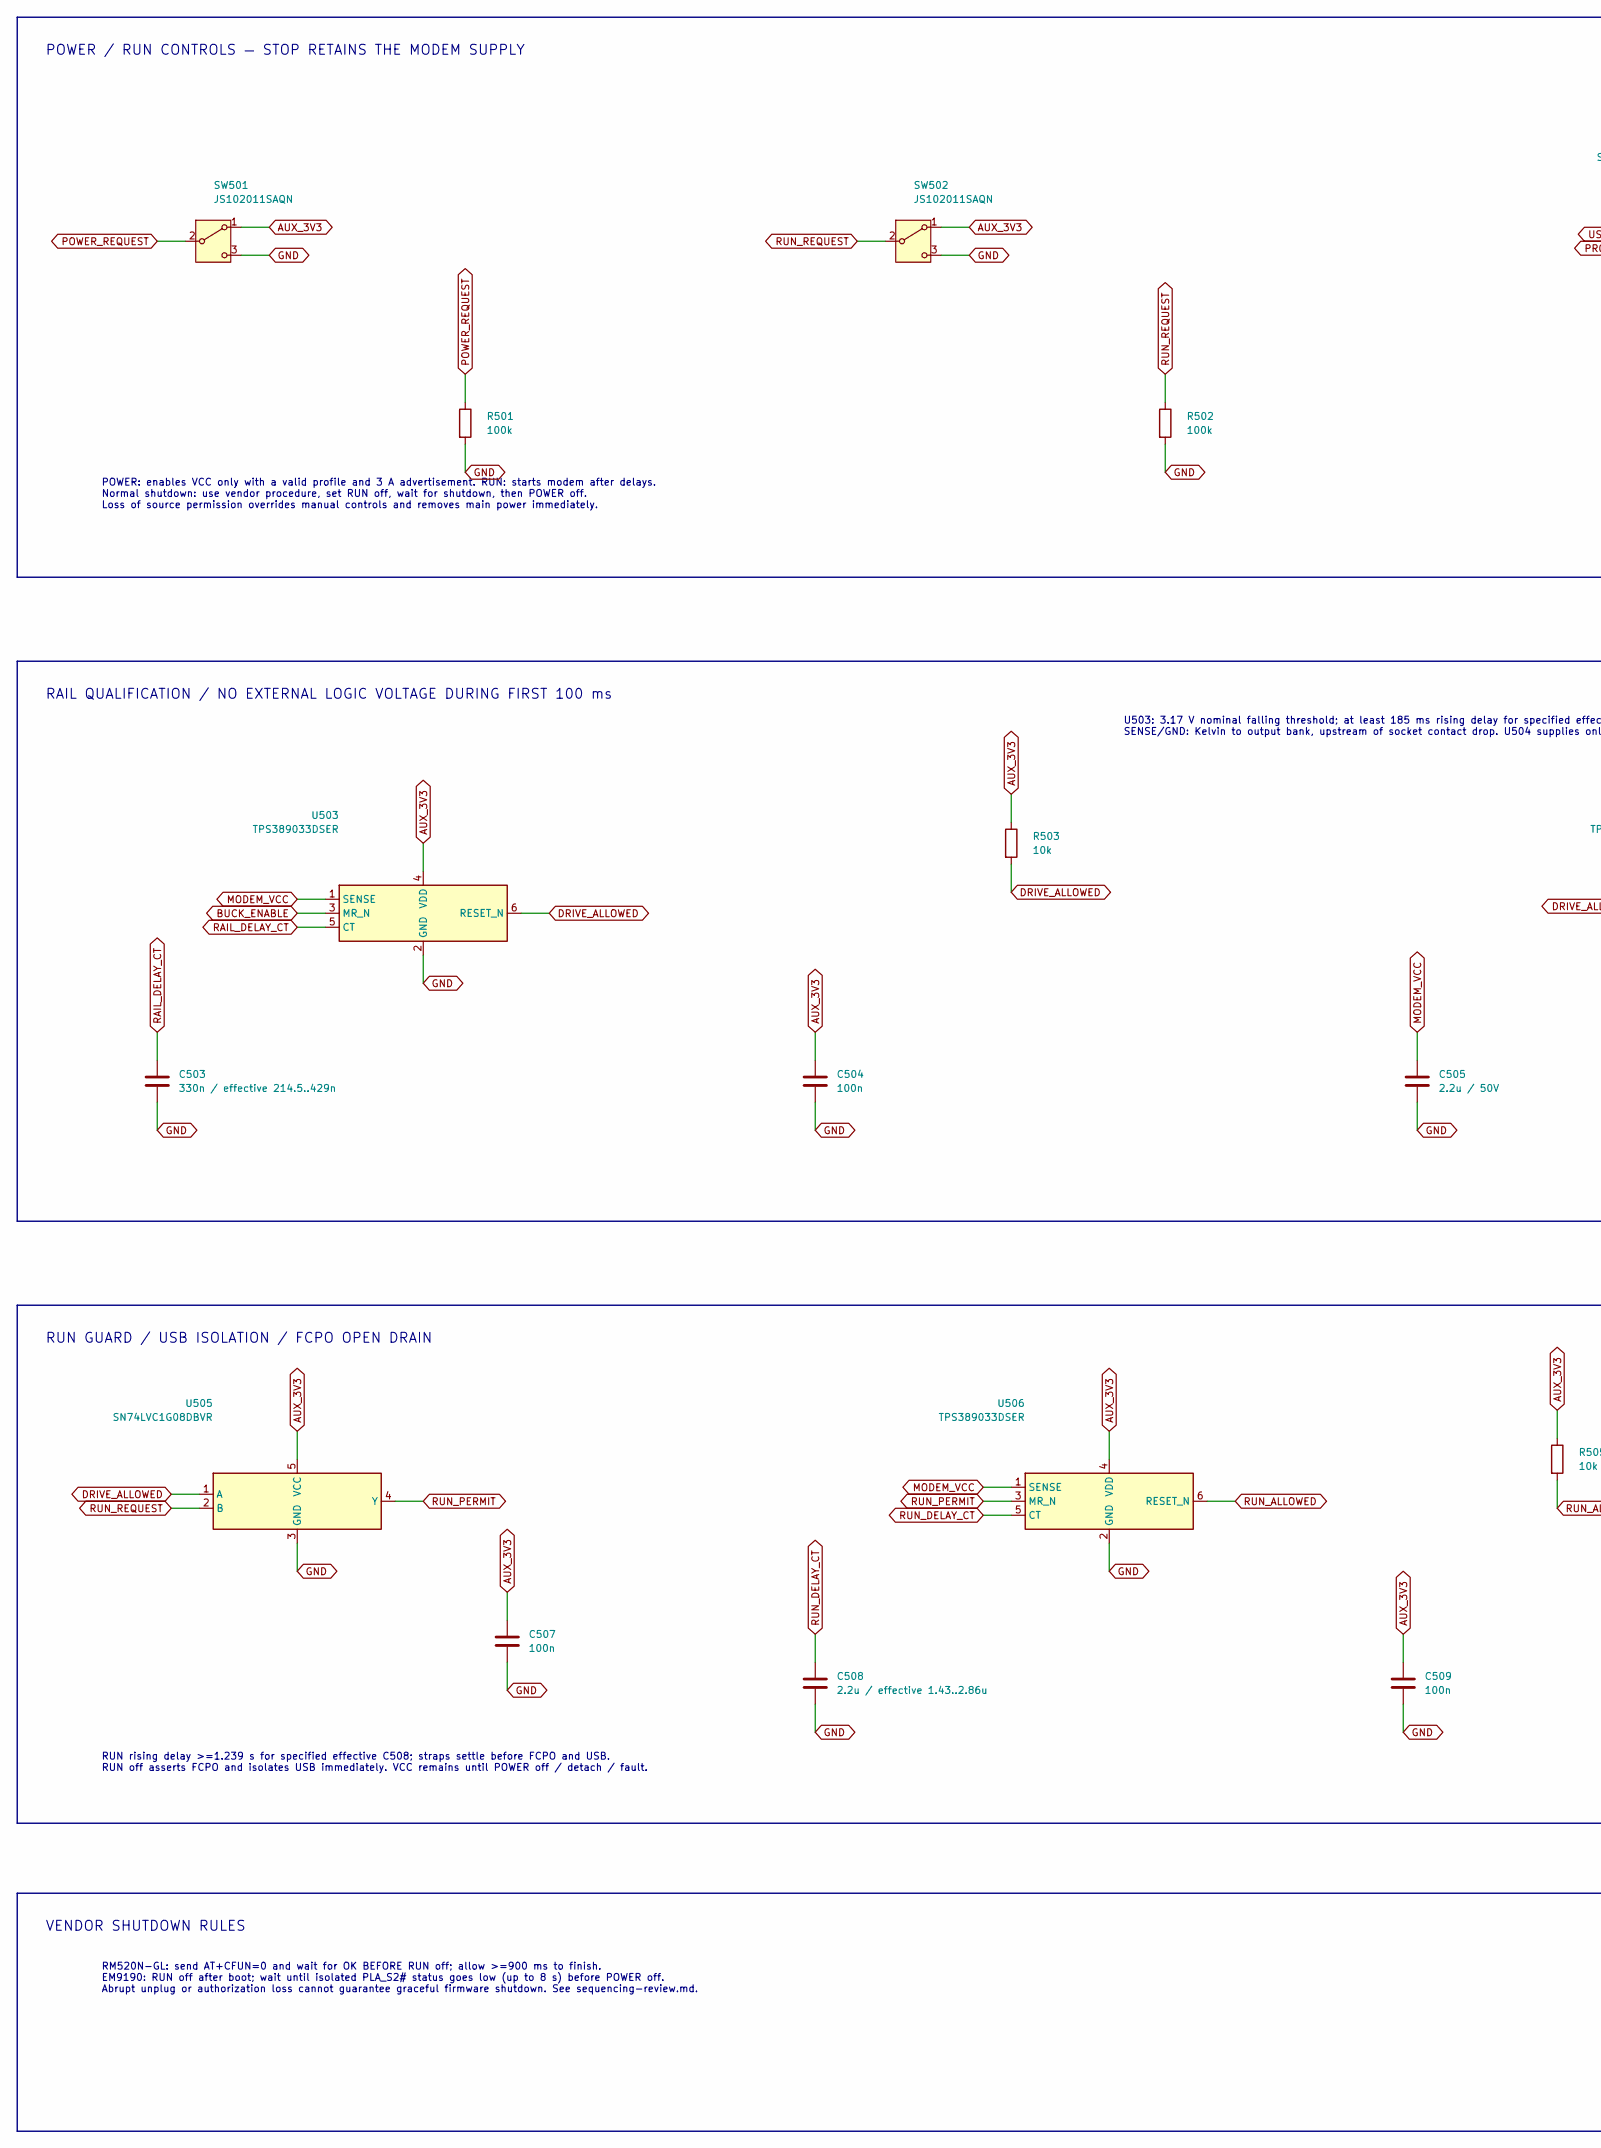
[picture p55: schematic controls.kicad_sch, Power and startup sequencing, part in row 1, column 1]

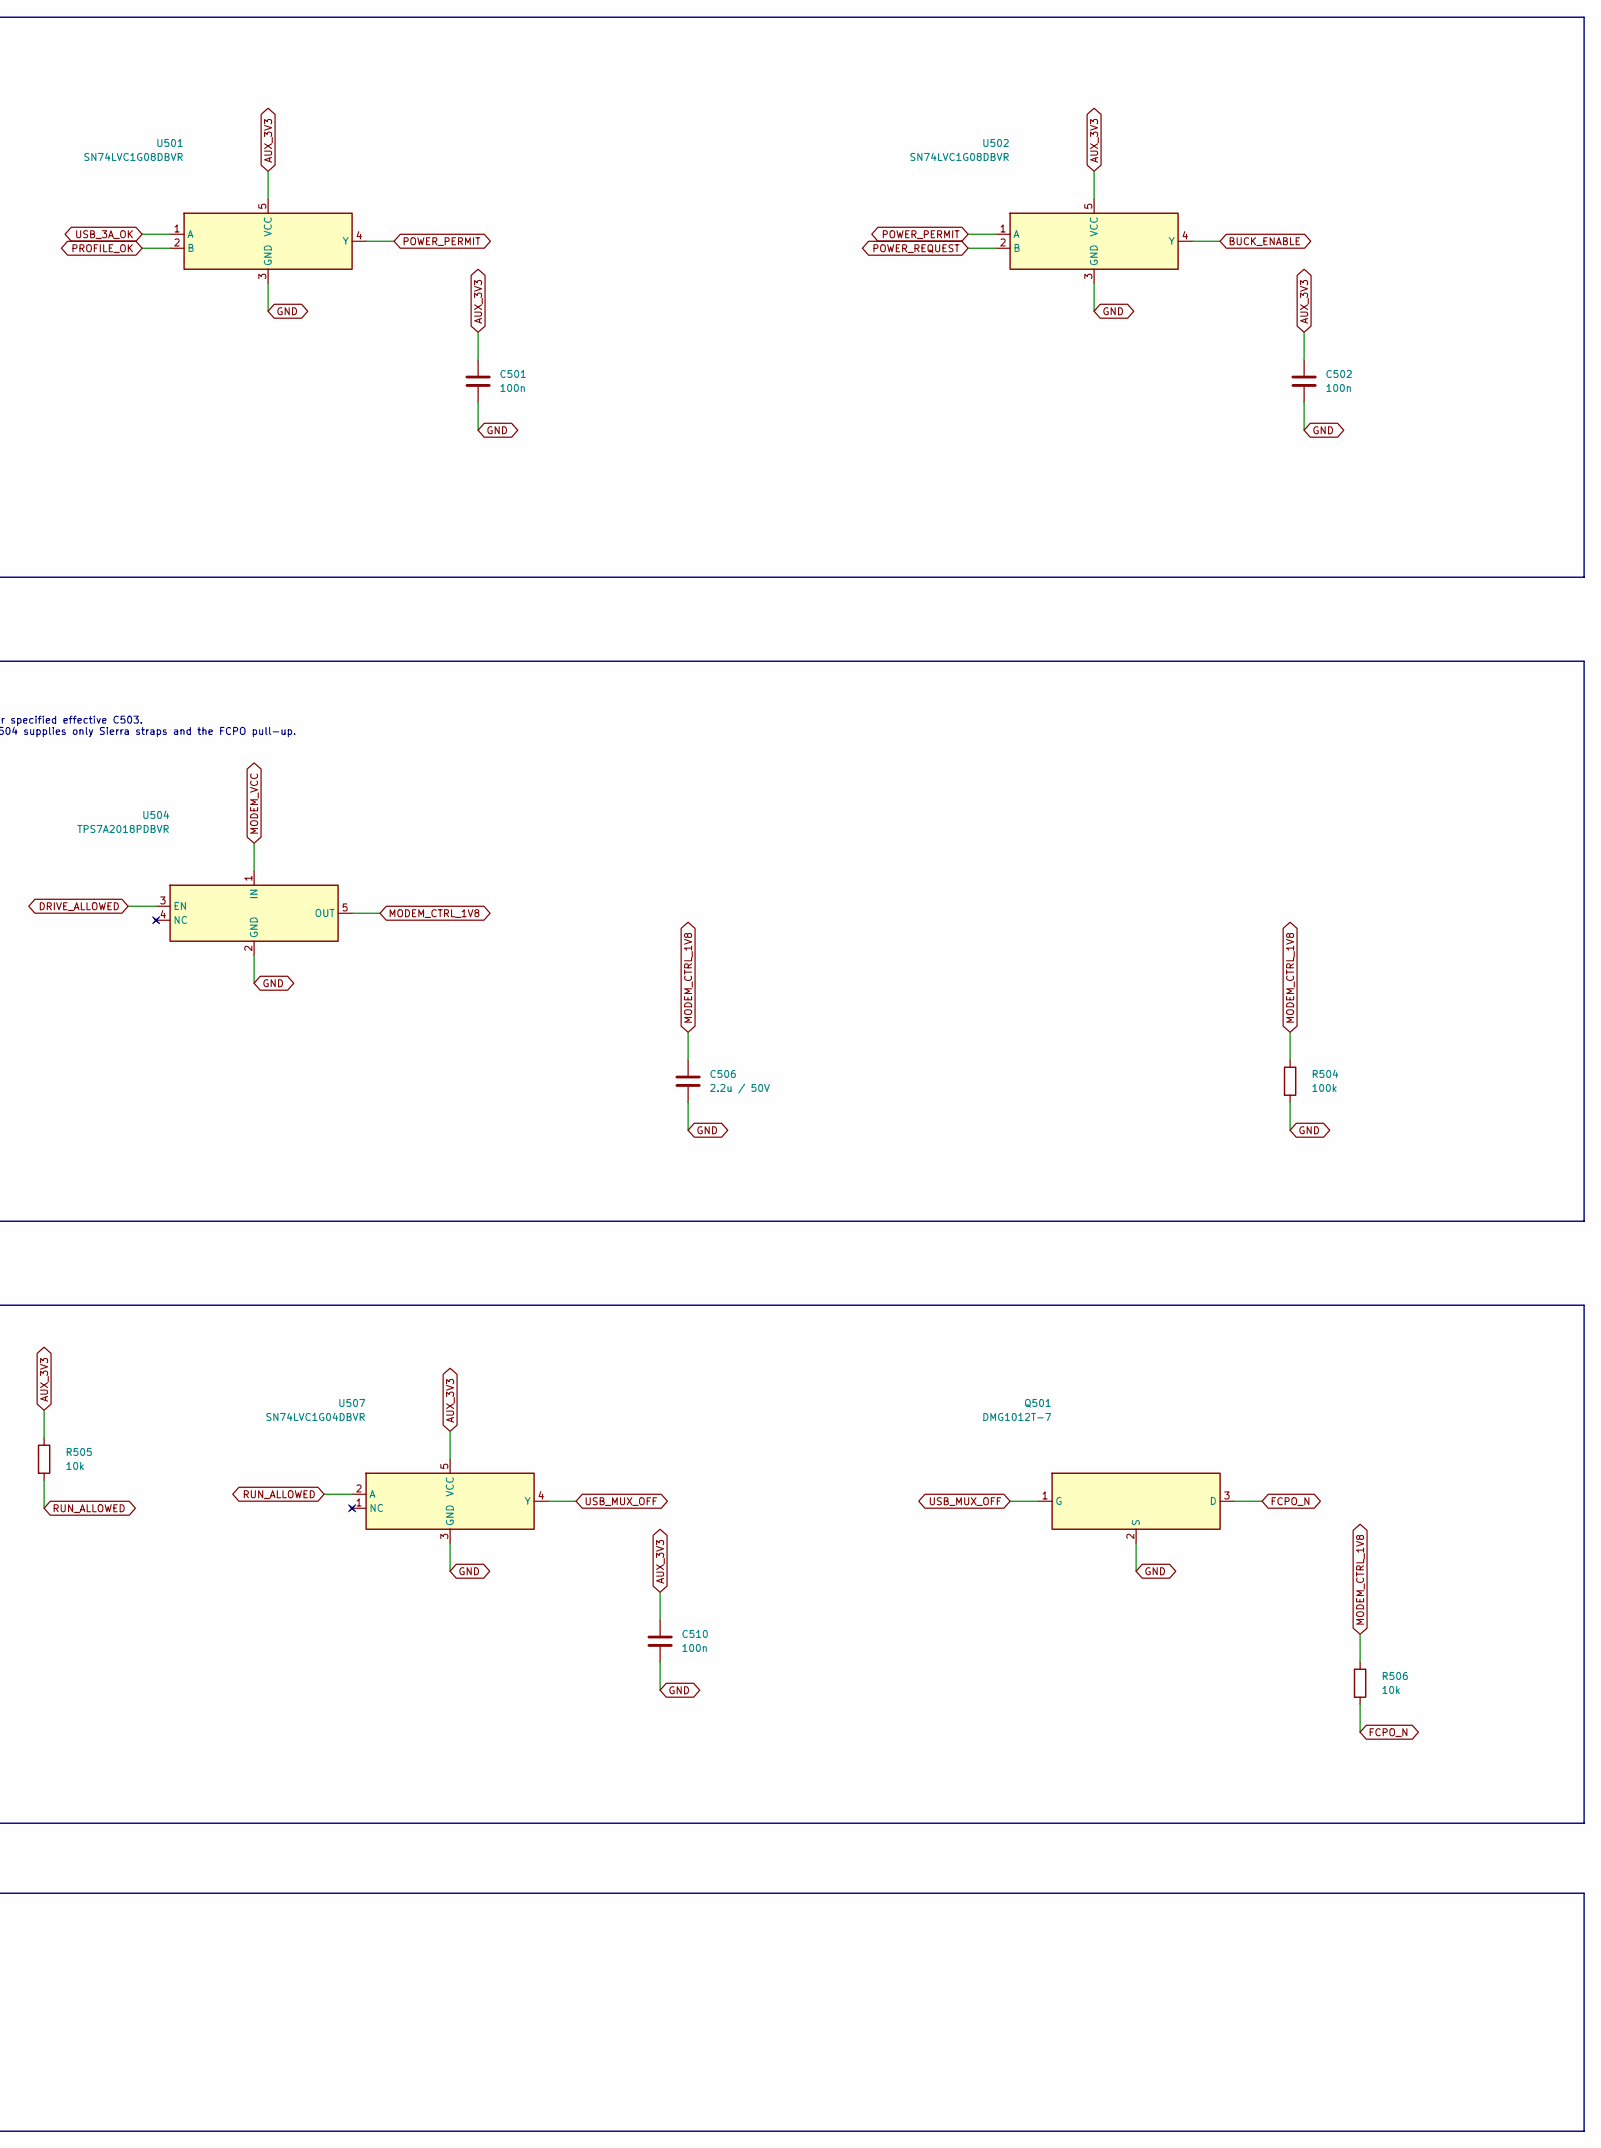
[picture p56: schematic controls.kicad_sch, Power and startup sequencing, part in row 1, column 2]

Parts:
C501, C502, C504, C507, C509, C510: 100n; C_0805_2012Metric; MPN C2012X7R1H104K085AA
C503: 330n / effective 214.5..429n; C_0805_2012Metric; MPN C2012X7R1H334K125AA
C505, C506: 2.2u / 50V; C_1206_3216Metric; MPN C3216X7R1H225K160AB
C508: 2.2u / effective 1.43..2.86u; C_1206_3216Metric; MPN C3216X7R1H225K160AB
Q501: DMG1012T-7; SOT-523; MPN DMG1012T-7
R501, R502, R504: 100k; R_0603_1608Metric; MPN RC0603FR-07100KL
R503, R505, R506: 10k; R_0603_1608Metric; MPN RC0603FR-0710KL
SW501, SW502: JS102011SAQN; SW_SPDT_CK_JS102011SAQN; MPN JS102011SAQN
U501, U502, U505: SN74LVC1G08DBVR; SOT-23-5; MPN SN74LVC1G08DBVR
U503, U506: TPS389033DSER; WSON-6_1.5x1.5mm_P0.5mm; MPN TPS389033DSER
U504: TPS7A2018PDBVR; SOT-23-5; MPN TPS7A2018PDBVR
U507: SN74LVC1G04DBVR; SOT-23-5; MPN SN74LVC1G04DBVR

Connections:
AUX_3V3: C501.1, C502.1, C504.1, C507.1, C509.1, C510.1, R503.1, R505.1, SW501.1 (A), SW502.1 (A), U501.5 (VCC), U502.5 (VCC), U503.4 (VDD), U505.5 (VCC), U506.4 (VDD), U507.5 (VCC); also elsewhere on the board
BUCK_ENABLE: U502.4 (Y), U503.3 (MR_N); also elsewhere on the board
DRIVE_ALLOWED: R503.2, U503.6 (RESET_N), U504.3 (EN), U505.1 (A); also elsewhere on the board
FCPO_N: Q501.3 (D), R506.2; also elsewhere on the board
GND: C501.2, C502.2, C503.2, C504.2, C505.2, C506.2, C507.2, C508.2, C509.2, C510.2, Q501.2 (S), R501.2, R502.2, R504.2, SW501.3 (C), SW502.3 (C), U501.3 (GND), U502.3 (GND), U503.2 (GND), U504.2 (GND), U505.3 (GND), U506.2 (GND), U507.3 (GND); also elsewhere on the board
MODEM_CTRL_1V8: C506.1, R504.1, R506.1, U504.5 (OUT); also elsewhere on the board
MODEM_VCC: C505.1, U503.1 (SENSE), U504.1 (IN), U506.1 (SENSE); also elsewhere on the board
POWER_PERMIT: U501.4 (Y), U502.1 (A)
POWER_REQUEST: R501.1, SW501.2 (B), U502.2 (B)
PROFILE_OK: U501.2 (B); also elsewhere on the board
RAIL_DELAY_CT: C503.1, U503.5 (CT)
RUN_ALLOWED: R505.2, U506.6 (RESET_N), U507.2 (A); also elsewhere on the board
RUN_DELAY_CT: C508.1, U506.5 (CT)
RUN_PERMIT: U505.4 (Y), U506.3 (MR_N)
RUN_REQUEST: R502.1, SW502.2 (B), U505.2 (B)
USB_3A_OK: U501.1 (A); also elsewhere on the board
USB_MUX_OFF: Q501.1 (G), U507.4 (Y); also elsewhere on the board

Notes on the sheet:
POWER / RUN CONTROLS — STOP RETAINS THE MODEM SUPPLY
POWER: enables VCC only with a valid profile and 3 A advertisement. RUN: starts modem after delays. Normal shutdown: use vendor procedure, set RUN off, wait for shutdown, then POWER off. Loss of source permission overrides manual controls and removes main power immediately.
RAIL QUALIFICATION / NO EXTERNAL LOGIC VOLTAGE DURING FIRST 100 ms
U503: 3.17 V nominal falling threshold; at least 185 ms rising delay for specified effective C503. SENSE/GND: Kelvin to output bank, upstream of socket contact drop. U504 supplies only Sierra straps and the FCPO pull-up.
RUN GUARD / USB ISOLATION / FCPO OPEN DRAIN
RUN rising delay >=1.239 s for specified effective C508; straps settle before FCPO and USB. RUN off asserts FCPO and isolates USB immediately. VCC remains until POWER off / detach / fault.
VENDOR SHUTDOWN RULES
RM520N-GL: send AT+CFUN=0 and wait for OK BEFORE RUN off; allow >=900 ms to finish. EM9190: RUN off after boot; wait until isolated PLA_S2# status goes low (up to 8 s) before POWER off. Abrupt unplug or authorization loss cannot guarantee graceful firmware shutdown. See sequencing-review.md.
