alxgmpr/sierra-to-usb/compact/carrier/carrier.kicad_pcb

## KiCad design compact/carrier/carrier.kicad_pcb (continued)

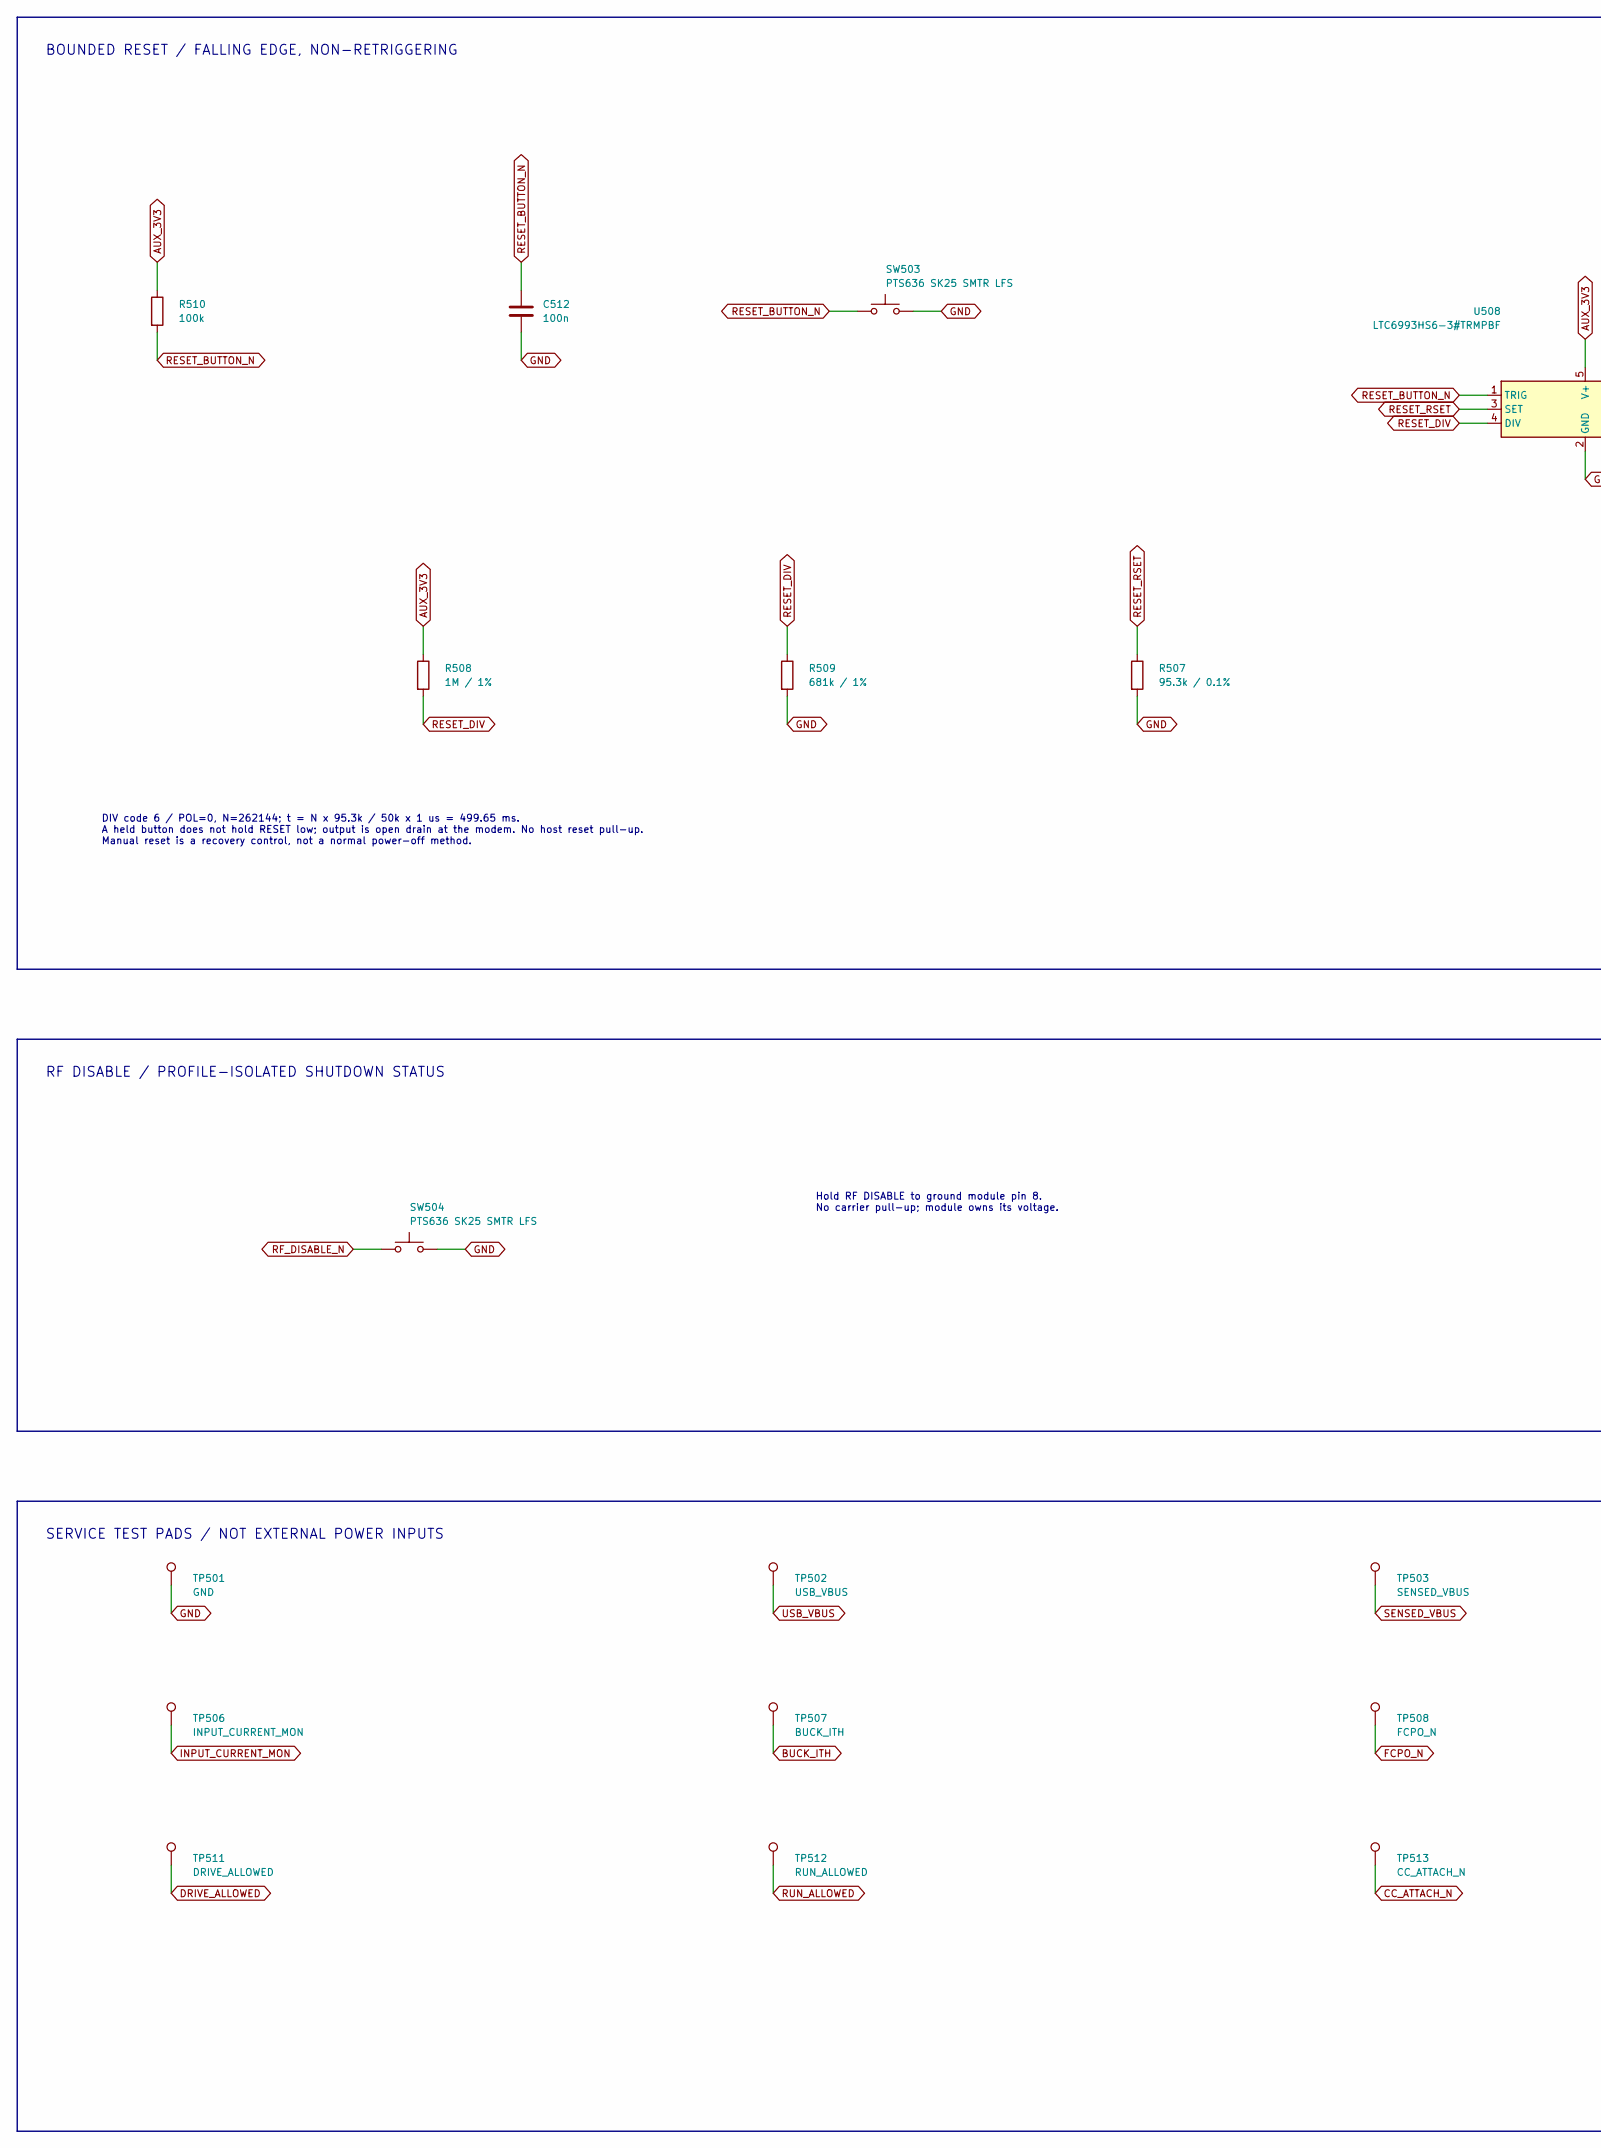
[picture p57: schematic service.kicad_sch, Reset, RF disable and service access, part in row 1, column 1]

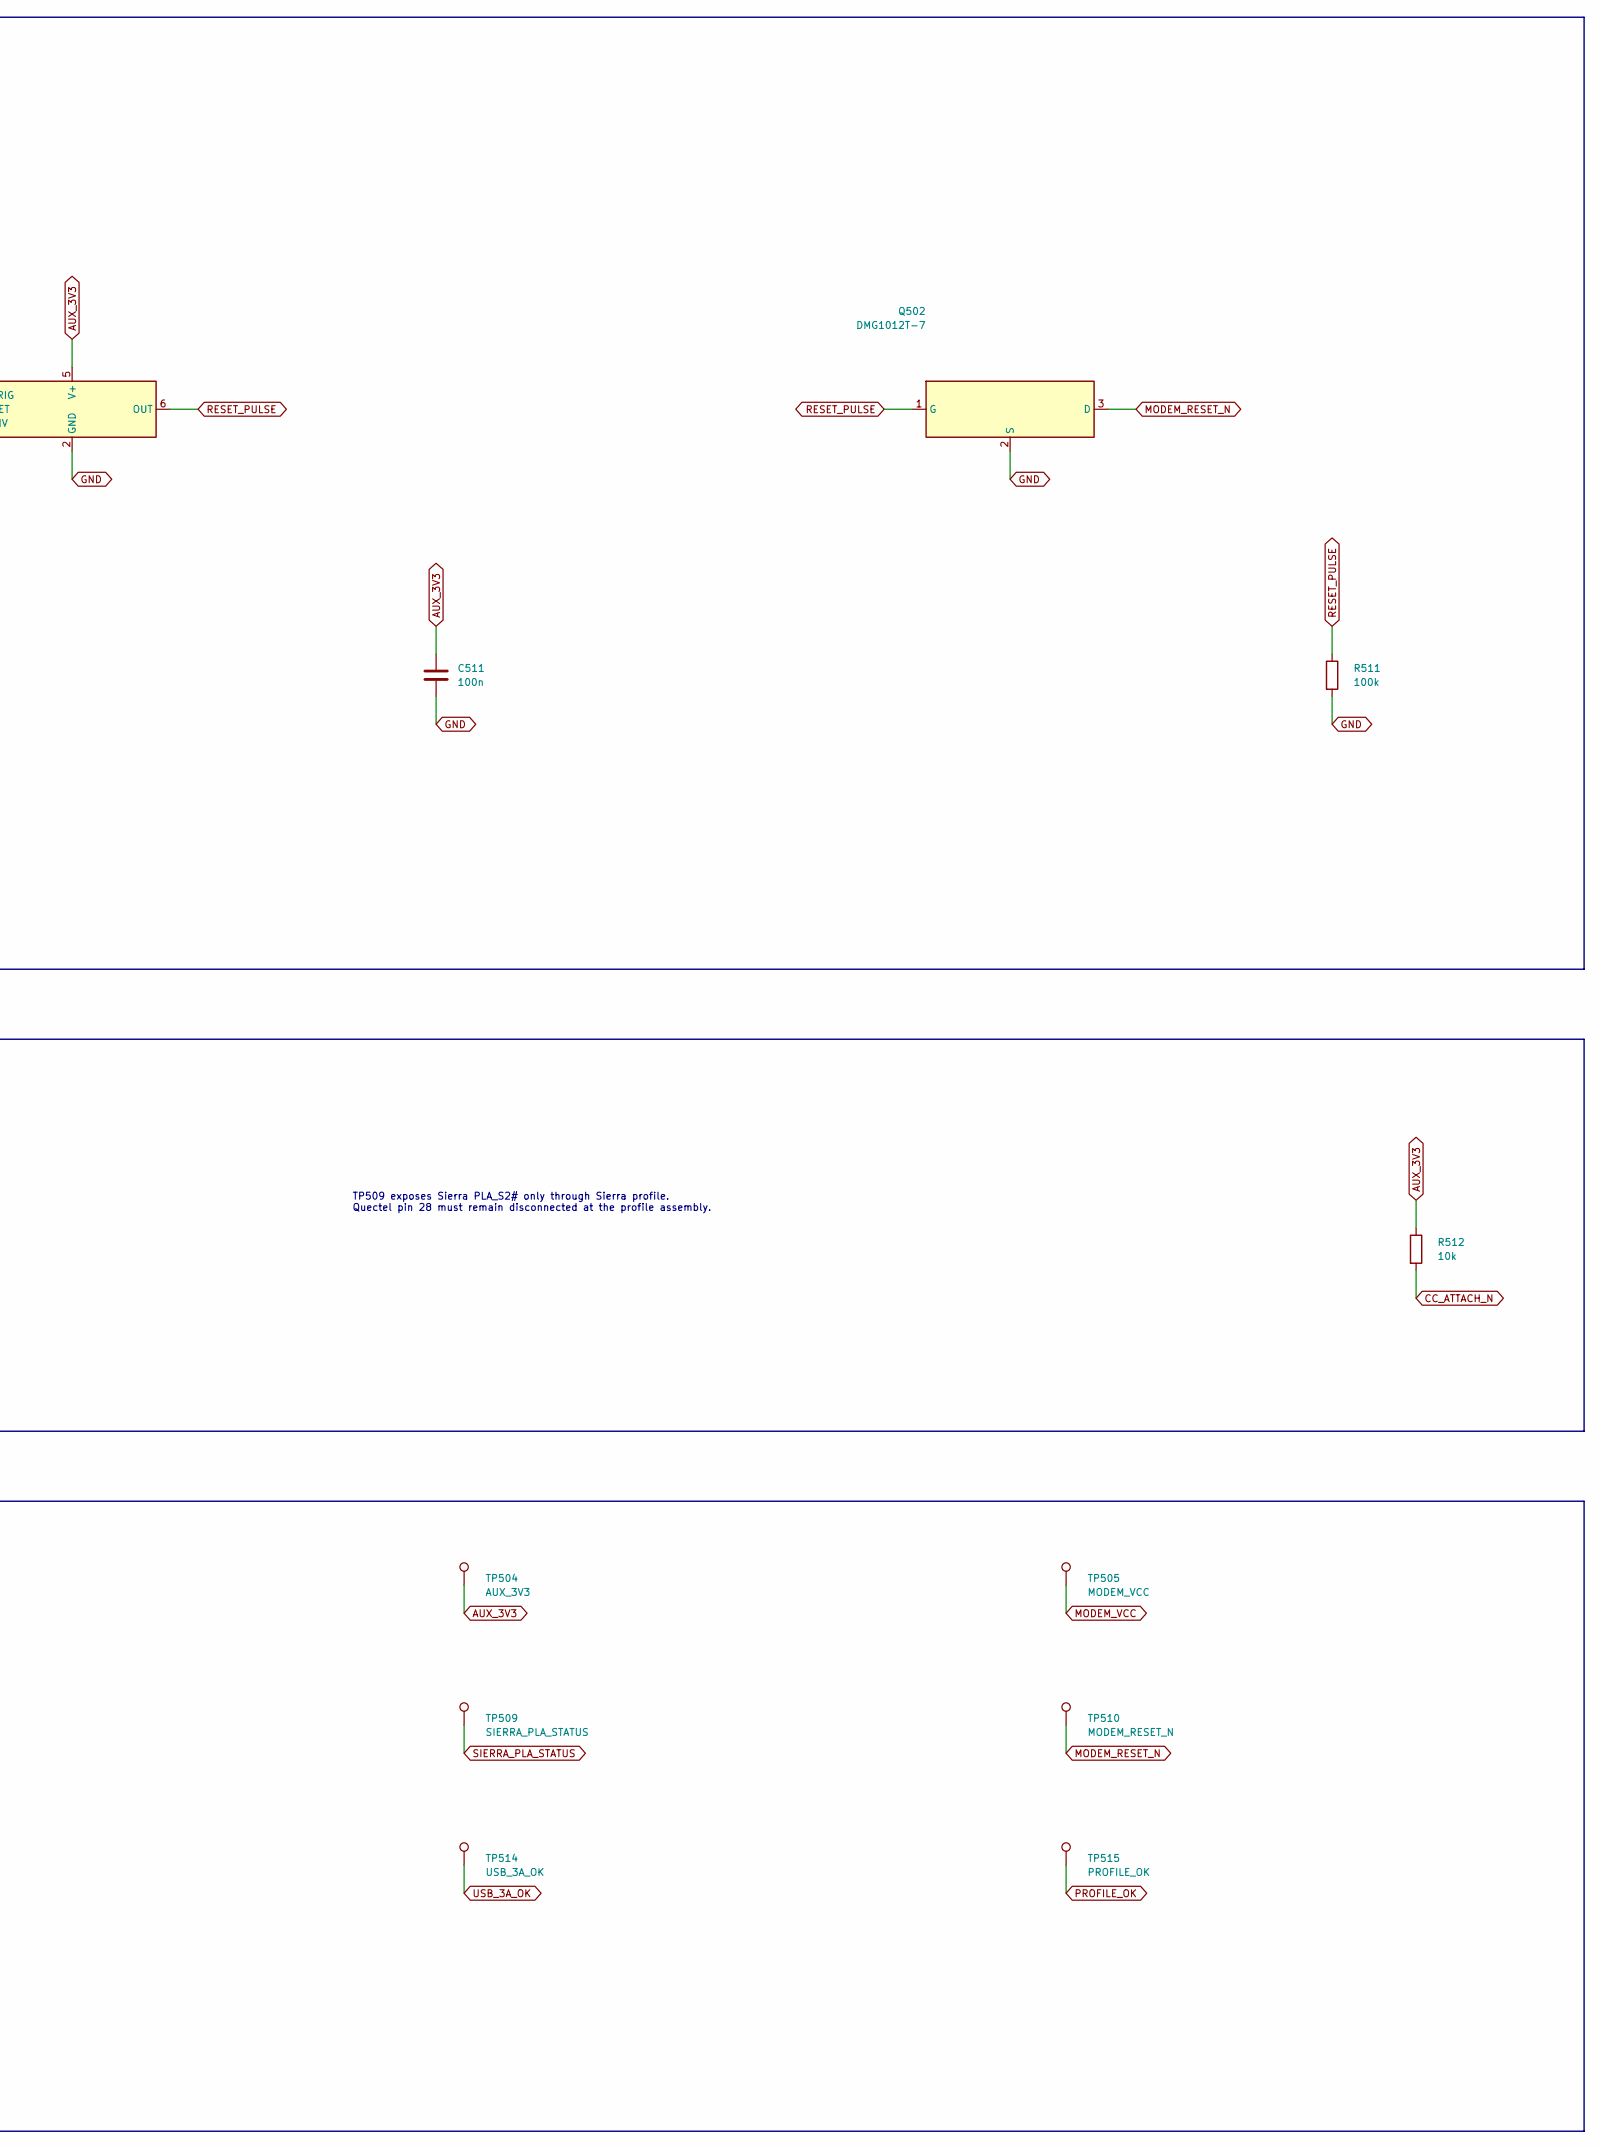
[picture p58: schematic service.kicad_sch, Reset, RF disable and service access, part in row 1, column 2]

Parts:
C511, C512: 100n; C_0805_2012Metric; MPN C2012X7R1H104K085AA
Q502: DMG1012T-7; SOT-523; MPN DMG1012T-7
R507: 95.3k / 0.1%; R_0603_1608Metric; MPN RT0603BRD0795K3L
R508: 1M / 1%; R_0603_1608Metric; MPN RC0603FR-071ML
R509: 681k / 1%; R_0603_1608Metric; MPN RC0603FR-07681KL
R510, R511: 100k; R_0603_1608Metric; MPN RC0603FR-07100KL
R512: 10k; R_0603_1608Metric; MPN RC0603FR-0710KL
SW503, SW504: PTS636 SK25 SMTR LFS; SW_Tactile_SPST_NO_Straight_CK_PTS636Sx25SMTRLFS; MPN PTS636 SK25 SMTR LFS
TP501: GND; TestPoint_Pad_D1.0mm; MPN PCB_TEST_PAD
TP502: USB_VBUS; TestPoint_Pad_D1.0mm; MPN PCB_TEST_PAD
TP503: SENSED_VBUS; TestPoint_Pad_D1.0mm; MPN PCB_TEST_PAD
TP504: AUX_3V3; TestPoint_Pad_D1.0mm; MPN PCB_TEST_PAD
TP505: MODEM_VCC; TestPoint_Pad_D1.0mm; MPN PCB_TEST_PAD
TP506: INPUT_CURRENT_MON; TestPoint_Pad_D1.0mm; MPN PCB_TEST_PAD
TP507: BUCK_ITH; TestPoint_Pad_D1.0mm; MPN PCB_TEST_PAD
TP508: FCPO_N; TestPoint_Pad_D1.0mm; MPN PCB_TEST_PAD
TP509: SIERRA_PLA_STATUS; TestPoint_Pad_D1.0mm; MPN PCB_TEST_PAD
TP510: MODEM_RESET_N; TestPoint_Pad_D1.0mm; MPN PCB_TEST_PAD
TP511: DRIVE_ALLOWED; TestPoint_Pad_D1.0mm; MPN PCB_TEST_PAD
TP512: RUN_ALLOWED; TestPoint_Pad_D1.0mm; MPN PCB_TEST_PAD
TP513: CC_ATTACH_N; TestPoint_Pad_D1.0mm; MPN PCB_TEST_PAD
TP514: USB_3A_OK; TestPoint_Pad_D1.0mm; MPN PCB_TEST_PAD
TP515: PROFILE_OK; TestPoint_Pad_D1.0mm; MPN PCB_TEST_PAD
U508: LTC6993HS6-3#TRMPBF; TSOT-23-6; MPN LTC6993HS6-3#TRMPBF

Connections:
AUX_3V3: C511.1, R508.1, R510.1, R512.1, TP504.1, U508.5 (V+); also elsewhere on the board
BUCK_ITH: TP507.1; also elsewhere on the board
CC_ATTACH_N: R512.2, TP513.1; also elsewhere on the board
DRIVE_ALLOWED: TP511.1; also elsewhere on the board
FCPO_N: TP508.1; also elsewhere on the board
GND: C511.2, C512.2, Q502.2 (S), R507.2, R509.2, R511.2, SW503.2, SW504.2, TP501.1, U508.2 (GND); also elsewhere on the board
INPUT_CURRENT_MON: TP506.1; also elsewhere on the board
MODEM_RESET_N: Q502.3 (D), TP510.1; also elsewhere on the board
MODEM_VCC: TP505.1; also elsewhere on the board
PROFILE_OK: TP515.1; also elsewhere on the board
RESET_BUTTON_N: C512.1, R510.2, SW503.1, U508.1 (TRIG)
RESET_DIV: R508.2, R509.1, U508.4 (DIV)
RESET_PULSE: Q502.1 (G), R511.1, U508.6 (OUT)
RESET_RSET: R507.1, U508.3 (SET)
RF_DISABLE_N: SW504.1; also elsewhere on the board
RUN_ALLOWED: TP512.1; also elsewhere on the board
SENSED_VBUS: TP503.1; also elsewhere on the board
SIERRA_PLA_STATUS: TP509.1; also elsewhere on the board
USB_3A_OK: TP514.1; also elsewhere on the board
USB_VBUS: TP502.1; also elsewhere on the board

Notes on the sheet:
BOUNDED RESET / FALLING EDGE, NON-RETRIGGERING
DIV code 6 / POL=0, N=262144; t = N x 95.3k / 50k x 1 us = 499.65 ms. A held button does not hold RESET low; output is open drain at the modem. No host reset pull-up. Manual reset is a recovery control, not a normal power-off method.
RF DISABLE / PROFILE-ISOLATED SHUTDOWN STATUS
Hold RF DISABLE to ground module pin 8. No carrier pull-up; module owns its voltage.
TP509 exposes Sierra PLA_S2# only through Sierra profile. Quectel pin 28 must remain disconnected at the profile assembly.
SERVICE TEST PADS / NOT EXTERNAL POWER INPUTS

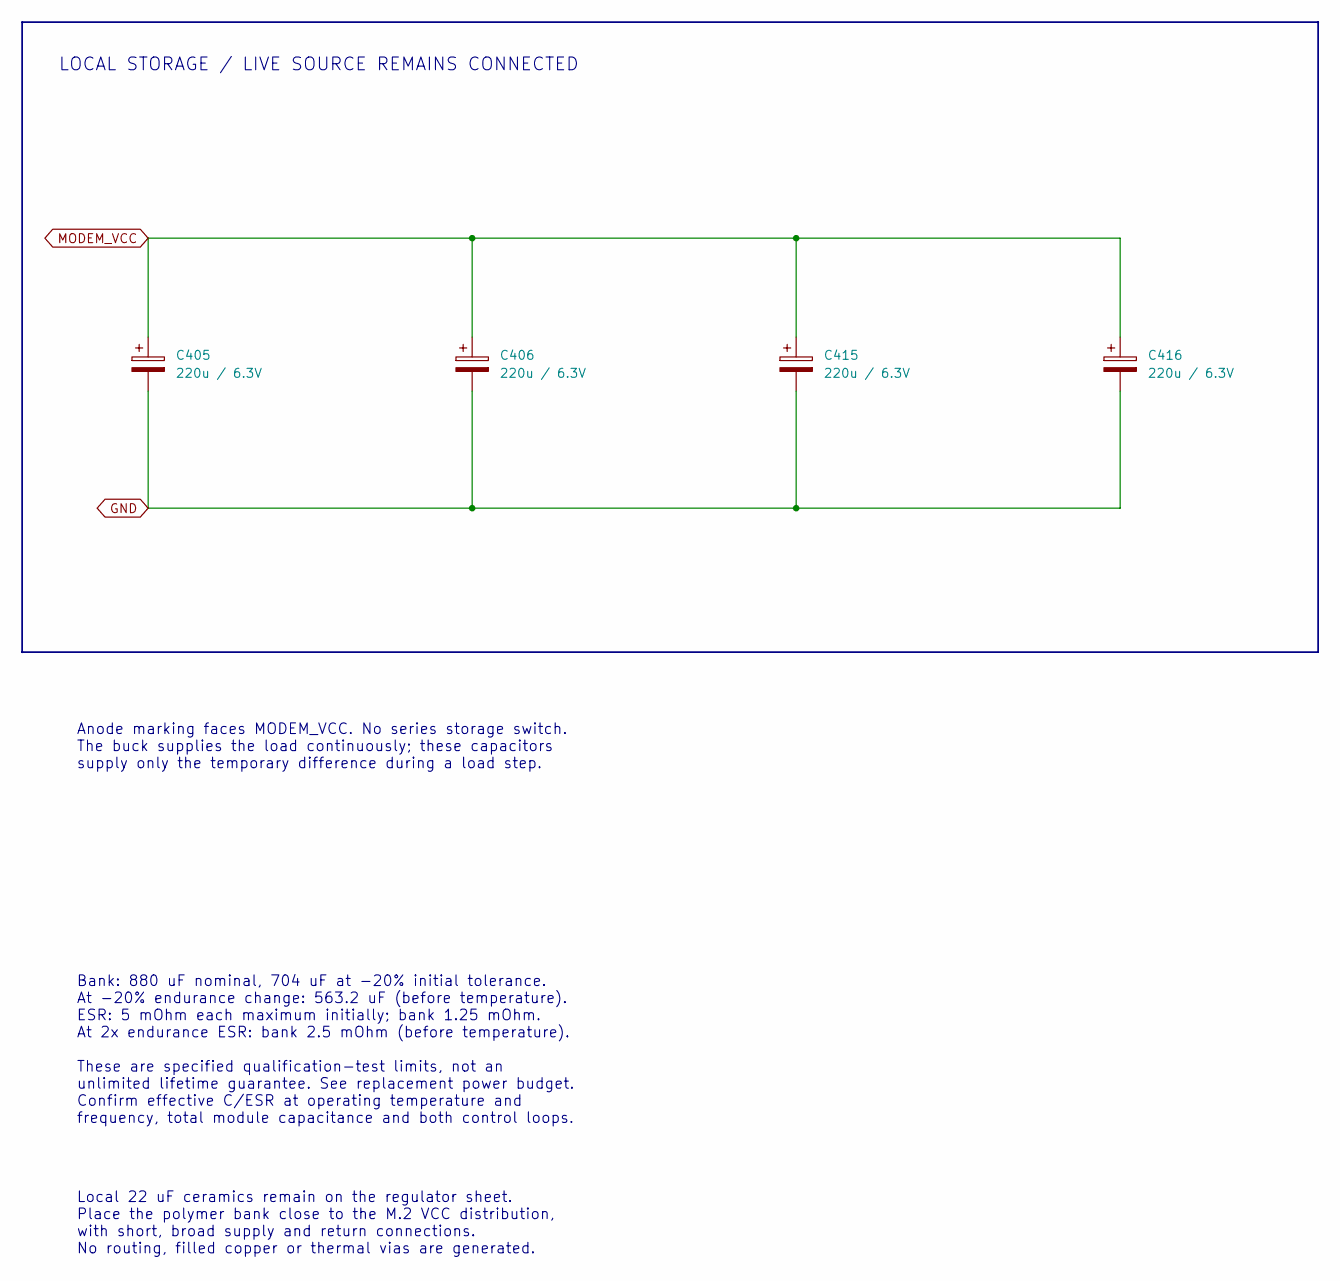
[picture p59: schematic storage.kicad_sch, Local transient storage]

Parts:
C405, C406, C415, C416: 220u / 6.3V; KEMET_D_7343_Median; MPN T530D227M006ATE005

Connections:
GND: C405.2, C406.2, C415.2, C416.2; also elsewhere on the board
MODEM_VCC: C405.1, C406.1, C415.1, C416.1; also elsewhere on the board

Notes on the sheet:
LOCAL STORAGE / LIVE SOURCE REMAINS CONNECTED
Anode marking faces MODEM_VCC. No series storage switch. The buck supplies the load continuously; these capacitors supply only the temporary difference during a load step.
Bank: 880 uF nominal, 704 uF at -20% initial tolerance. At -20% endurance change: 563.2 uF (before temperature). ESR: 5 mOhm each maximum initially; bank 1.25 mOhm. At 2x endurance ESR: bank 2.5 mOhm (before temperature). These are specified qualification-test limits, not an unlimited lifetime guar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
Local 22 uF ceramics remain on the regulator sheet. Place the polymer bank close to the M.2 VCC distribution, with short, broad supply and return connections. No routing, filled copper or thermal vias are generated.

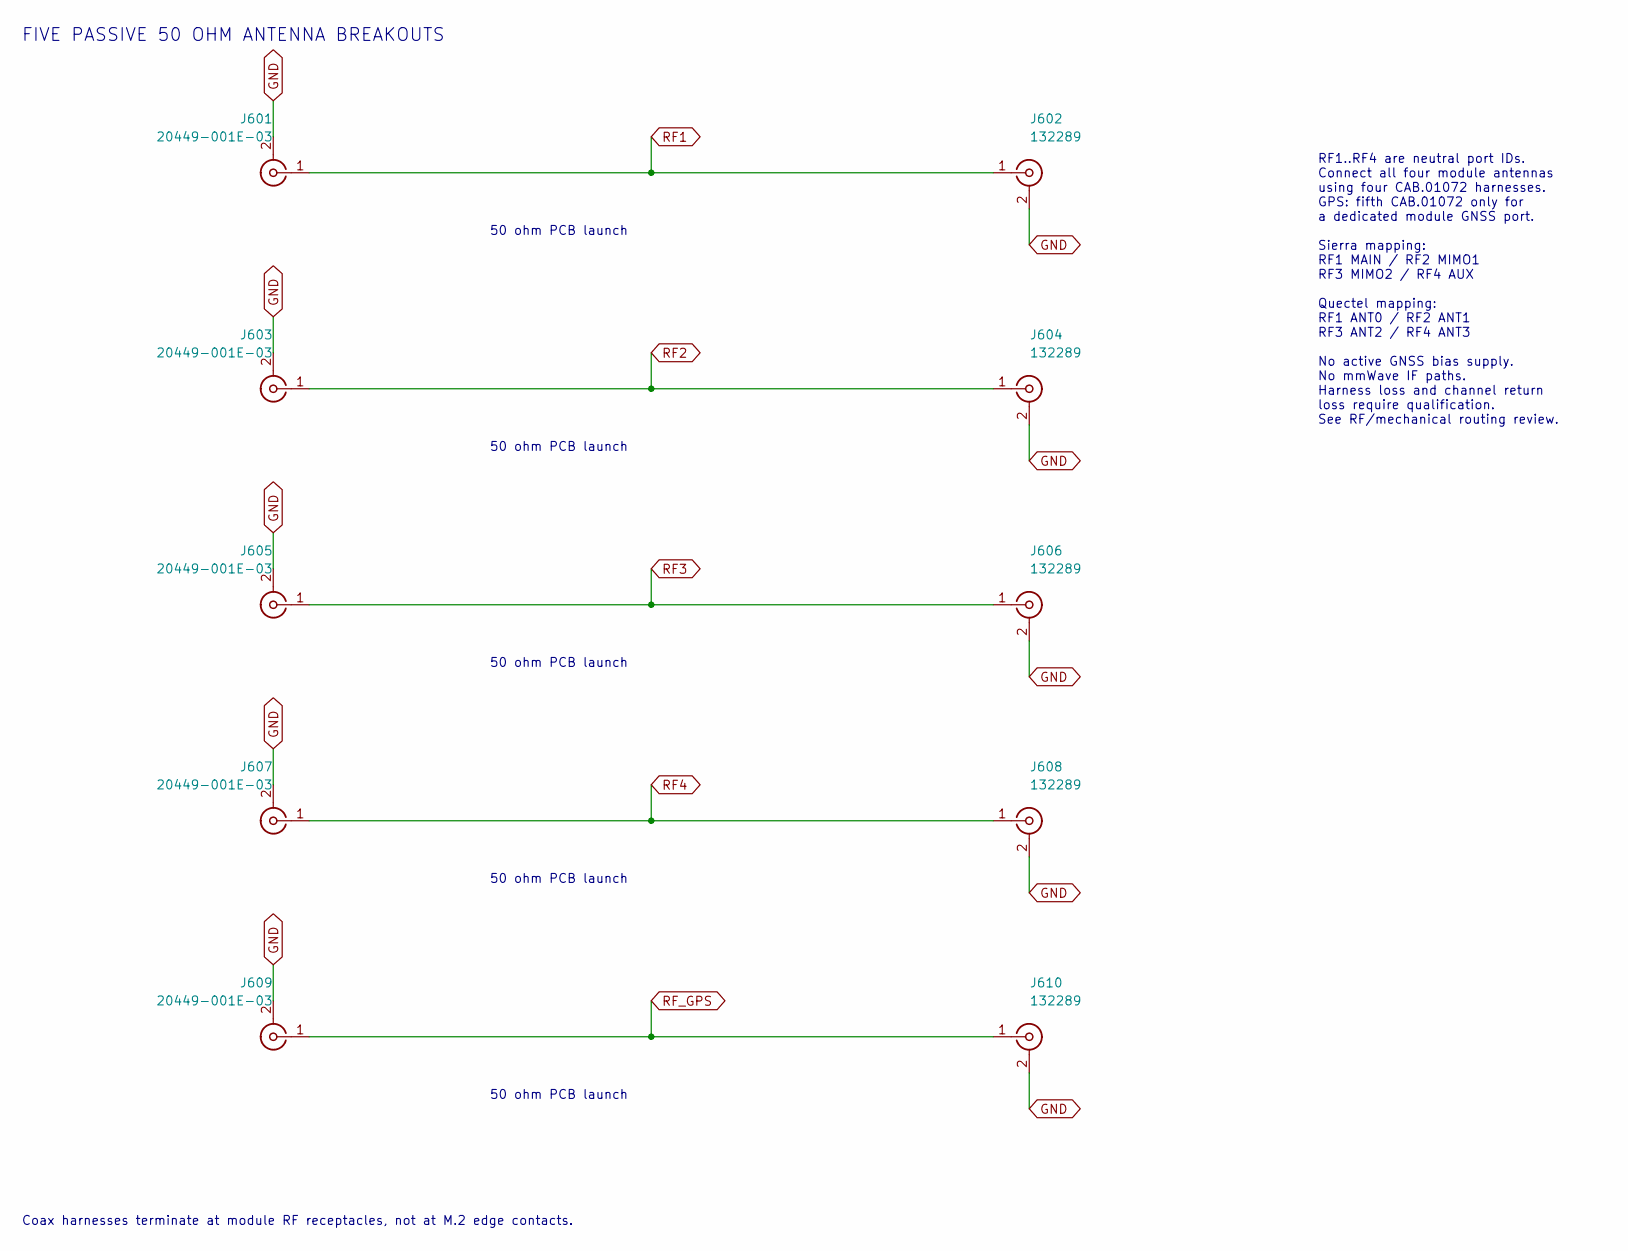
[picture p60: schematic rf.kicad_sch, Four cellular and one GPS breakout]

Parts:
J601, J603, J605, J607, J609: 20449-001E-03; IPEX_MHF4_20449_001E_03; MPN 20449-001E-03
J602, J604, J606, J608, J610: 132289; SMA_Amphenol_132289_Manufacturer; MPN 132289

Connections:
GND: J601.2 (Ext), J602.2 (Ext), J603.2 (Ext), J604.2 (Ext), J605.2 (Ext), J606.2 (Ext), J607.2 (Ext), J608.2 (Ext), J609.2 (Ext), J610.2 (Ext); also elsewhere on the board
RF1: J601.1 (In), J602.1 (In)
RF2: J603.1 (In), J604.1 (In)
RF3: J605.1 (In), J606.1 (In)
RF4: J607.1 (In), J608.1 (In)
RF_GPS: J609.1 (In), J610.1 (In)

Notes on the sheet:
FIVE PASSIVE 50 OHM ANTENNA BREAKOUTS
50 ohm PCB launch
RF1..RF4 are neutral port IDs. Connect all four module antennas using four CAB.01072 harnesses. GPS: fifth CAB.01072 only for a dedicated module GNSS port. Sierra mapping: RF1 MAIN / RF2 MIMO1 RF3 MIMO2 / RF4 AUX Quectel mapping: RF1 ANT0 / RF2 ANT1 RF3 ANT2 / RF4 ANT3 No active GNSS bias supply. N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
Coax harnesses terminate at module RF receptacles, not at M.2 edge contacts.

Board: 4 copper layers, 168 parts (0 on the bottom side), 101 nets, no tracks yet.

Other parts of the board:
H1: H1
H2: H2
H3: H3
H4: H4
H5: H5
H10: H10
MECH1: MECH1
