alxgmpr/sierra-to-usb/sierra-to-usb.kicad_pcb

## KiCad design sierra-to-usb.kicad_pcb (2026-08-12)

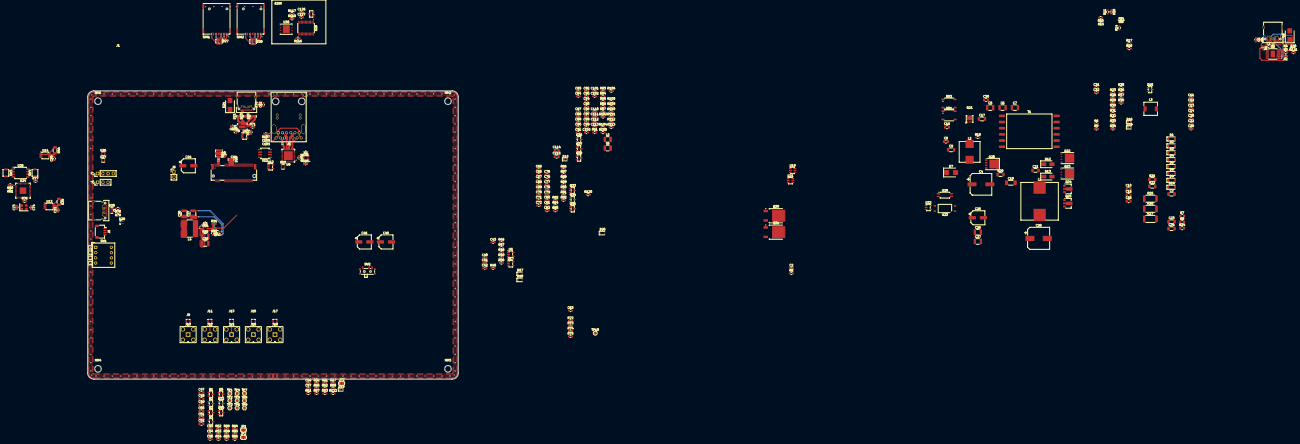
[picture p61: board sierra-to-usb.kicad_pcb from above]

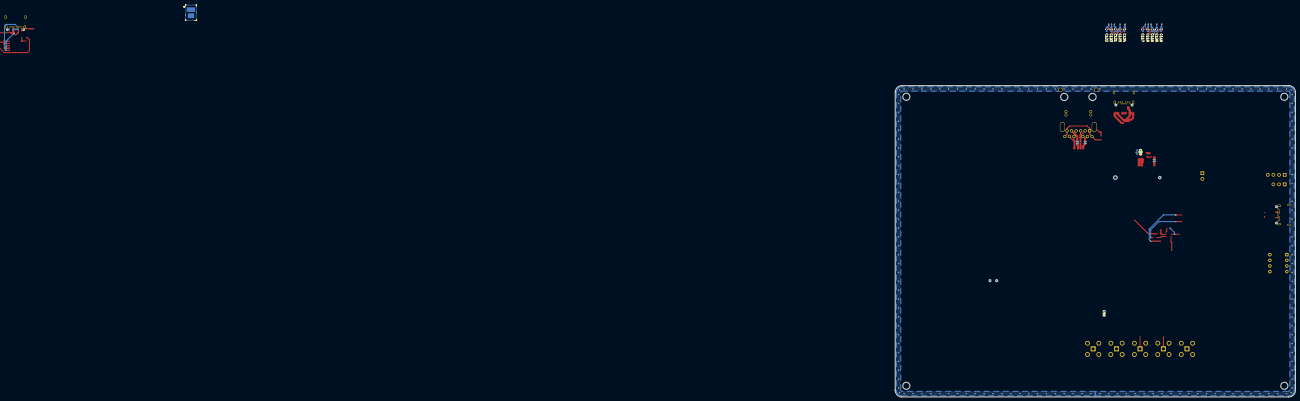
[picture p62: board sierra-to-usb.kicad_pcb from below]

Board: 4 copper layers, 180.0 x 140.0 mm, 369 parts (13 on the bottom side), 239 nets.

Parts:
BR1, BR2: MB10S; TSSOP-4_4.4x5mm_P4mm
C1, C71, C82, C94, C102, C127: 1uF; C_0603_1608Metric
C2, C2#2, C62, C63, C109: 1nF; C_0603_1608Metric
C3, C9: 0.1uF/100V; C_1206_3216Metric
C4: 68uF/100V; CP_Elec_10x12.6
C5, C6, C7: 2.2uF/100V; C_1210_3225Metric
C8: 0.1uF/100V; C_0805_2012Metric
C10: 470pF/100V; C_0805_2012Metric
C11: 2.2nF/50V; C_0603_1608Metric
C12: 47nF/50V; C_0603_1608Metric
C13, C14, C34: 0.1uF/25V; C_0603_1608Metric
C15: 0.1uF/50V; C_0805_2012Metric
C16: 1uF/25V; C_0805_2012Metric
C17: 0.047uF/250V; C_1206_3216Metric
C18: 0.22uF/50V; C_0805_2012Metric
C19: 2200pF/2kV; C_1808_4520Metric
C20: 1nF/100V; C_0603_1608Metric
C21, C23: 0.047uF/100V; C_1206_3216Metric
C22, C31: 100pF/25V; C_0603_1608Metric
C24: 1000pF/100V; C_1206_3216Metric
C25: 39uF/16V; CP_Elec_6.3x5.8
C26, C27: 22uF/35V; C_1210_3225Metric
C28: 560uF/25V; CP_Elec_10x10.5
C29: 68nF/16V; C_0603_1608Metric
C30: 1uF/50V; C_0805_2012Metric
C32: 3.9nF/50V; C_0603_1608Metric
C33, C39: 0.1uF/16V; C_0603_1608Metric
C35, C36: 10uF/25V; C_1210_3225Metric
C37, C38: 22uF/16V; C_1210_3225Metric
C40, C41, C42, C43, C60, C61: 1uF/16V; C_0603_1608Metric
C44, C45, C46: 470uF; CP_Elec_6.3x7.7
C47, C48, C49, C50, C51, C52: 10uF; C_0805_2012Metric
C53, C54, C55, C56, C57: 0.1uF; C_0603_1608Metric
C58, C59, C83, C84: 220nF; C_0603_1608Metric
C64, C65, C66, C67, C68, C69, C70, C72, C75, C76, C77, C78, C79, C80, C81, C89, C92, C93, C111, C113, C120, C125, C126: 100nF; C_0603_1608Metric
C73, C74, C85, C86: 27pF; C_0603_1608Metric
C87, C88, C99, C100, C110: 10uF; C_0603_1608Metric
C90, C91, C95, C96, C97, C98, C101: 2.2uF; C_0603_1608Metric
C103: 390pF; C_0603_1608Metric
C112: 10nF; C_0603_1608Metric
C114, C115: 22uF; C_0805_2012Metric
C116, C117, C118, C119, C121, C122, C123, C124: 22pF; C_0603_1608Metric
CN1: EM92xx / RM520N M.2 Key-B (67-pin); M.2_Key-B-SMD_Socket_LOTES_APCI0105-P001A
D1, D2, D3, D4, D5, D8: MMSD914T1G; D_SOD-123
D6: SMAJ13A; D_SMB
D7: SMAJ58A; D_SMB
D9, D14: MMSZ5242B-7-F 12V; D_SOD-123
D10: GREEN; LED_0603_1608Metric
D12, D13: MURA110T3G; D_SMA
D15: BAT54S-7-F; SOT-23
D16: Yellow 0603; LED_0603_1608Metric
D17, D18: B5819W; D_SOD-323
D19: LED_WWAN_STATUS; LED_0603_1608Metric
D20, D21, D22: TPD4EUSB30DQAR; USON-10_2.5x1.0mm_P0.5mm
D23, D25: TPD4E05U06DQAR; USON-10_2.5x1.0mm_P0.5mm
D24: SMAJ5.0A-TR; D_SMB
D26: 1N4148W; D_SOD-323
D27, D28: TPD4S009DBVR; SOT-23-6
D29: Green 0603; LED_0603_1608Metric
D30: Blue 0603; LED_0603_1608Metric
FB1: 33R@100MHz; L_0603_1608Metric
J1, J2, J3: TYPE-C-31-M-04; USB_C_Receptacle_HRO_TYPE-C-31-M-04
J4: SWD; PinHeader_1x03_P2.54mm_Vertical
J5: Qwiic; JST_SH_SM04B-SRSS-TB_1x04-1MP_P1.00mm_Horizontal
J6: Fan; PinHeader_1x02_P2.54mm_Vertical
J7: Spare; PinHeader_1x04_P2.54mm_Vertical
J8: 2250504-1; Bel_2250504-1
J9, J11, J13, J15, J17: CONMHF4-SMD-G-T; MHF4_TE_CONMHF4-SMD-G-T
J10, J12, J14, J16, J18: BWSMA-KE-Z001; SMA_EdgeMount_BWSMA-KE-Z001
JP1, JP2, JP3: SolderJumper_2_Open; SolderJumper-2_P1.3mm_Open_RoundedPad1.0x1.5mm
L1: 15uH; L_Wurth_WE-HCI_74435571500
L2: 5.5uH; L_Wurth_WE-HCI_744325550
L3: 2.2mH; L_6.3x6.3_H3
L4: 2.2uH; L_Bourns-SRN8040_8x8.15mm
L5, L6: 2.2uH; L_1210_3225Metric
MH1, MH2, MH3, MH4: MountingHole_3.2mm_M3
Q1, Q2, Q3, Q4, Q5, Q34, Q35, Q39: 2N7002; SOT-23
Q20: FDMS86250; PQFN-8-EP_6x5mm_P1.27mm_Generic
Q21: FDMC2523P
Q22, Q23: BSC057N08NS3 G; TDSON-8-1
Q24, Q25: FCX493TA; SOT-89-3
Q30, Q31: IRLR7843TRPBF; TO-252-2
Q32, Q33: DMG3415U-7; SOT-23
Q36, Q37, Q38, Q40: BSS138; SOT-23
R1, R67, R120: 1k; R_0603_1608Metric
R2, R4, R53, R55, R57, R64, R65, R66, R102, R105: 10k; R_0603_1608Metric
R3: 24k; R_0603_1608Metric
R5, R5#2, R70, R75, R107: 1M; R_0603_1608Metric
R6: 25.5k; R_0603_1608Metric
R7, R8: 32; R_0805_2012Metric
R9: 15.0k; R_0603_1608Metric
R10: 110k; R_0603_1608Metric
R11, R18, R33, R37, R38, R43, R46, R77, R84: 10.0k; R_0603_1608Metric
R12: 237k; R_0603_1608Metric
R13: 60.4k; R_0603_1608Metric
R14: 49.9k; R_0603_1608Metric
R15: 42.2k; R_0603_1608Metric
R16: 499k; R_0603_1608Metric
R17: 10.0; R_0603_1608Metric
R19: 3.00k; R_0603_1608Metric
R20: 0.05/1W; R_1206_3216Metric
R21: 4.02k; R_1206_3216Metric
R22: 8.06k; R_1206_3216Metric
R23: 2.0k; R_0603_1608Metric
R24: 5.10; R_0805_2012Metric
R25, R26: 10k/1W; R_2512_6332Metric
R27: 100/1W; R_2512_6332Metric
R28: 49.9; R_0603_1608Metric
R29: 40.2k; R_0603_1608Metric
R30: 10.5k; R_0603_1608Metric
R31, R32, R35: 2.00k; R_0603_1608Metric
R34, R36: 1.00k; R_0603_1608Metric
R39, R44: 0.002/1W; R_1206_3216Metric
R40: 36.5k; R_0603_1608Metric
R41: 9.31k; R_0603_1608Metric
R42: 33.2k; R_0603_1608Metric
R45, R47, R48, R49, R50, R51, R52, R54, R56, R58, R62, R63, R68, R72, R82, R85, R87, R88, R89, R90, R91, R116, R119: 100k; R_0603_1608Metric
R59: 33k 1%; R_0603_1608Metric
R60: 18k 1%; R_0603_1608Metric
R61, R92: 330; R_0603_1608Metric
R69: 900k 1%; R_0603_1608Metric
R71: 200k; R_0603_1608Metric
R73, R74: 5.1k; R_0603_1608Metric
R76: 1.0k; R_0603_1608Metric
R78, R79: 27.4; R_0603_1608Metric
R80, R81, R93, R94, R95, R97, R104, R122: 4.7k; R_0603_1608Metric
R86: 22k; R_0603_1608Metric
R96: 2.49k 1%; R_0603_1608Metric
R103: 0R; R_0603_1608Metric
R106: 510; R_0603_1608Metric
R108: 59k 1%; R_0603_1608Metric
R109, R112: 100k 1%; R_0603_1608Metric
R110: 31.6k 1%; R_0603_1608Metric
R111: 10k 1%; R_0603_1608Metric
R113: 20k 1%; R_0603_1608Metric
R117: 20k; R_0603_1608Metric
R121: 560R; R_0603_1608Metric
SIM1, SIM2: XKNANO-113; NanoSIM_XKB_XKNANO-113
SW1: DIP-4; SW_DIP_SPSTx04_Piano_10.8x11.72mm_W7.62mm_P2.54mm
SW2: LED_KILL; SW_SPDT_PCM12
SW3: BOOTSEL; SW_SPST_B3U-1000P
SW4: RUN; SW_SPST_B3U-1000P
T1: 750313355; Transformer_SMT_WE750313355
TP1: FCPO_N; TestPoint_Pad_D1.5mm
TP2: PCIE_DIS; TestPoint_Pad_D1.5mm
TP3: W_DISABLE1_N; TestPoint_Pad_D1.5mm
TP4: MODEM_RESET_N; TestPoint_Pad_D1.5mm
TP5: VBUS_SENSE; TestPoint_Pad_D1.5mm
TP6: WAKE_N; TestPoint_Pad_D1.5mm
TP7: PERST_N; TestPoint_Pad_D1.5mm
TP8: CLKREQ_N; TestPoint_Pad_D1.5mm
TP9: PEWAKE_N; TestPoint_Pad_D1.5mm
TP10: MUX_USB2_SEL; TestPoint_Pad_D1.5mm
U1: HD3SS3220RNHR; Texas_RNH0030A_WQFN-30-1EP_2.5x4.5mm_P0.4mm_EP1.2x3.2mm
U2: CH224K; SSOP-10-1EP_3.9x4.9mm_P1mm_EP2.1x3.3mm
U3: TPS565201DDCR; SOT-23-6
U4, U17: AP2112K-3.3TRG1; SOT-23-5
U5: AP2112K-1.8TRG1; SOT-23-5
U8: TS3USB221DRCR; Texas_S-PVSON-N10
U9: RTL8125BG-CG; QFN-48-1EP_6x6mm_P0.4mm_EP4.3x4.3mm
U10: TPS23730RMTR; TPS23730_RMTR
U11: 93C46; SOIC-8_3.9x4.9mm_P1.27mm
U12: TLV62569DBVR; SOT-23-5
U13, U14: INA226AIDGSR; MSOP-10_3x3mm_P0.5mm
U15: TPS62933FDRLR; SOT-583-8
U19, U21: LM5050MKX-1/NOPB; SOT-23-6
U20: TCMT1107; SOP-4_4.4x2.6mm_P1.27mm
U22: TL431IDBVR; SOT-23-5
U23: FOD817DS; DIP-4_SMD_GullWing_FOD817
U24: RP2040; QFN-56-1EP_7x7mm_P0.4mm_EP3.2x3.2mm
U25: W25Q128JVS; SOIC-8_5.3x5.3mm_P1.27mm
U26, U27: TMP112AIDRLR; SOT-563
U28: SK6805-EC15; LED_SK6805-EC15_1.5x1.5mm
U29: TS3A27518EPWR; TSSOP-24_4.4x7.8mm_P0.65mm
U30: ST4SIM-200M; VFDFPN8_MFF2
Y1: 12MHz; Crystal_SMD_3225-4Pin_3.2x2.5mm
Y2: 25MHz; Crystal_SMD_3225-4Pin_3.2x2.5mm

Connections:
+0V95: C88.1, C96.1, C97.1, C98.1, C99.1, C100.1, C101.1, C102.1, L5.2, R108.1, U9.8 (DVDD09), U9.11 (AVDD09), U9.16 (AVDD09), U9.22 (AVDD09), U9.28 (DVDD09), U9.37 (EVDD09), U9.47 (DVDD09)
+1V8: C41.1, Q32.2 (S), Q36.1 (G), Q37.1 (G), Q38.1 (G), Q40.1 (G), R49.1, R53.1, R55.1, R57.1, R63.1, R64.1, R65.1, R66.1, R68.2, U5.5 (VOUT)
+3V3: C33.1, C37.1, C38.1, C39.1, C40.1, C64.1, D18.2 (A), L4.2, Q33.2 (S), R4.1, R42.1, R44.1, R47.1, R51.1, R82.2, R122.2, U5.1 (VIN), U5.3 (EN), U8.10 (VCC), U13.6 (VS), U14.2 (A0), U14.6 (VS), U14.10 (IN+), U29.8 (VCC)
+3V3_ETH: C87.1, C90.1, C91.1, C92.1, C93.1, C94.1, C95.1, C114.1, C115.1, FB1.1, L6.2, R93.2, R94.2, R95.2, R97.2, R104.2, R106.1, R110.1, U9.19 (AVDD33), U9.29 (DVDD33), U9.33 (AVDD33), U9.34 (AVDD33_XTAL), U9.43 (EVDD33), U9.46 (DVDD33), U11.6 (ORG), U11.8 (VCC), U12.4 (VIN)
+3V3_MCU: C43.1, C65.1, C66.1, C68.1, C69.1, C70.1, C72.1, C75.1, C76.1, C78.1, C79.1, C80.1, C81.1, C82.1, J5.2, J7.3, R77.2, R80.2, R81.2, R84.2, R88.2, R89.2, R90.1, R91.2, U17.5 (VOUT), U24.1 (IOVDD), U24.10 (IOVDD), U24.22 (IOVDD), U24.33 (IOVDD), U24.42 (IOVDD), U24.43 (ADC_AVDD), U24.44 (VREG_VIN), U24.48 (USB_VDD), U24.49 (IOVDD), U25.8 (VCC), U26.5 (V+), U27.4 (ADD0), U27.5 (V+)
+3V3_MOD: C44.1, C45.1, C46.1, C47.1, C48.1, C49.1, C50.1, C51.1, C52.1, C53.1, C54.1, C55.1, C56.1, C57.1, CN1.2 (3.3V), CN1.4 (3.3V), CN1.70 (3.3V), CN1.72 (3.3V), CN1.74 (3.3V), JP1.2 (B), JP2.2 (B), JP3.2 (B), R44.2, U14.8 (VBUS), U14.9 (IN-)
+12V: C110.1, C111.1, D26.1 (K), J6.1, Q30.2 (D), Q31.2 (D), R39.1, R40.1, R45.1, R112.1, U13.10 (IN+), U15.3 (VIN), U19.1 (VS), U19.6 (OUT), U21.1 (VS), U21.6 (OUT)
+12V_BUCK: C35.1, C36.1, R39.2, U3.3 (VIN), U13.8 (VBUS), U13.9 (IN-)
/Ethernet/N_AVDD33_PLL: C89.1, FB1.2, U9.15 (AVDD33_PLL)
/Ethernet/N_BST_ETH: C113.1, U15.6 (BST)
/Ethernet/N_CKXTAL2: R103.1, U9.9 (CKXTAL2)
/Ethernet/N_ETH_EN: R112.2, R113.1, U15.2 (EN)
/Ethernet/N_ETH_SS: C112.1, U15.7 (SS)
/Ethernet/N_EXT095_EN: U9.6 (POW_EXT_SWR), U12.1 (EN)
/Ethernet/N_FB095: R108.2, R109.1, U12.5 (FB)
/Ethernet/N_FB_ETH: R110.2, R111.1, U15.8 (FB)
/Ethernet/N_GPI: R104.1, U9.3 (GPI)
/Ethernet/N_J8_SHIELD: C109.1, J8.SH, R107.1
/Ethernet/N_LED3_A: D10.2 (A), R106.2
/Ethernet/N_PEWAKE_3V3: Q38.3 (D), R95.1, U9.2 (LANWAKEB)
/Ethernet/N_RSET: R96.1, U9.12 (RSET)
/Ethernet/N_SW095: L5.1, U12.3 (SW)
/Ethernet/N_SW_ETH: C113.2, L6.1, U15.5 (SW)
/Ethernet/N_TRCT_COMMON: C103.1, J8.1 (TRCT3), J8.6 (TRCT2), J8.7 (TRCT4), J8.12 (TRCT1)
/Ethernet/N_XTAL1: C86.1, U9.10 (CKXTAL1), Y2.3
/Ethernet/N_XTAL2: C85.1, R103.2, Y2.1
/Ethernet/PCIE_MRX_C_N: C84.1, U9.39 (HSON)
/Ethernet/PCIE_MRX_C_P: C83.1, U9.38 (HSOP)
/Ethernet/RTL_EE_CS: U9.31 (EECS), U11.1 (CS)
/Ethernet/RTL_EE_DO: U9.25 (LED2/EEDO), U11.4 (DO)
/M.2/FCPO_N: CN1.6 (~FULL_CARD_POWER_OFF), Q1.3 (D), R51.2, TP1.1 (1_1)
/M.2/M2_VCC_JP1: CN1.24 (GPIO_7), JP1.1 (A)
/M.2/M2_VCC_JP2: CN1.38 (DEVSLP), JP2.1 (A)
/M.2/M2_VCC_JP3: CN1.68 (SUSCLK), JP3.1 (A)
/M.2/MODEM_RESET_N: CN1.67 (~RESET), Q4.3 (D), R57.2, TP4.1 (1_1)
/M.2/N_LED_A: D19.2 (A), R67.2
/M.2/N_Q6_D: Q32.3 (D), R61.1
/M.2/N_Q6_G: Q5.3 (D), Q32.1 (G), R68.1
/M.2/PCIE_DIS: CN1.20 (GPIO_5), Q2.3 (D), R53.2, TP2.1 (1_1)
/M.2/VBUS_SENSE: CN1.22 (GPIO_6), R59.2, R60.1, R61.2, TP5.1 (1_1)
/M.2/W_DISABLE1_N: CN1.8 (~W_DISABLE1), Q3.3 (D), R55.2, TP3.1 (1_1)
/MCU/DVDD_1V1: C67.1, C71.1, U24.23 (DVDD), U24.45 (VREG_VOUT), U24.50 (DVDD)
/MCU/MCU_GPIO24: J7.1, U24.36 (GPIO24)
/MCU/MCU_GPIO25: J7.2, U24.37 (GPIO25)
/MCU/MCU_SWCLK: J4.1, U24.24 (SWCLK)
/MCU/MCU_SWDIO: J4.2, U24.25 (SWDIO)
/MCU/MCU_USB_DP: R78.1, U24.47 (USB_DP)
/MCU/N_FAN_RTN: D26.2 (A), J6.2, Q34.3 (D)
/MCU/N_LEDKILL_GATE: Q33.1 (G), R82.1, SW2.2 (B)
/MCU/N_SW2_KILL: Q35.3 (D), SW2.1 (A)
/MCU/N_XOUT_R: C74.1, R76.2, Y1.3
/MCU/POE_STATUS: R85.2, R86.1, U24.41 (GPIO29/ADC3)
/MCU/QSPI_SCLK: U24.52 (QSPI_SCLK), U25.6 (CLK)
/MCU/QSPI_SD0: U24.53 (QSPI_SD0), U25.5 (DI/IO_{0})
/MCU/QSPI_SD1: U24.55 (QSPI_SD1), U25.2 (DO/IO_{1})
/MCU/QSPI_SD2: U24.54 (QSPI_SD2), U25.3 (~WP/IO_{2})
/MCU/QSPI_SD3: U24.51 (QSPI_SD3), U25.7 (~HOLD/~RESET/IO_{3})
/MCU/QSPI_SS: SW3.1, U24.56 (~QSPI_SS), U25.1 (~CS)
/MCU/RP2040_RUN: R77.1, SW4.1, U24.26 (RUN)
/MCU/XTAL_XIN: C73.1, U24.20 (XIN), Y1.1
/MCU/XTAL_XOUT: R76.1, U24.21 (XOUT)
/Power Input/+12V_POE: C25.1, C26.1, C27.1, C28.1, D16.2 (A), L1.2, Q31.3 (S), R28.1, U21.4 (IN)
/Power Input/CH224K_CFG1: R3.1, U2.9 (CFG1)
/Power Input/CH224K_PG: D30.1 (K), R4.2, U2.10 (PG)
/Power Input/CH224K_VBUSSENSE: R2.2, U2.8 (VBUS)
/Power Input/CH224K_VDD: C1.1, R1.2, U2.1 (VDD)
/Power Input/J2_SHIELD: C2.1, J2.SH (SHIELD), R5#2.1
/Power Input/N_AUX: D1.2 (A), T1.5 (N3.1)
/Power Input/N_AUX_R: D1.1 (K), D2.1 (K), L3.1
/Power Input/N_BT: U10.12 (BT), U23.2
/Power Input/N_BTLED: R37.2, U23.1
/Power Input/N_BTLED2: D16.1 (K), R38.1
/Power Input/N_C32Z: C32.1, R34.2
/Power Input/N_CLAMP_D: C17.2, Q21.D
/Power Input/N_CLAMP_G: C18.2, D3.2 (A), Q21.G, R18.1
/Power Input/N_CLSA: R7.1, U10.21 (CLSA)
/Power Input/N_CLSB: R8.1, U10.20 (CLSB)
/Power Input/N_COMP: C29.2, R35.2, U10.35 (COMP), U20.4
/Power Input/N_CS: R19.1, U10.1 (CS)
/Power Input/N_CS_SNS: Q20.1 (S), Q20.2 (S), Q20.3 (S), R19.2, R20.1
/Power Input/N_D15COM: C30.1, D15.3 (COM), R33.2
/Power Input/N_D29_A: D29.2 (A), R120.2
/Power Input/N_D30_A: D30.2 (A), R121.1
/Power Input/N_DEN: R6.1, U10.24 (DEN)
/Power Input/N_DT: R15.1, U10.31 (DT)
/Power Input/N_DTHR: C11.1, R12.1, U10.3 (DTHR)
/Power Input/N_FBREF: C31.2, C32.2, R29.2, R30.1, U22.4 (REF)
/Power Input/N_FBTOP: D15.2 (K), R28.2, R29.1, R31.1, R32.1, R33.1
/Power Input/N_FRS: R12.2, R13.1, U10.4 (FRS)
/Power Input/N_GAT2: C18.1, U10.41 (GAT2)
/Power Input/N_GATE: D4.1 (K), R17.1, U10.43 (GATE)
/Power Input/N_GATE_Q: D4.2 (A), Q20.4 (G), R17.2
/Power Input/N_ISTP: R16.1, U10.32 (I_STP)
/Power Input/N_J2_SHIELD: C2#2.1, R5.1
/Power Input/N_LEDA: R31.2, U20.1
/Power Input/N_LINEUV: R10.2, R11.1, U10.38 (LINEUV)
/Power Input/N_PPD: C10.1, R9.1, U10.19 (PPD)
/Power Input/N_Q22_G: D5.2 (A), Q22.4 (G), Q24.3 (E)
/Power Input/N_Q22_RC: C20.1, R24.2
/Power Input/N_Q22_RCD: C21.1, D13.1 (K), R25.1
/Power Input/N_Q23_G: D8.2 (A), Q23.4 (G), Q25.3 (E)
/Power Input/N_Q24_B: D9.1 (K), Q24.1 (B), R21.2, R22.1
/Power Input/N_Q25_B: C22.2, D14.1 (K), Q25.1 (B), R23.2
/Power Input/N_R43C44: C29.1, R36.2
/Power Input/N_REF: R14.1, U10.17 (REF)
/Power Input/N_SEC_CLP: C23.1, D12.1 (K), R26.1
/Power Input/N_SEC_RC: C24.2, R27.1
/Power Input/N_SEC_RTN: C22.1, D8.1 (K), D13.2 (A), Q22.5 (D), Q25.2 (C), R23.1, R24.1, T1.10 (N2.2), T1.11 (N2.2), T1.12 (N2.2)
/Power Input/N_SEC_SW: C24.1, D5.1 (K), D12.2 (A), L1.1, Q23.5 (D), Q24.2 (C), R21.1, T1.7 (N2.1), T1.8 (N2.1), T1.9 (N2.1)
/Power Input/N_SST: C12.1, U10.33 (SST)
/Power Input/N_SW: C17.1, Q20.5 (D), T1.3 (N1.2), T1.4 (N1.2)
/Power Input/N_TLK: C31.1, D15.1 (A), R32.2, R34.1, U20.2, U22.3 (K)
/Power Input/N_U19_GATE: Q30.1 (G), U19.5 (GATE)
/Power Input/N_U21_GATE: Q31.1 (G), U21.5 (GATE)
/Power Input/N_VB: C13.1, R35.1, R36.1, R37.1, U10.34 (FB), U10.37 (VB)
/Power Input/N_VBG: C14.1, U10.40 (VBG)
/Power Input/N_VCC: C15.1, C16.1, L3.2, U10.42 (VCC)
/Power Input/PD_CC1: J2.A5 (CC1), U2.7 (CC1)
/Power Input/PD_CC2: J2.B5 (CC2), U2.6 (CC2)
/Power Input/PD_DM-: J2.A7 (D-), J2.B7 (D-)
/Power Input/PD_DP+: J2.A6 (D+), J2.B6 (D+)
/Power Input/POE_RTN: C3.2, C4.2, C5.2, C6.2, C7.2, C8.2, C11.2, C12.2, C13.2, C14.2, C15.2, C16.2, C19.1, D2.2 (A), D3.1 (K), Q21.S, R11.2, R13.2, R15.2, R16.2, R18.2, R20.2, T1.6 (N3.2), U10.2 (AGND), U10.5 (APD), U10.7 (RTN), U10.8 (RTN), U10.9 (RTN), U10.39 (PSRS), U10.45 (GND), U10.46 (PAD_G), U20.3
/Power Input/POE_VDD54: BR1.3, BR2.3, C3.1, C4.1, D7.1 (K), L2.1, R6.2, R10.1
/Power Input/POE_VDD54_F: C5.1, C6.1, C7.1, C8.1, C9.1, L2.2, T1.1 (N1.1), T1.2 (N1.1), U10.23 (VDD)
/Power Input/POE_VSS: BR1.4, BR2.4, C9.2, C10.2, D7.2 (A), R7.2, R8.2, R9.2, R14.2, U10.27 (VSS), U10.28 (VSS), U10.47 (PAD_S)
/Power Rails/N_OR17: C42.1, D17.1 (K), D18.1 (K), U17.1 (VIN), U17.3 (EN)
/Power Rails/N_U3_FB: R42.2, R43.1, U3.4 (VFB)
/Power Rails/N_U3_SW: C34.2, L4.1, U3.2 (SW)
/Power Rails/N_U3_VBST: C34.1, U3.6 (VBST)
/RF/ANT0: J9.1 (In), J10.1 (In)
/RF/ANT1: J11.1 (In), J12.1 (In)
/RF/ANT2: J13.1 (In), J14.1 (In)
/RF/ANT3: J15.1 (In), J16.1 (In)
/RF/GNSS: J17.1 (In), J18.1 (In)
/SIM/UIM2E_CLK: U29.15 (NO3), U30.6 (CLK)
/SIM/UIM2E_IO: R117.1, U29.17 (NO4), U30.3 (I/O)
/SIM/UIM2E_RST: U29.13 (NO2), U30.7 (RESET)
/SIM/UIM2E_VDD: C126.1, C127.1, R117.2, U29.11 (NO1), U30.8 (VCC)
/SIM/UIM2S_CLK: C122.1, D28.6 (D1-), SIM2.3 (CLK), U29.23 (NC3)
/SIM/UIM2S_DET: C124.1, D28.4 (D2-), SIM2.4 (CD), U29.19 (NC5)
/SIM/UIM2S_IO: C123.1, D28.3 (D2+), SIM2.7 (IO), U29.21 (NC4)
/SIM/UIM2S_RST: C121.1, D28.1 (D1+), SIM2.2 (RST), U29.1 (NC2)
/SIM/UIM2S_VDD: C125.1, D28.5 (VCC), SIM2.1 (VCC), U29.2 (NC1)
/USB2 Debug/USB_DBG_SHIELD: C63.1, R75.1
/USB3 Data/+3V3_MUX: C61.1, R71.2, U1.8 (VCC33), U4.5 (VOUT)
/USB3 Data/CC1_RAW: D23.4 (D2+), U1.2 (CC1)
/USB3 Data/CC2_RAW: C58.1, D23.5 (D2-), U1.1 (CC2), U1.9 (RXP)
/USB3 Data/HD_VBUSDET: R69.2, U1.5 (VBUS_DET)
/USB3 Data/N_J1_SHIELD: C62.1, R70.1
/USB3 Data/N_TXN_PRECAP: C59.1, D21.1 (D1+), D21.10 (NC), U1.10 (RXN), U1.21 (TX2P)
/USB3 Data/N_U1_DIR: R71.1, U1.11 (DIR)
/USB3 Data/SS_CON1_RXN: D20.5 (D2-), U1.14 (RX1N)
/USB3 Data/SS_CON1_RXP: D20.4 (D2+), U1.15 (RX1P)
/USB3 Data/SS_CON1_TXN: D20.2 (D1-), U1.16 (TX1N)
/USB3 Data/SS_CON1_TXP: D20.1 (D1+), U1.17 (TX1P)
/USB3 Data/SS_CON2_RXN: D21.5 (D2-), D21.6 (NC), U1.18 (RX2N)
/USB3 Data/SS_CON2_TXN: D21.2 (D1-), D21.9 (NC), U1.20 (TX2N)
BUCK_EN: R40.2, R41.1, U3.5 (EN)
CLKREQ_N: CN1.52 (~CLKREQ), Q37.2 (S), R65.2, TP8.1 (1_1)
DIP0: R88.1, SW1.1, U24.31 (GPIO20)
DIP1: R89.1, SW1.2, U24.32 (GPIO21)
DIP2: R91.1, SW1.3, U24.34 (GPIO22)
DIP3: R90.2, SW1.4, U24.35 (GPIO23)
FAN_PWM: Q34.1 (G), R87.1, U24.18 (GPIO15)
FCPO_CTL: Q1.1 (G), R52.1, U24.6 (GPIO4)
GND: C1.2, C2.2, C2#2.2, C19.2, C20.2, C21.2, C23.2, C25.2, C26.2, C27.2, C28.2, C30.2, C33.2, C35.2, C36.2, C37.2, C38.2, C39.2, C40.2, C41.2, C42.2, C43.2, C44.2, C45.2, C46.2, C47.2, C48.2, C49.2, C50.2, C51.2, C52.2, C53.2, C54.2, C55.2, C56.2, C57.2, C60.2, C61.2, C62.2, C63.2, C64.2, C65.2, C66.2, C67.2, C68.2, C69.2, C70.2, C71.2, C72.2, C73.2, C74.2, C75.2, C76.2, C77.2, C78.2, C79.2, C80.2, C81.2, C82.2, C85.2, C86.2, C87.2, C88.2, C89.2, C90.2, C91.2, C92.2, C93.2, C94.2, C95.2, C96.2, C97.2, C98.2, C99.2, C100.2, C101.2, C102.2, C103.2, C109.2, C110.2, C111.2, C112.2, C114.2, C115.2, C116.2, C117.2, C118.2, C119.2, C120.2, C121.2, C122.2, C123.2, C124.2, C125.2, C126.2, C127.2, CN1.3 (GND), CN1.5 (GND), CN1.11 (GND), CN1.27 (GND), CN1.33 (GND), CN1.39 (GND), CN1.45 (GND), CN1.51 (GND), CN1.57 (GND), CN1.71 (GND), CN1.73 (GND), D6.2 (A), D9.2 (A), D14.2 (A), D20.3 (GND), D20.8 (GND), D21.3 (GND), D21.8 (GND), D22.3 (GND), D22.8 (GND), D23.3 (GND), D23.8 (GND), D24.2 (A), D25.3 (GND), D25.8 (GND), D27.2 (GND), D28.2 (GND), D29.1 (K), J2.A1 (GND), J2.A12 (GND), J2.B1 (GND), J2.B12 (GND), J4.3, J5.1, J7.4, J9.2 (Ext), J10.2 (Ext), J11.2 (Ext), J12.2 (Ext), J13.2 (Ext), J14.2 (Ext), J15.2 (Ext), J16.2 (Ext), J17.2 (Ext), J18.2 (Ext), Q1.2 (S), Q2.2 (S), Q3.2 (S), Q4.2 (S), Q5.2 (S), Q22.1 (S), Q22.2 (S), Q22.3 (S), Q23.1 (S), Q23.2 (S), Q23.3 (S), Q34.2 (S), Q35.2 (S), Q39.2 (S), R3.2, R5.2, R5#2.2, R22.2, R25.2, R26.2, R27.2, R30.2, R41.2, R43.2, R46.2, R48.2, R50.2, R52.2, R54.2, R56.2, R58.2, R60.2, R62.2, R70.2, R72.2, R73.2, R74.2, R75.2, R86.2, R87.2, R96.2, R102.2, R105.2, R107.2, R109.2, R111.2, R113.2, R116.2, R119.2, SIM1.5 (GND), SIM1.8 (SHELL), SIM2.5 (GND), SIM2.8 (SHELL), SW1.5, SW1.6, SW1.7, SW1.8, SW3.2, SW4.2, U1.3 (CURRENT_MODE), U1.4 (PORT), U1.12 (EN_MUX_N), U1.13 (GND), U1.28 (GND), U1.29 (EN_CC_N), U1.31 (PAD), U2.11 (GND), U3.1 (GND), U4.2 (GND), U5.2 (GND), U8.5 (GND), U8.6 (OE), U8.11 (PAD), U9.32 (EEPROM_SEL), U9.40 (GND), U9.49 (GND), U11.5 (GND), U12.2 (GND), U13.1 (A1), U13.2 (A0), U13.7 (GND), U14.1 (A1), U14.7 (GND), U15.1 (RT), U15.4 (GND), U17.2 (GND), U19.2 (GND), U19.3 (OFF), U21.2 (GND), U21.3 (OFF), U22.5 (A), U23.3, U24.19 (TESTEN), U24.57 (GND), U25.4 (GND), U26.2 (GND), U26.4 (ADD0), U27.2 (GND), U28.4 (GND), U29.5 (GND), U29.16 (NO6), U29.20 (EN), U29.22 (NC6), U30.1 (GND), Y1.2 (G), Y1.4 (G), Y2.2 (G), Y2.4 (G)
I2C_SCL: J5.4, R81.1, U13.5 (SCL), U14.5 (SCL), U24.3 (GPIO1), U26.1 (SCL), U27.1 (SCL)
I2C_SDA: J5.3, R80.1, U13.4 (SDA), U14.4 (SDA), U24.2 (GPIO0), U26.6 (SDA), U27.6 (SDA)
LED0: R105.1, U9.30 (LED0/EEDI), U11.3 (DI)
LED1: R97.1, U9.27 (LED1/EESK), U11.2 (CLK)
LED3: D10.1 (K), U9.35 (LED3)
LED_EN_CTL: Q35.1 (G), R84.1, U24.12 (GPIO9)
LED_PWR: C77.1, Q33.3 (D), R67.1, R120.1, R121.2, U28.2 (VDD)
MDI0_N: J8.10 (TRD1-), U9.14 (MDIN0)
MDI0_P: J8.11 (TRD1+), U9.13 (MDIP0)
MDI1_N: J8.5 (TRD2-), U9.18 (MDIN1)
MDI1_P: J8.4 (TRD2+), U9.17 (MDIP1)
MDI2_N: J8.2 (TRD3-), U9.21 (MDIN2)
MDI2_P: J8.3 (TRD3+), U9.20 (MDIP2)
MDI3_N: J8.9 (TRD4-), U9.24 (MDIN3)
MDI3_P: J8.8 (TRD4+), U9.23 (MDIP3)
MRST_CTL: Q4.1 (G), R58.1, U24.9 (GPIO7)
MUX_USB2_SEL: R72.1, TP10.1 (1_1), U8.9 (S), U24.13 (GPIO10)
N_CLKREQ_3V3: Q37.3 (D), R94.1, U9.48 (CLKREQB), U24.30 (GPIO19)
N_PERST_3V3: Q36.3 (D), R93.1, U9.36 (PERSTB), U24.29 (GPIO18)
unnamed: J1.A1 (GND), J1.A12 (GND), J1.B1 (GND), J1.B12 (GND)
unnamed: J1.A4 (VBUS), J1.A9 (VBUS), J1.B4 (VBUS), J1.B9 (VBUS)
unnamed: J3.A1 (GND), J3.A12 (GND), J3.B1 (GND), J3.B12 (GND)
PCIE_DIS_CTL: Q2.1 (G), R54.1, U24.7 (GPIO5)
PCIE_MRX_N: C84.2, CN1.47 (PETn0/SATA-A-)
PCIE_MRX_P: C83.2, CN1.49 (PETp0/SATA-A+)
PCIE_MTX_N: CN1.41 (PERn0/SATA-B+), U9.42 (HSIN)
PCIE_MTX_P: CN1.43 (PERp0/SATA-B-), U9.41 (HSIP)
PCIE_REFCLK_N: CN1.53 (REFCLKn), U9.45 (REFCLK_N)
PCIE_REFCLK_P: CN1.55 (REFCLKp), U9.44 (REFCLK_P)
PERST_N: CN1.50 (~PERST), Q36.2 (S), R64.2, TP7.1 (1_1)
PEWAKE_N: CN1.54 (~PEWAKE), Q38.2 (S), R66.2, TP9.1 (1_1)
POE_STS_RAW: R38.2, R85.1, U23.4
POE_VA+: BR1.1 (+), J8.13 (VC12)
POE_VA-: BR1.2 (-), J8.14 (VC36)
POE_VB+: BR2.1 (+), J8.15 (VC45)
POE_VB-: BR2.2 (-), J8.16 (VC78)
RGB_DI: R92.1, U24.17 (GPIO14)
RGB_DIN: R92.2, U28.1 (DIN)
RTL_RST_N: R102.1, U9.1 (ISOLATEB), U24.15 (GPIO12)
SIM_SEL: R116.1, U24.14 (GPIO11), U29.14 (IN2), U29.24 (IN1)
SS_MOD_RX_N: CN1.29 (PERn1/USB3.0-Rx-/SSIC-RxN), D22.5 (D2-), U1.7 (TXN)
SS_MOD_RX_P: CN1.31 (PERp1/USB3.0-Rx+/SSIC-RxP), D22.4 (D2+), U1.6 (TXP)
SS_MOD_TX_C_N: C59.2, CN1.35 (PETn1/USB3.0-Tx-/SSIC-TxN), D21.4 (D2+), D21.7 (NC), D22.2 (D1-), U1.19 (RX2P)
SS_MOD_TX_C_P: C58.2, CN1.37 (PETp1/USB3.0-Tx+/SSIC-TxP), D22.1 (D1+)
UIM1_CLK: C117.1, CN1.32 (UIM-CLK), D27.6 (D1-), SIM1.3 (CLK)
UIM1_DET: C119.1, CN1.66 (SIM_DETECT), D27.4 (D2-), SIM1.4 (CD)
UIM1_IO: C118.1, CN1.34 (UIM-DATA), D27.3 (D2+), SIM1.7 (IO)
UIM1_RST: C116.1, CN1.30 (UIM-RESET), D27.1 (D1+), SIM1.2 (RST)
UIM1_VDD: C120.1, CN1.36 (UIM-PWR), D27.5 (VCC), SIM1.1 (VCC)
UIM2_CLK: CN1.44 (GPIO_2), U29.7 (COM3)
UIM2_DET: CN1.40 (GPIO_0), Q39.3 (D), U29.10 (COM5)
UIM2_DET_CTL: Q39.1 (G), R119.1, U24.16 (GPIO13)
UIM2_IO: CN1.42 (GPIO_1), U29.9 (COM4)
UIM2_RST: CN1.46 (GPIO_3), U29.6 (COM2)
UIM2_VDD: CN1.48 (GPIO_4), U29.4 (COM1)
USB2_CON_DM: D23.2 (D1-), U8.2 (1D-)
USB2_CON_DP: D23.1 (D1+), U8.1 (1D+)
USB2_MCU_DM: U8.4 (2D-), U24.5 (GPIO3)
USB2_MCU_DP: U8.3 (2D+), U24.4 (GPIO2)
USB2_MOD_D+: CN1.7 (USB_D+), U8.8 (D+)
USB2_MOD_D-: CN1.9 (USB_D-), U8.7 (D-)
USB_DBG_DM: D25.2 (D1-), R79.2
USB_DBG_DP: D25.1 (D1+), R78.2, R79.1, U24.46 (USB_DM)
VBUSSNS_CTL: Q5.1 (G), R62.1, U24.11 (GPIO8)
VBUS_DATA: C60.1, D24.1 (K), R59.1, R69.1, U1.30 (VDD5), U4.1 (VIN), U4.3 (EN)
VBUS_PD: D6.1 (K), J2.A4 (VBUS), J2.A9 (VBUS), J2.B4 (VBUS), J2.B9 (VBUS), Q30.3 (S), R1.1, R2.1, U19.4 (IN)
VMON_1V8: R49.2, R50.1, U24.40 (GPIO28/ADC2)
VMON_3V3: R47.2, R48.1, U24.39 (GPIO27/ADC1)
VMON_12V: R45.2, R46.1, U24.38 (GPIO26/ADC0)
WAKE_3V3: Q40.3 (D), R122.1, U24.28 (GPIO17)
WAKE_N: CN1.23 (GPIO_11), Q40.2 (S), R63.2, TP6.1 (1_1)
WDIS_CTL: Q3.1 (G), R56.1, U24.8 (GPIO6)
WWAN_LED_N: CN1.10 (GPIO_9/DAS/~DSS/~LED1), D19.1 (K), U24.27 (GPIO16)
