alxgmpr/sierra-to-usb/full-adapter/cm4/cad/aux-pd.kicad_sch

## KiCad design full-adapter/cm4/cad/aux-pd.kicad_sch (2026-09-10)

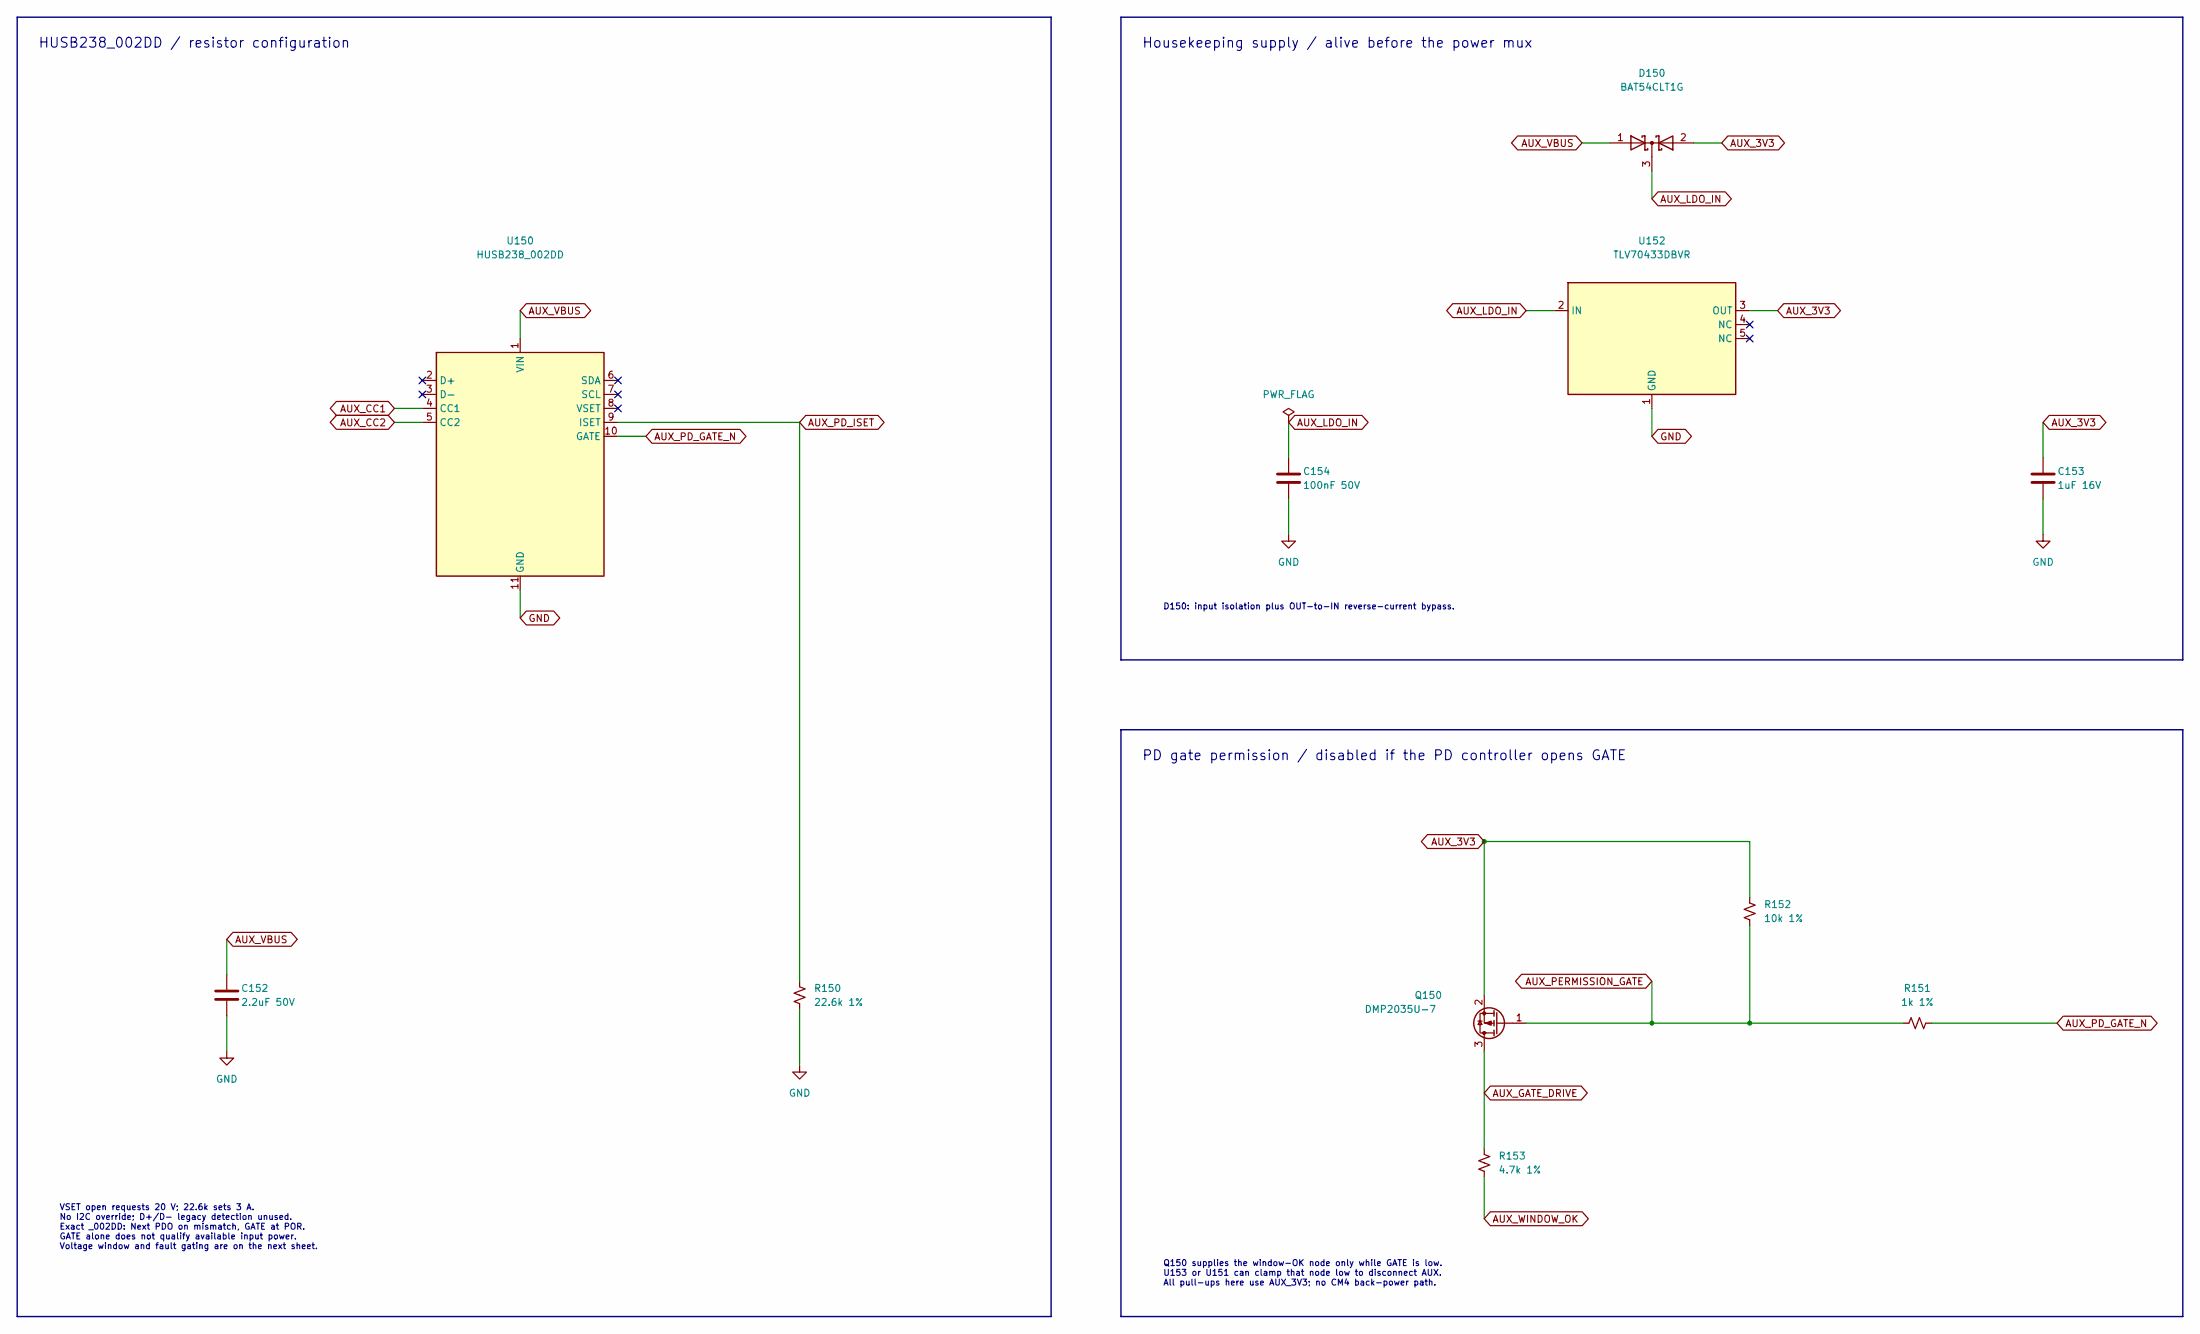
[picture p63: schematic aux-pd.kicad_sch]

Parts:
C152: 2.2uF 50V; C_0805_2012Metric; MPN CL21A225KBQNNNE; LCSC C377773
C153: 1uF 16V; C_0603_1608Metric; MPN CL10A105KO8NNNC; LCSC C1592
C154: 100nF 50V; C_0402_1005Metric; MPN CC0402KRX7R9BB104; LCSC C131394
D150: BAT54CLT1G; SOT-23; MPN BAT54CLT1G; LCSC C14308
Q150: DMP2035U-7; SOT-23; MPN DMP2035U-7; LCSC C110499
R150: 22.6k 1%; R_0402_1005Metric; MPN 0402WGF2262TCE; LCSC C26960
R151: 1k 1%; R_0402_1005Metric; MPN 0402WGF1001TCE; LCSC C11702
R152: 10k 1%; R_0402_1005Metric; MPN 0402WGF1002TCE; LCSC C25744
R153: 4.7k 1%; R_0402_1005Metric; MPN 0402WGF4701TCE; LCSC C25900
U150: HUSB238_002DD; Hynetek_DFN10_3x3_P0.5_EP1.8x2.5; MPN HUSB238_002DD; LCSC C7471904
U152: TLV70433DBVR; SOT-23-5; MPN TLV70433DBVR; LCSC C94917

Connections:
AUX_3V3: C153.1, D150.2 (A), Q150.2 (S), R152.1, U152.3 (OUT)
AUX_CC1: U150.4 (CC1)
AUX_CC2: U150.5 (CC2)
AUX_GATE_DRIVE: Q150.3 (D), R153.1
AUX_LDO_IN: C154.1, D150.3 (K), U152.2 (IN)
AUX_PD_GATE_N: R151.2, U150.10 (GATE)
AUX_PD_ISET: R150.1, U150.9 (ISET)
AUX_PERMISSION_GATE: Q150.1 (G), R151.1, R152.2
AUX_VBUS: C152.1, D150.1 (A), U150.1 (VIN)
AUX_WINDOW_OK: R153.2
GND: C152.2, C153.2, C154.2, R150.2, U150.11 (GND), U152.1 (GND)

Notes on the sheet:
HUSB238_002DD / resistor configuration
VSET open requests 20 V; 22.6k sets 3 A. No I2C override; D+/D- legacy detection unused. Exact _002DD: Next PDO on mismatch, GATE at POR. GATE alone does not qualify available input power. Voltage window and fault gating are on the next sheet.
Housekeeping supply / alive before the power mux
D150: input isolation plus OUT-to-IN reverse-current bypass.
PD gate permission / disabled if the PD controller opens GATE
Q150 supplies the window-OK node only while GATE is low. U153 or U151 can clamp that node low to disconnect AUX. All pull-ups here use AUX_3V3; no CM4 back-power path.
