alxgmpr/sierra-to-usb/full-adapter/cm4/cad/aux-usbc.kicad_sch

## KiCad design full-adapter/cm4/cad/aux-usbc.kicad_sch (2026-09-10)

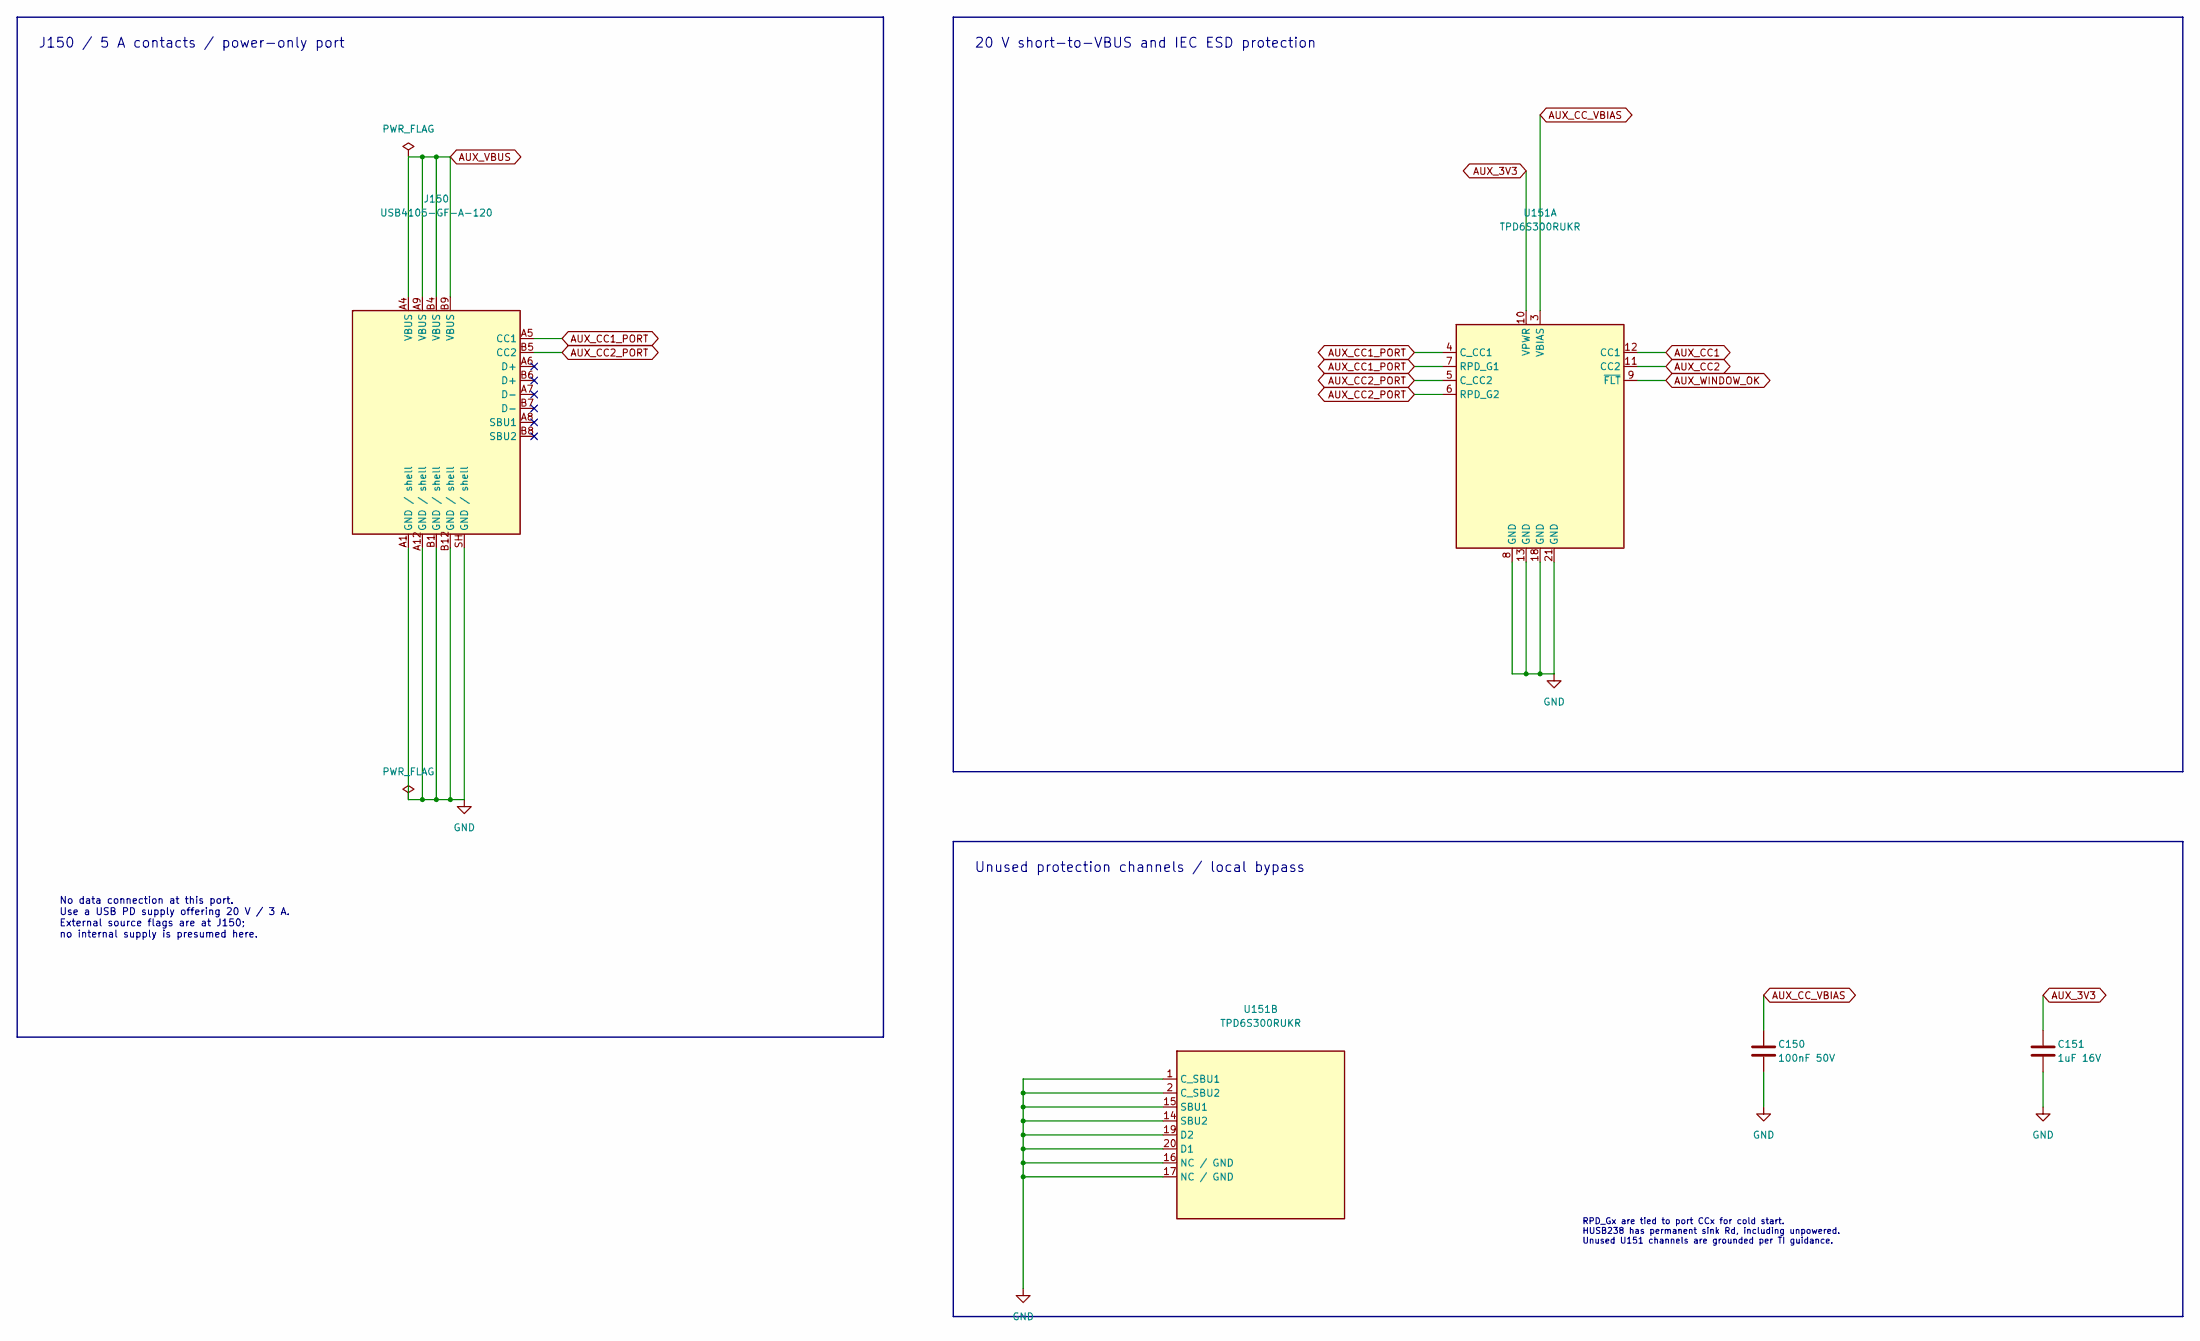
[picture p64: schematic aux-usbc.kicad_sch]

Parts:
C150: 100nF 50V; C_0402_1005Metric; MPN CC0402KRX7R9BB104; LCSC C131394
C151: 1uF 16V; C_0603_1608Metric; MPN CL10A105KO8NNNC; LCSC C1592
J150: USB4105-GF-A-120; GCT_USB4105_GF_A_120; MPN USB4105-GF-A-120; LCSC C5184243
U151: TPD6S300RUKR; TI_RUK0020_TPD6S300; MPN TPD6S300RUKR; LCSC C2649810

Connections:
AUX_3V3: C151.1, U151.10 (VPWR)
AUX_CC1: U151.12 (CC1)
AUX_CC1_PORT: J150.A5 (CC1), U151.4 (C_CC1), U151.7 (RPD_G1)
AUX_CC2: U151.11 (CC2)
AUX_CC2_PORT: J150.B5 (CC2), U151.5 (C_CC2), U151.6 (RPD_G2)
AUX_CC_VBIAS: C150.1, U151.3 (VBIAS)
AUX_VBUS: J150.A4 (VBUS), J150.A9 (VBUS), J150.B4 (VBUS), J150.B9 (VBUS)
AUX_WINDOW_OK: U151.9 (~FLT)
GND: C150.2, C151.2, J150.A1 (GND / shell), J150.A12 (GND / shell), J150.B1 (GND / shell), J150.B12 (GND / shell), J150.SH (GND / shell), U151.1 (C_SBU1), U151.2 (C_SBU2), U151.8 (GND), U151.13 (GND), U151.14 (SBU2), U151.15 (SBU1), U151.16 (NC / GND), U151.17 (NC / GND), U151.18 (GND), U151.19 (D2), U151.20 (D1), U151.21 (GND)

Notes on the sheet:
J150 / 5 A contacts / power-only port
No data connection at this port. Use a USB PD supply offering 20 V / 3 A. External source flags are at J150; no internal supply is presumed here.
20 V short-to-VBUS and IEC ESD protection
Unused protection channels / local bypass
RPD_Gx are tied to port CCx for cold start. HUSB238 has permanent sink Rd, including unpowered. Unused U151 channels are grounded per TI guidance.
