alxgmpr/sierra-to-usb/full-adapter/cm4/cad/aux-window.kicad_sch

## KiCad design full-adapter/cm4/cad/aux-window.kicad_sch (2026-09-10)

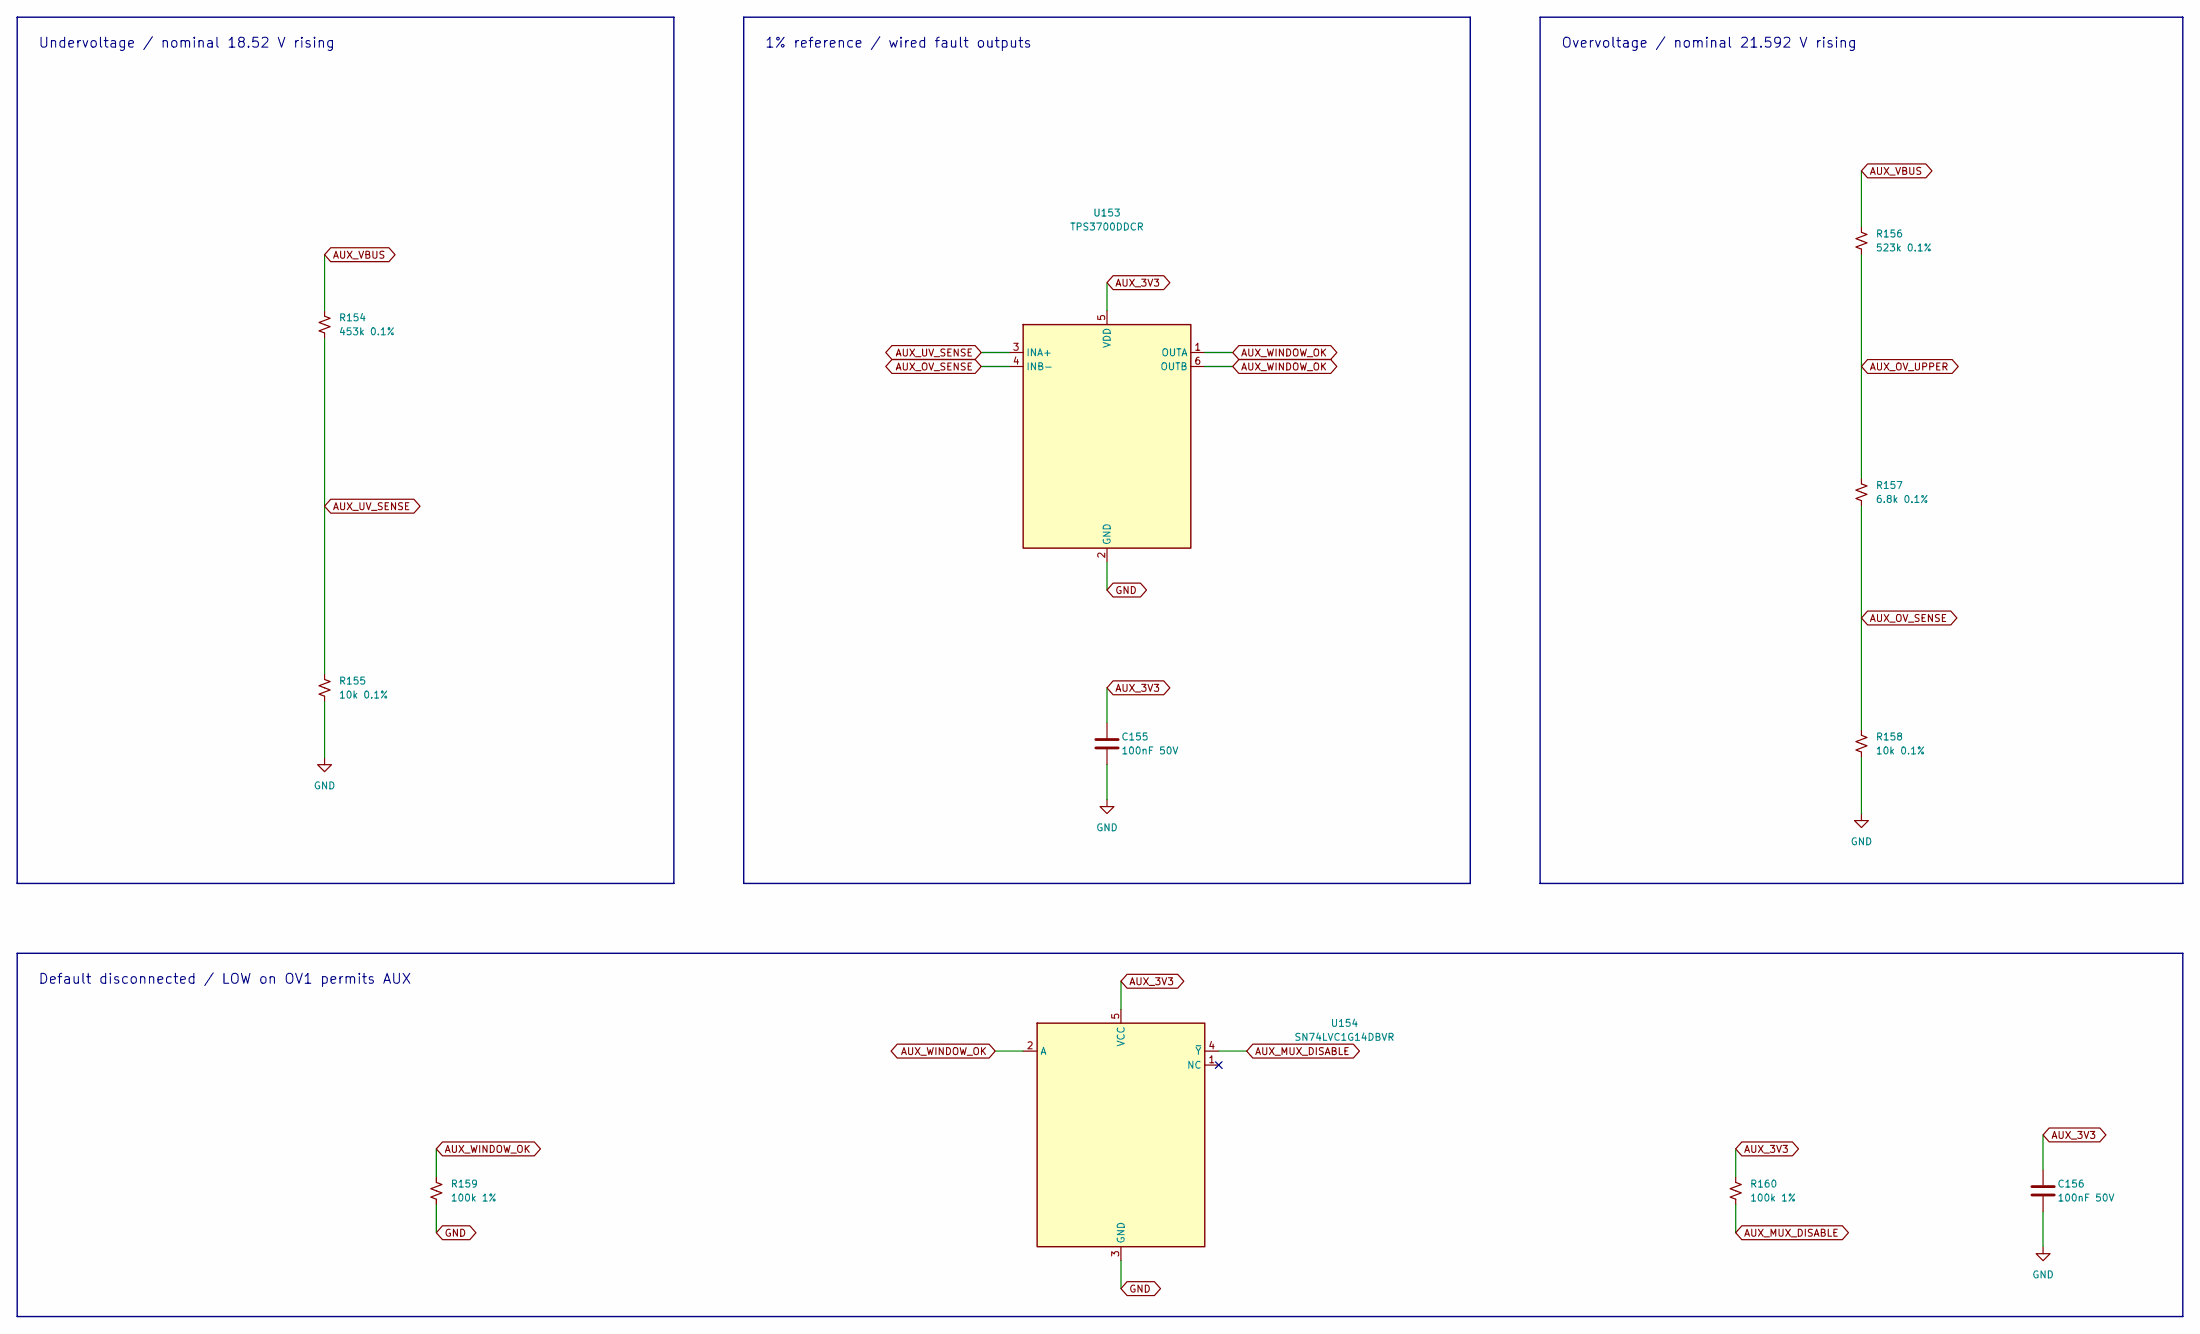
[picture p65: schematic aux-window.kicad_sch]

Parts:
C155, C156: 100nF 50V; C_0402_1005Metric; MPN CC0402KRX7R9BB104; LCSC C131394
R154: 453k 0.1%; R_0603_1608Metric; MPN RT0603BRD07453KL; LCSC C861412
R155, R158: 10k 0.1%; R_0603_1608Metric; MPN RT0603BRD0710KL; LCSC C95204
R156: 523k 0.1%; R_0603_1608Metric; MPN RT0603BRD07523KL; LCSC C861460
R157: 6.8k 0.1%; R_0603_1608Metric; MPN RT0603BRD076K8L; LCSC C861539
R159, R160: 100k 1%; R_0402_1005Metric; MPN 0402WGF1003TCE; LCSC C25741
U153: TPS3700DDCR; TSOT-23-6; MPN TPS3700DDCR; LCSC C33002
U154: SN74LVC1G14DBVR; SOT-23-5; MPN SN74LVC1G14DBVR; LCSC C7835

Connections:
AUX_3V3: C155.1, C156.1, R160.1, U153.5 (VDD), U154.5 (VCC)
AUX_MUX_DISABLE: R160.2, U154.4 (~Y)
AUX_OV_SENSE: R157.2, R158.1, U153.4 (INB-)
AUX_OV_UPPER: R156.2, R157.1
AUX_UV_SENSE: R154.2, R155.1, U153.3 (INA+)
AUX_VBUS: R154.1, R156.1
AUX_WINDOW_OK: R159.1, U153.1 (OUTA), U153.6 (OUTB), U154.2 (A)
GND: C155.2, C156.2, R155.2, R158.2, R159.2, U153.2 (GND), U154.3 (GND)

Notes on the sheet:
Undervoltage / nominal 18.52 V rising
1% reference / wired fault outputs
Overvoltage / nominal 21.592 V rising
Default disconnected / LOW on OV1 permits AUX
