alxgmpr/sierra-to-usb/full-adapter/cm4/cad/cm4-interfaces.kicad_sch

## KiCad design full-adapter/cm4/cad/cm4-interfaces.kicad_sch (2026-09-10)

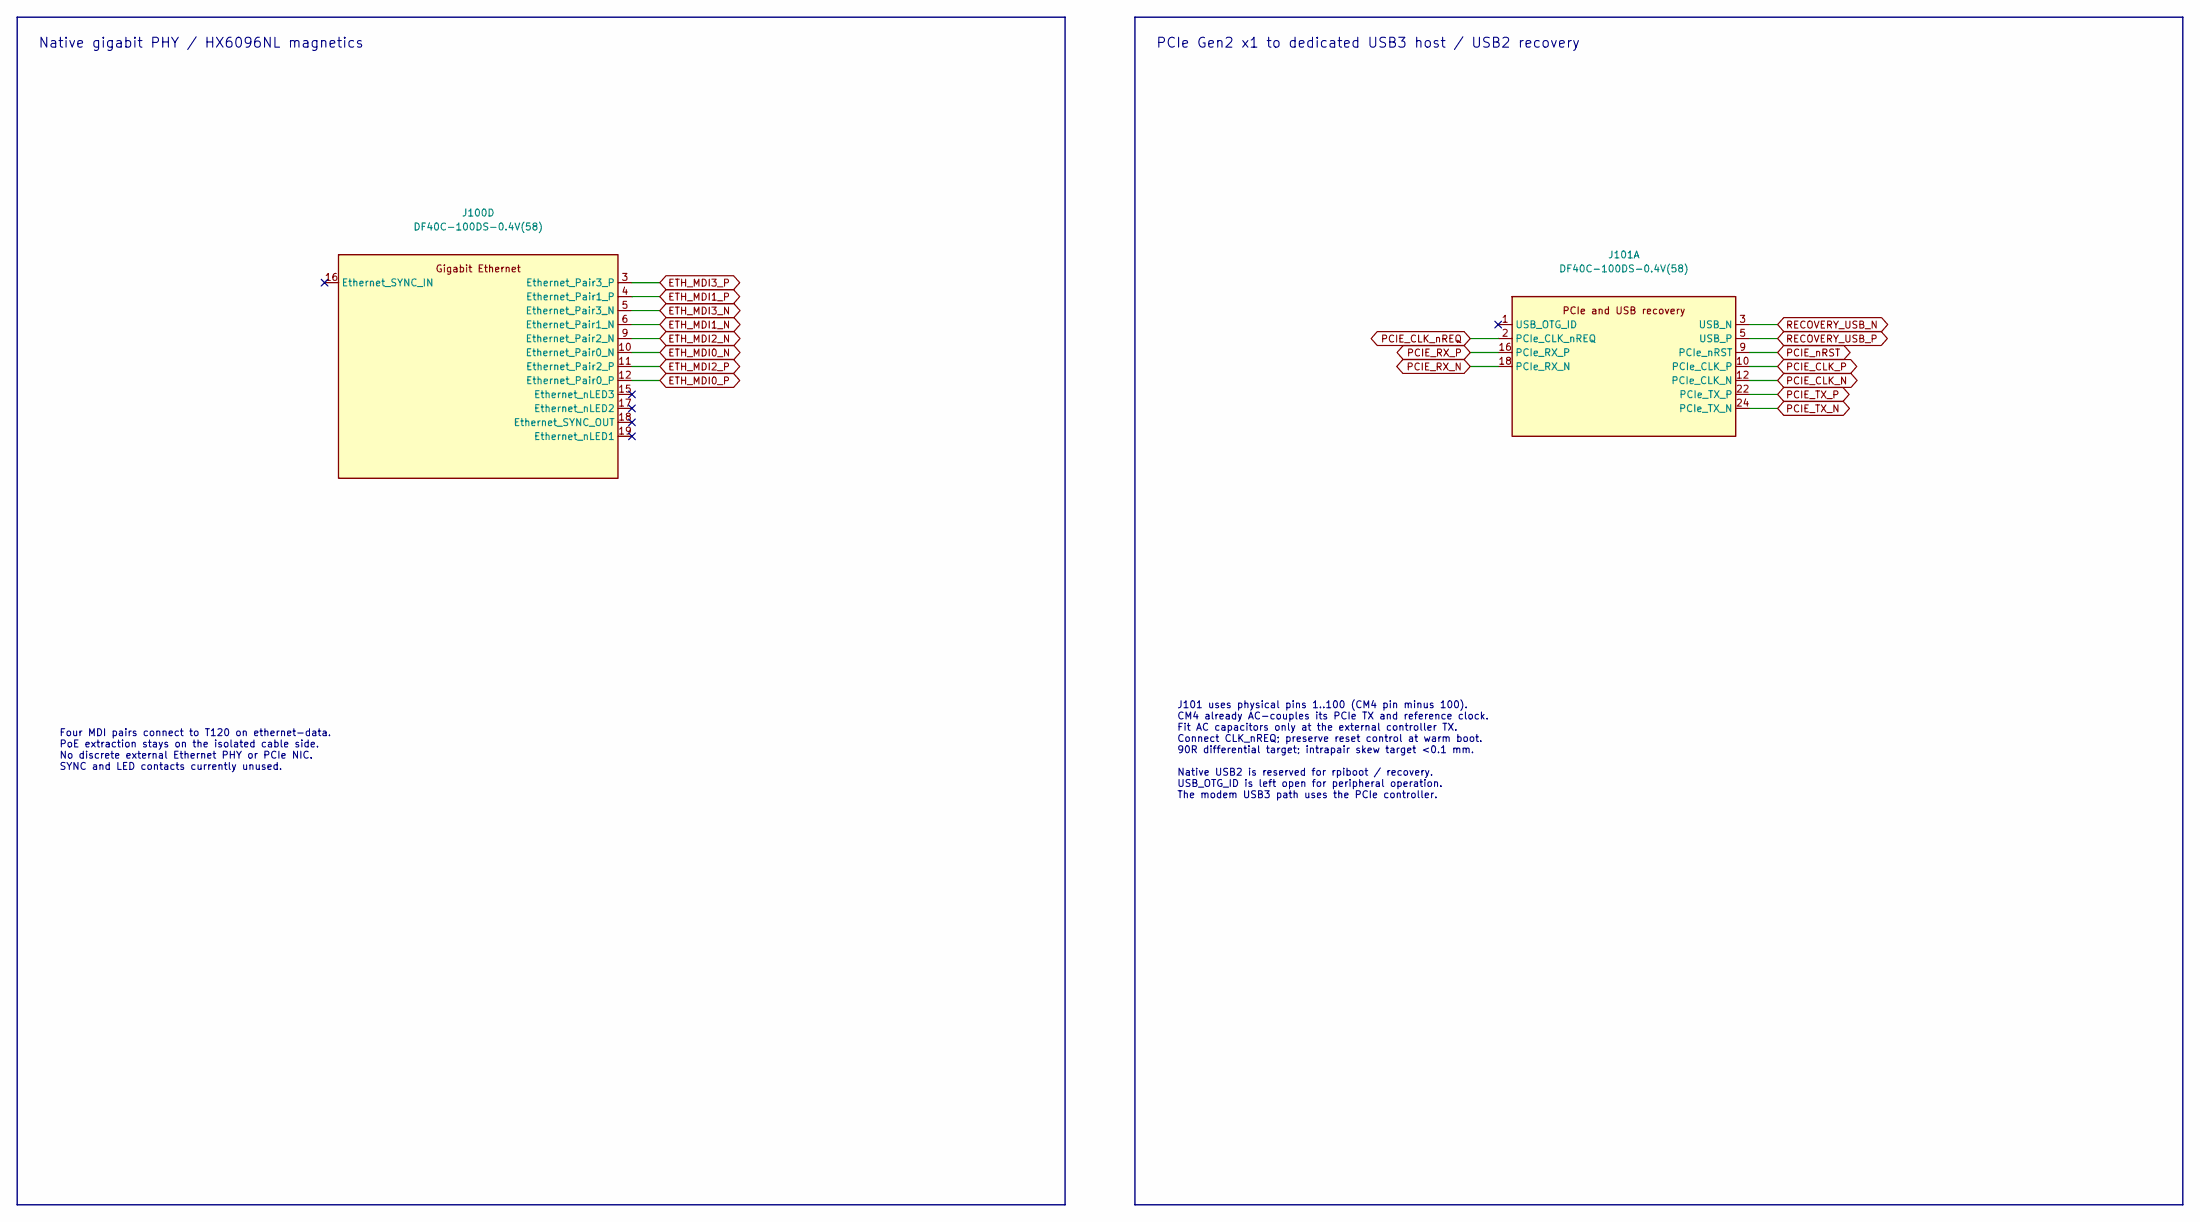
[picture p66: schematic cm4-interfaces.kicad_sch]

Parts:
J100, J101: DF40C-100DS-0.4V(58); Hirose_DF40C-100DS-0.4V_2x50_P0.4mm; MPN DF40C-100DS-0.4V(58); LCSC C3642394

Connections:
ETH_MDI0_N: J100.10 (Ethernet_Pair0_N)
ETH_MDI0_P: J100.12 (Ethernet_Pair0_P)
ETH_MDI1_N: J100.6 (Ethernet_Pair1_N)
ETH_MDI1_P: J100.4 (Ethernet_Pair1_P)
ETH_MDI2_N: J100.9 (Ethernet_Pair2_N)
ETH_MDI2_P: J100.11 (Ethernet_Pair2_P)
ETH_MDI3_N: J100.5 (Ethernet_Pair3_N)
ETH_MDI3_P: J100.3 (Ethernet_Pair3_P)
PCIE_CLK_N: J101.12 (PCIe_CLK_N)
PCIE_CLK_P: J101.10 (PCIe_CLK_P)
PCIE_CLK_nREQ: J101.2 (PCIe_CLK_nREQ)
PCIE_RX_N: J101.18 (PCIe_RX_N)
PCIE_RX_P: J101.16 (PCIe_RX_P)
PCIE_TX_N: J101.24 (PCIe_TX_N)
PCIE_TX_P: J101.22 (PCIe_TX_P)
PCIE_nRST: J101.9 (PCIe_nRST)
RECOVERY_USB_N: J101.3 (USB_N)
RECOVERY_USB_P: J101.5 (USB_P)

Notes on the sheet:
Native gigabit PHY / HX6096NL magnetics
Four MDI pairs connect to T120 on ethernet-data. PoE extraction stays on the isolated cable side. No discrete external Ethernet PHY or PCIe NIC. SYNC and LED contacts currently unused.
PCIe Gen2 x1 to dedicated USB3 host / USB2 recovery
J101 uses physical pins 1..100 (CM4 pin minus 100). CM4 already AC-couples its PCIe TX and reference clock. Fit AC capacitors only at the external controller TX. Connect CLK_nREQ; preserve reset control at warm boot. 90R differential target; intrapair skew target <0.1 mm. Native USB2 is reserved fo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
