alxgmpr/sierra-to-usb/full-adapter/cm4/cad/cm4-power.kicad_sch

## KiCad design full-adapter/cm4/cad/cm4-power.kicad_sch (2026-09-10)

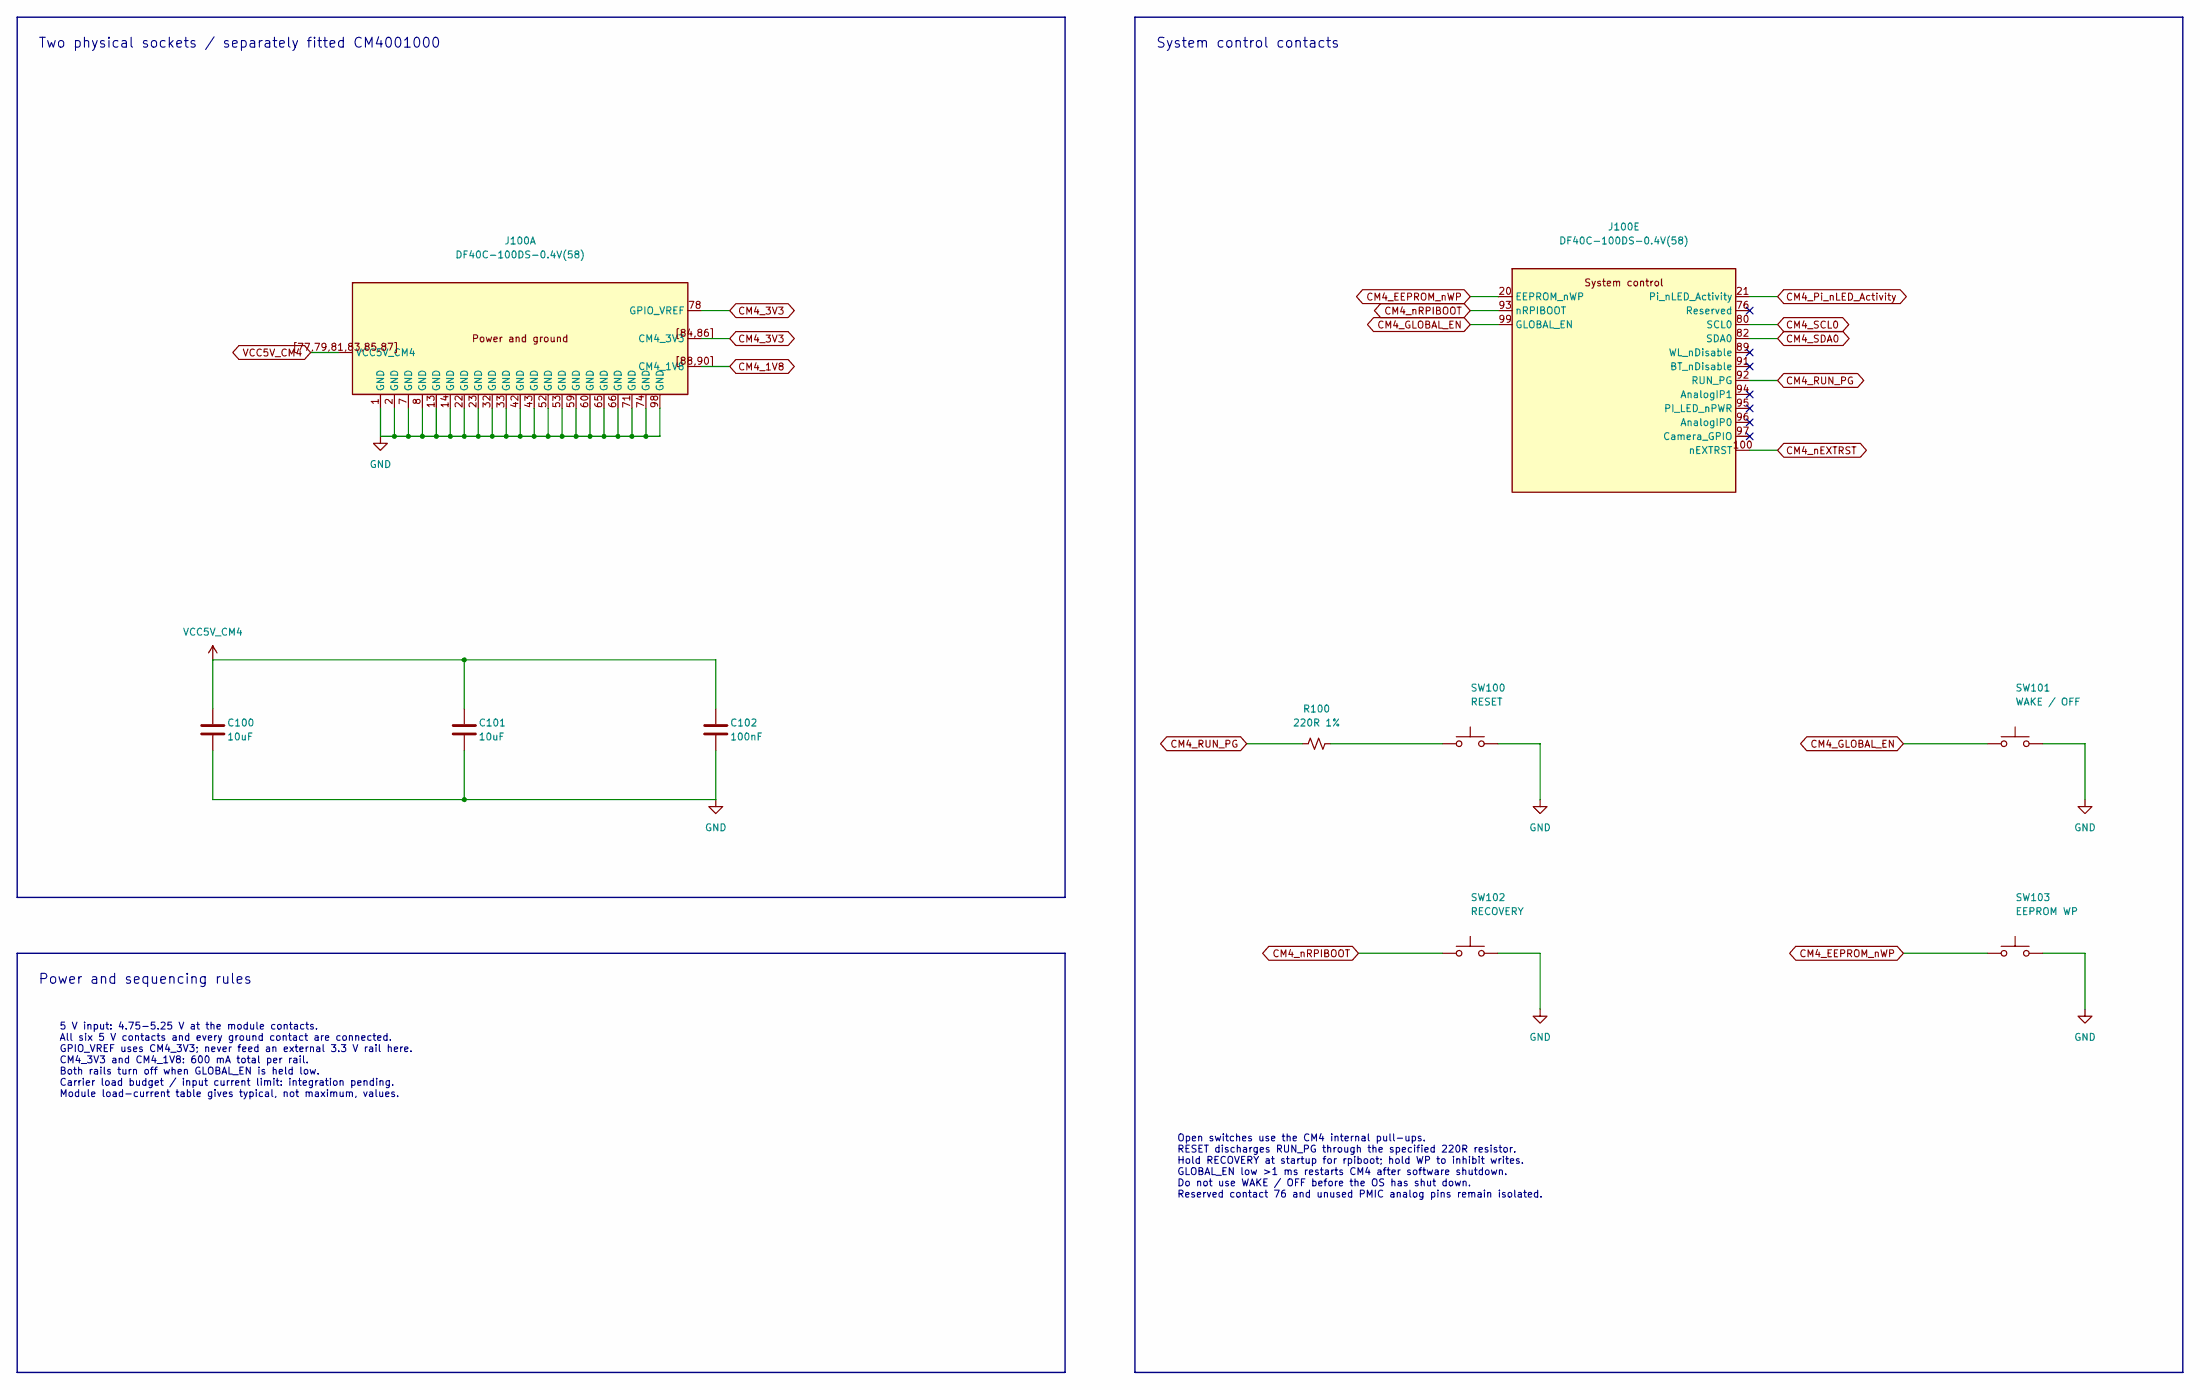
[picture p67: schematic cm4-power.kicad_sch]

Parts:
C100, C101: 10uF; C_0603_1608Metric; MPN CL10A106KP8NNNC; LCSC C19702
C102: 100nF; C_0402_1005Metric; MPN CL05B104KO5NNNC; LCSC C1525
J100: DF40C-100DS-0.4V(58); Hirose_DF40C-100DS-0.4V_2x50_P0.4mm; MPN DF40C-100DS-0.4V(58); LCSC C3642394
R100: 220R 1%; R_0402_1005Metric; MPN 0402WGF2200TCE; LCSC C25091
SW100: RESET; Alps_SKRPACE010; MPN SKRPACE010; LCSC C139797
SW101: WAKE / OFF; Alps_SKRPACE010; MPN SKRPACE010; LCSC C139797
SW102: RECOVERY; Alps_SKRPACE010; MPN SKRPACE010; LCSC C139797
SW103: EEPROM WP; Alps_SKRPACE010; MPN SKRPACE010; LCSC C139797

Connections:
CM4_1V8: J100.[88,90] (CM4_1V8)
CM4_3V3: J100.78 (GPIO_VREF), J100.[84,86] (CM4_3V3)
CM4_EEPROM_nWP: J100.20 (EEPROM_nWP), SW103.1
CM4_GLOBAL_EN: J100.99 (GLOBAL_EN), SW101.1
CM4_Pi_nLED_Activity: J100.21 (Pi_nLED_Activity)
CM4_RUN_PG: J100.92 (RUN_PG), R100.1
CM4_SCL0: J100.80 (SCL0)
CM4_SDA0: J100.82 (SDA0)
CM4_nEXTRST: J100.100 (nEXTRST)
CM4_nRPIBOOT: J100.93 (nRPIBOOT), SW102.1
GND: C100.2, C101.2, C102.2, J100.1 (GND), J100.2 (GND), J100.7 (GND), J100.8 (GND), J100.13 (GND), J100.14 (GND), J100.22 (GND), J100.23 (GND), J100.32 (GND), J100.33 (GND), J100.42 (GND), J100.43 (GND), J100.52 (GND), J100.53 (GND), J100.59 (GND), J100.60 (GND), J100.65 (GND), J100.66 (GND), J100.71 (GND), J100.74 (GND), J100.98 (GND), SW100.2, SW101.2, SW102.2, SW103.2
unnamed: R100.2, SW100.1
VCC5V_CM4: C100.1, C101.1, C102.1, J100.[77,79,81,83,85,87] (VCC5V_CM4)

Notes on the sheet:
Two physical sockets / separately fitted CM4001000
Power and sequencing rules
5 V input: 4.75-5.25 V at the module contacts. All six 5 V contacts and every ground contact are connected. GPIO_VREF uses CM4_3V3; never feed an external 3.3 V rail here. CM4_3V3 and CM4_1V8: 600 mA total per rail. Both rails turn off when GLOBAL_EN is held low. Carrier load budget / input current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
System control contacts
Open switches use the CM4 internal pull-ups. RESET discharges RUN_PG through the specified 220R resistor. Hold RECOVERY at startup for rpiboot; hold WP to inhibit writes. GLOBAL_EN low >1 ms restarts CM4 after software shutdown. Do not use WAKE / OFF before the OS has shut down. Reserved contact 76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
