alxgmpr/sierra-to-usb/full-adapter/cm4/cad/cm4-storage.kicad_sch

## KiCad design full-adapter/cm4/cad/cm4-storage.kicad_sch (2026-09-10)

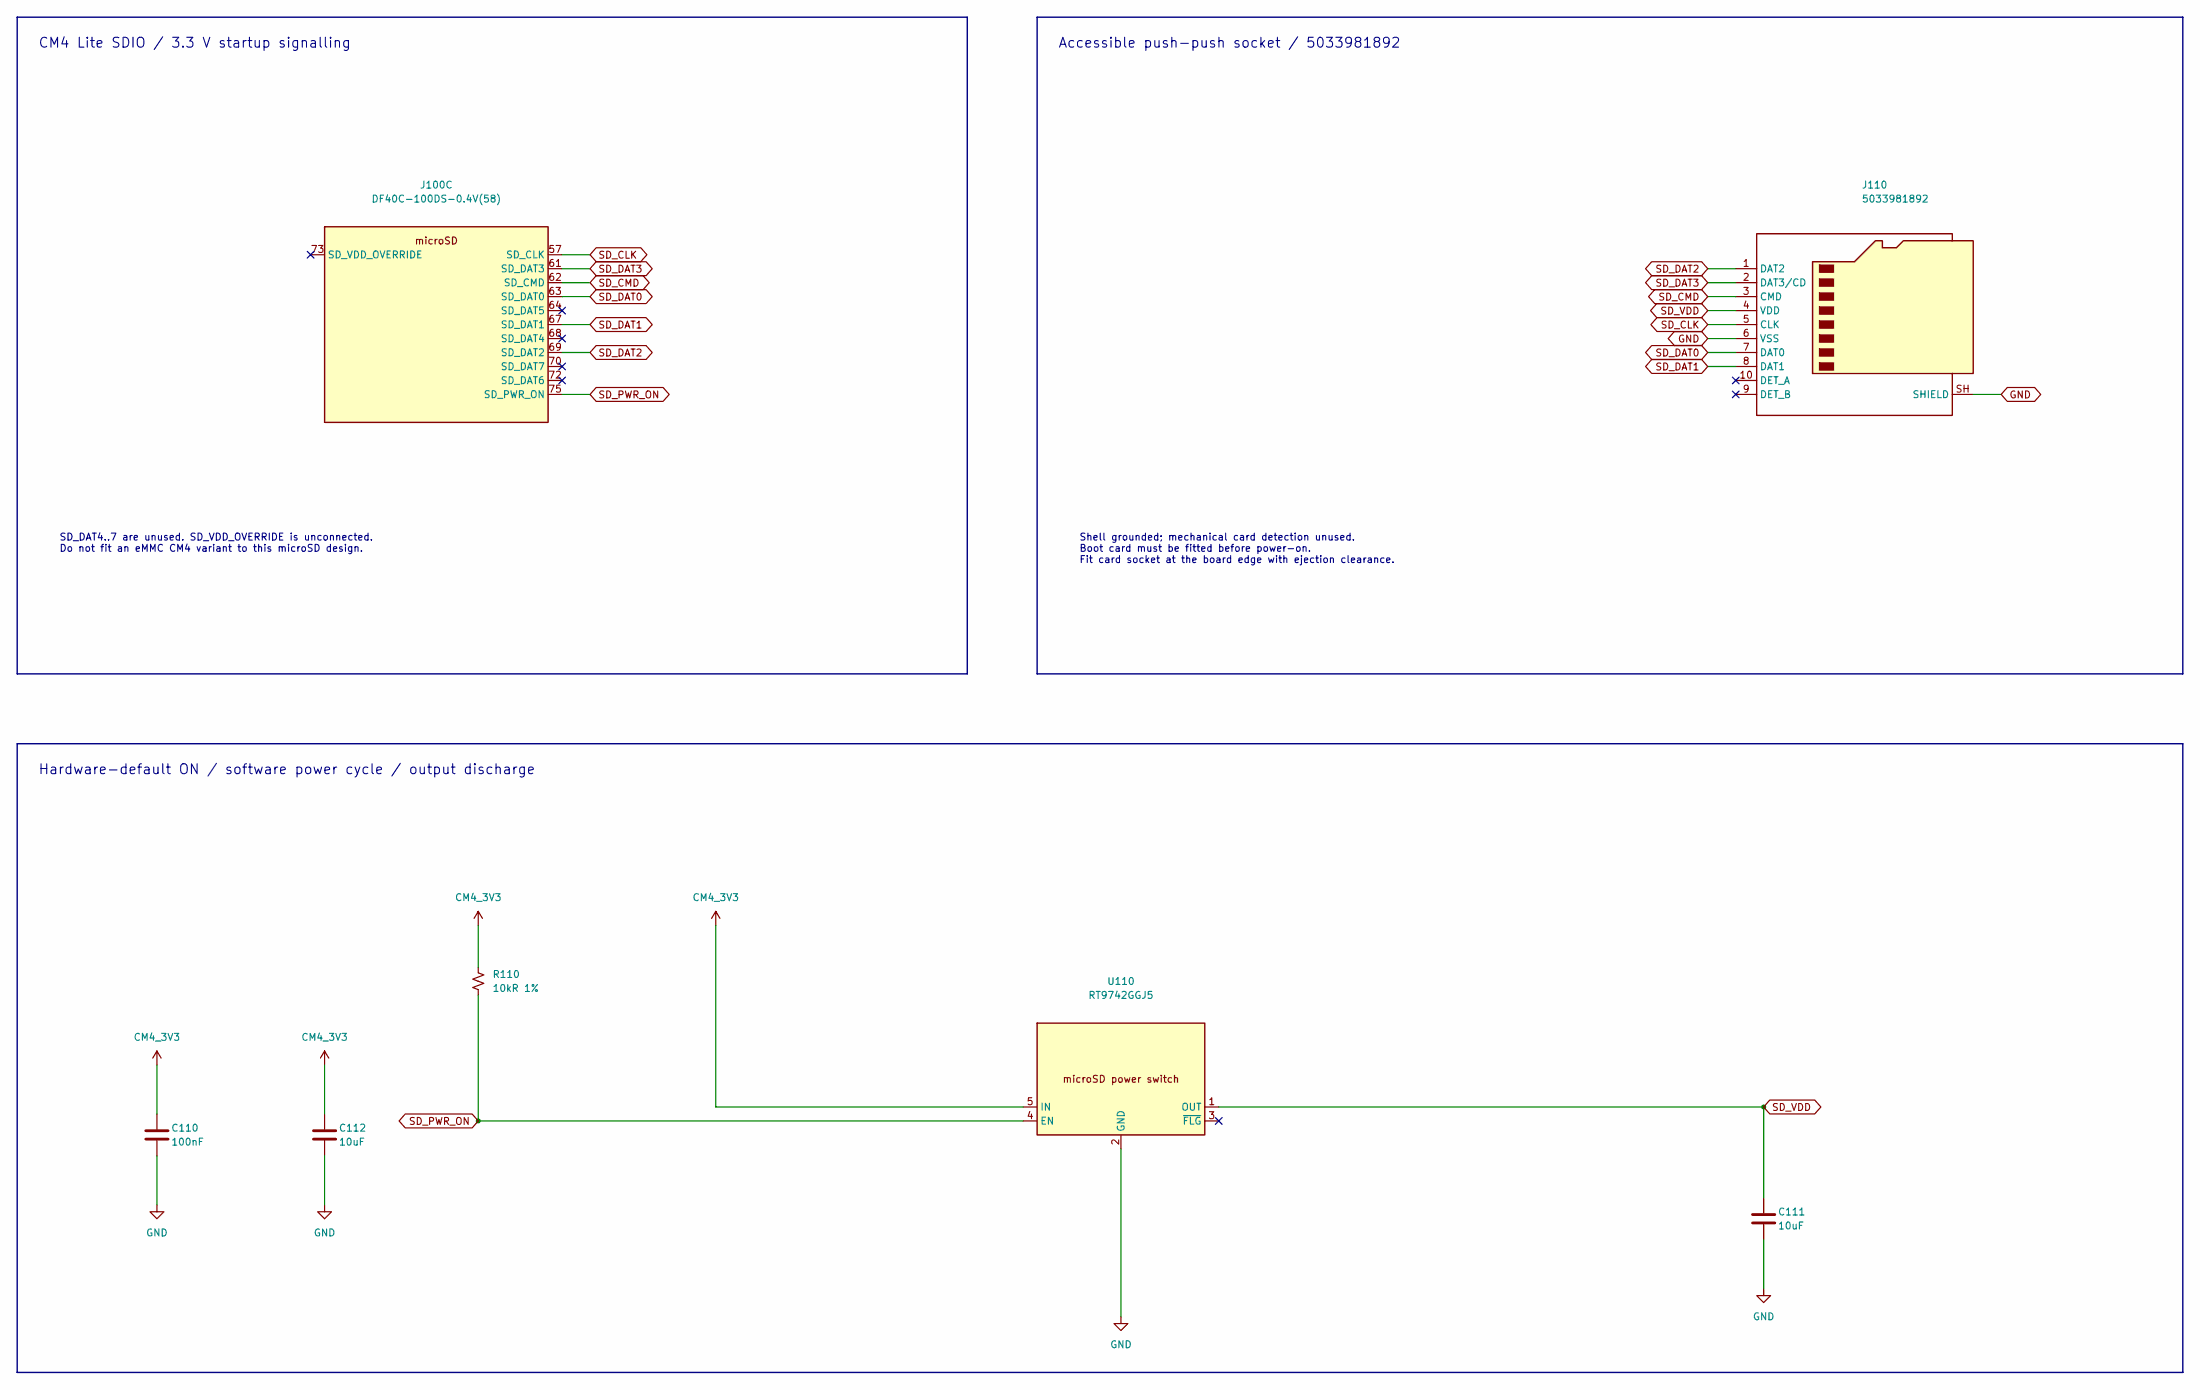
[picture p68: schematic cm4-storage.kicad_sch]

Parts:
C110: 100nF; C_0402_1005Metric; MPN CL05B104KO5NNNC; LCSC C1525
C111, C112: 10uF; C_0603_1608Metric; MPN CL10A106KP8NNNC; LCSC C19702
J100: DF40C-100DS-0.4V(58); Hirose_DF40C-100DS-0.4V_2x50_P0.4mm; MPN DF40C-100DS-0.4V(58); LCSC C3642394
J110: 5033981892; SDCARD_MOLEX_503398-1892; MPN 5033981892; LCSC C428492
R110: 10kR 1%; R_0402_1005Metric; MPN 0402WGF1002TCE; LCSC C25744
U110: RT9742GGJ5; TSOT-23-5; MPN RT9742GGJ5; LCSC C250547

Connections:
CM4_3V3: C110.1, C112.1, R110.1, U110.5 (IN)
GND: C110.2, C111.2, C112.2, J110.6 (VSS), J110.SH (SHIELD), U110.2 (GND)
SD_CLK: J100.57 (SD_CLK), J110.5 (CLK)
SD_CMD: J100.62 (SD_CMD), J110.3 (CMD)
SD_DAT0: J100.63 (SD_DAT0), J110.7 (DAT0)
SD_DAT1: J100.67 (SD_DAT1), J110.8 (DAT1)
SD_DAT2: J100.69 (SD_DAT2), J110.1 (DAT2)
SD_DAT3: J100.61 (SD_DAT3), J110.2 (DAT3/CD)
SD_PWR_ON: J100.75 (SD_PWR_ON), R110.2, U110.4 (EN)
SD_VDD: C111.1, J110.4 (VDD), U110.1 (OUT)

Notes on the sheet:
CM4 Lite SDIO / 3.3 V startup signalling
SD_DAT4..7 are unused. SD_VDD_OVERRIDE is unconnected. Do not fit an eMMC CM4 variant to this microSD design.
Accessible push-push socket / 5033981892
Shell grounded; mechanical card detection unused. Boot card must be fitted before power-on. Fit card socket at the board edge with ejection clearance.
Hardware-default ON / software power cycle / output discharge
