alxgmpr/sierra-to-usb/full-adapter/cm4/cad/ethernet-data.kicad_sch

## KiCad design full-adapter/cm4/cad/ethernet-data.kicad_sch (2026-09-10)

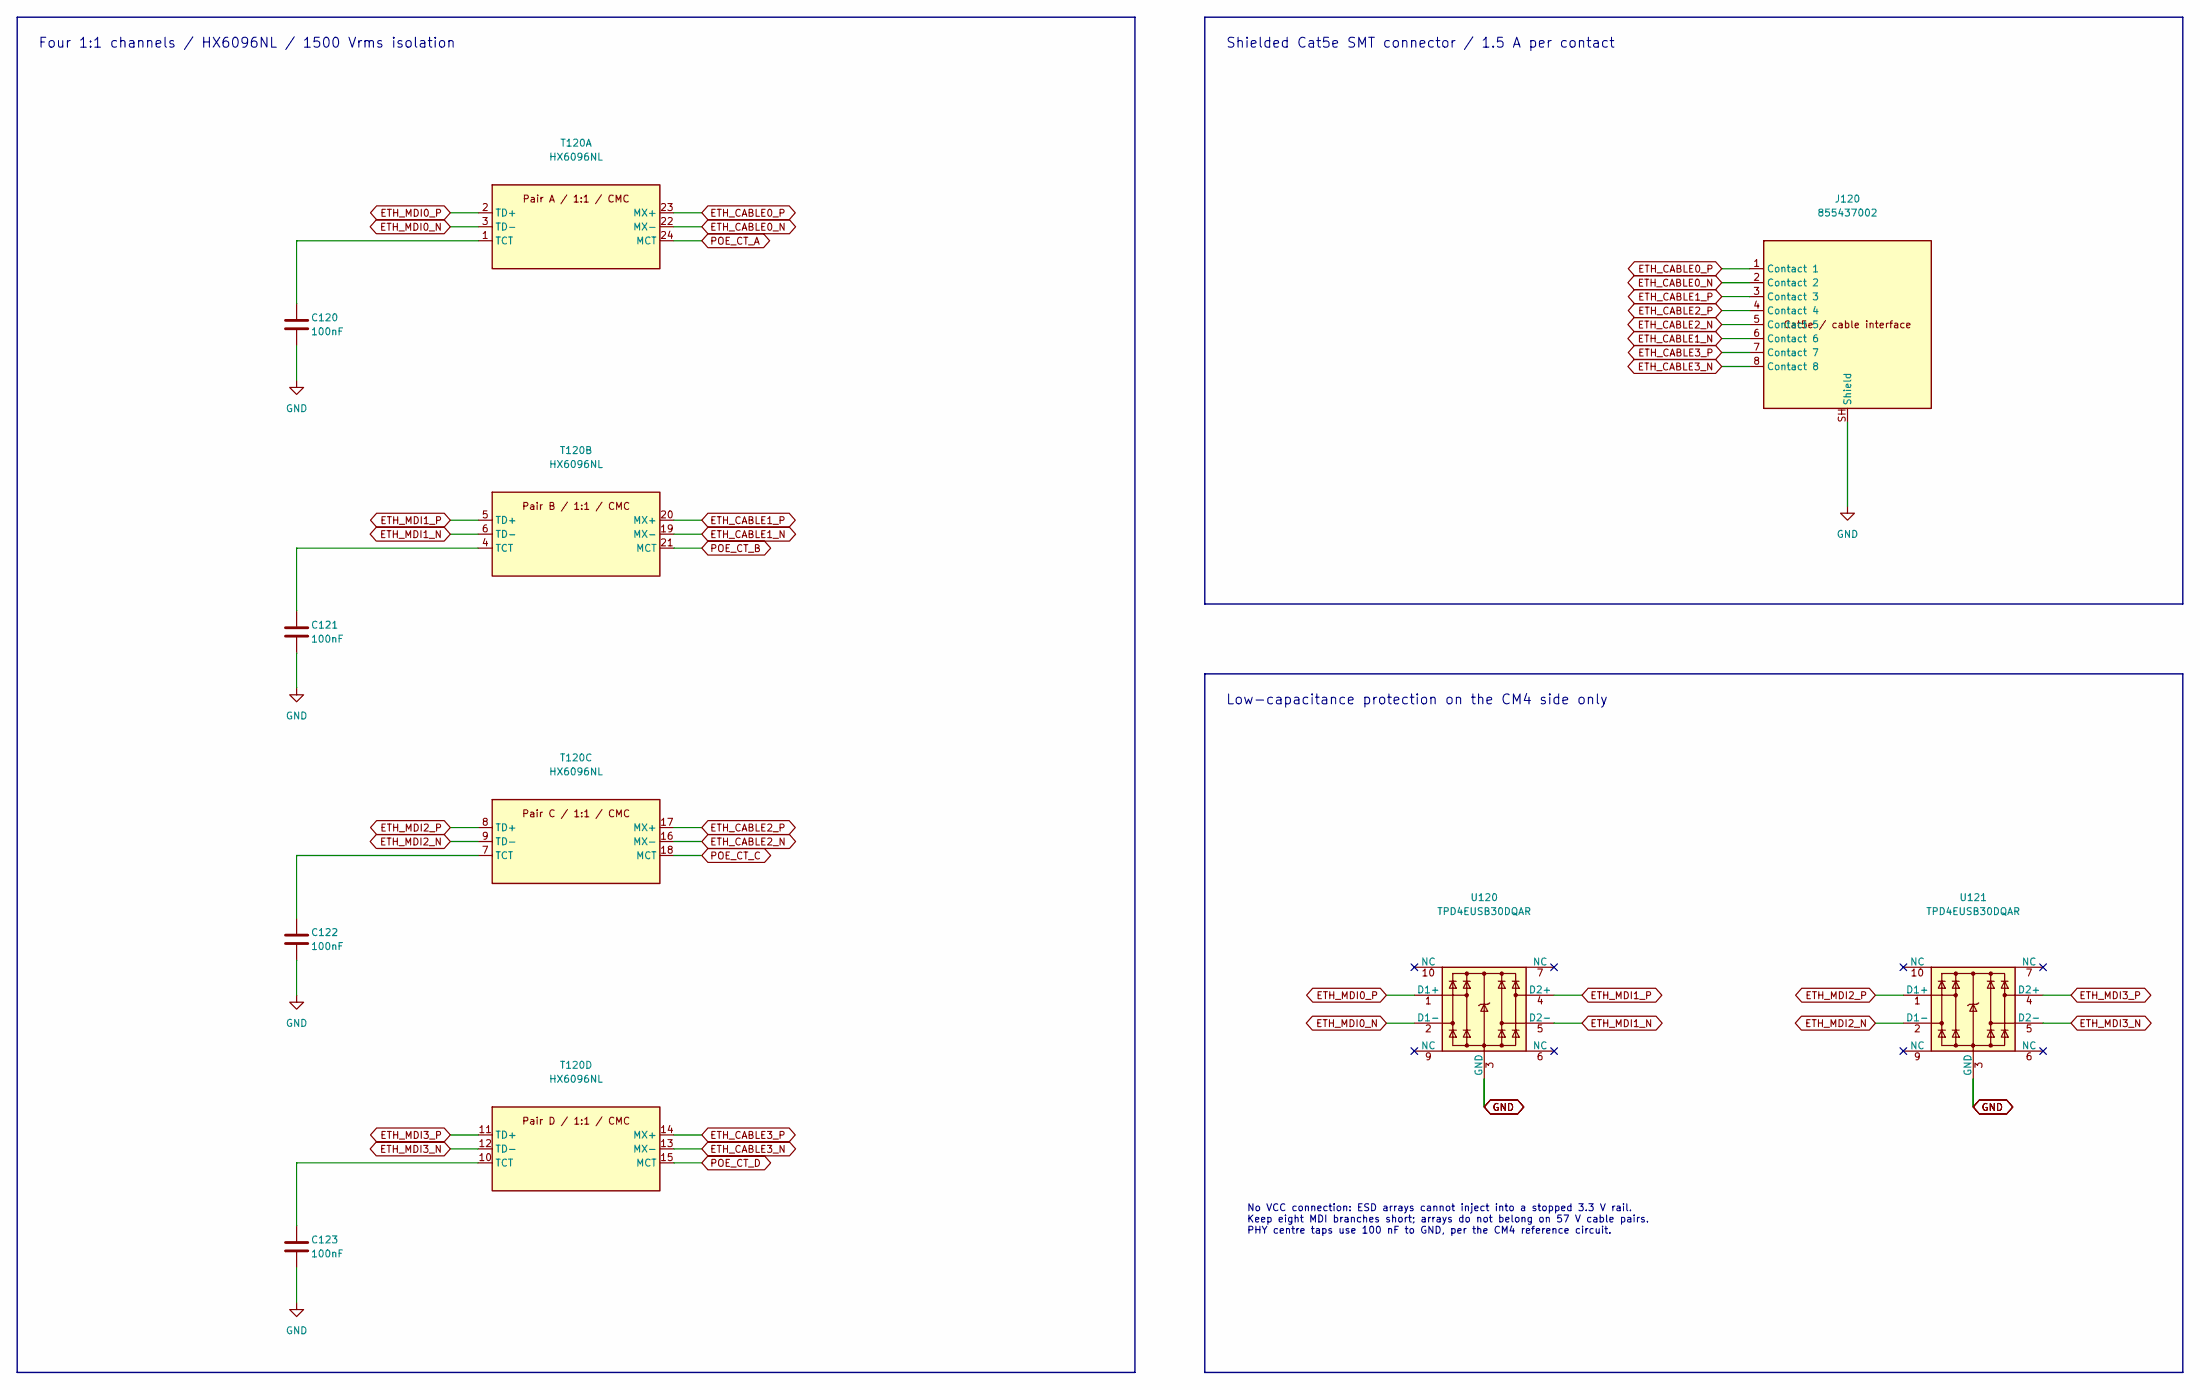
[picture p69: schematic ethernet-data.kicad_sch]

Parts:
C120, C121, C122, C123: 100nF; C_0402_1005Metric; MPN CL05B104KO5NNNC; LCSC C1525
J120: 855437002; Molex_855437002; MPN 855437002; LCSC C3179022
T120: HX6096NL; Pulse_HX6096NL; MPN HX6096NL; LCSC C5339289
U120, U121: TPD4EUSB30DQAR; TI_DQA0010_TPD4EUSB30; MPN TPD4EUSB30DQAR; LCSC C90627

Connections:
ETH_CABLE0_N: J120.2 (Contact 2), T120.22 (MX-)
ETH_CABLE0_P: J120.1 (Contact 1), T120.23 (MX+)
ETH_CABLE1_N: J120.6 (Contact 6), T120.19 (MX-)
ETH_CABLE1_P: J120.3 (Contact 3), T120.20 (MX+)
ETH_CABLE2_N: J120.5 (Contact 5), T120.16 (MX-)
ETH_CABLE2_P: J120.4 (Contact 4), T120.17 (MX+)
ETH_CABLE3_N: J120.8 (Contact 8), T120.13 (MX-)
ETH_CABLE3_P: J120.7 (Contact 7), T120.14 (MX+)
ETH_MDI0_N: T120.3 (TD-), U120.2 (D1-)
ETH_MDI0_P: T120.2 (TD+), U120.1 (D1+)
ETH_MDI1_N: T120.6 (TD-), U120.5 (D2-)
ETH_MDI1_P: T120.5 (TD+), U120.4 (D2+)
ETH_MDI2_N: T120.9 (TD-), U121.2 (D1-)
ETH_MDI2_P: T120.8 (TD+), U121.1 (D1+)
ETH_MDI3_N: T120.12 (TD-), U121.5 (D2-)
ETH_MDI3_P: T120.11 (TD+), U121.4 (D2+)
GND: C120.2, C121.2, C122.2, C123.2, J120.SH (Shield), U120.3 (GND), U120.8 (GND), U121.3 (GND), U121.8 (GND)
unnamed: C120.1, T120.1 (TCT)
unnamed: C121.1, T120.4 (TCT)
unnamed: C122.1, T120.7 (TCT)
unnamed: C123.1, T120.10 (TCT)
POE_CT_A: T120.24 (MCT)
POE_CT_B: T120.21 (MCT)
POE_CT_C: T120.18 (MCT)
POE_CT_D: T120.15 (MCT)

Notes on the sheet:
Four 1:1 channels / HX6096NL / 1500 Vrms isolation
Shielded Cat5e SMT connector / 1.5 A per contact
Low-capacitance protection on the CM4 side only
No VCC connection: ESD arrays cannot inject into a stopped 3.3 V rail. Keep eight MDI branches short; arrays do not belong on 57 V cable pairs. PHY centre taps use 100 nF to GND, per the CM4 reference circuit.
