alxgmpr/sierra-to-usb/full-adapter/cm4/cad/ethernet-termination.kicad_sch

## KiCad design full-adapter/cm4/cad/ethernet-termination.kicad_sch (2026-09-10)

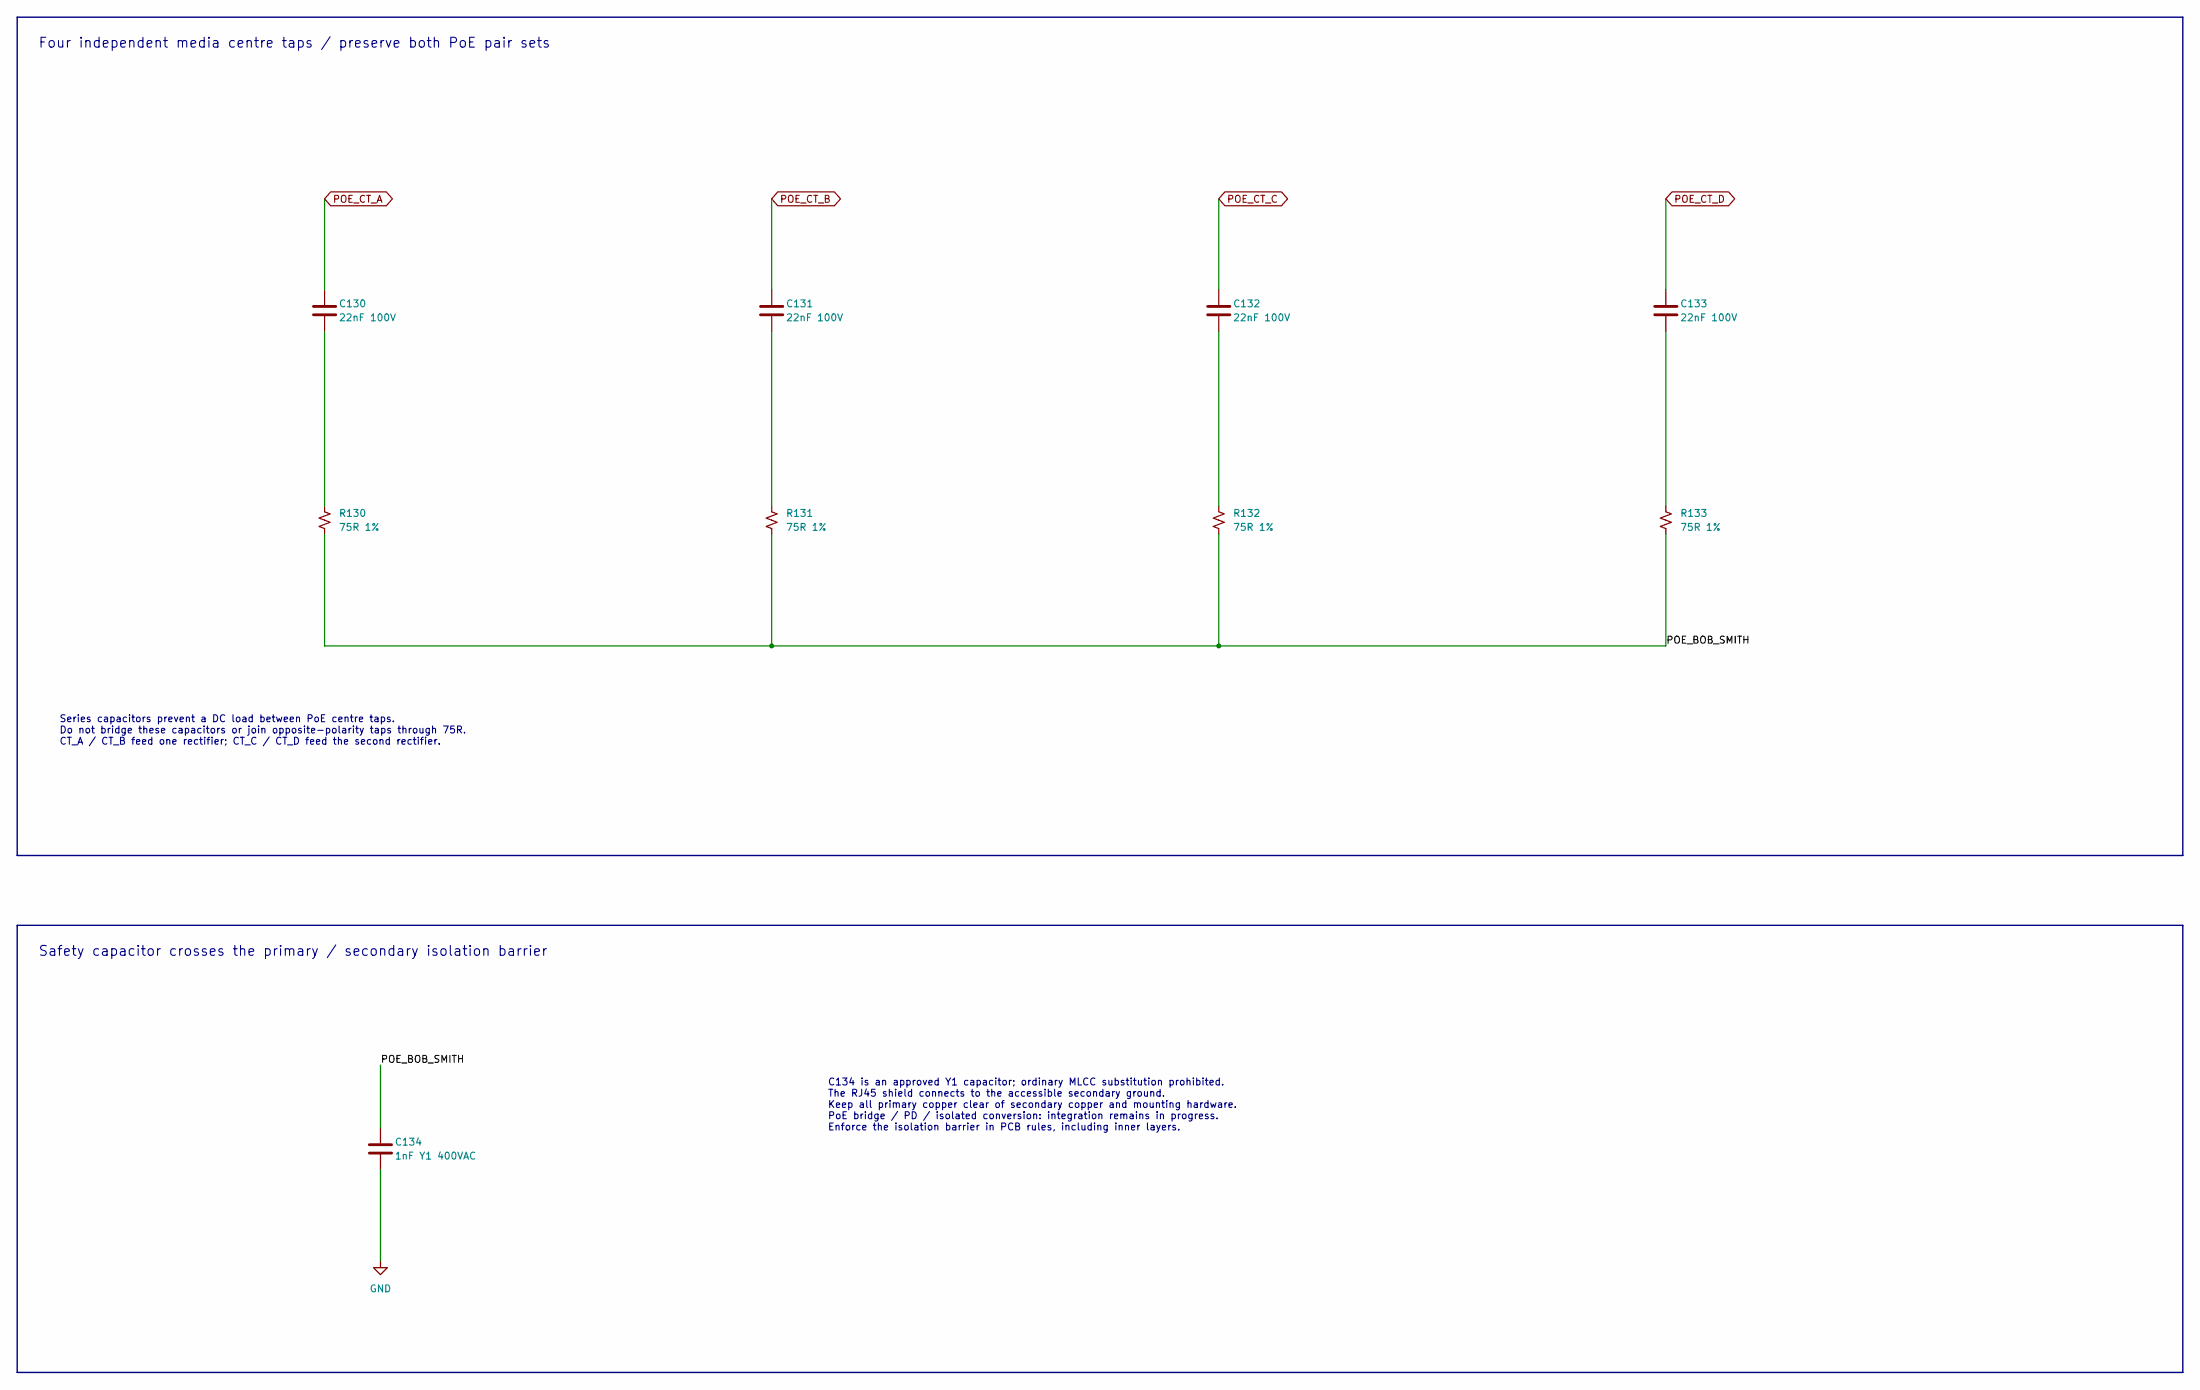
[picture p70: schematic ethernet-termination.kicad_sch]

Parts:
C130, C131, C132, C133: 22nF 100V; C_0603_1608Metric; MPN CC0603KRX7R0BB223; LCSC C313105
C134: 1nF Y1 400VAC; Dersonic_CY1102ME14EF45W2A2_P10mm; MPN CY1102ME14EF45W2A2; LCSC C2974845
R130, R131, R132, R133: 75R 1%; R_0603_1608Metric; MPN 0603WAF750JT5E; LCSC C4275

Connections:
GND: C134.2
unnamed: C130.2, R130.1
unnamed: C131.2, R131.1
unnamed: C132.2, R132.1
unnamed: C133.2, R133.1
POE_BOB_SMITH: C134.1, R130.2, R131.2, R132.2, R133.2
POE_CT_A: C130.1
POE_CT_B: C131.1
POE_CT_C: C132.1
POE_CT_D: C133.1

Notes on the sheet:
Four independent media centre taps / preserve both PoE pair sets
Series capacitors prevent a DC load between PoE centre taps. Do not bridge these capacitors or join opposite-polarity taps through 75R. CT_A / CT_B feed one rectifier; CT_C / CT_D feed the second rectifier.
Safety capacitor crosses the primary / secondary isolation barrier
C134 is an approved Y1 capacitor; ordinary MLCC substitution prohibited. The RJ45 shield connects to the accessible secondary ground. Keep all primary copper clear of secondary copper and mounting hardware. PoE bridge / PD / isolated conversion: integration remains in progress. Enforce the isolatio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
