alxgmpr/sierra-to-usb/full-adapter/cm4/cad/input-mux.kicad_sch

## KiCad design full-adapter/cm4/cad/input-mux.kicad_sch (2026-09-10)

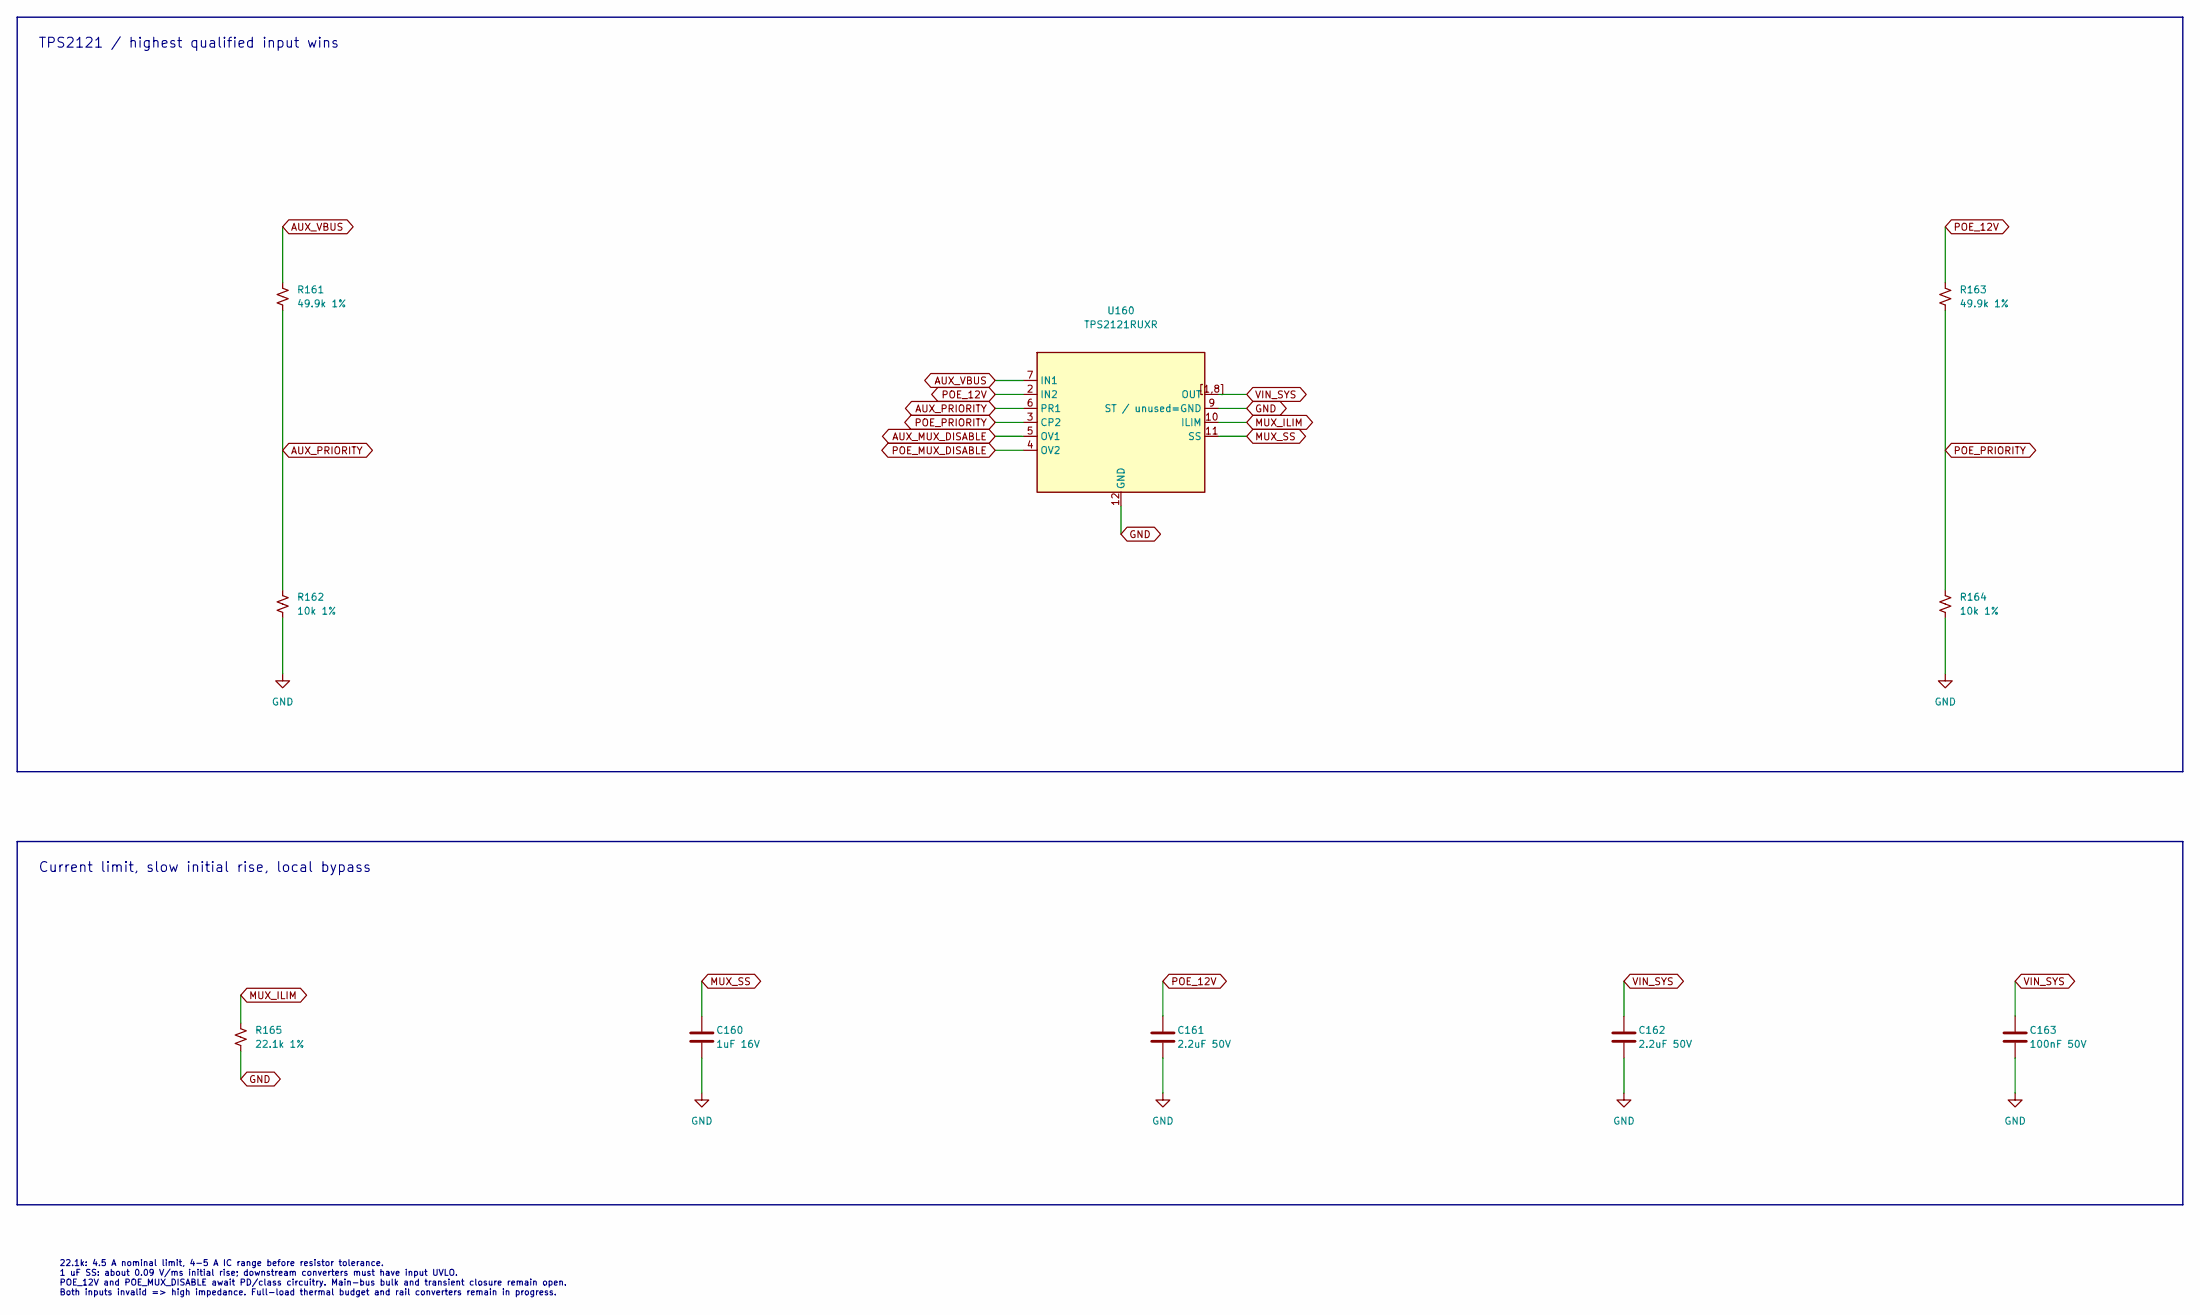
[picture p71: schematic input-mux.kicad_sch]

Parts:
C160: 1uF 16V; C_0603_1608Metric; MPN CL10A105KO8NNNC; LCSC C1592
C161, C162: 2.2uF 50V; C_0805_2012Metric; MPN CL21A225KBQNNNE; LCSC C377773
C163: 100nF 50V; C_0402_1005Metric; MPN CC0402KRX7R9BB104; LCSC C131394
R161, R163: 49.9k 1%; R_0402_1005Metric; MPN 0402WGF4992TCE; LCSC C25897
R162, R164: 10k 1%; R_0402_1005Metric; MPN 0402WGF1002TCE; LCSC C25744
R165: 22.1k 1%; R_0402_1005Metric; MPN 0402WGF2212TCE; LCSC C43473
U160: TPS2121RUXR; TI_RUX0012_TPS2121; MPN TPS2121RUXR; LCSC C485916

Connections:
AUX_MUX_DISABLE: U160.5 (OV1)
AUX_PRIORITY: R161.2, R162.1, U160.6 (PR1)
AUX_VBUS: R161.1, U160.7 (IN1)
GND: C160.2, C161.2, C162.2, C163.2, R162.2, R164.2, R165.2, U160.9 (ST / unused=GND), U160.12 (GND)
MUX_ILIM: R165.1, U160.10 (ILIM)
MUX_SS: C160.1, U160.11 (SS)
POE_12V: C161.1, R163.1, U160.2 (IN2)
POE_MUX_DISABLE: U160.4 (OV2)
POE_PRIORITY: R163.2, R164.1, U160.3 (CP2)
VIN_SYS: C162.1, C163.1, U160.[1,8] (OUT)

Notes on the sheet:
TPS2121 / highest qualified input wins
Current limit, slow initial rise, local bypass
22.1k: 4.5 A nominal limit, 4-5 A IC range before resistor tolerance. 1 uF SS: about 0.09 V/ms initial rise; downstream converters must have input UVLO. POE_12V and POE_MUX_DISABLE await PD/class circuitry. Main-bus bulk and transient closure remain open. Both inputs invalid => high impedance. Full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
