alxgmpr/sierra-to-usb/full-adapter/cm4/cad/modem-power.kicad_sch

## KiCad design full-adapter/cm4/cad/modem-power.kicad_sch (2026-09-10)

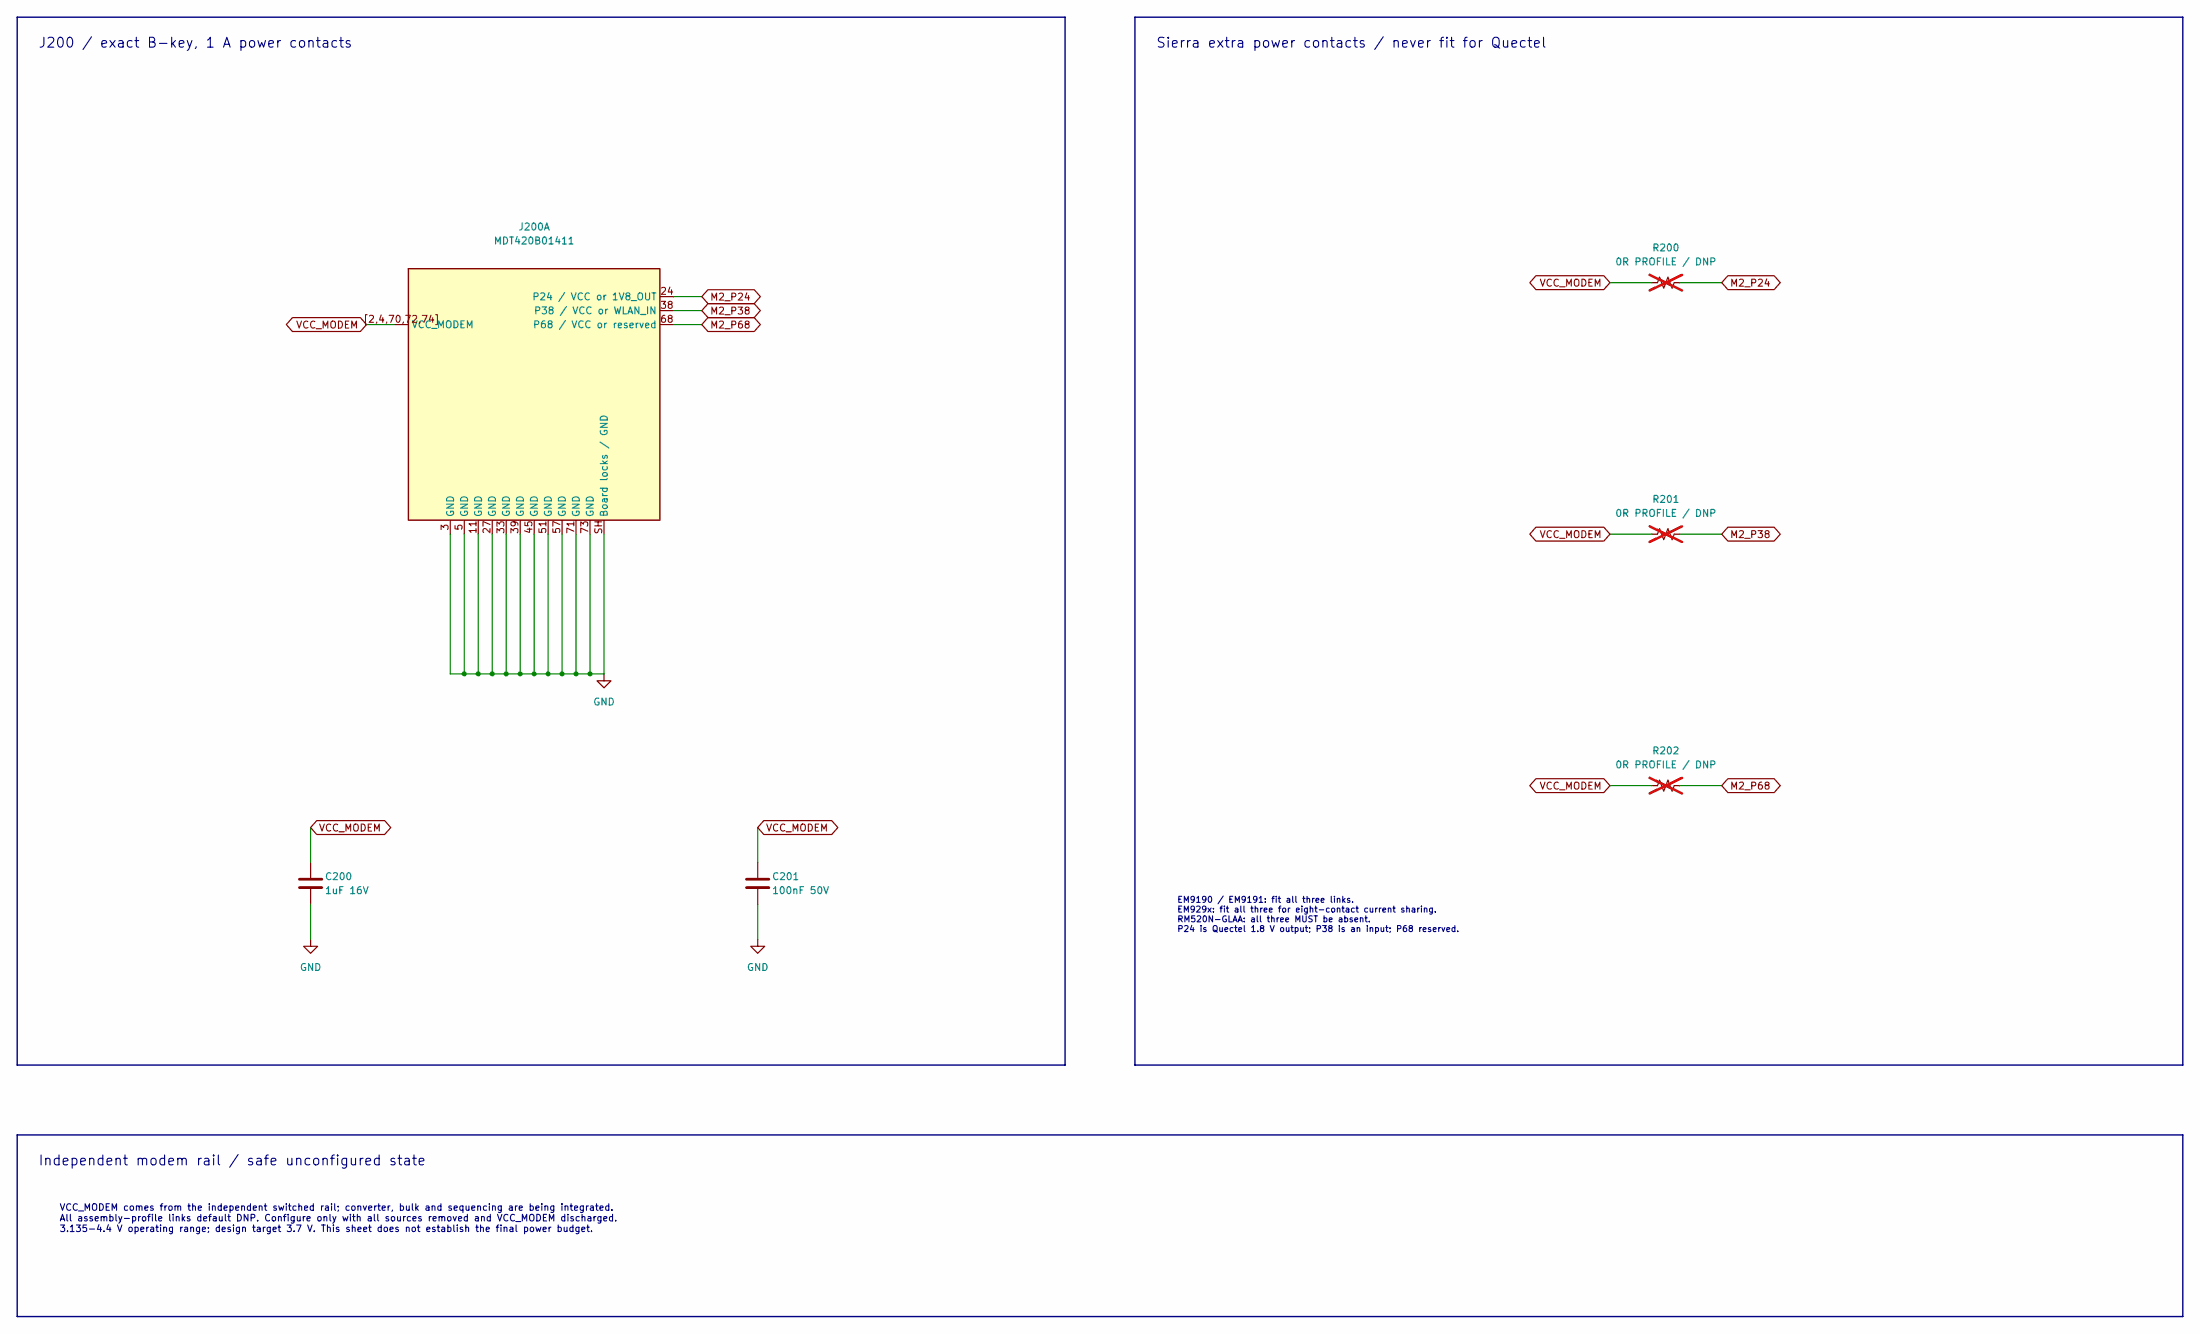
[picture p72: schematic modem-power.kicad_sch]

Parts:
C200: 1uF 16V; C_0603_1608Metric; MPN CL10A105KO8NNNC; LCSC C1592
C201: 100nF 50V; C_0402_1005Metric; MPN CC0402KRX7R9BB104; LCSC C131394
J200: MDT420B01411; Amphenol_MDT420B01411; MPN MDT420B01411
R200, R201, R202: 0R PROFILE / DNP; R_0603_1608Metric; MPN RC0603JR-070RL; LCSC C95177; not fitted

Connections:
GND: C200.2, C201.2, J200.3 (GND), J200.5 (GND), J200.11 (GND), J200.27 (GND), J200.33 (GND), J200.39 (GND), J200.45 (GND), J200.51 (GND), J200.57 (GND), J200.71 (GND), J200.73 (GND), J200.SH (Board locks / GND)
M2_P24: J200.24 (P24 / VCC or 1V8_OUT), R200.2
M2_P38: J200.38 (P38 / VCC or WLAN_IN), R201.2
M2_P68: J200.68 (P68 / VCC or reserved), R202.2
VCC_MODEM: C200.1, C201.1, J200.[2,4,70,72,74] (VCC_MODEM), R200.1, R201.1, R202.1

Notes on the sheet:
J200 / exact B-key, 1 A power contacts
Sierra extra power contacts / never fit for Quectel
EM9190 / EM9191: fit all three links. EM929x: fit all three for eight-contact current sharing. RM520N-GLAA: all three MUST be absent. P24 is Quectel 1.8 V output; P38 is an input; P68 reserved.
Independent modem rail / safe unconfigured state
VCC_MODEM comes from the independent switched rail; converter, bulk and sequencing are being integrated. All assembly-profile links default DNP. Configure only with all sources removed and VCC_MODEM discharged. 3.135-4.4 V operating range; design target 3.7 V. This sheet does not establish the fina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
