alxgmpr/sierra-to-usb/full-adapter/cm4/cad/modem-signals.kicad_sch

## KiCad design full-adapter/cm4/cad/modem-signals.kicad_sch (2026-09-10)

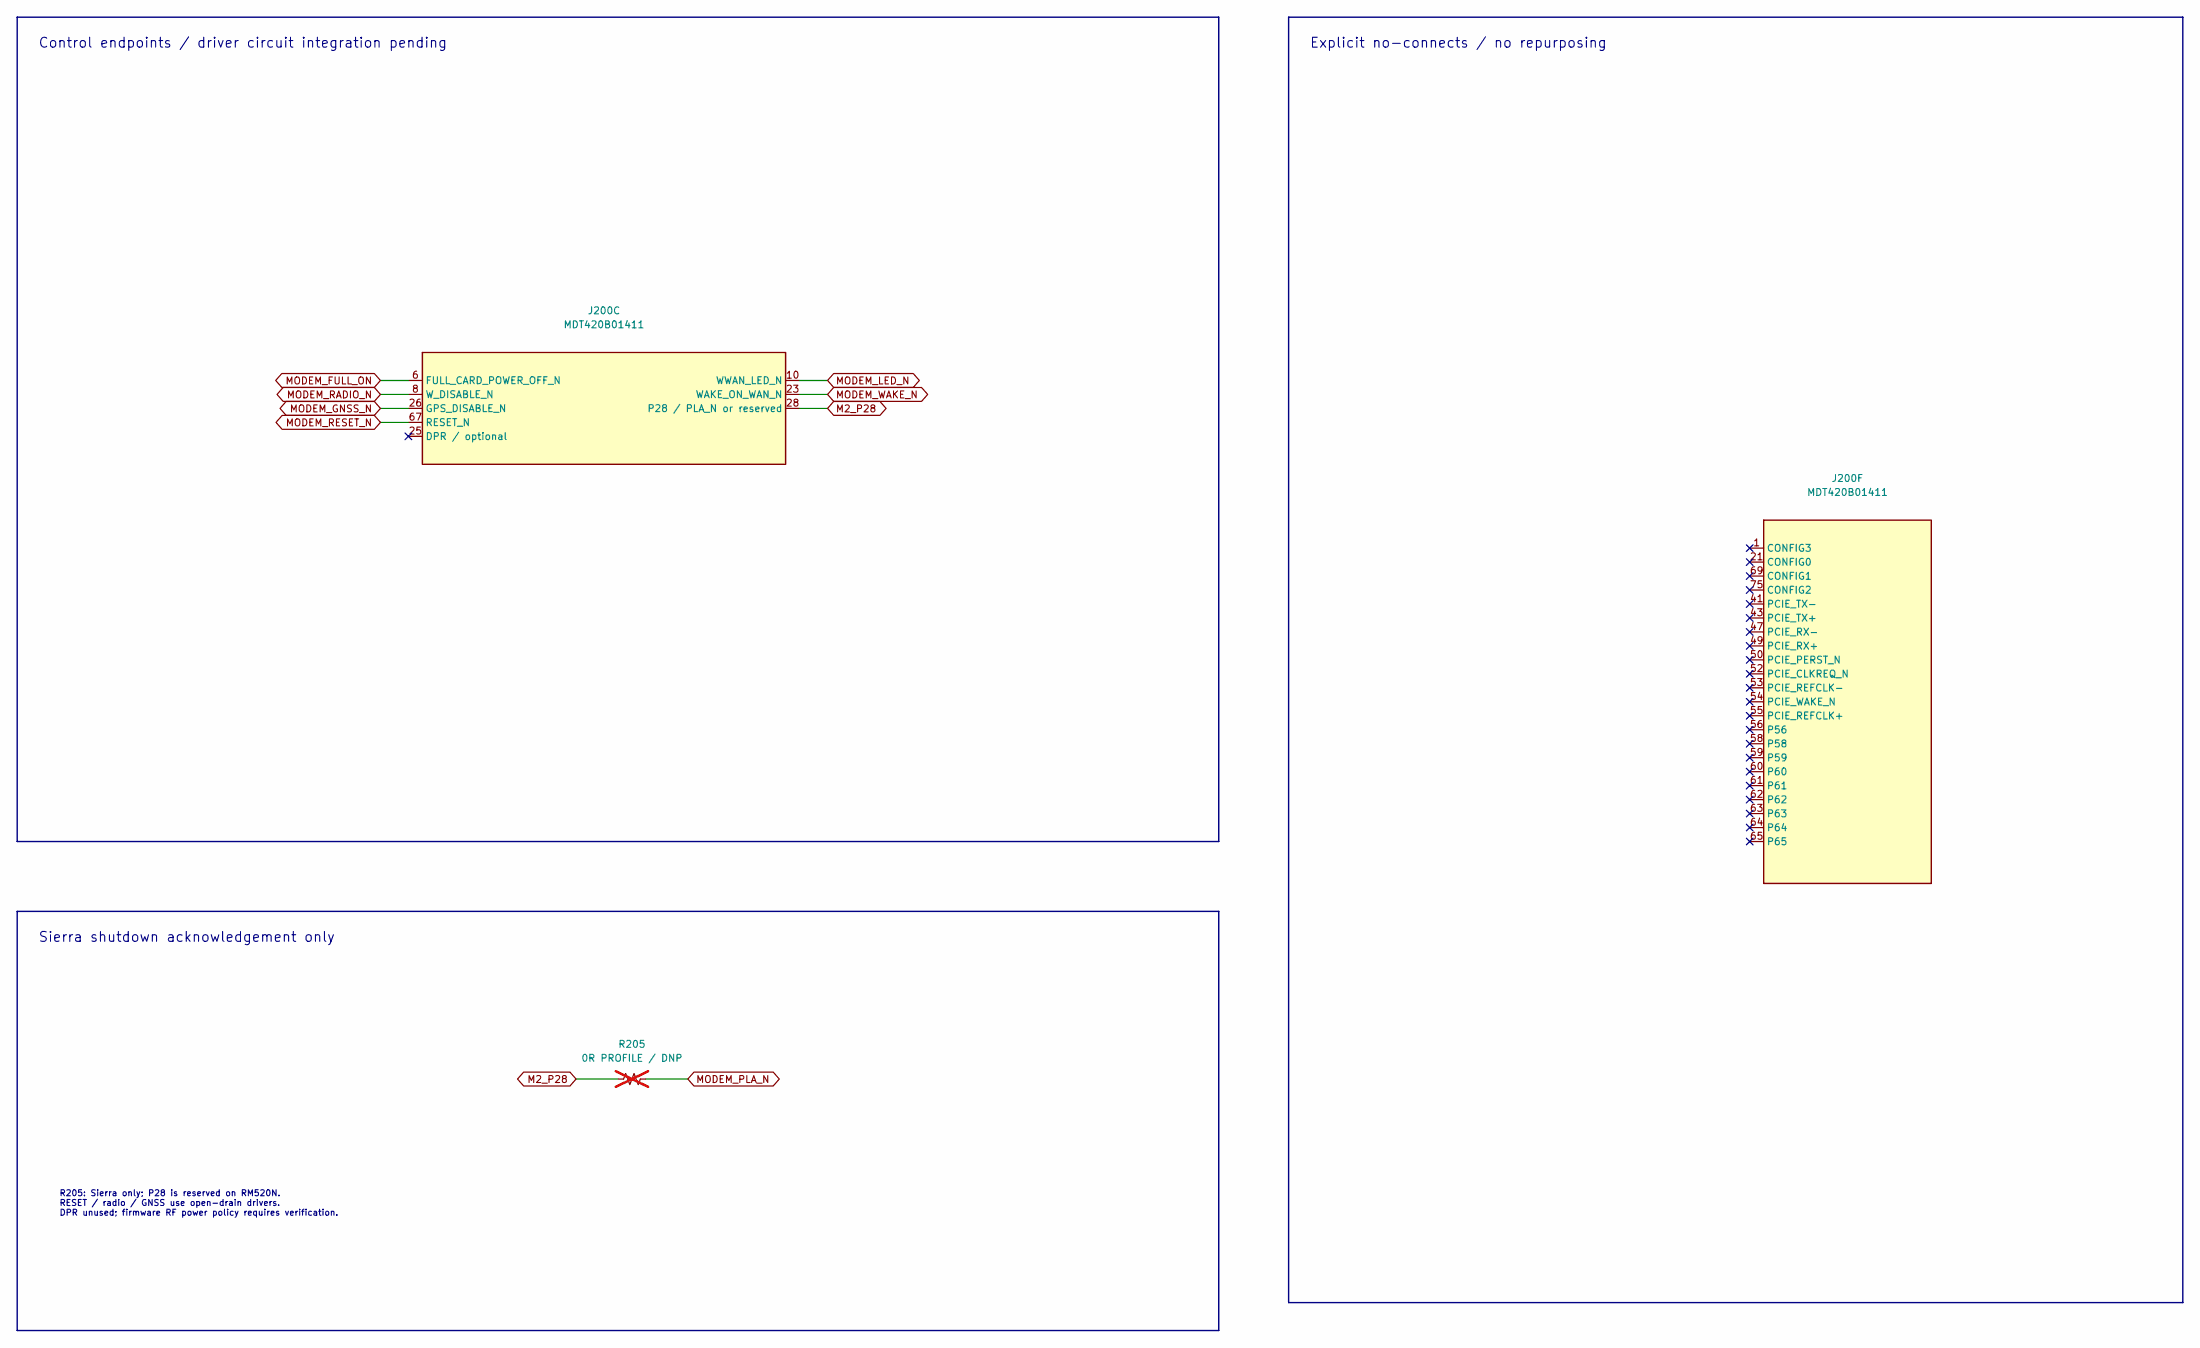
[picture p73: schematic modem-signals.kicad_sch]

Parts:
J200: MDT420B01411; Amphenol_MDT420B01411; MPN MDT420B01411
R205: 0R PROFILE / DNP; R_0603_1608Metric; MPN RC0603JR-070RL; LCSC C95177; not fitted

Connections:
M2_P28: J200.28 (P28 / PLA_N or reserved), R205.1
MODEM_FULL_ON: J200.6 (FULL_CARD_POWER_OFF_N)
MODEM_GNSS_N: J200.26 (GPS_DISABLE_N)
MODEM_LED_N: J200.10 (WWAN_LED_N)
MODEM_PLA_N: R205.2
MODEM_RADIO_N: J200.8 (W_DISABLE_N)
MODEM_RESET_N: J200.67 (RESET_N)
MODEM_WAKE_N: J200.23 (WAKE_ON_WAN_N)

Notes on the sheet:
Control endpoints / driver circuit integration pending
Sierra shutdown acknowledgement only
R205: Sierra only; P28 is reserved on RM520N. RESET / radio / GNSS use open-drain drivers. DPR unused; firmware RF power policy requires verification.
Explicit no-connects / no repurposing
