alxgmpr/sierra-to-usb/full-adapter/cm4/cad/modem-sim-profile.kicad_sch

## KiCad design full-adapter/cm4/cad/modem-sim-profile.kicad_sch (2026-09-10)

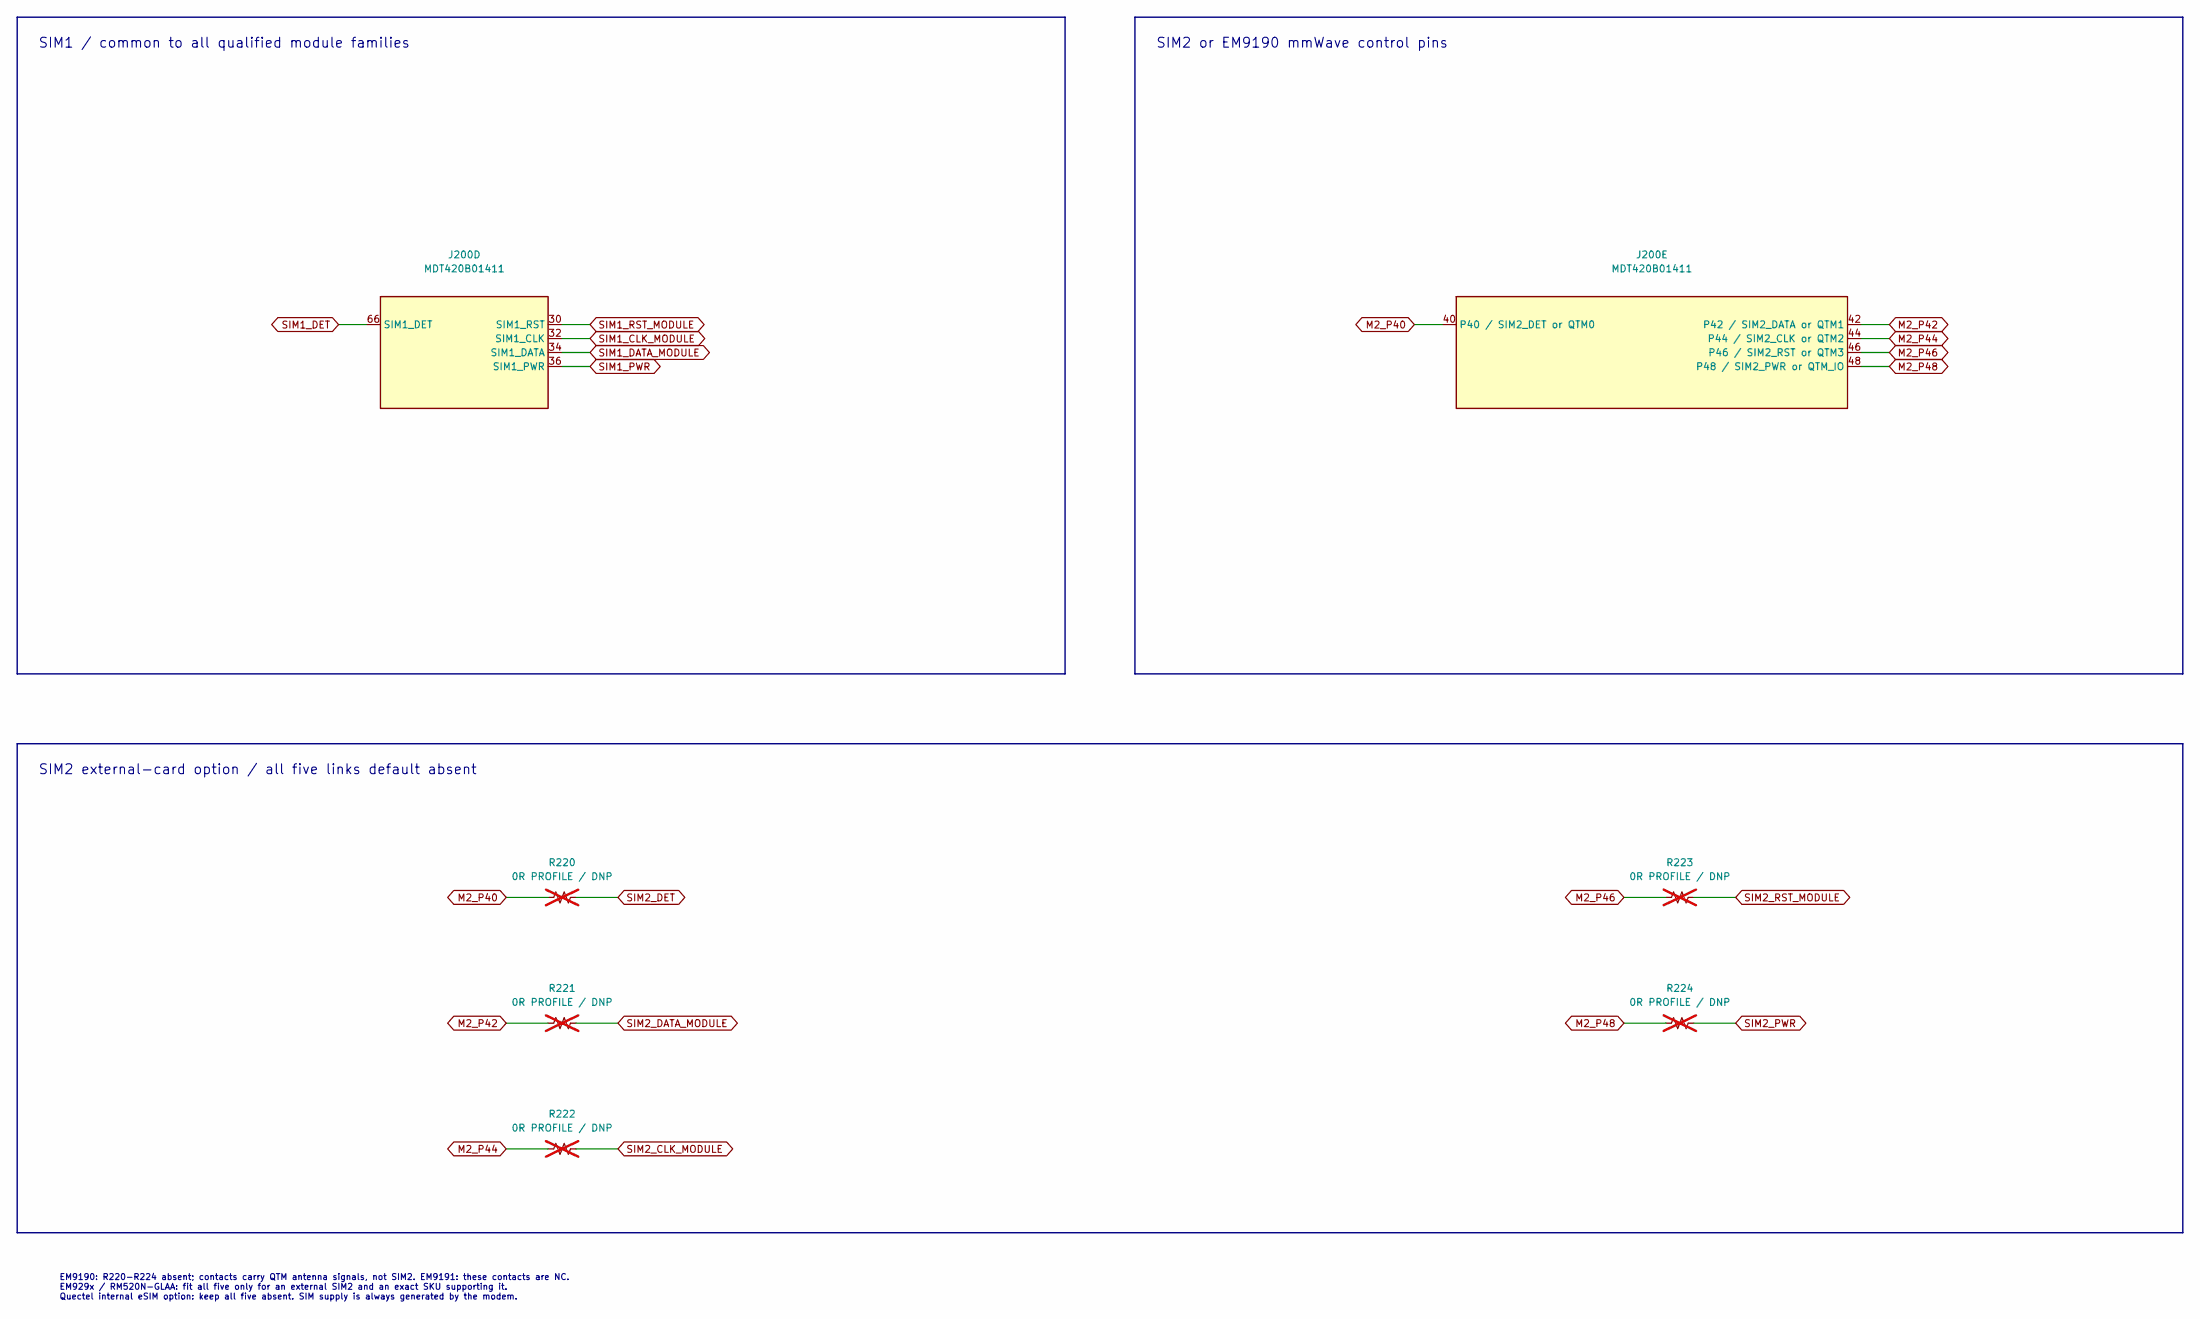
[picture p74: schematic modem-sim-profile.kicad_sch]

Parts:
J200: MDT420B01411; Amphenol_MDT420B01411; MPN MDT420B01411
R220, R221, R222, R223, R224: 0R PROFILE / DNP; R_0603_1608Metric; MPN RC0603JR-070RL; LCSC C95177; not fitted

Connections:
M2_P40: J200.40 (P40 / SIM2_DET or QTM0), R220.1
M2_P42: J200.42 (P42 / SIM2_DATA or QTM1), R221.1
M2_P44: J200.44 (P44 / SIM2_CLK or QTM2), R222.1
M2_P46: J200.46 (P46 / SIM2_RST or QTM3), R223.1
M2_P48: J200.48 (P48 / SIM2_PWR or QTM_IO), R224.1
SIM1_CLK_MODULE: J200.32 (SIM1_CLK)
SIM1_DATA_MODULE: J200.34 (SIM1_DATA)
SIM1_DET: J200.66 (SIM1_DET)
SIM1_PWR: J200.36 (SIM1_PWR)
SIM1_RST_MODULE: J200.30 (SIM1_RST)
SIM2_CLK_MODULE: R222.2
SIM2_DATA_MODULE: R221.2
SIM2_DET: R220.2
SIM2_PWR: R224.2
SIM2_RST_MODULE: R223.2

Notes on the sheet:
SIM1 / common to all qualified module families
SIM2 or EM9190 mmWave control pins
SIM2 external-card option / all five links default absent
EM9190: R220-R224 absent; contacts carry QTM antenna signals, not SIM2. EM9191: these contacts are NC. EM929x / RM520N-GLAA: fit all five only for an external SIM2 and an exact SKU supporting it. Quectel internal eSIM option: keep all five absent. SIM supply is always generated by the modem.
