alxgmpr/sierra-to-usb/full-adapter/cm4/cad/modem-usb.kicad_sch

## KiCad design full-adapter/cm4/cad/modem-usb.kicad_sch (2026-09-10)

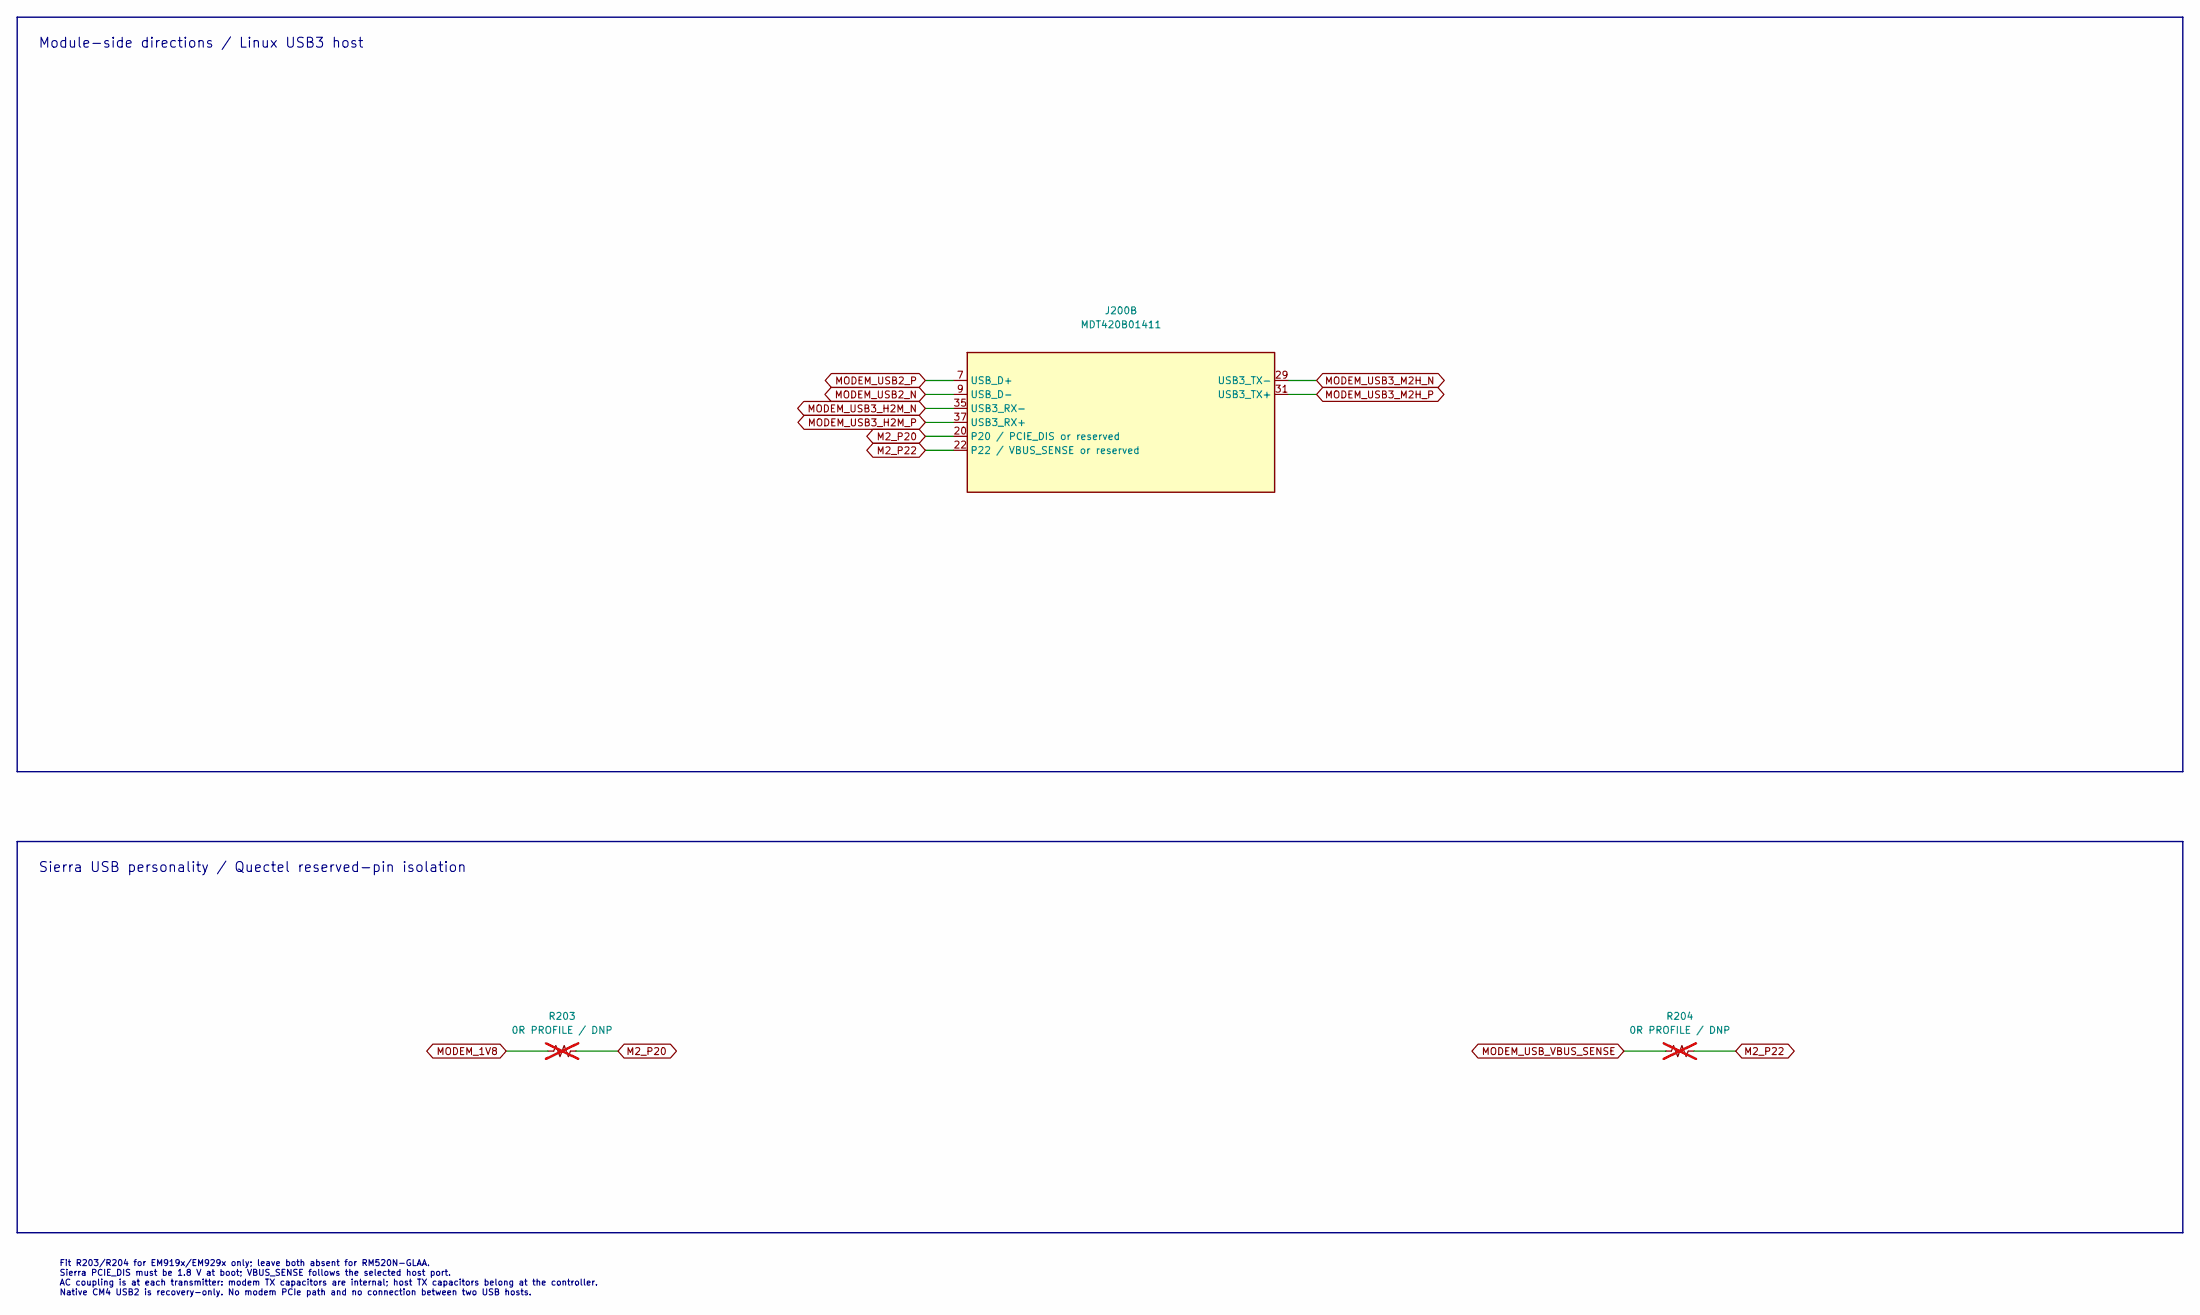
[picture p75: schematic modem-usb.kicad_sch]

Parts:
J200: MDT420B01411; Amphenol_MDT420B01411; MPN MDT420B01411
R203, R204: 0R PROFILE / DNP; R_0603_1608Metric; MPN RC0603JR-070RL; LCSC C95177; not fitted

Connections:
M2_P20: J200.20 (P20 / PCIE_DIS or reserved), R203.2
M2_P22: J200.22 (P22 / VBUS_SENSE or reserved), R204.2
MODEM_1V8: R203.1
MODEM_USB2_N: J200.9 (USB_D-)
MODEM_USB2_P: J200.7 (USB_D+)
MODEM_USB3_H2M_N: J200.35 (USB3_RX-)
MODEM_USB3_H2M_P: J200.37 (USB3_RX+)
MODEM_USB3_M2H_N: J200.29 (USB3_TX-)
MODEM_USB3_M2H_P: J200.31 (USB3_TX+)
MODEM_USB_VBUS_SENSE: R204.1

Notes on the sheet:
Module-side directions / Linux USB3 host
Sierra USB personality / Quectel reserved-pin isolation
Fit R203/R204 for EM919x/EM929x only; leave both absent for RM520N-GLAA. Sierra PCIE_DIS must be 1.8 V at boot; VBUS_SENSE follows the selected host port. AC coupling is at each transmitter: modem TX capacitors are internal; host TX capacitors belong at the controller. Native CM4 USB2 is recovery-o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
