alxgmpr/sierra-to-usb/full-adapter/cm4/cad/sim1.kicad_sch

## KiCad design full-adapter/cm4/cad/sim1.kicad_sch (2026-09-10)

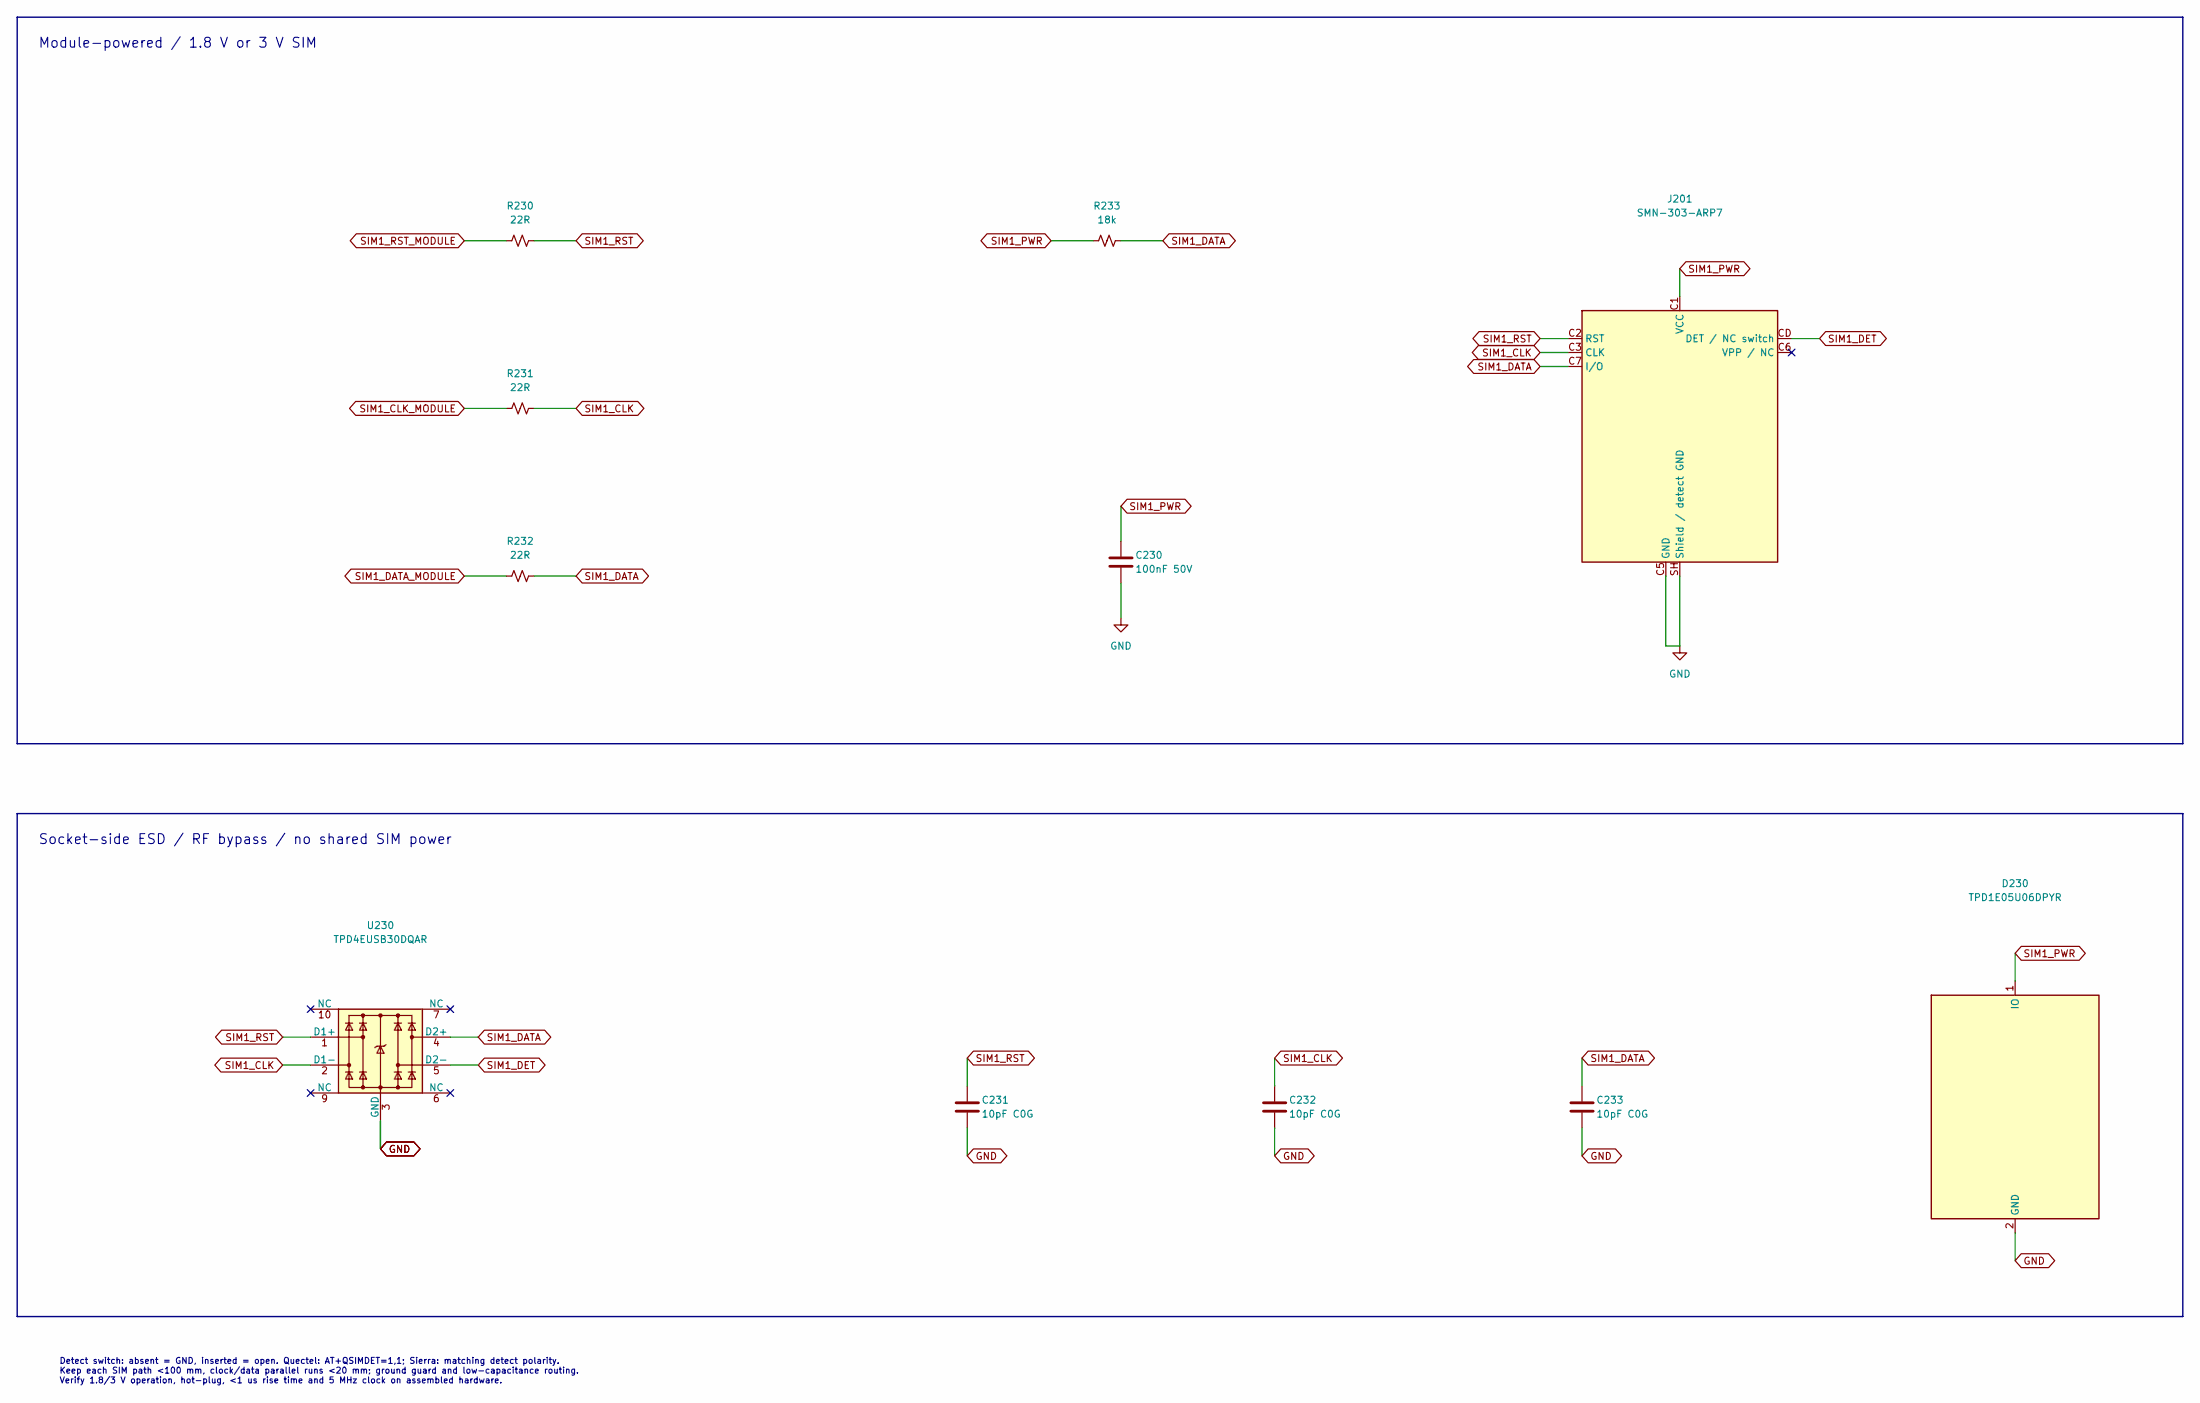
[picture p76: schematic sim1.kicad_sch]

Parts:
C230: 100nF 50V; C_0402_1005Metric; MPN CC0402KRX7R9BB104; LCSC C131394
C231, C232, C233: 10pF C0G; C_0402_1005Metric; MPN GRM1555C1H100JA01D; LCSC C76946
D230: TPD1E05U06DPYR; TI_DPY0002_TPD1E05U06; MPN TPD1E05U06DPYR; LCSC C436349
J201: SMN-303-ARP7; Xunpu_SMN303_ARP7; MPN SMN-303-ARP7; LCSC C5137194
R230, R231, R232: 22R; R_0402_1005Metric; MPN 0402WGF220JTCE; LCSC C25092
R233: 18k; R_0402_1005Metric; MPN 0402WGF1802TCE; LCSC C25762
U230: TPD4EUSB30DQAR; TI_DQA0010_TPD4EUSB30; MPN TPD4EUSB30DQAR; LCSC C90627

Connections:
GND: C230.2, C231.2, C232.2, C233.2, D230.2 (GND), J201.C5 (GND), J201.SH (Shield / detect GND), U230.3 (GND), U230.8 (GND)
SIM1_CLK: C232.1, J201.C3 (CLK), R231.2, U230.2 (D1-)
SIM1_CLK_MODULE: R231.1
SIM1_DATA: C233.1, J201.C7 (I/O), R232.2, R233.2, U230.4 (D2+)
SIM1_DATA_MODULE: R232.1
SIM1_DET: J201.CD (DET / NC switch), U230.5 (D2-)
SIM1_PWR: C230.1, D230.1 (IO), J201.C1 (VCC), R233.1
SIM1_RST: C231.1, J201.C2 (RST), R230.2, U230.1 (D1+)
SIM1_RST_MODULE: R230.1

Notes on the sheet:
Module-powered / 1.8 V or 3 V SIM
Socket-side ESD / RF bypass / no shared SIM power
Detect switch: absent = GND, inserted = open. Quectel: AT+QSIMDET=1,1; Sierra: matching detect polarity. Keep each SIM path <100 mm, clock/data parallel runs <20 mm; ground guard and low-capacitance routing. Verify 1.8/3 V operation, hot-plug, <1 us rise time and 5 MHz clock on assembled hardware.
