alxgmpr/sierra-to-usb/full-adapter/cm4/cad/sim2.kicad_sch

## KiCad design full-adapter/cm4/cad/sim2.kicad_sch (2026-09-10)

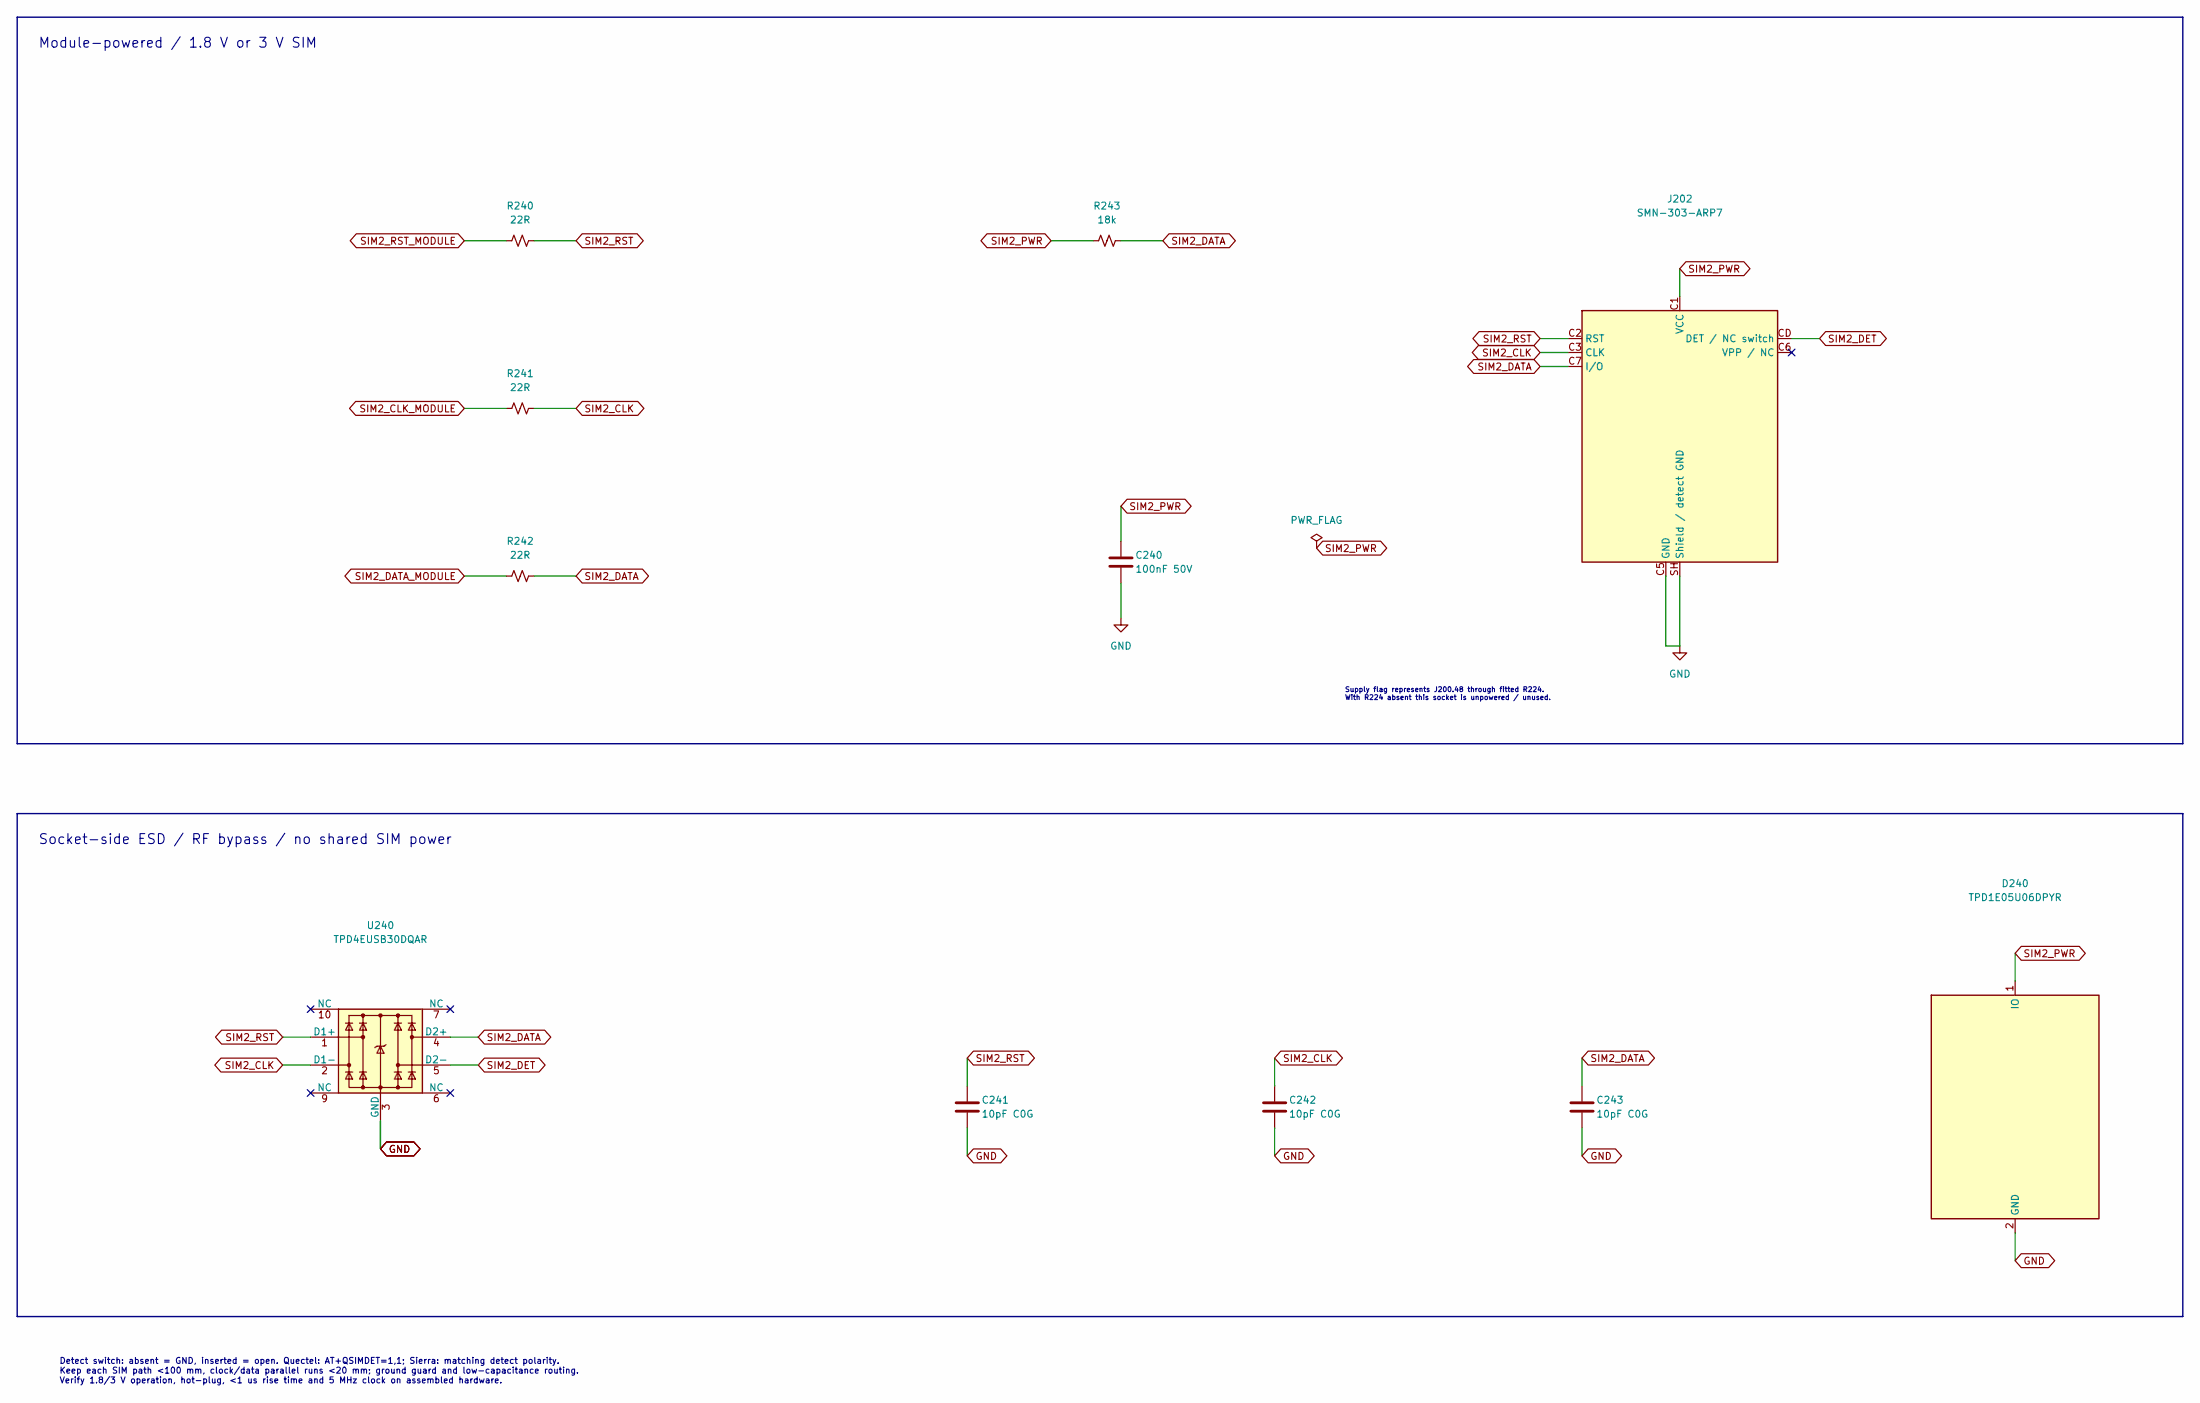
[picture p77: schematic sim2.kicad_sch]

Parts:
C240: 100nF 50V; C_0402_1005Metric; MPN CC0402KRX7R9BB104; LCSC C131394
C241, C242, C243: 10pF C0G; C_0402_1005Metric; MPN GRM1555C1H100JA01D; LCSC C76946
D240: TPD1E05U06DPYR; TI_DPY0002_TPD1E05U06; MPN TPD1E05U06DPYR; LCSC C436349
J202: SMN-303-ARP7; Xunpu_SMN303_ARP7; MPN SMN-303-ARP7; LCSC C5137194
R240, R241, R242: 22R; R_0402_1005Metric; MPN 0402WGF220JTCE; LCSC C25092
R243: 18k; R_0402_1005Metric; MPN 0402WGF1802TCE; LCSC C25762
U240: TPD4EUSB30DQAR; TI_DQA0010_TPD4EUSB30; MPN TPD4EUSB30DQAR; LCSC C90627

Connections:
GND: C240.2, C241.2, C242.2, C243.2, D240.2 (GND), J202.C5 (GND), J202.SH (Shield / detect GND), U240.3 (GND), U240.8 (GND)
SIM2_CLK: C242.1, J202.C3 (CLK), R241.2, U240.2 (D1-)
SIM2_CLK_MODULE: R241.1
SIM2_DATA: C243.1, J202.C7 (I/O), R242.2, R243.2, U240.4 (D2+)
SIM2_DATA_MODULE: R242.1
SIM2_DET: J202.CD (DET / NC switch), U240.5 (D2-)
SIM2_PWR: C240.1, D240.1 (IO), J202.C1 (VCC), R243.1
SIM2_RST: C241.1, J202.C2 (RST), R240.2, U240.1 (D1+)
SIM2_RST_MODULE: R240.1

Notes on the sheet:
Module-powered / 1.8 V or 3 V SIM
Supply flag represents J200.48 through fitted R224. With R224 absent this socket is unpowered / unused.
Socket-side ESD / RF bypass / no shared SIM power
Detect switch: absent = GND, inserted = open. Quectel: AT+QSIMDET=1,1; Sierra: matching detect polarity. Keep each SIM path <100 mm, clock/data parallel runs <20 mm; ground guard and low-capacitance routing. Verify 1.8/3 V operation, hot-plug, <1 us rise time and 5 MHz clock on assembled hardware.
