alxgmpr/sierra-to-usb/hardware/tools/build_processor.py

#!/usr/bin/env python3
"""Capture all native RK3566 units and unused contacts for the appliance."""
from pathlib import Path
import re
import uuid
ROOT = Path(__file__).resolve().parents[1]
def uid(key):
    return str(uuid.uuid5(uuid.NAMESPACE_URL, 'sierra-processor-' + key))
def block(text, start):
    depth = 0
    quoted = escape = False
    for i in range(start, len(text)):
        c = text[i]
        if escape:
            escape = False
            continue
        if quoted and c == '\\':
            escape = True
            continue
        if c == '"':
            quoted = not quoted
        if not quoted:
            depth += (c == '(') - (c == ')')
            if depth == 0:
                return text[start:i+1]
    raise ValueError('Unbalanced expression')
def prop(name, value, x, y, hidden=False):
    return f'(property "{name}" "{value}" (at {x} {y} 0) (effects (font (size 1.27 1.27))' + (' (hide yes)' if hidden else '') + '))'
source = (ROOT / 'reference/rk3566-electrical-review.kicad_sym').read_text()
symbol = block(source, source.index('(symbol "RK3566"')).replace('(symbol "RK3566"', '(symbol "ProcessorDraft:RK3566"', 1)
# No production footprint assignment until land-pattern review is complete.
symbol = re.sub(r'("Footprint"\s+)"[^"]*"', r'\1""', symbol, count=1)
(ROOT / 'ProcessorDraft.kicad_sym').write_text('(kicad_symbol_lib (version 20211014) (generator eeschema) ' + symbol.replace('(symbol "ProcessorDraft:RK3566"','(symbol "RK3566"',1) + ')\n')
items = []
ground_balls = set()
control_nets = {'AJ37':'PMIC_I2C_SCL','AK38':'PMIC_I2C_SDA','1P19':'PMIC_SLEEP','AG38':'RK_RESET_N','1R19':'PMIC_INT_N','1D17':'SARADC_BOOT_KEY','1F3':'DDR_SOC_RZQ'}
ddr_map={r['processor_ball']:r['net'] for r in __import__('csv').DictReader((ROOT/'reference/ddr-bus-map.csv').open())}
# Boot and interface ball selections checked against manufacturer guide and NanoPi
# reference sheets 8/9. All PCIe sidebands use M0, not mixed mux alternatives.
control_nets.update({
 'AD37':'CLK24_IN','AF38':'FLASH_VOL_SEL','AF37':'SDMMC0_DET',
 'A32':'EMMC_D0','B27':'EMMC_D1','B32':'EMMC_D2','B29':'EMMC_D3',
 'B33':'EMMC_D4','A30':'EMMC_D5','B30':'EMMC_D6','A33':'EMMC_D7',
 'A27':'EMMC_CMD','A29':'EMMC_CLK_SOC','1A16':'EMMC_STROBE','1B16':'EMMC_RESET_N',
 'R37':'RECOVERY_USB_DP','R38':'RECOVERY_USB_DM','T38':'RECOVERY_VBUS_DET',
 '1J19':'MODEM_USB_DP','1J20':'MODEM_USB_DM',
 'W37':'MODEM_USB_TXP_SOC','W38':'MODEM_USB_TXN_SOC','V38':'MODEM_USB_RXP','V37':'MODEM_USB_RXN',
 'AA37':'PCIE_TXP_SOC','AA38':'PCIE_TXN_SOC','AB37':'PCIE_RXP_SOC','AB38':'PCIE_RXN_SOC',
 '1K19':'PCIE_REFCLK_P','1K20':'PCIE_REFCLK_N','AG37':'PCIE_CLKREQ_N','1U20':'PCIE_WAKE_N','1R16':'PCIE_PERST_SOC_N',
 '1V19':'DEBUG_UART_RX','1U18':'DEBUG_UART_TX','AN37':'SOC_HEALTH',
 '1R20':'TSADC_SHUTDOWN',
 '1C17':'GND','1B18':'GND','1A19':'GND',
})
# Retain reference analog power, even for disabled display/camera blocks.
# Unused GPIO domains may float per guide 2.1.13.3; this design powers them
# at the reference voltages to simplify firmware's domain configuration.
extra_rails = {
 'VCCIO1':'3V3_MAIN','VCCIO2':'VCC_1V8','VCCIO3':'VCCIO_SD',
 'VCCIO4':'VCC_1V8','VCCIO5_1':'VCC_1V8','VCCIO5_2':'VCC_1V8',
 'VCCIO6_1':'VCC_1V8','VCCIO6_2':'VCC_1V8','VCCIO7':'3V3_MAIN',
 'MULTI_PHY_AVDD_0V9':'MULTI_AVDD_0V9','MULTI_PHY_AVDD_1V8':'MULTI_AVDD_1V8',
 'USB_AVDD2_0V9':'USB2_AVDD_0V9','USB_AVDD2_1V8':'USB2_AVDD_1V8','USB_AVDD2_3V3':'3V3_MAIN',
}
for name in ['MIPI_CSI_RX','HDMI_TX','MIPI_DSI_TX0','MIPI_DSI_TX1','EDP_TX']:
 for suffix,net in [('0V9','VDDA_0V9'),('1V8','VCCA_1V8')]:
  extra_rails[name+'_AVDD_'+suffix] = net
extra_rails.update({'HDMI_TX_AVDD_0V9_1':'VDDA_0V9','HDMI_TX_AVDD_0V9_2':'VDDA_0V9'})
connected_balls = {}
unused_balls = {}

connected_controls = set()
rail_balls = {}
for unit, x, y in [(1,76.2,76.2),(2,177.8,177.8),(3,279.4,139.7),(4,431.8,76.2),(5,76.2,304.8),(6,279.4,304.8),(7,444.5,228.6),(8,444.5,330.2)]:
    body = block(symbol, symbol.index(f'(symbol "RK3566_{unit}_1"'))
    top = float(re.search(r'\(start [-\d.]+ ([-\d.]+)\)', body)[1])
    pins = re.findall(r'\(number "([^"]+)"', body)
    for px, py, angle, name, number in re.findall(r'\(pin \w+ \w+.*?\(at ([-\d.]+) ([-\d.]+) ([-\d.]+)\).*?\(name "([^"]+)".*?\(number "([^"]+)"', body, re.S):
        analog = {'OTP_VCC18':'VCCA_1V8','SARADC_AVDD_1V8':'VCCA_1V8','USB_AVDD1_0V9':'USB_AVDD_0V9','USB_AVDD1_1V8':'USB_AVDD_1V8','USB_AVDD1_3V3':'3V3_MAIN','PMU_VDD_LOGIC_0V9':'VDDA0V9_PMU','PMUPLL_AVDD_0V9':'VDDA0V9_PMU','PMUPLL_AVDD_1V8':'VCCA1V8_PMU','SYSPLL_AVDD_0V9':'VDDA_0V9','SYSPLL_AVDD_1V8':'VCCA_1V8'}
        rail = extra_rails.get(name) or analog.get(name) or ('VDD_CPU' if name.startswith('VDD_CPU_') else None) or ('VDD_DDR_1V1' if name.startswith('DDRPHY_VDDQ_') else 'VDD_DDR_0V6' if name.startswith('DDRPHY_VDDQL_') else None) or ('VDD_LOGIC' if name.startswith('VDD_LOGIC_') else 'VDD_NPU' if name.startswith('VDD_NPU_') else 'VDD_GPU' if name.startswith('VDD_GPU_') else 'VCC3V3_PMU' if name in {'PMUIO1','PMUIO2'} else None)
        if rail:
            rail_balls[number] = rail
        control = control_nets.get(number) or rail or ddr_map.get(number)
        is_ground = bool(re.fullmatch(r'(?:VSS|AVSS|AVSS1)_\d+', name) or name in {'DDR_AVSS','PMUPLL_AVSS','SYSPLL_AVSS'})
        if control or is_ground:
            connected_balls[number] = control or 'GND'
        else:
            unused_balls[number] = name
            items.append(f'(no_connect (at {round(x+float(px),4)} {round(y-float(py),4)}) (uuid "{uid("unused-"+number)}"))')
        if control:
            if number in control_nets:
                connected_controls.add(number)
            ax, ay = round(x + float(px),4), round(y - float(py),4)
            left = float(px) < 0
            bx = round(ax + (-12.7 if left else 12.7),4)
            items.append(f'(wire (pts (xy {ax} {ay}) (xy {bx} {ay})) (stroke (width 0) (type default)) (uuid "{uid("control-wire-"+number)}"))')
            items.append(f'(global_label "{control}" (shape passive) (at {bx} {ay} {0 if left else 180}) (effects (font (size 1.27 1.27)) (justify {"right" if left else "left"})) (uuid "{uid("control-label-"+number)}"))')
        if not is_ground:
            continue
        ground_balls.add(number)
        ax, ay = round(x + float(px),4), round(y - float(py),4)
        left = float(px) < 0
        bx = round(ax + (-7.62 if left else 7.62),4)
        items.append(f'(wire (pts (xy {ax} {ay}) (xy {bx} {ay})) (stroke (width 0) (type default)) (uuid "{uid("ground-wire-"+number)}"))')
        items.append(f'(global_label "GND" (shape passive) (at {bx} {ay} {0 if left else 180}) (effects (font (size 1.27 1.27)) (justify {"right" if left else "left"})) (uuid "{uid("ground-label-"+number)}"))')
    fields = prop('Reference','U801',x,y-top-7.62) + prop('Value','RK3566',x,y-top-5.08)
    for key,value in {'Footprint':'','MPN':'RK3566','Manufacturer':'Rockchip','LCSC':'C2943786','Qualification':'Ball connections audited; unused GPIOs/analog signals NC, peripherals disabled in firmware. TVSS NC per NanoPi sheet 8. Land pattern pending'}.items():
        fields += prop(key,value,x,y,True)
    items.append(f'(symbol (lib_id "ProcessorDraft:RK3566") (at {x} {y} 0) (unit {unit}) (in_bom yes) (on_board yes) (dnp no) (uuid "{uid(str(unit))}") {fields} ' + ''.join(f'(pin "{n}" (uuid "{uid("pin-"+n)}"))' for n in pins) + f' (instances (project "processor" (path "/{uid("root")}" (reference "U801") (unit {unit})))))')
# Four processor-local PLL banks; distinct from PMIC output capacitance.
cap_source = Path('/Applications/KiCad/KiCad.app/Contents/SharedSupport/symbols/Device.kicad_sym').read_text()
cap = block(cap_source, cap_source.index('(symbol "C_Small"')).replace('(symbol "C_Small"','(symbol "Device:C_Small"',1)
def wire(a,b,key):
    items.append(f'(wire (pts (xy {a[0]} {a[1]}) (xy {b[0]} {b[1]})) (stroke (width 0) (type default)) (uuid "{uid(key)}"))')
def label(net,x,y,key):
    items.append(f'(global_label "{net}" (shape passive) (at {x} {y} 0) (effects (font (size 1.27 1.27)) (justify right)) (uuid "{uid(key)}"))')
for bank,net,x,y in [(0,'VDDA0V9_PMU',50.8,152.4),(1,'VCCA1V8_PMU',50.8,213.36),(2,'VDDA_0V9',304.8,223.52),(3,'VCCA_1V8',406.4,147.32),(4,'VDDA0V9_PMU',50.8,370.84),(5,'VCC3V3_PMU',304.8,375.92),(6,'USB_AVDD_0V9',355.6,284.48),(7,'USB_AVDD_1V8',406.4,284.48),(8,'3V3_MAIN',482.6,284.48),(9,'VCCA_1V8',381,375.92),(10,'VCCA_1V8',431.8,375.92)]:
    offsets = [(0,'1uF','CL10B105KA8NNNC','C29936'),(1,'100nF','CL10B104KA8NNNC','C1590')]
    if bank >= 6:
        offsets = [(0,'100nF','CL10B104KA8NNNC','C1590')]
    for offset,value,mpn,lcsc in offsets:
        if bank == 5:
            value,mpn,lcsc = '100nF','CL10B104KA8NNNC','C1590'
        placement = ('PMU logic bypass at 1N16' if bank == 4 else ('PMUIO1 bypass at 1P16' if offset == 0 else 'PMUIO2 bypass at 1N15') if bank == 5 else 'PLL local bypass per RK3566 guide Figures 2-17/18; place at corresponding supply ball')
        if 6 <= bank <= 8:
            placement = 'USB OTG0/HOST1 local bypass at ' + {6:'1J17',7:'1H16',8:'1H18'}[bank] + '; NanoPi R3S sheet 9'
        if bank >= 9:
            placement = ('SARADC bypass at 1D16' if bank == 9 else 'OTP bypass at 1D15') + '; RK3566 guide Figure 2-49; place close to ball'
        ref = f'C{815+bank-6}' if bank >= 6 else f'C{801+2*bank+offset}'
        cx = x+30.48*offset
        fields = prop('Reference',ref,cx+6.35,y-1.27)+prop('Value',value,cx+6.35,y+1.27)
        for key,val in {'Footprint':'Capacitor_SMD:C_0603_1608Metric','MPN':mpn,'Manufacturer':'Samsung Electro-Mechanics','LCSC':lcsc,'Voltage Rating':'25V','Qualification':placement}.items():
            fields += prop(key,val,cx,y,True)
        items.append(f'(symbol (lib_id "Device:C_Small") (at {cx} {y} 0) (unit 1) (in_bom yes) (on_board yes) (dnp no) (uuid "{uid(ref)}") {fields} '+''.join(f'(pin "{n}" (uuid "{uid(ref+":"+n)}"))' for n in ['1','2'])+f' (instances (project "processor" (path "/{uid("root")}" (reference "{ref}") (unit 1)))))')
        wire((cx,y-2.54),(cx,y-10.16),ref+'-top')
        wire((cx,y+2.54),(cx,y+10.16),ref+'-bottom')
    if bank < 6:
        wire((x,y-10.16),(x+30.48,y-10.16),net+str(bank)+'-top')
        wire((x,y+10.16),(x+30.48,y+10.16),net+str(bank)+'-bottom')
    label(net,x,y-10.16,net+str(bank)+'-label')
    label('GND',x,y+10.16,net+str(bank)+'-ground')
# NPU local bypass: NanoPi R3S sheet 5 distinguishes under-package and nearby bulk.
for ref,x,value,mpn,lcsc,footprint,placement in [
 ('C821',50.8,'100nF','CL10B104KA8NNNC','C1590','Capacitor_SMD:C_0603_1608Metric','under processor package'),
 ('C822',76.2,'22uF','CL32B226KAJNNNE','C309062','Capacitor_SMD:C_1210_3225Metric','under processor package; placement feasibility pending'),
 ('C823',101.6,'10uF','CL31B106KAHNNNE','C14860','Capacitor_SMD:C_1206_3216Metric','close to processor package'),
 ('C824',127,'22uF','CL32B226KAJNNNE','C309062','Capacitor_SMD:C_1210_3225Metric','close to processor package')]:
 y=119.38
 properties=prop('Reference',ref,x+8.89,y-1.27)+prop('Value',value,x+8.89,y+1.27)
 for field_name,val in {'Footprint':footprint,'MPN':mpn,'Manufacturer':'Samsung Electro-Mechanics','LCSC':lcsc,'Voltage Rating':'25V','Qualification':'NPU local bypass '+placement+'; effective capacitance and impedance pending'}.items():
  properties+=prop(field_name,val,x,y,True)
 items.append(f'(symbol (lib_id "Device:C_Small") (at {x} {y} 0) (unit 1) (in_bom yes) (on_board yes) (dnp no) (uuid "{uid(ref)}") {properties} '+''.join(f'(pin "{n}" (uuid "{uid(ref+":"+n)}"))' for n in ['1','2'])+f' (instances (project "processor" (path "/{uid("root")}" (reference "{ref}") (unit 1)))))')
 wire((x,116.84),(x,109.22),ref+'-top')
 wire((x,121.92),(x,129.54),ref+'-bottom')
for x1,x2 in [(50.8,76.2),(76.2,101.6),(101.6,127)]:
 wire((x1,109.22),(x2,109.22),'npu-top-'+str(x1))
 wire((x1,129.54),(x2,129.54),'npu-bottom-'+str(x1))
for x in [76.2,101.6]:
 for y in [109.22,129.54]:items.append(f'(junction (at {x} {y}) (diameter 0) (color 0 0 0 0) (uuid "{uid("npu-junction-"+str(x)+":"+str(y))}"))')
label('VDD_NPU',50.8,109.22,'npu-local-supply')
label('GND',50.8,129.54,'npu-local-ground')
# Defined normal-boot level and local SARADC VIN0 input filter.
resistor = block(cap_source, cap_source.index('(symbol "R_Small_US"')).replace('(symbol "R_Small_US"','(symbol "Device:R_Small_US"',1)
for name,ref,value,x,y,fp,fields in [
 ('R_Small_US','R801','10kR',350.52,320.04,'Resistor_SMD:R_0603_1608Metric',{'MPN':'RC0603FR-0710KL','Manufacturer':'Yageo','LCSC':'C98220','Tolerance':'1%','Power Rating':'0.1W'}),
 ('C_Small','C820','1nF',350.52,345.44,'Capacitor_SMD:C_0603_1608Metric',{'MPN':'CL10C102JB8NNNC','Manufacturer':'Samsung Electro-Mechanics','LCSC':'C163508','Tolerance':'5%','Voltage Rating':'50V','Dielectric':'C0G'})]:
 fields.update({'Footprint':fp,'Qualification':'SARADC VIN0 normal-boot pull-up and input filter; RK3566 guide Figure 2-49'})
 properties=prop('Reference',ref,x+7.62,y-1.27)+prop('Value',value,x+7.62,y+1.27)
 for key,val in fields.items():properties+=prop(key,val,x,y,True)
 items.append(f'(symbol (lib_id "Device:{name}") (at {x} {y} 0) (unit 1) (in_bom yes) (on_board yes) (dnp no) (uuid "{uid(ref)}") {properties} '+''.join(f'(pin "{n}" (uuid "{uid(ref+":"+n)}"))' for n in ['1','2'])+f' (instances (project "processor" (path "/{uid("root")}" (reference "{ref}") (unit 1)))))')
wire((350.52,317.5),(350.52,309.88),'boot-pullup-top')
label('VCCA_1V8',350.52,309.88,'boot-pullup-supply')
wire((350.52,322.58),(350.52,332.74),'boot-pullup-bottom')
wire((350.52,332.74),(350.52,342.9),'boot-filter-top')
wire((350.52,332.74),(365.76,332.74),'boot-node-label-wire')
items.append(f'(global_label "SARADC_BOOT_KEY" (shape passive) (at 365.76 332.74 180) (effects (font (size 1.27 1.27)) (justify left)) (uuid "{uid("boot-node-label")}"))')
items.append(f'(junction (at 350.52 332.74) (diameter 0) (color 0 0 0 0) (uuid "{uid("boot-node-junction")}"))')
wire((350.52,347.98),(350.52,355.6),'boot-filter-ground')
label('GND',350.52,355.6,'boot-filter-ground-label')
switch_source = Path('/Applications/KiCad/KiCad.app/Contents/SharedSupport/symbols/Switch.kicad_sym').read_text()
switch = block(switch_source,switch_source.index('(symbol "SW_Push"')).replace('(symbol "SW_Push"','(symbol "Switch:SW_Push"',1)
for ref,net,title,sy in [('SW801','SARADC_BOOT_KEY','PROCESSOR RECOVERY',248.92),('SW802','RK_RESET_N','PROCESSOR / PMIC RESET',236.22)]:
 properties=prop('Reference',ref,355.6,sy-7.62)+prop('Value',title,355.6,sy-5.08)
 for key,val in {'Footprint':'Button_Switch_SMD:SW_SPST_TL3342','MPN':'TL3342F160QG','Manufacturer':'E-Switch','LCSC':'C2886898','Contact Rating':'12VDC 50mA','Operating Temperature':'-20 to +70 C','Qualification':'Manual shared reset / PMIC restart' if ref == 'SW802' else 'Manual Rockusb recovery request; not independent MaskROM override'}.items():
  properties+=prop(key,val,355.6,sy,True)
 items.append(f'(symbol (lib_id "Switch:SW_Push") (at 355.6 {sy} 0) (unit 1) (in_bom yes) (on_board yes) (dnp no) (uuid "{uid(ref)}") {properties} '+''.join(f'(pin "{n}" (uuid "{uid(ref+":"+n)}"))' for n in ['1','2'])+f' (instances (project "processor" (path "/{uid("root")}" (reference "{ref}") (unit 1)))))')
 wire((340.36,sy),(350.52,sy),ref+'-input')
 label(net,340.36,sy,ref+'-input-label')
 wire((360.68,sy),(370.84,sy),ref+'-ground')
 items.append(f'(global_label "GND" (shape passive) (at 370.84 {sy} 180) (effects (font (size 1.27 1.27)) (justify left)) (uuid "{uid(ref+"-ground-label")}"))')
# Existing native MMBT3904 model, reviewed for recovery sinks.
control_source=(ROOT/'controls.kicad_sch').read_text()
bjt=block(control_source,control_source.index('(symbol "Transistor_BJT:MMBT3904"'))
for key,control,output,qref,rbase,rpull,offset in [('reset','MCU_PROCESSOR_RESET_ASSERT','RK_RESET_N','Q801','R802','R803',0),('recovery','MCU_PROCESSOR_RECOVERY_ASSERT','SARADC_BOOT_KEY','Q802','R804','R805',58.42)]:
 bank_start=len(items)
 for name,ref,value,x,y,angle,fp,fields in [
  ('Device:R_Small_US',rbase,'10kR',320.04,55.88+offset,90,'Resistor_SMD:R_0603_1608Metric',{'MPN':'RC0603FR-0710KL','Manufacturer':'Yageo','LCSC':'C98220'}),
  ('Device:R_Small_US',rpull,'100kR',332.74,71.12+offset,0,'Resistor_SMD:R_0603_1608Metric',{'MPN':'RC0603FR-07100KL','Manufacturer':'Yageo','LCSC':'C14675'}),
  ('Transistor_BJT:MMBT3904',qref,'MMBT3904,215',345.44,55.88+offset,0,'Package_TO_SOT_SMD:SOT-23',{'MPN':'MMBT3904,215','Manufacturer':'Nexperia','Datasheet':'https://assets.nexperia.com/documents/data-sheet/MMBT3904.pdf'})]:
  properties=prop('Reference',ref,x+(12.7 if ref.startswith('Q') else 7.62) if angle==0 else x,y-1.27 if angle==0 else y-8.89)+prop('Value',value,x+(12.7 if ref.startswith('Q') else 7.62) if angle==0 else x,y+1.27 if angle==0 else y-6.35)
  if angle==90:properties=re.sub(r'(\(at [^()]+) 0\)',r'\1 90)',properties)
  if ref.startswith('R'):
   fields.update({'Tolerance':'1%','Power Rating':'0.1W','Voltage Rating':'75V'})
  fields.update({'Footprint':fp,'Qualification':'Draft MCU-controlled '+key+' sink; electrical limits and timing require qualification'})
  for field_key,val in fields.items():properties+=prop(field_key,val,x,y,True)
  pin_numbers=['1','2','3'] if ref.startswith('Q') else ['1','2']
  items.append(f'(symbol (lib_id "{name}") (at {x} {y} {angle}) (unit 1) (in_bom yes) (on_board yes) (dnp no) (uuid "{uid(ref)}") {properties} '+''.join(f'(pin "{n}" (uuid "{uid(ref+":"+n)}"))' for n in pin_numbers)+f' (instances (project "processor" (path "/{uid("root")}" (reference "{ref}") (unit 1)))))')
 wire((304.8,55.88+offset),(317.5,55.88+offset),key+'-driver-input')
 if key == 'recovery':
  wire((304.8,55.88+offset),(304.8,43.18+offset),key+'-input-label-rise')
  items.append(f'(global_label "{control}" (shape passive) (at 304.8 {43.18+offset} 180) (effects (font (size 1.27 1.27)) (justify left)) (uuid "{uid(key+"-driver-input-label")}"))')
 else:
  label(control,304.8,55.88+offset,key+'-driver-input-label')
 wire((322.58,55.88+offset),(332.74,55.88+offset),key+'-base1')
 wire((332.74,55.88+offset),(340.36,55.88+offset),key+'-base2')
 wire((332.74,55.88+offset),(332.74,68.58+offset),key+'-base-pulldown')
 items.append(f'(junction (at 332.74 {55.88+offset}) (diameter 0) (color 0 0 0 0) (uuid "{uid(key+"-base-junction")}"))')
 wire((347.98,50.8+offset),(347.98,40.64+offset),key+'-collector')
 label(output,347.98,40.64+offset,key+'-collector-label')
 wire((347.98,60.96+offset),(347.98,81.28+offset),key+'-emitter')
 wire((332.74,73.66+offset),(332.74,81.28+offset),key+'-pulldown-ground')
 wire((332.74,81.28+offset),(347.98,81.28+offset),key+'-ground-common')
 label('GND',332.74,81.28+offset,key+'-ground-label')
 if key == 'recovery':
  # Keep the complete recovery sink clear of the DDR supply labels.
  for i in range(bank_start,len(items)):
   items[i]=re.sub(r'\((at|xy) ([-\d.]+) ([-\d.]+)',lambda m:f'({m[1]} {round(float(m[2])+50.8,4)} {m[3]}',items[i])
items.append(f'(text "PROCESSOR: 565 balls captured. CPU/eMMC/PCIe/USB and PMIC controls connected.\\nUnused GPIO/analog signal balls are NC; disabled peripherals must remain disabled in firmware.\\nTVSS and XOUT24M float per reference; 1.8V active oscillator feeds XIN24M.\\n1.8V flash strap, debug strap and thermal-shutdown termination are on host-interface sheet." (at 25.4 20.32 0) (effects (font (size 1.27 1.27)) (justify left)) (uuid "{uid('note')}"))')
import csv
with (ROOT/'pinmaps/processor-capture.csv').open('w') as out:
 writer=csv.writer(out,lineterminator='\n');writer.writerow(['ball','net','unused_function','evidence'])
 for ball in sorted(set(connected_balls)|set(unused_balls)):
  writer.writerow([ball,connected_balls.get(ball,''),unused_balls.get(ball,''),'RK3566 guide 2.1,2.2,2.7; NanoPi R3S sheets 5,8,9'])
assert len(connected_balls)+len(unused_balls)==565
(ROOT / 'processor.kicad_sch').write_text(f'(kicad_sch (version 20250114) (generator eeschema) (uuid "{uid("root")}") (paper "A2") (title_block (title "RK3566 processor — interface and power capture") (date "2026-10-07")) (lib_symbols {symbol} {cap} {resistor} {switch} {bjt}) ' + ' '.join(items) + ' (sheet_instances (path "/" (page "1"))))\n')
assert len(rail_balls) == 80, len(rail_balls)
assert connected_controls == set(control_nets)
assert len(ground_balls) == 187 and '1M18' not in ground_balls
print('Generated eight-unit processor engineering capture, U801; 187 documented ground balls connected.')
