alxgmpr/sierra-to-usb/full-adapter/cm4/tools/build_modem.py

"""Capture the common USB modem interface and physically isolated assembly profiles."""
import json
from cad import ROOT, Sheet
from build_power_input import cap

PARTS={}
for file in ['initial-parts.json','power-input-parts.json','ethernet-parts.json','modem-parts.json']:
    data=json.loads((ROOT/'research'/file).read_text())
    for entry in data.get('parts',data.get('selected',[])):
        for p in entry.get('results',[entry]):PARTS[p['model']]=p


def resistor(s,ref,value,x,y,a,b,dnp=False):
    mpn={'0R':'RC0603JR-070RL','22R':'0402WGF220JTCE','18k':'0402WGF1802TCE'}[value]
    # RC0603 links are 1 A rated, 2 A maximum, <50mOhm. Profile links default DNP.
    p=PARTS[mpn]
    fp='Resistor_SMD:R_0603_1608Metric' if value=='0R' else 'Resistor_SMD:R_0402_1005Metric'
    pins=s.place('Device:R_Small_US',ref,x,y,angle=90,value=value+(' PROFILE / DNP' if dnp else ''),dnp=dnp,
        fields={'Footprint':fp,'MPN':mpn,'Manufacturer':p['manufacturer'],'LCSC':p['lcsc'],
                'Datasheet':p.get('datasheet',''),'Assembly': 'profile-dependent' if dnp else 'all'})
    s.connect(ref,'1',a,length=7.62,global_net=True);s.connect(ref,'2',b,length=7.62,global_net=True)
    return pins


def socket(s,unit,x,y):
    return s.place('cm4:MODEM_M2_B','J200',x,y,unit=unit,value='MDT420B01411',
        fields={'Assembly':'sourcing unresolved / 1 A per power contact required'})
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
