alxgmpr/sierra-to-usb/(notices)

Notices in the files:
hardware/reference/tida-import/input.kicad_sch:
© Texas Instruments
${COPYRIGHTYEAR}
